RascalSeniorDesign/Preliminary-Design/CMQA/Presentations/Tyler Slides/CubeSat Definitions.key/Data/st0-1.jpg

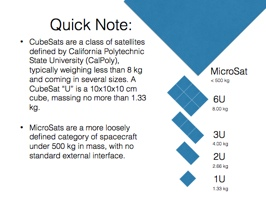
CMQA/Presentations/Tyler Slides/CubeSat Definitions.key/Data/st0-1.jpg
