RascalSeniorDesign/Preliminary-Design/README.md

Preliminary-Design
==================

This repository consists of all documentation related to the Preliminary-Design of the Rascal Spacecraft
