RascalSeniorDesign/Preliminary-Design/CMQA/Presentations/Rascal Senior Design Poster 40x40.pptx

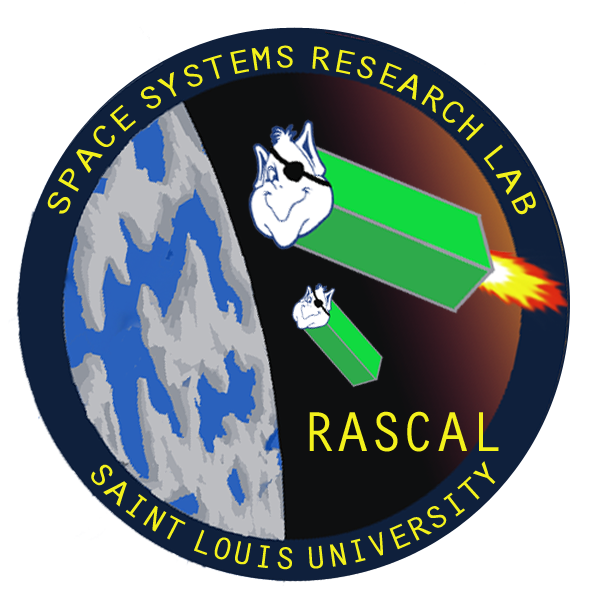
[picture p5: figure]

Rascal
Demonstration of Proximity Operations & Rendezvous in University-Class Spacecraft

Senior Team Members: Jennifer Babb, Bryant Gaume, Tom Moline, Tyler Olson, Nate Richard
Acknowledgements: Michael Swartwout Ph. D., Kyle Mitchell Ph. D.

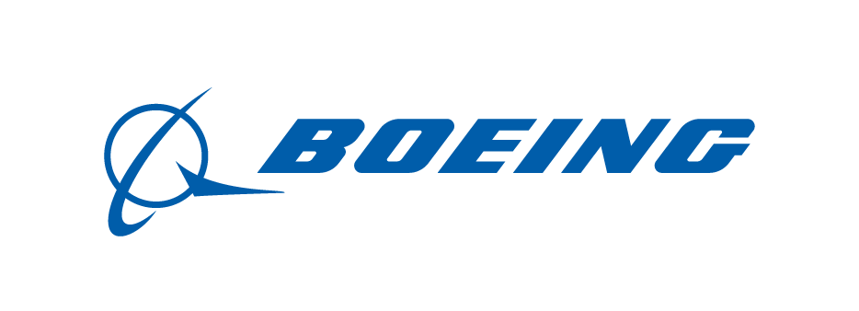
[picture p6: figure]
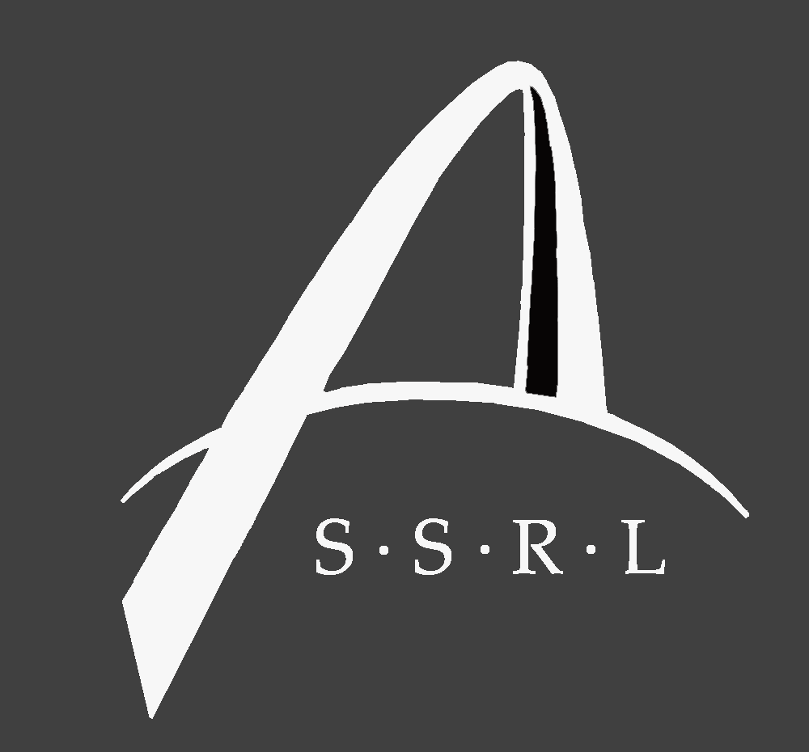
[picture p7: figure]

Demonstrate the performance of Rendezvous and Proximity Operations (RPO) and the inspection of a cooperating Resident Space Object (RSO) within a small spacecraft architecture.

Mission Statement

NASA Strategic Goal 3.3: Develop and demonstrate the critical technologies that will make NASA’s exploration, science, and discovery missions more affordable and more capable.
Useful RPO Mission Data: Provide more insight into the capabilities of small spacecraft in performing RPO missions.

Mission Relevance

5
4
3
2 | | | | 2, 3, 4 | 5
1 | | | | | 1
| 1 | 2 | 3 | 4 | 5

1. Spacecraft unable to separate
2. Collision during inspection stationkeeping
3. Unable to rendezvous during cooperative maneuvers
4. Unable to rendezvous during non-cooperative maneuvers
5. Collision during rendezvous

Mission Risks

Mission Definitions

Inspection: resolving individual components on the external surface of a resident space object.
Inspection Stationkeeping: maintaining a constant distance (<10 m) relative to a resident space object.
Remote Stationkeeping: maintaining a constant distance (>100 m) relative to a resident space object.
Rendezvous: decreasing the relative distance to a resident space object.

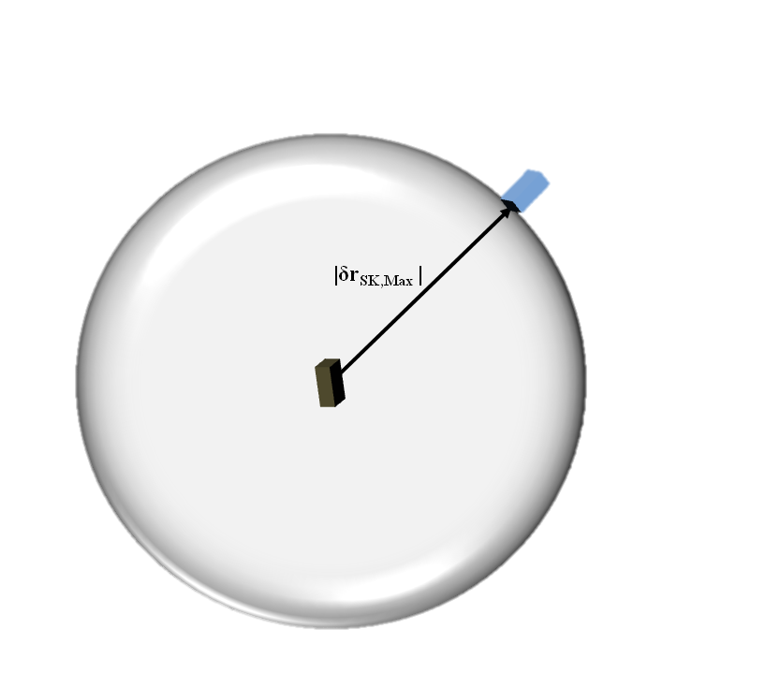
[picture p8: figure]
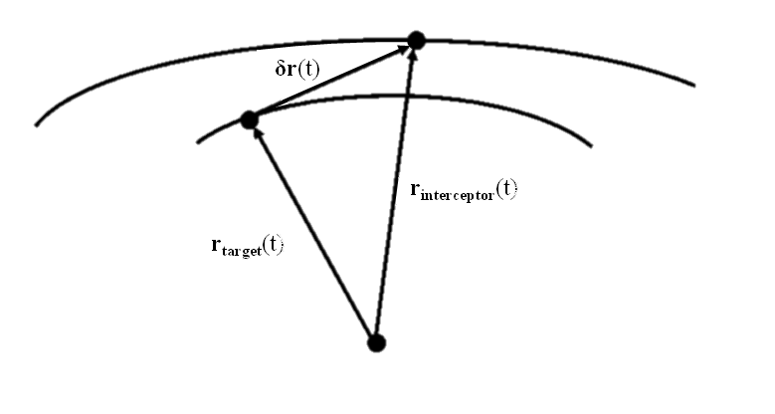
[picture p9: figure]

Functional Block Diagram

Primary Spacecraft

PLD

Flash Memory

CDH

PRP

Firing Circuit

SEP

Power Pass

Secondary Spacecraft

PWR

Regulators

CDH

Microcontroller

COM

RFID Chip

SEP

Solenoid

Primary Attachment

Patch Rx Antenna

Batteries

Primary Aids

Contact Switch

ADC

Nutation Dampening

Imager

Thruster Block

SSRL Ground Station

Secondary Attachment

Boeing

Concept of Operations

LV Separation and Checkout

Launch

Orient for Separation

Separation

Stationkeep at maximum relative distance

Inspection Distance Checkout

Move to maximum relative separation

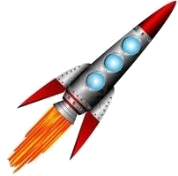
[picture p10: figure]
images
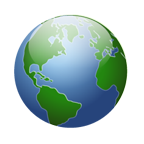
[picture p11: figure]
MC900432569[1]

Extended Ops and Deorbit

Repeat mission without visual aids

Inspection

Rendezvous

Developed in Partnership with the Boeing Company’s Advanced Space & Intelligence Systems Organization

Mission Information

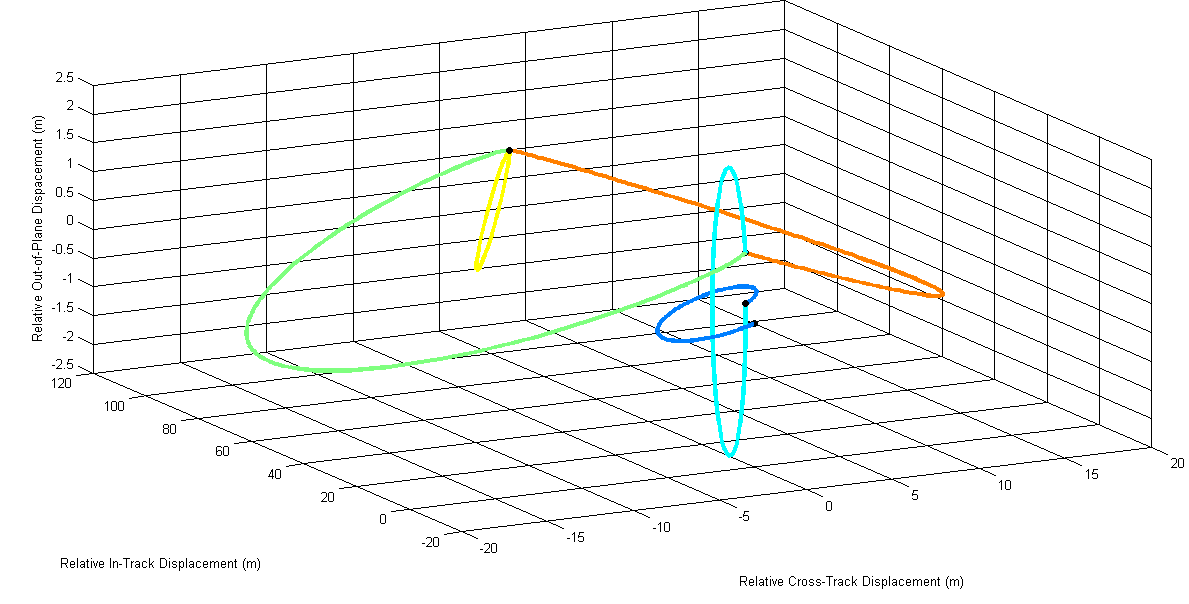
[picture p12: figure]

Architecture: Two, 3U (10 x 10 x 30cm) CubeSats (One Primary, One Secondary)
Mission Lifetime: Two Weeks for Secondary Spacecraft, 6 Months for Primary Spacecraft.
Propulsion: Cold-gas, 50 m/s of ∆V.
Imaging: 30 fps, 640x480 pixel, visual spectrum camera.
Controls: Defined through linear orbit theory and CW coordinate frame
