RascalSeniorDesign/Preliminary-Design/CMQA/Mission Overview/Structures Subsystem.docx

Structures Subsystem:

The structure subsystem is responsible for containing the spacecraft and providing support and protection to the components as to prevent damage during use. The subsystem consists of the exoskeleton, screws, nuts, bolts, clips, rods, and any object necessary for securing the spacecraft.

The exoskeleton is the backbone of the spacecraft and can be made of, and is in the shape of whatever is necessary to support the components of the spacecraft. There is however, a requirement of the launch provider that it fits in the deplorer and the spacecraft is no more than 12kg or 14kg depending on said deplorer. It is because of this that it is nominally standard to select the CubeSat shaped exoskeleton as defined by the CubeSat standard. The standard CubeSat can be purchased from numerous commercial vendors. The material however can still be put into question. The nominal material from commercial vendors is Aluminum 6061-T6, which under nominal circumstances is appropriate. However, other materials are being explored. Applicable materials are stated by NASA launch requirements.

The nuts, bolts, and assembly components are nominally stainless steel, as it is lightweight and sturdy. Zinc which is also common in nuts and bolts must not be used as stated by NASA material requirements.
