RascalSeniorDesign/Preliminary-Design/CMQA/Mission Overview/Subsyestem overveiw.docx

Subsystem Overview:

A complicated spacecraft requires teams and organization to succeed. The teams can be broken down into subsystems such as: Structure (STR), Power (PWR), Attitude Determination and Control (ADC), Propulsion (PRP), Communication (COM), Command and Data Handling (CDH), and Ground Operation (GOP). Each of these teams breaks down the components of the spacecraft to make the system simpler and easier to handle. These teams lead to the success of the space craft and definitions of each category are as follows.
