RascalSeniorDesign/Preliminary-Design/Power (PWR)/Rascal PWR Block Diagram.pptx

PWR

Regulator

Contact Switch

Batteries

9-C Parallel 3.5 Volt Lithium Batteries

9-C Parallel 3.5 Volt Lithium Batteries

9-C Parallel 3.5 Volt Lithium Batteries

3.3 V

Vin

3.3 Volts

GND

Vout

GND

## Slide 2

Secondary Spacecraft

SEP

Primary Spacecraft

SEP

SEP Verification Switch

Primary Electrical
Contact

Secondary Electrical
Contact

5 V

GND

Spring

Spring Contact

Solenoid Attachment

CDH

μController

Solenoid

Solenoid

Solenoid Attachment

Spring Contact

Spring

Colony-II

Separation Command

Ground Station

## Slide 3

Rascal

Secondary Spacecraft

Primary Payload

Payload CDH Peripheral Interface Controller (PIC) Bus

Colony-II

Colony-II CDH PIC Bus

Separation Port

Power Transfer Port

Image Processor

SD Card

Propulsion Firing Circuit

RF Communication

Power

Attitude Determination and Control
