RascalSeniorDesign/Preliminary-Design/Presentations/Tyler Slides/RASCAL diagrams.pptx

Configuration 1:
6 Body mounted panels
5.1 W*hr/orbit

Configuration 2:
6 Body mounted panels,
4 deployable panels
10.2 W*hr/orbit

## Slide 2

Configuration 3:
6 Body mounted panels,
2 deployable panels
17.2 W*hr/orbit

## Slide 3

Configuration 4:
1 Body mounted panel,
5 deployable panels
30.6 W*hr/orbit

## Slide 4

COM Board

Secondary Propulsion Unit

Camera Payload/Image Processing

CDH Motherboard
