RascalSeniorDesign/Preliminary-Design/Structure (STR)/CAD Models/Rendered Files/Exploded View Annotated.pptx

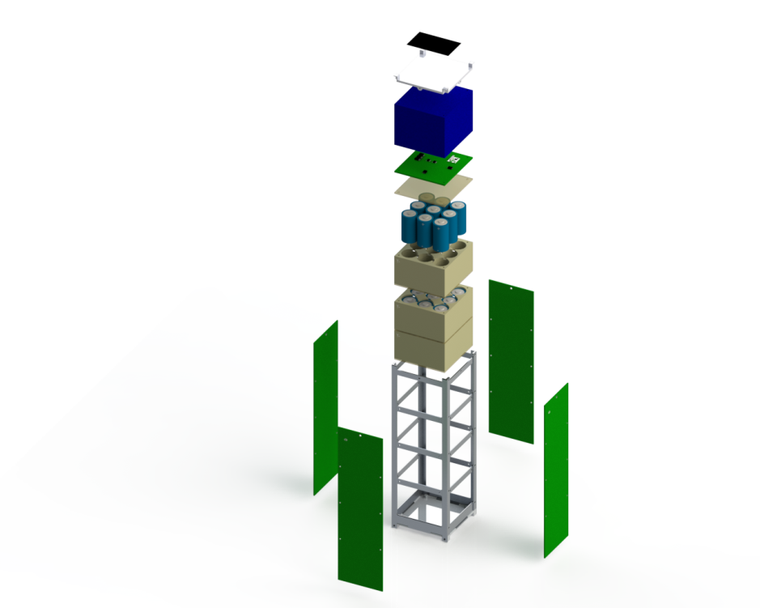
[picture p61: figure]

UHF Patch Antenna

Skeleton Top Plate

ADC System Allocation

Central Processing Board (8-Pin PIC µProcessor, 3.3V Regulator, RFID Chip)

C-Cell Non-Rechargeable Lithium Batteries

Battery Pack

External LED Panels
