RascalSeniorDesign/Preliminary-Design/Attitude Determination and Control (ADC)/Delta-V Budgets/Prox Ops Definition Illustrations/Prox Ops Definition Illustration PP.pptx

|δrSK,Max |

## Slide 2

X
“Out of Track”

Y
“In Track”

Z
“Out of Plane

## Slide 3

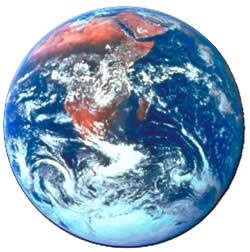
[picture p62: figure]

Z
“Out-of-Plane”

rinertial

Y
“In-Track”

X
“Cross-Track”

## Slide 4

δr(t)

F

rtarget(t)

rinterceptor(t)
