RascalSeniorDesign/Preliminary-Design/CMQA/Presentations/Jennifer Slides/Jennifer Slides.pptx

## RCL.PL.STR7

RVM Requirement Number | STR7
RVM Requirement Wording | “The CubeSat System Shall Incorporate a Deployment Switch”
Validation Method | Examine

Because power going to the CubeSat could interfere with the launch vehicle and primary payload, there must be a deployment switch to turn off CubeSat power during launch.

## RCL.PL.STR8

RVM Requirement Number | STR8
RVM Requirement Wording | “No Protrusion Shall Extend beyond 6.5 mm Normal to Any External Surface of Jade or Turquoise”
Validation Method | Examine

The requirement that there be no extension beyond 6.5 mm normal to any surface of the 100 mm CubeSat helps to protect the launch vehicle.

## RCL.PL.STR9

RVM Requirement Number | STR9
RVM Requirement Wording | “No External Components Other than the CubeSat Rails of Jade and Turquoise may make Contact with the Deployer”
Validation Method | Examine

Due to positioning the CubeSats within the P-POD, and the need for a smooth exit from the launch vehicle, no component may extend any further than 6.5 mm normal to any surface of the 100 mm cube.

## RCL.PL.STR10

RVM Requirement Number | STR10
RVM Requirement Wording | “The Deployer Shall not be Used to Secure Any CubeSat Deployables”
Validation Method | Demo

This requirement is designed to help ensure the safety and integrity of the individual CubeSats.

## RCL.PL.STR11

RVM Requirement Number | STR11
RVM Requirement Wording | “The Center of Gravity of the total CubeSat System Shall be Located within a Sphere of 2 cm of the Geometric Center of the System”
Validation Method | Analyze

The positioning of the center of gravity close to the geometric center for the easier manipulation of the cube from any point.

## RCL.PL.STR12

RVM Requirement Number | STR12
RVM Requirement Wording | “The Center of Gravity of Jade and Turquoise Shall be Located within a Sphere of 2 cm of their Geometric Center”
Validation Method | Analyze

Jade is sub satellite 1 and Turquoise is sub satellite 2 of Team Bravo’s CubeSat Project and having the centers of gravity of each of the cubes close to their geometric centers makes for more coordinated movements.

## RCL.PL.STR13

RVM Requirement Number | STR13
RVM Requirement Wording | “The CubeSat System Coordinate System Shall be Defined As Specified in Figure 1-1”
Validation Method | Examine

Defined orientations are crucial in any space mission. Knowing that the z surface is inserted into the P-POD first, that the railings are along the y face, and the deployment switch is on the z surface leaves no ambiguity.


## RCL.PL.STR14

RVM Requirement Number | STR14
RVM Requirement Wording | “The Local Coordinate System of Jade and Turquoise Shall be Defined as Specified in Figure 1-1”
Validation Method | Examine

Knowing the x, y, and z orientation allows for positioning of Jade and Turquoise
