RascalSeniorDesign/Preliminary-Design/Presentations/Final Prestenation/ConOps.pptx

Orient for Separation

Separation

Move to maximum relative separation

LV Separation and Checkout

MC900432569[1]

Inspection Distance Checkout

Stationkeep at maximum relative distance

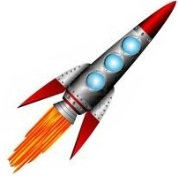
[picture p82: figure]
images

Launch

Extended Ops and Deorbit

Repeat mission without visual aids

Inspection

Rendezvous
