RascalSeniorDesign/Preliminary-Design/CMQA/Mission Configuration Trade Study/RCL-O-CMQA2 Mission Configuration Trade Study Visualization.pptx

## Slide 2

## Slide 3

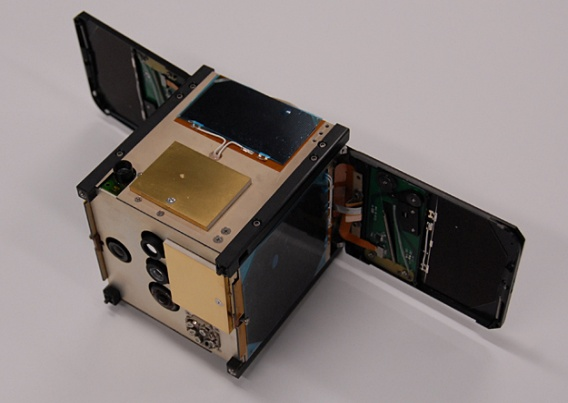
[picture p83: figure]
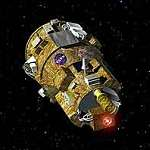
[picture p84: figure]
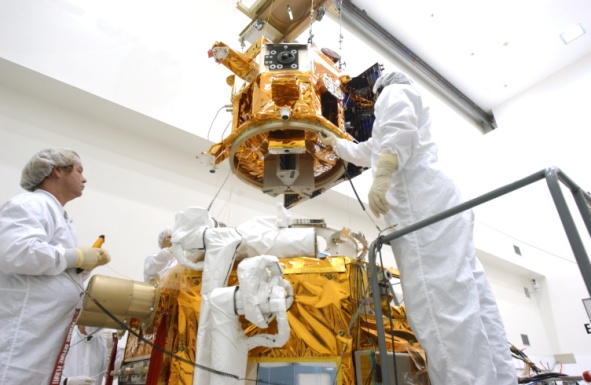
[picture p85: figure]
