RascalSeniorDesign/Preliminary-Design/CMQA/Constraint References/RCl-A-STR1 Satellite Architecture Comparison.xlsx

Launch Name | Launch Date | Number of Satellites | CubeSats | Microsatellties | University CubeSats | University Microsatellites
H-2A-202 | 2010-05-19 | 8 | 3 | 1 | 3 | 0
Dnepr | 2010-06-15 | 4 | 0 | 3 | 0 | 0
PSLV-CA | 2010-07-12 | 5 | 1 | 3 | 1 | 0
CZ-2D | 2010-09-22 | 3 | 2 | 0 | 2 | 0
Minotaur-4 Haps | 2010-11-20 | 10 | 3 | 5 | 1 | 2
Falcon 9 v1.0 | 2010-12-08 | 9 | 8 | 0 | 1 | 0
Taurus-3110 ELaNa I | 2011-03-04 | 4 | 3 | 0 | 3 | 0
PSLV (3) | 2011-04-20 | 3 | 0 | 2 | 0 | 2
Dnepr | 2011-08-17 | 8 | 0 | 7 | 0 | 0
PSLV-CA | 2011-10-12 | 4 | 1 | 2 | 1 | 0
Delta-7920-10C | 2011-10-28 | 7 | 6 | 0 | 6 | 0
Soyuz-STA Fregat | 2011-12-17 | 6 | 0 | 5 | 0 | 0
Vega | 2012-02-13 | 9 | 7 | 1 | 7 | 1
H-2A-202 | 2012-05-17 | 4 | 0 | 2 | 0 | 1
H-2B-304 | 2012-07-21 | 6 | 5 | 0 | 4 | 0
Suyuz-FG Fregat | 2012-07-22 | 5 | 0 | 4 | 0 | 0
PSLV-CA | 2012-09-09 | 3 | 0 | 2 | 0 | 1
Atlas-5(401) | 2012-09-13 | 13 | 11 | 0 | 8 | 0
CZ-2C(3) | 2012-11-18 | 4 | 0 | 3 | 0 | 0
CZ-4C | 2012-11-25 | 3 | 3 | 0 | 0 | 0
PSLV-CA | 2013-02-25 | 7 | 2 | 5 | 2 | 2
Soyuz-2-1a | 2013-04-19 | 7 | 5 | 1 | 4 | 0
Antares-110 | 2013-04-21 | 4 | 4 | 0 | 0 | 0
CZ-2D | 2013-04-26 | 4 | 3 | 0 | 1 | 0
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
