RascalSeniorDesign/Preliminary-Design/Attitude Determination and Control (ADC)/Delta-V Budgets/Delta-V Plots/Ideal CONOPS-1 Orbital Path.tif

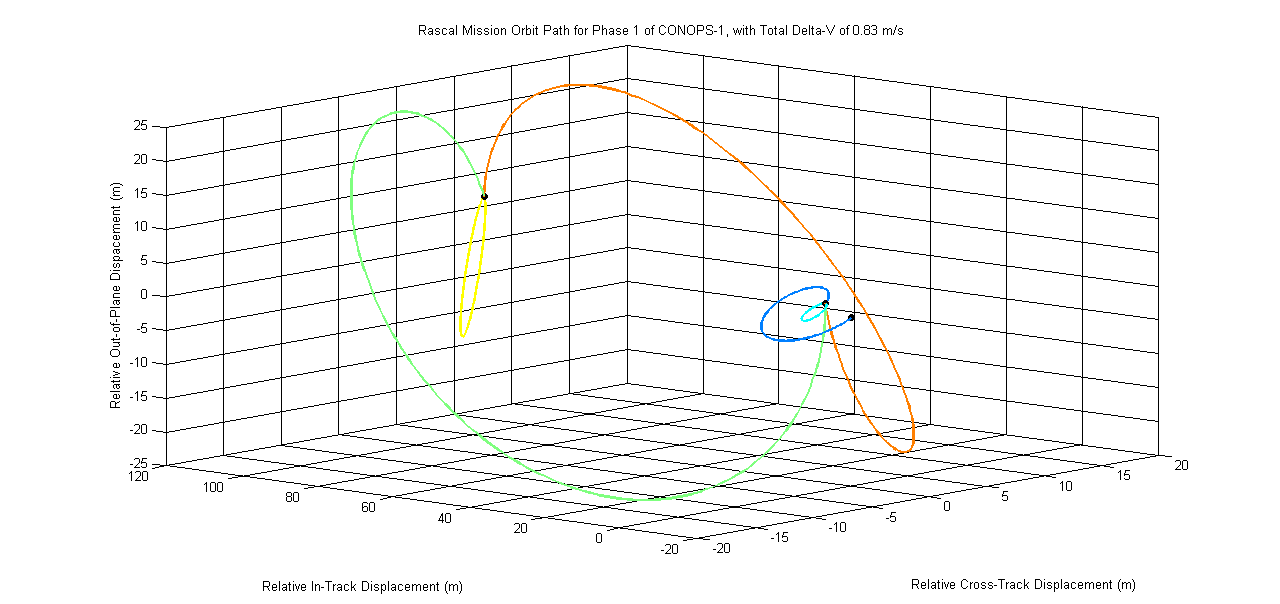
Attitude Determination and Control (ADC)/Delta-V Budgets/Delta-V Plots/Ideal CONOPS-1 Orbital Path.tif
