RascalSeniorDesign/Preliminary-Design/Attitude Determination and Control (ADC)/Delta-V Budgets/Delta-V Plots/Ideal CONOPS-2 All In-Track.tif

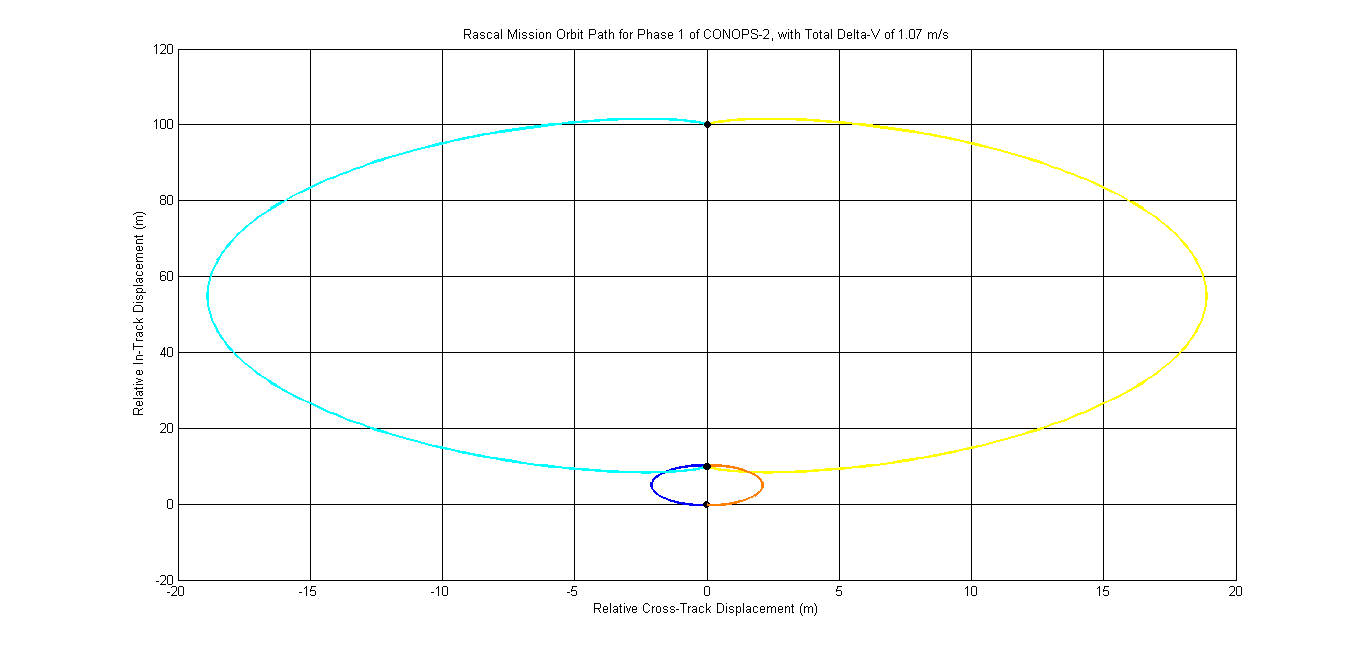
Attitude Determination and Control (ADC)/Delta-V Budgets/Delta-V Plots/Ideal CONOPS-2 All In-Track.tif
