RascalSeniorDesign/Preliminary-Design/Attitude Determination and Control (ADC)/Delta-V Budgets/Delta-V Plots/ISK Velocity Pertubation- All Three Velocities.tif

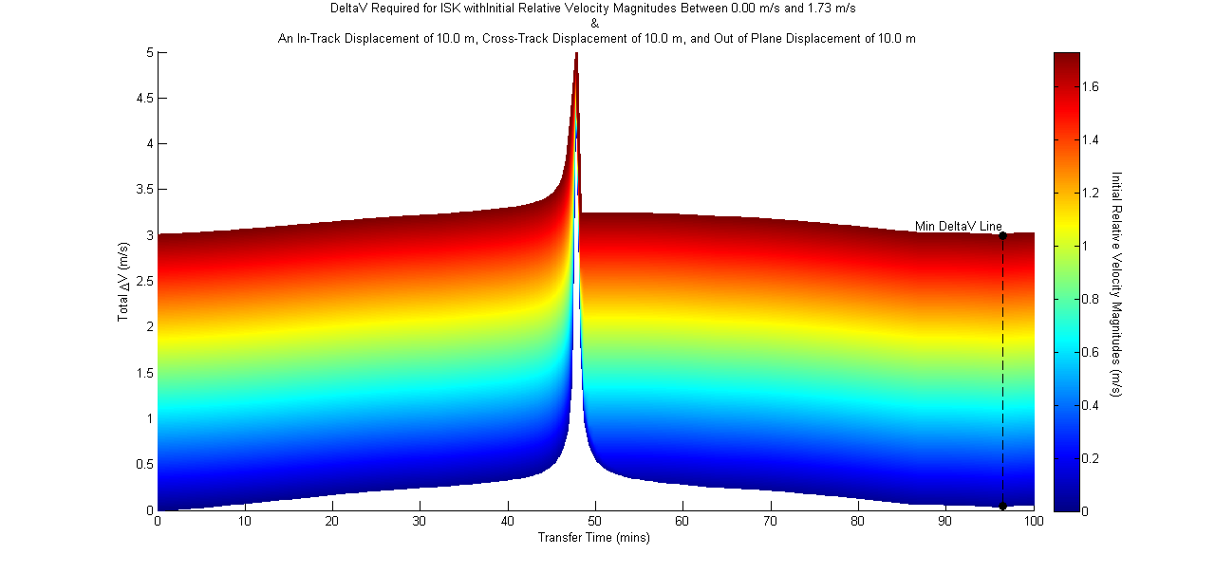
Attitude Determination and Control (ADC)/Delta-V Budgets/Delta-V Plots/ISK Velocity Pertubation- All Three Velocities.tif
