RascalSeniorDesign/Preliminary-Design/Attitude Determination and Control (ADC)/Delta-V Budgets/Delta-V Plots/ISK Velocity Pertubation- In Track and Out of Plane.tif

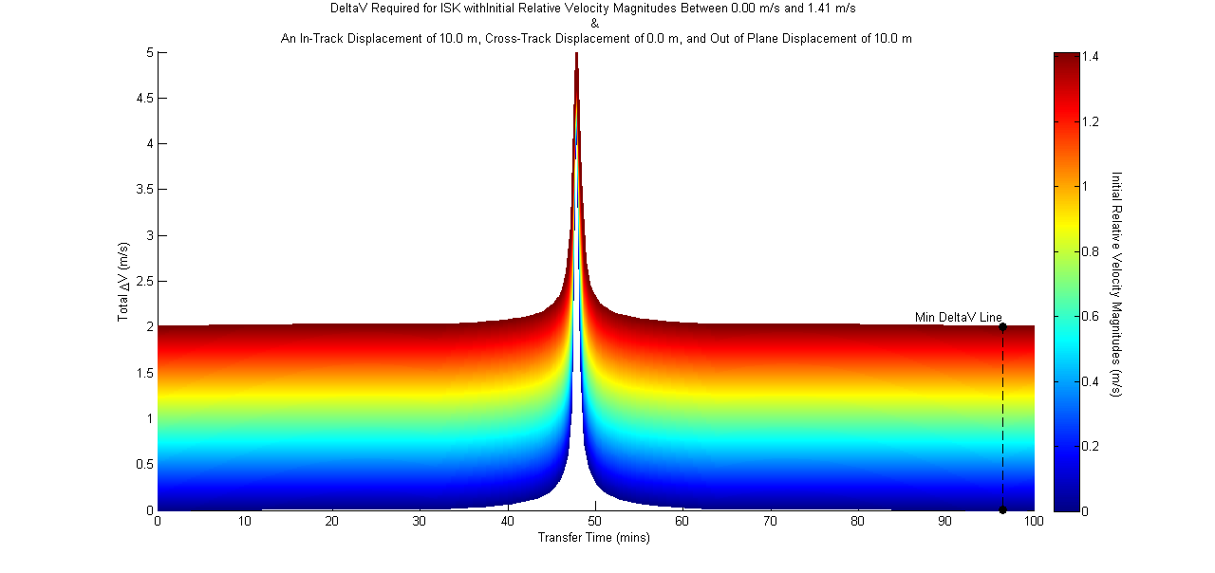
Attitude Determination and Control (ADC)/Delta-V Budgets/Delta-V Plots/ISK Velocity Pertubation- In Track and Out of Plane.tif
