RascalSeniorDesign/Preliminary-Design/Attitude Determination and Control (ADC)/Delta-V Budgets/Delta-V Plots/ISK Velocity Pertubation- Only Cross Track Velocity.tif

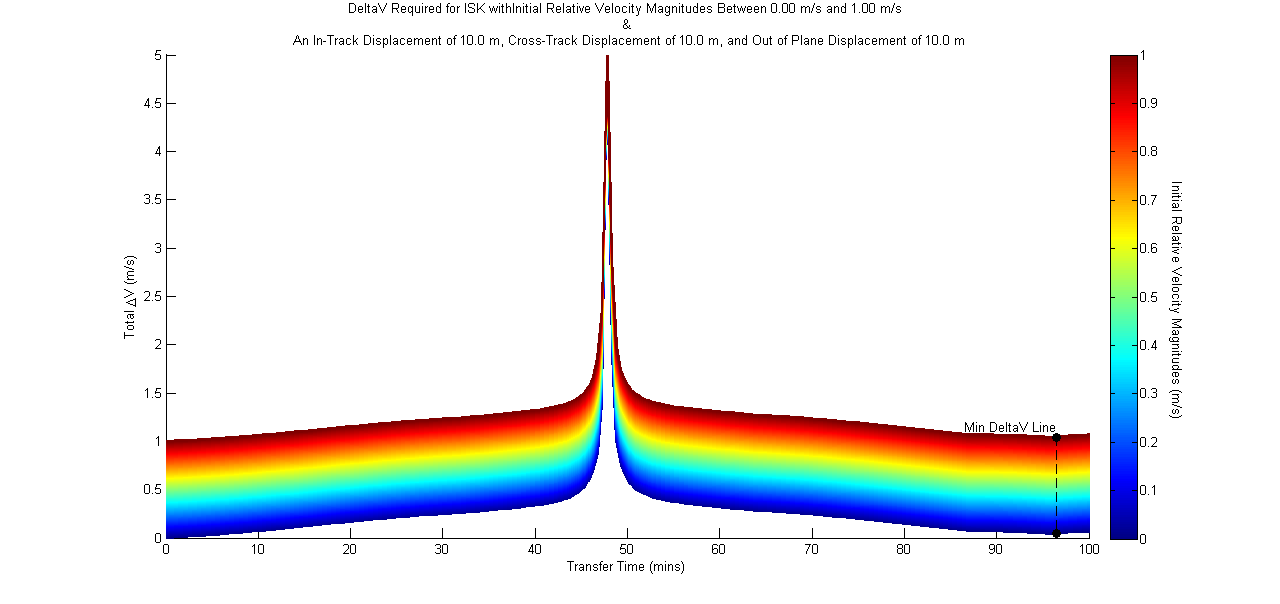
Attitude Determination and Control (ADC)/Delta-V Budgets/Delta-V Plots/ISK Velocity Pertubation- Only Cross Track Velocity.tif
