RascalSeniorDesign/Preliminary-Design/Attitude Determination and Control (ADC)/Delta-V Budgets/Delta-V Plots/Rendezvous from 10 m to 1000 m.tif

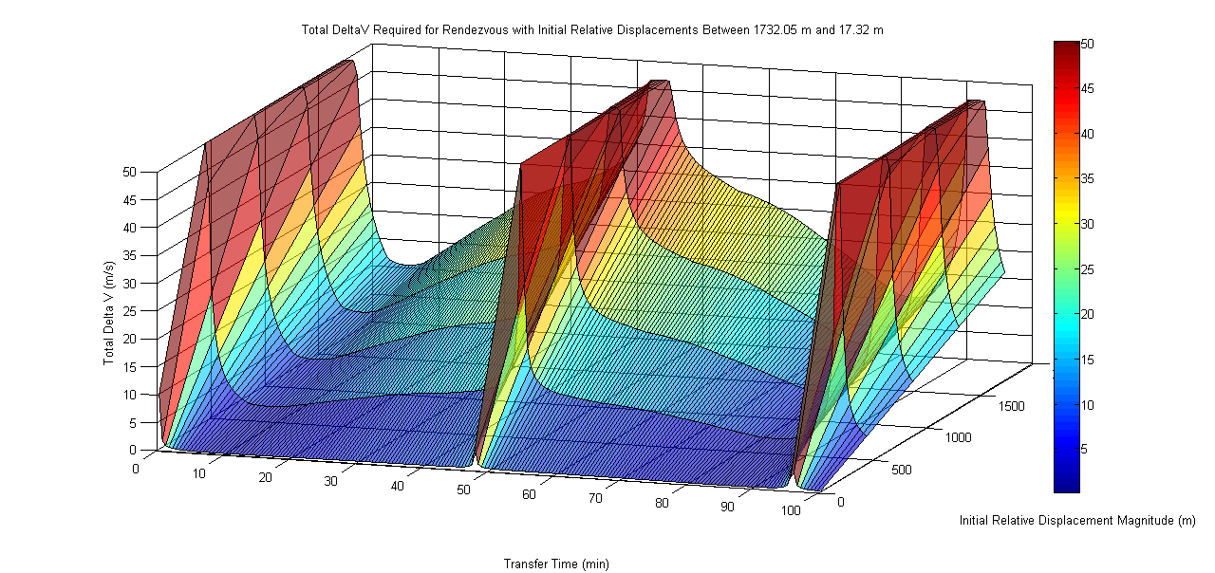
Attitude Determination and Control (ADC)/Delta-V Budgets/Delta-V Plots/Rendezvous from 10 m to 1000 m.tif
