RascalSeniorDesign/Preliminary-Design/Attitude Determination and Control (ADC)/Delta-V Budgets/Delta-V Plots/Separation Between 10 m and 1000 m.tif

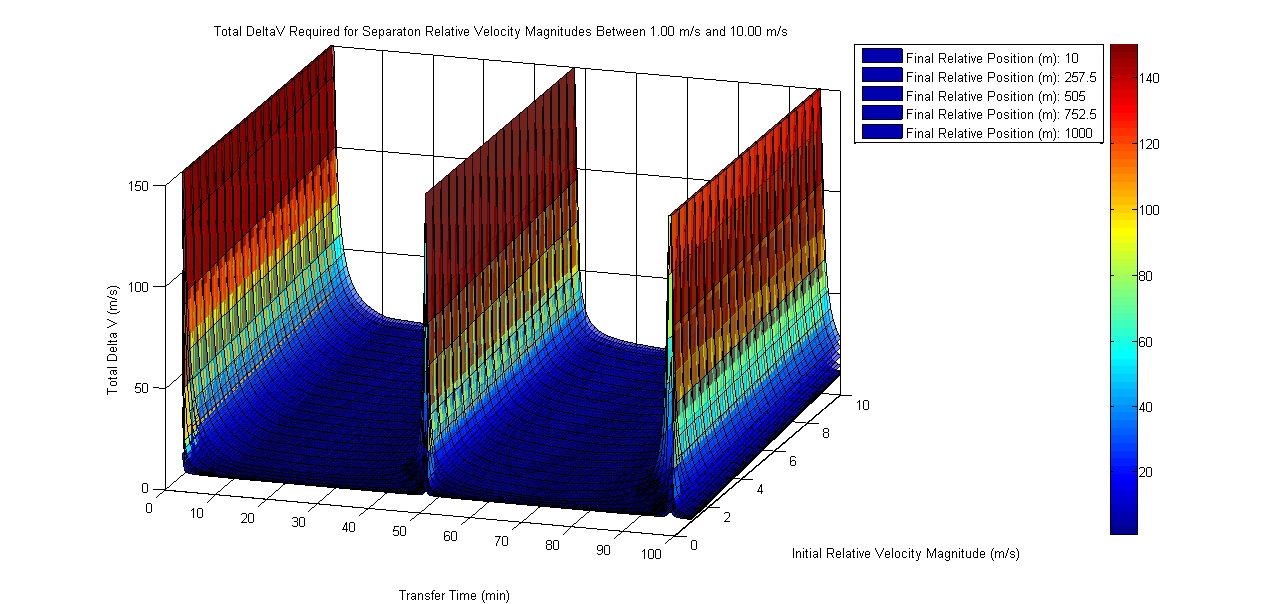
Attitude Determination and Control (ADC)/Delta-V Budgets/Delta-V Plots/Separation Between 10 m and 1000 m.tif
