RascalSeniorDesign/Preliminary-Design/Attitude Determination and Control (ADC)/Delta-V Budgets/Prox Ops Definition Illustrations/CW Coordinate Frame Target Spacecraft.tif

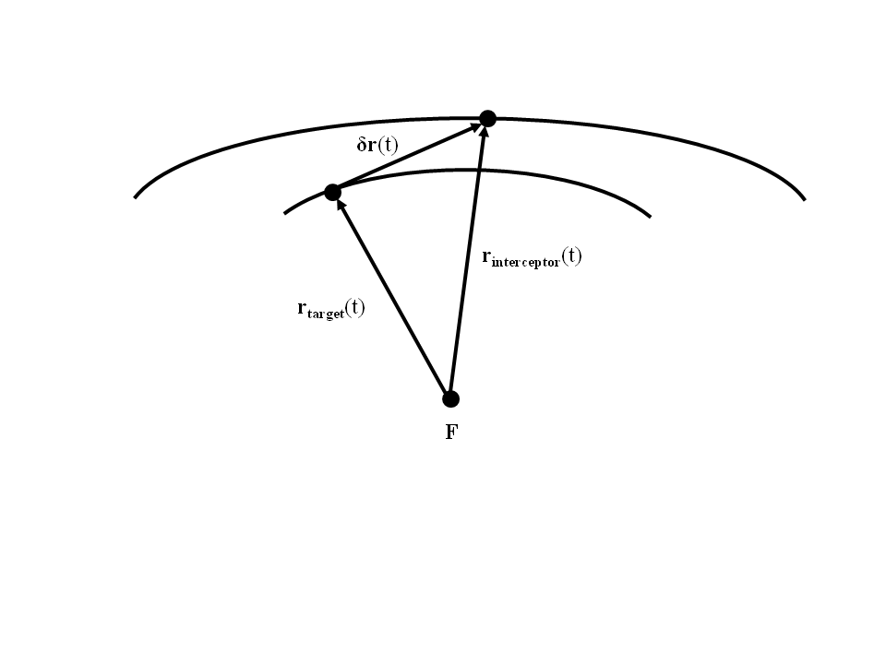
Attitude Determination and Control (ADC)/Delta-V Budgets/Prox Ops Definition Illustrations/CW Coordinate Frame Target Spacecraft.tif
