RascalSeniorDesign/Preliminary-Design/Attitude Determination and Control (ADC)/Delta-V Budgets/Prox Ops Definition Illustrations/CW Coordinate Frame.tif

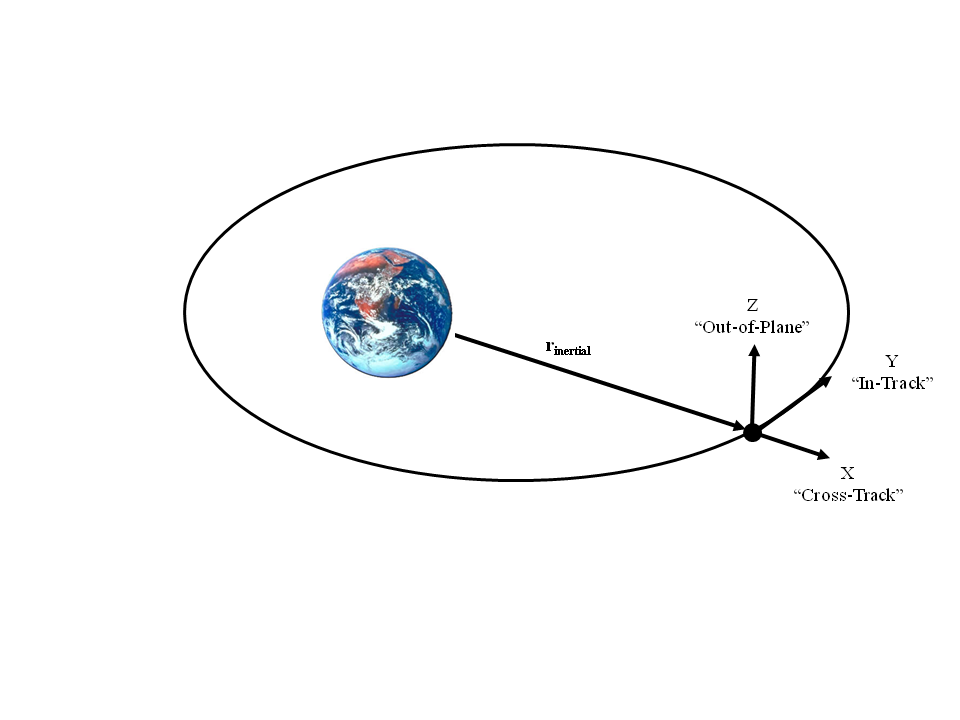
Attitude Determination and Control (ADC)/Delta-V Budgets/Prox Ops Definition Illustrations/CW Coordinate Frame.tif
