RascalSeniorDesign/Preliminary-Design/Attitude Determination and Control (ADC)/Delta-V Budgets/Prox Ops Definition Illustrations/Ideal Mission Path.tif

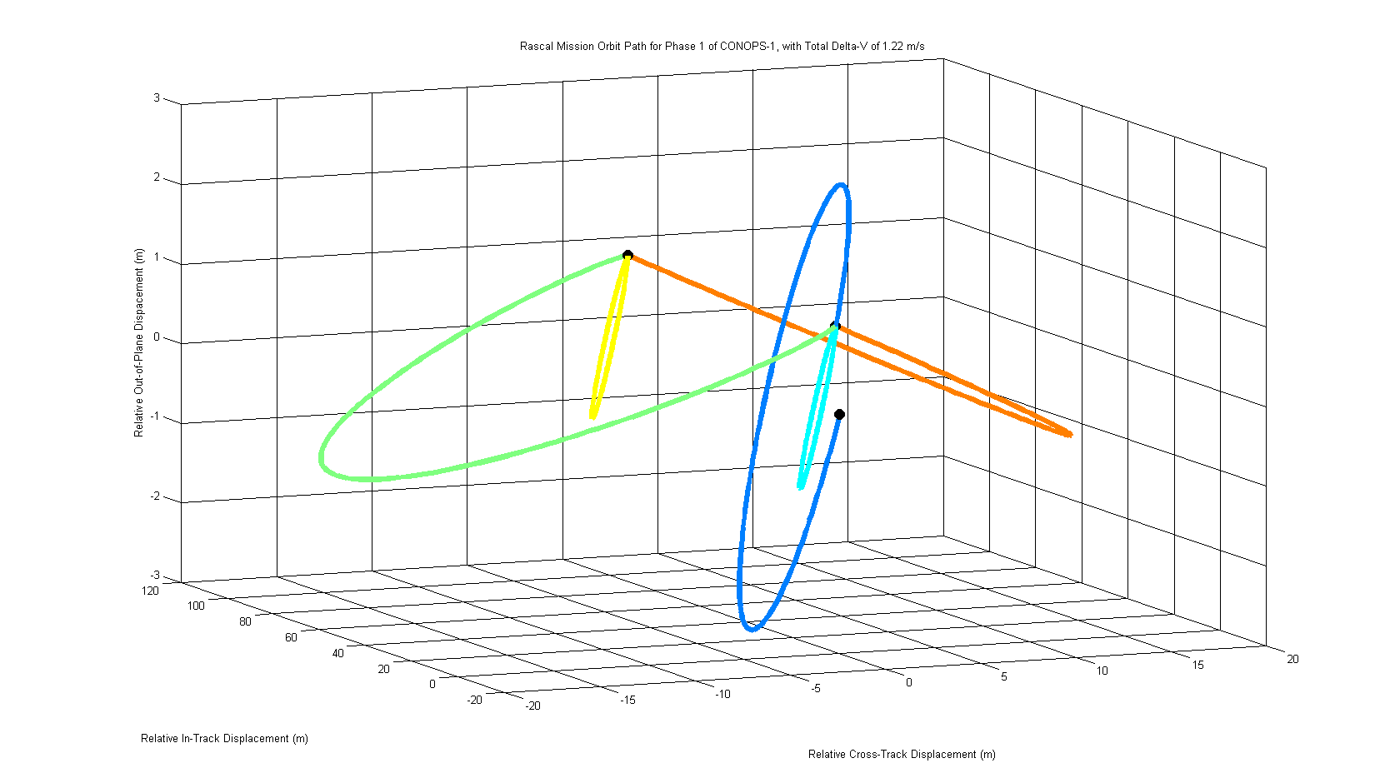
Attitude Determination and Control (ADC)/Delta-V Budgets/Prox Ops Definition Illustrations/Ideal Mission Path.tif
