RascalSeniorDesign/Preliminary-Design/Attitude Determination and Control (ADC)/Delta-V Budgets/Prox Ops Definition Illustrations/Max Separation Distance.tif

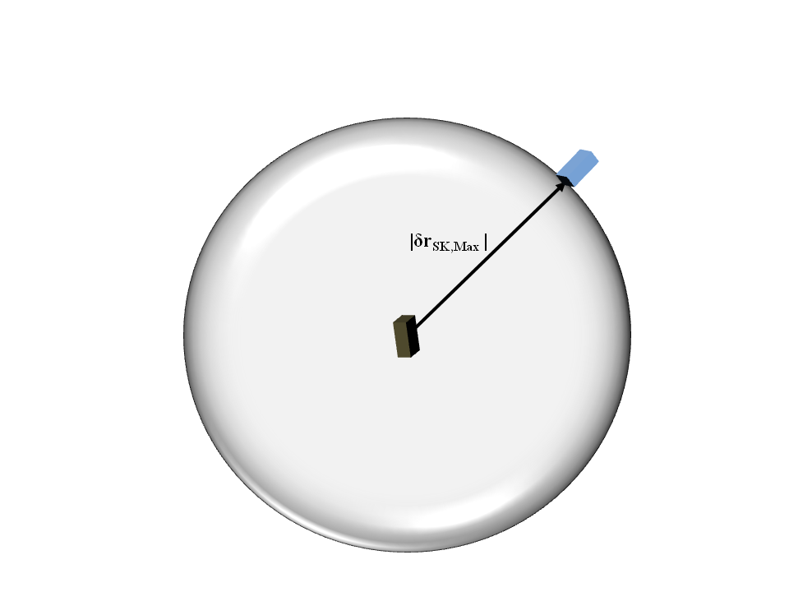
Attitude Determination and Control (ADC)/Delta-V Budgets/Prox Ops Definition Illustrations/Max Separation Distance.tif
