RascalSeniorDesign/Preliminary-Design/Attitude Determination and Control (ADC)/MatLab_Files/DeltaV_vs_PeriodofTravel_300km_Circular.tif

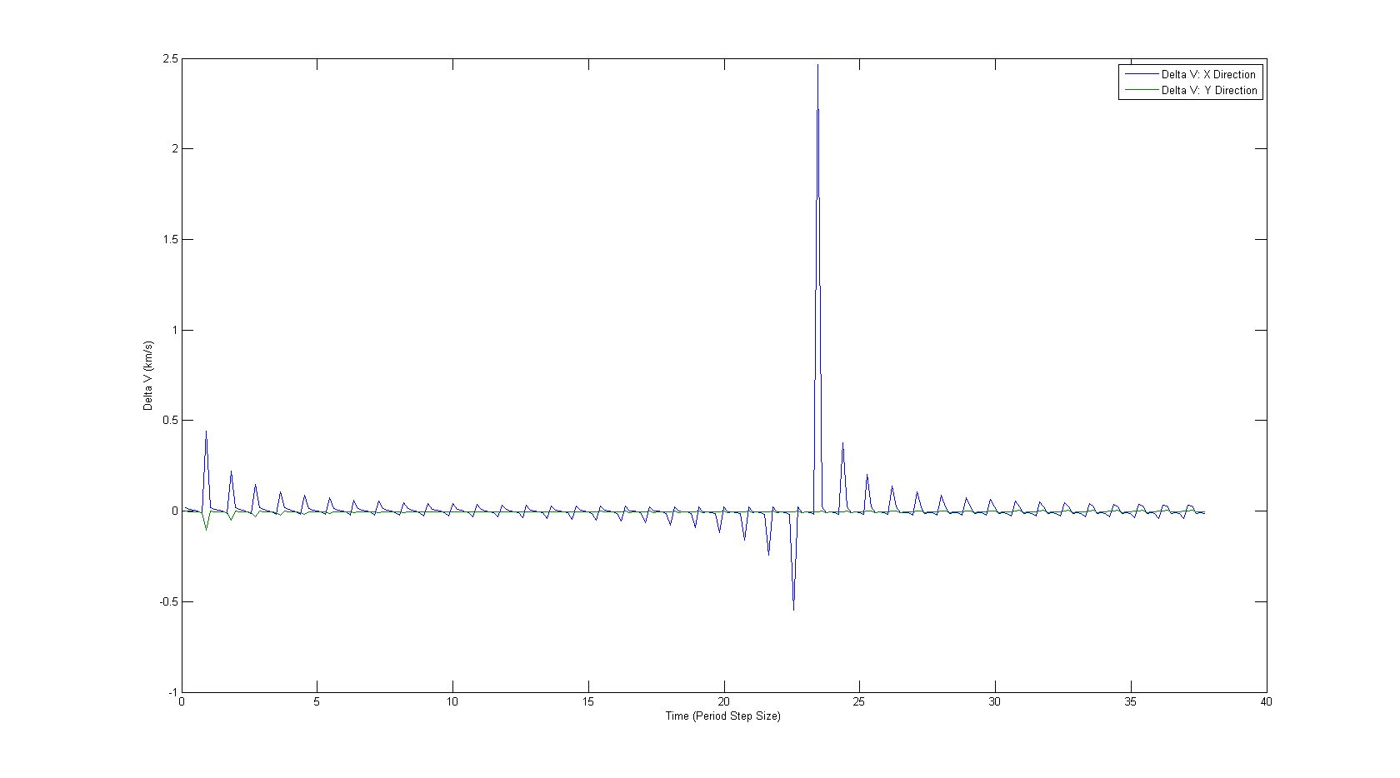
Attitude Determination and Control (ADC)/MatLab_Files/DeltaV_vs_PeriodofTravel_300km_Circular.tif
