RascalSeniorDesign/Preliminary-Design/Attitude Determination and Control (ADC)/MatLab_Files/Mission Overview Plots/Delta V Plots.tif

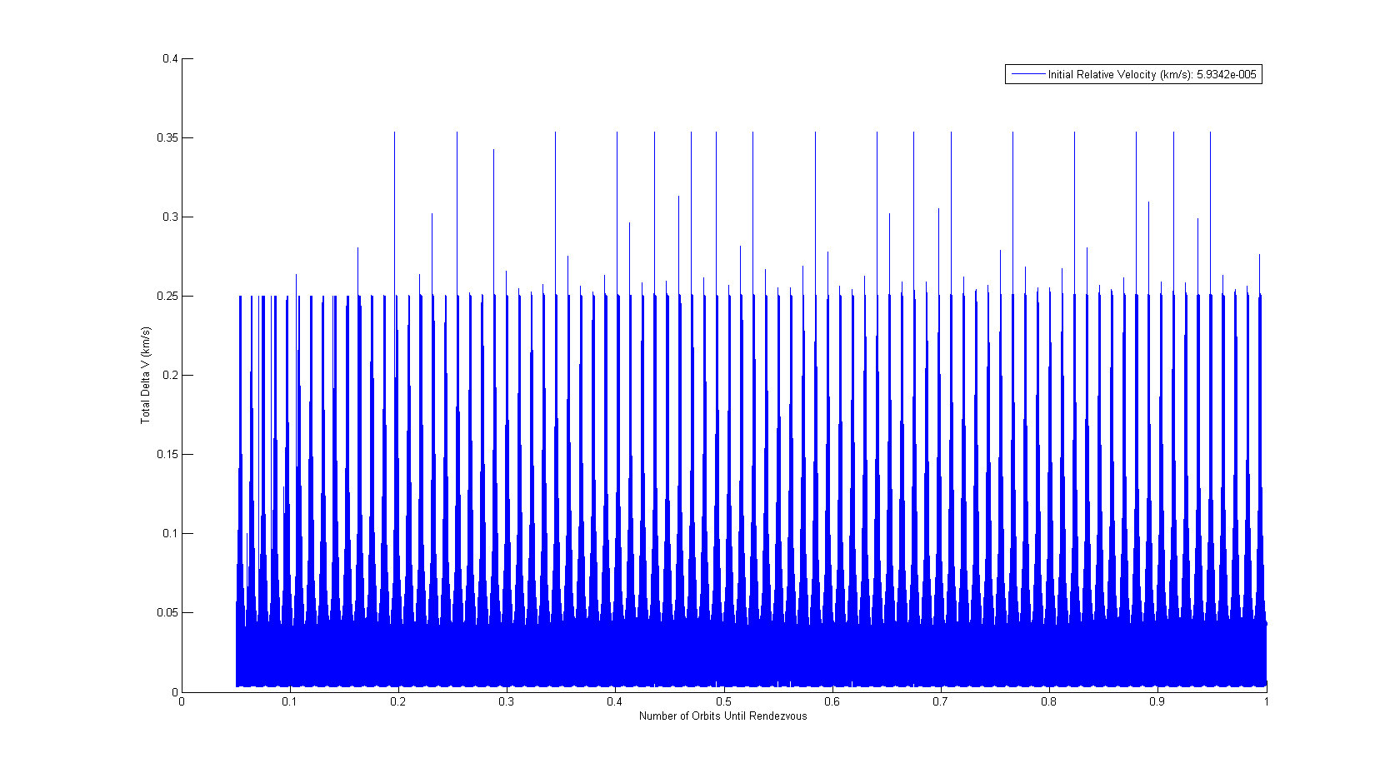
Attitude Determination and Control (ADC)/MatLab_Files/Mission Overview Plots/Delta V Plots.tif
