RascalSeniorDesign/Preliminary-Design/Attitude Determination and Control (ADC)/MatLab_Files/Mission Overview Plots/Relative Displacement for 50 cm-s Initial Separation.tif

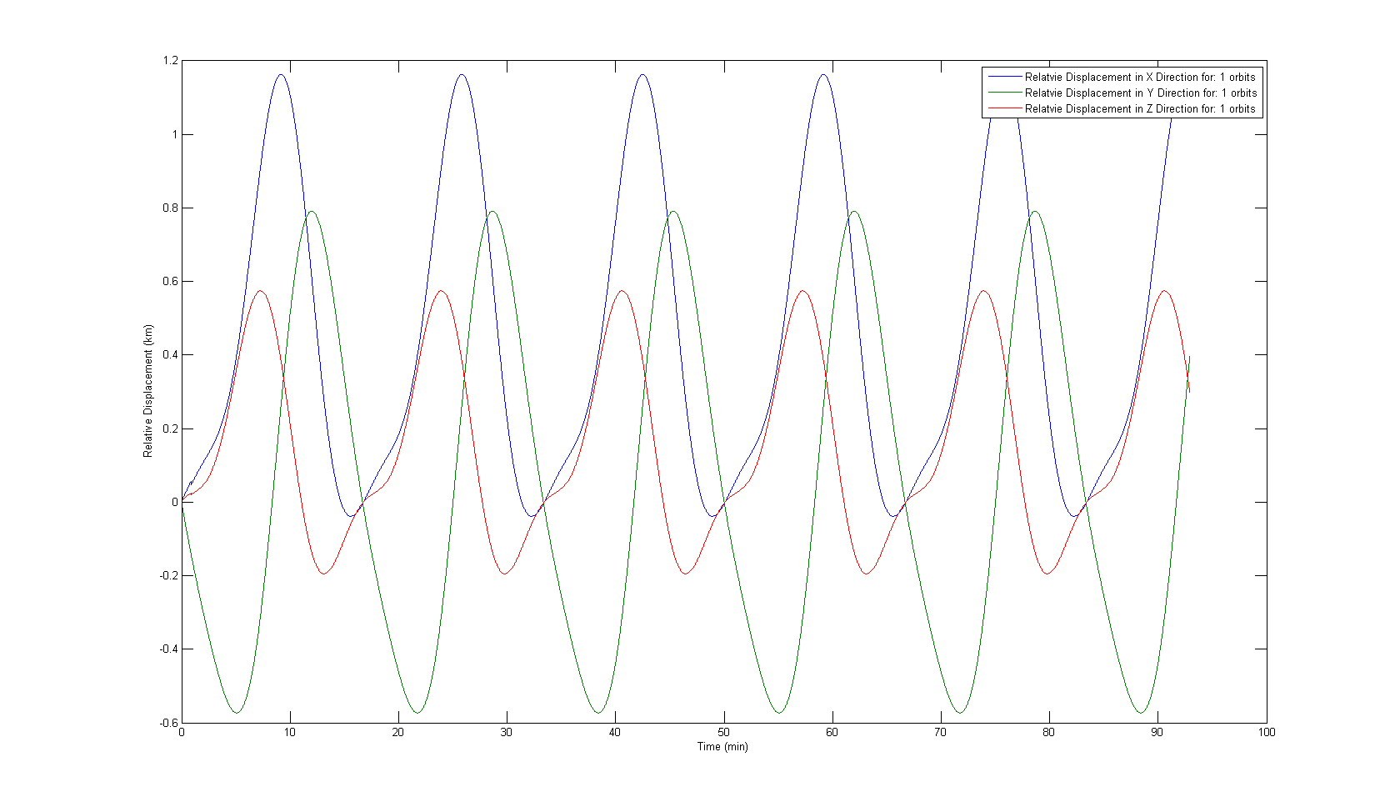
Attitude Determination and Control (ADC)/MatLab_Files/Mission Overview Plots/Relative Displacement for 50 cm-s Initial Separation.tif
