RascalSeniorDesign/Preliminary-Design/Attitude Determination and Control (ADC)/MatLab_Files/Mission Overview Plots/Total Relative Displacement for 50 cm-s Separation.tif

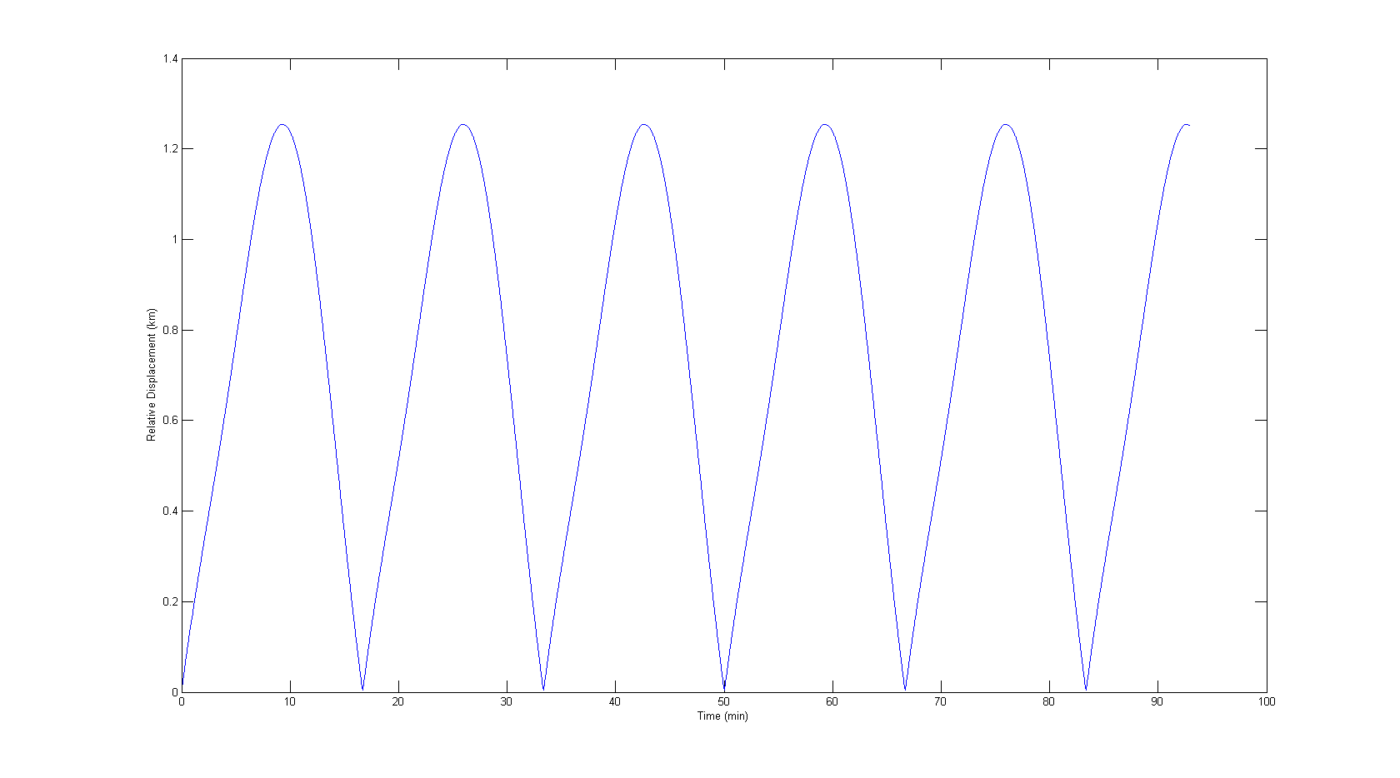
Attitude Determination and Control (ADC)/MatLab_Files/Mission Overview Plots/Total Relative Displacement for 50 cm-s Separation.tif
