RascalSeniorDesign/Preliminary-Design/Attitude Determination and Control (ADC)/MatLab_Files/Plots/YDeltaV_Range_900kmOrbit.tif

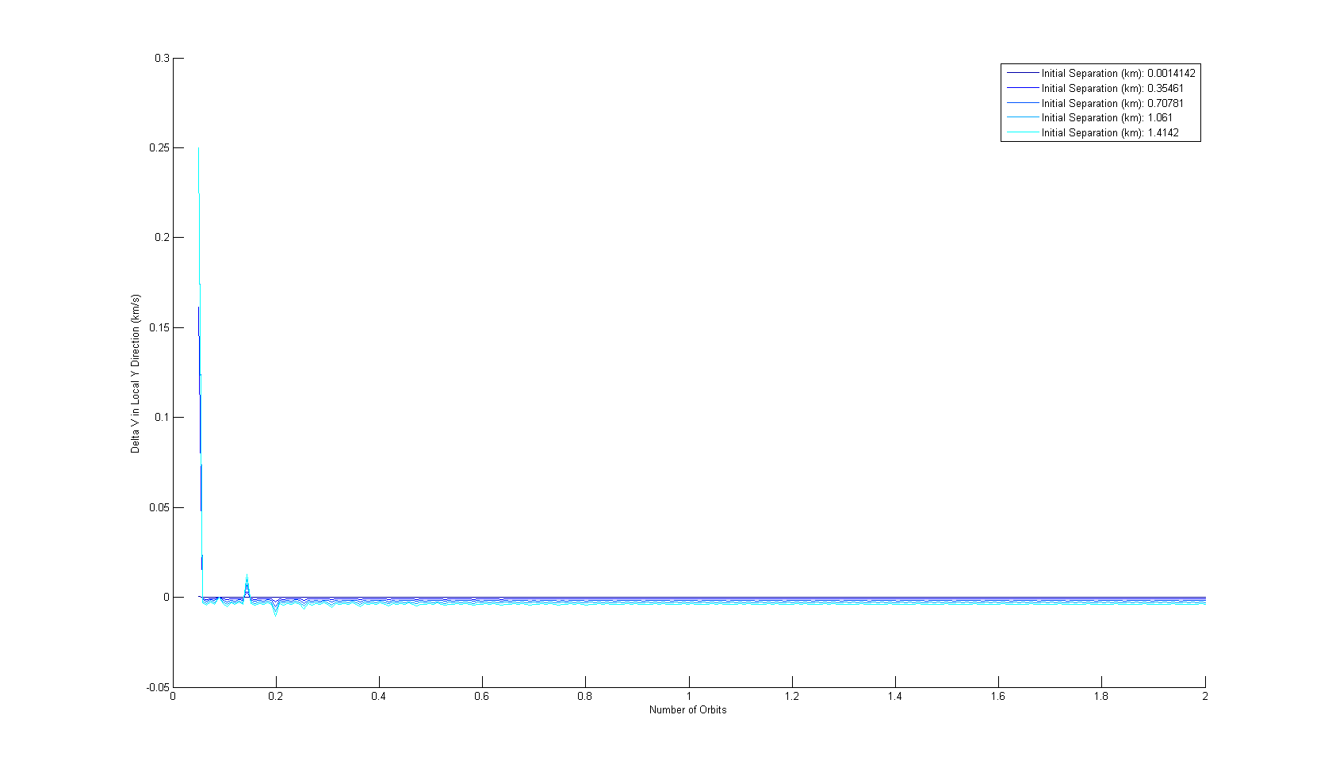
Attitude Determination and Control (ADC)/MatLab_Files/Plots/YDeltaV_Range_900kmOrbit.tif
