RascalSeniorDesign/Preliminary-Design/Attitude Determination and Control (ADC)/MatLab_Files/Relative Position Plots/Magnitude of Relative Displacement 10 cm-s Initial Relative Velocity.tif

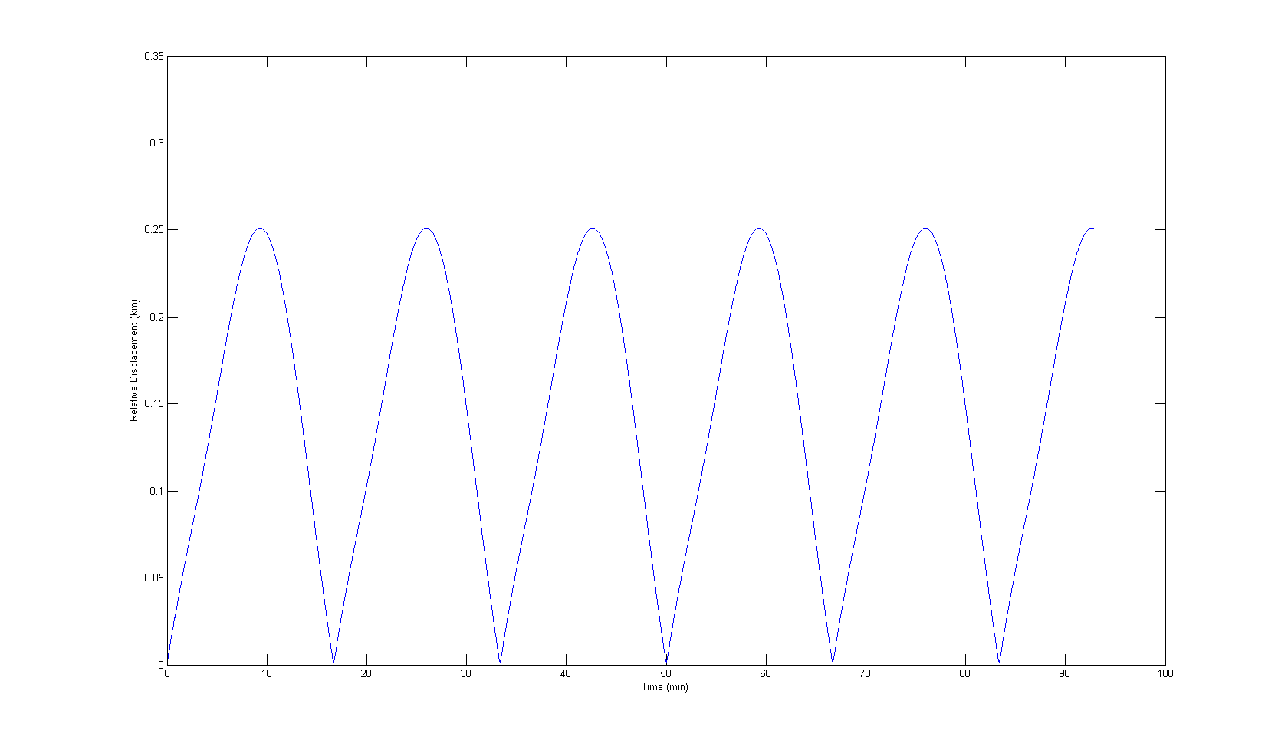
Attitude Determination and Control (ADC)/MatLab_Files/Relative Position Plots/Magnitude of Relative Displacement 10 cm-s Initial Relative Velocity.tif
