RascalSeniorDesign/Preliminary-Design/Attitude Determination and Control (ADC)/MatLab_Files/Relative Position Plots/Relative Displacement 30 cm-s Initial Reltative Velocity.tif

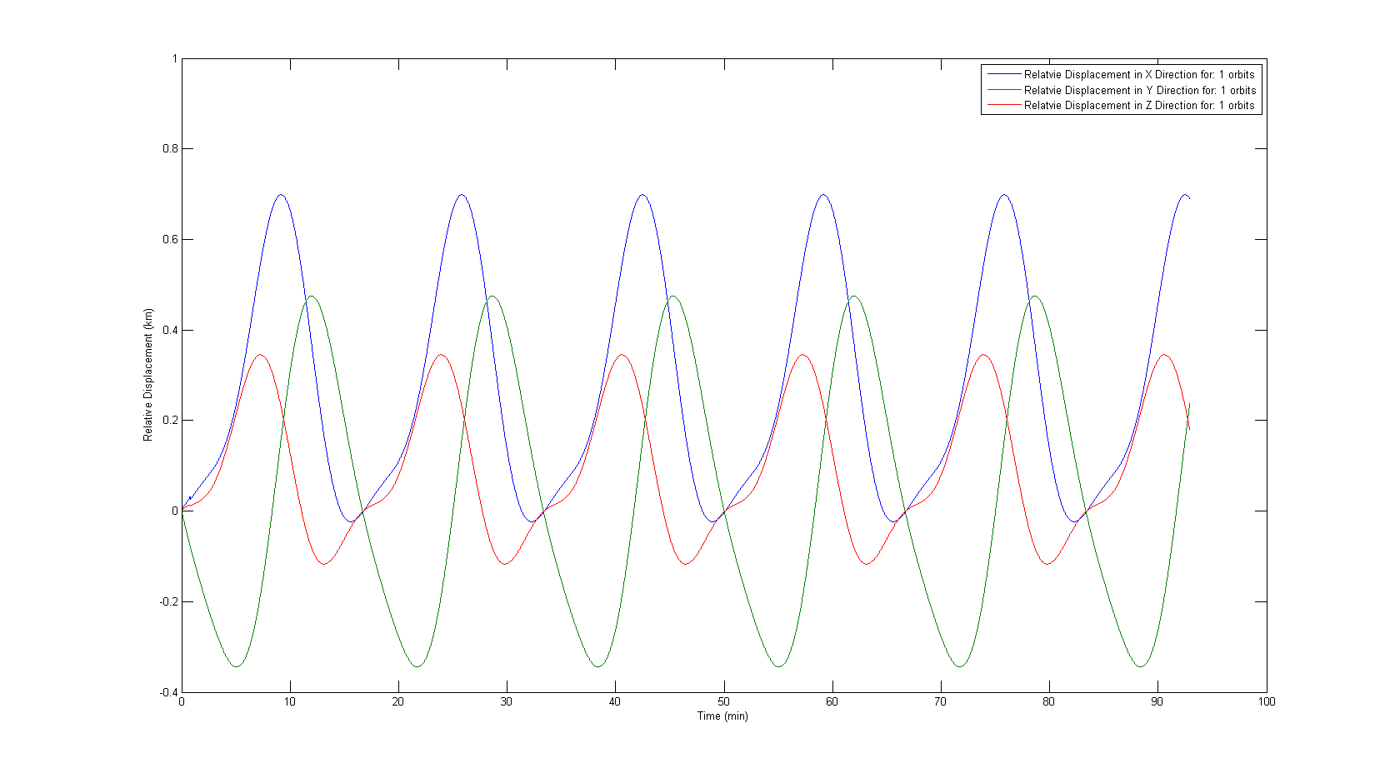
Attitude Determination and Control (ADC)/MatLab_Files/Relative Position Plots/Relative Displacement 30 cm-s Initial Reltative Velocity.tif
