RascalSeniorDesign/Preliminary-Design/Attitude Determination and Control (ADC)/MatLab_Files/Targert Finder Plots/Example Transfer Orbit.tif

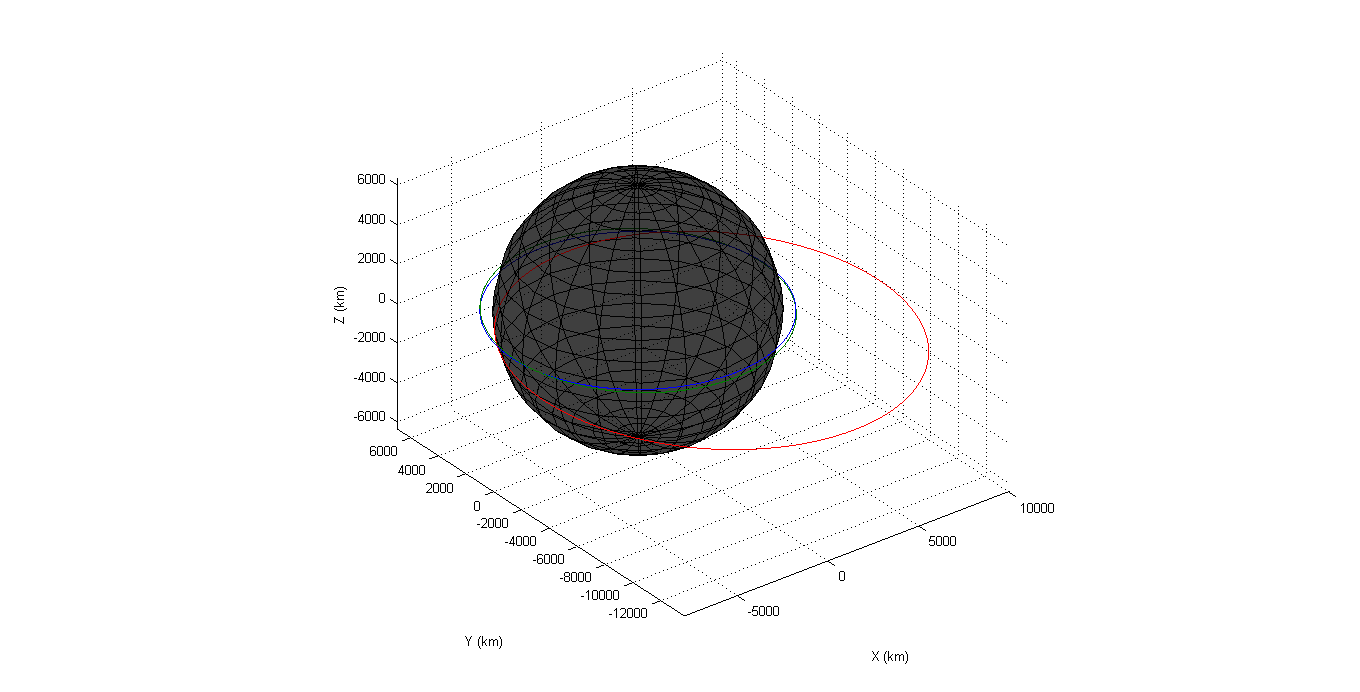
Attitude Determination and Control (ADC)/MatLab_Files/Targert Finder Plots/Example Transfer Orbit.tif
