RascalSeniorDesign/Preliminary-Design/Attitude Determination and Control (ADC)/MatLab_Files/Targert Finder Plots/Optimal Tansfer Times.tif

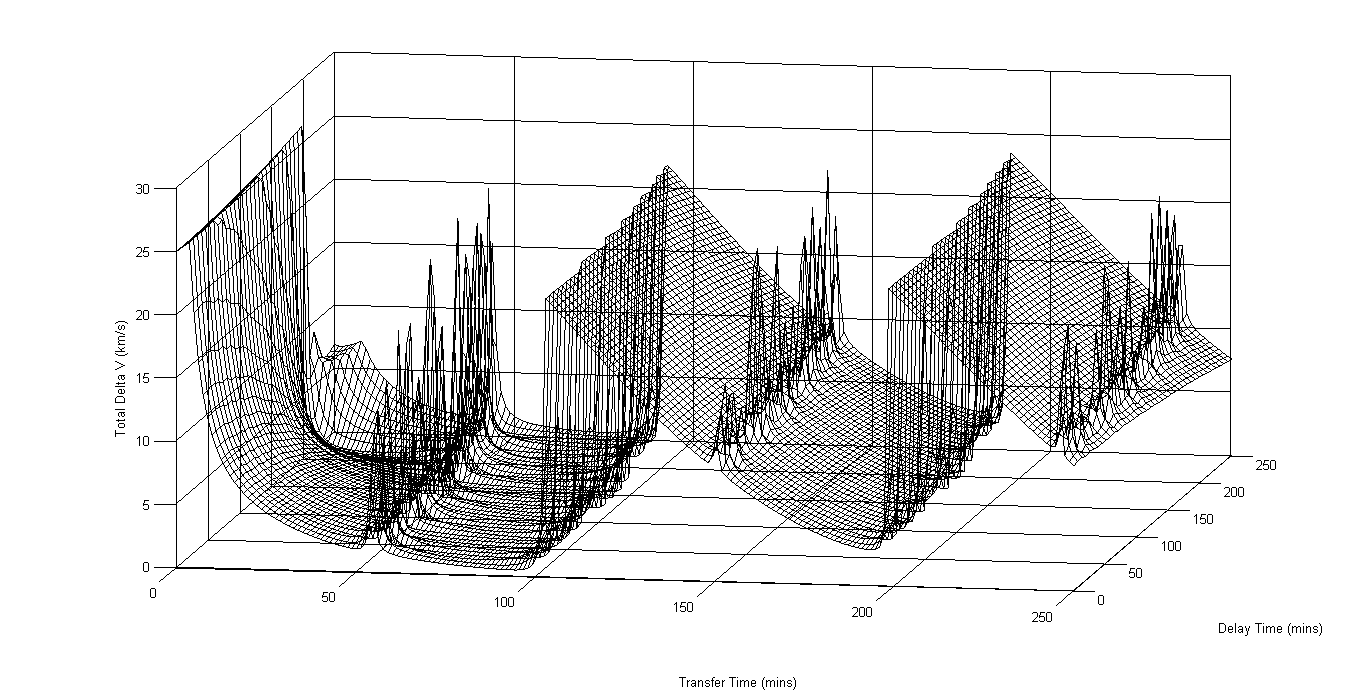
Attitude Determination and Control (ADC)/MatLab_Files/Targert Finder Plots/Optimal Tansfer Times.tif
