RascalSeniorDesign/Preliminary-Design/CMQA/ConOps/CONOPS Cases/CONOPS 2 Summary.pages/preview-web.jpg

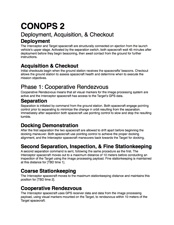
CMQA/ConOps/CONOPS Cases/CONOPS 2 Summary.pages/preview-web.jpg
