RascalSeniorDesign/Preliminary-Design/CMQA/ConOps/CONOPS Cases/Rascal ConOps NO Docking.tif

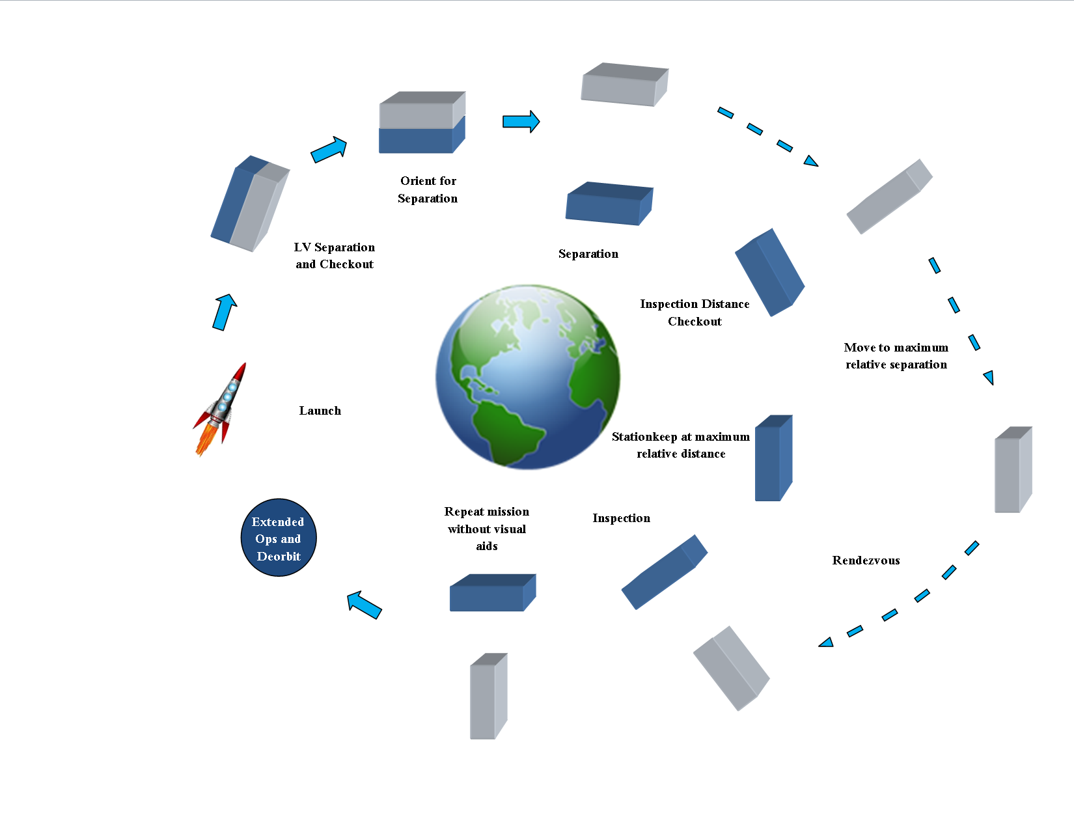
CMQA/ConOps/CONOPS Cases/Rascal ConOps NO Docking.tif
