RascalSeniorDesign/Preliminary-Design/CMQA/ConOps/Rascal ConOps active-active.tif

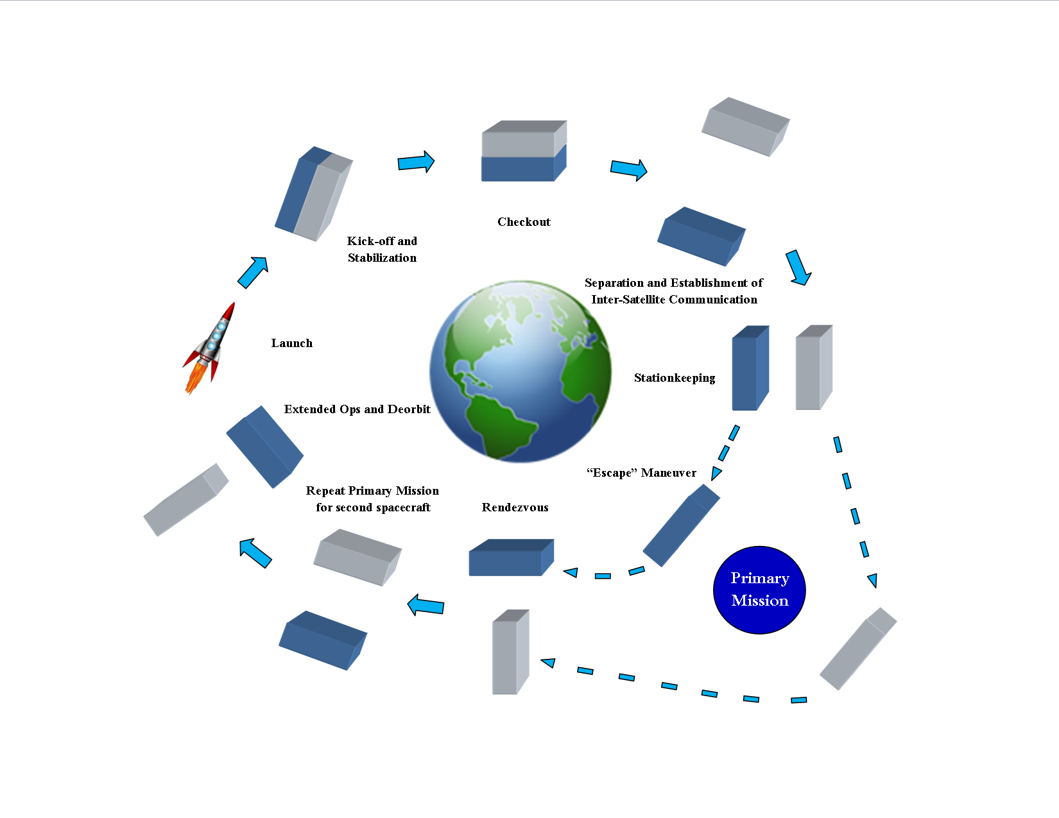
CMQA/ConOps/Rascal ConOps active-active.tif
