RascalSeniorDesign/Preliminary-Design/CMQA/ICD's/Device Diagram.tif

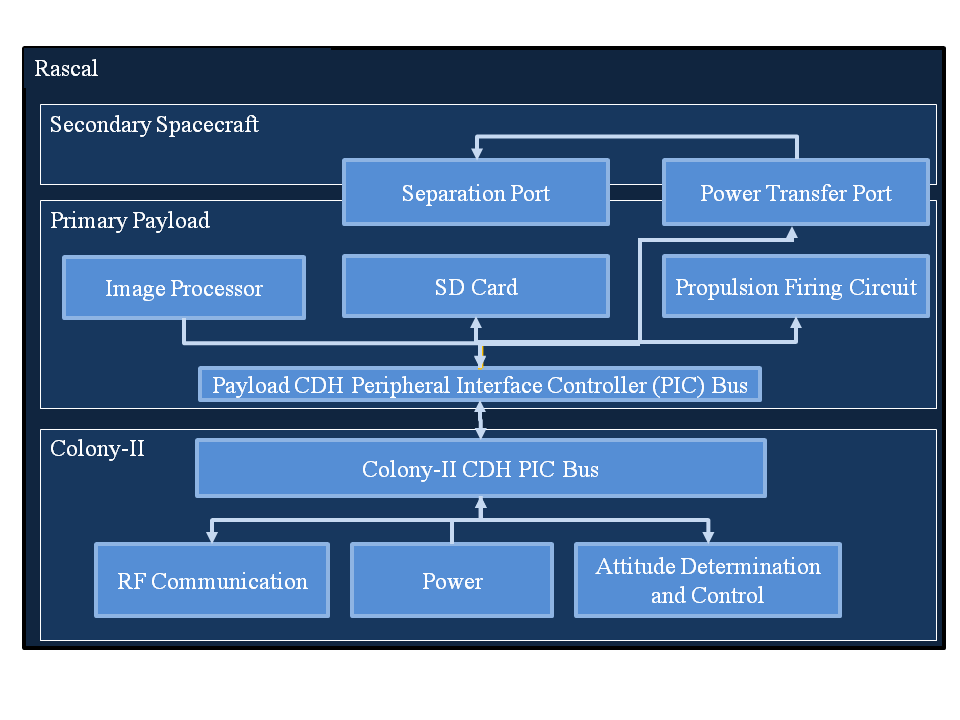
CMQA/ICD's/Device Diagram.tif
