RascalSeniorDesign/Preliminary-Design/CMQA/Presentations/Rascal 6U.png

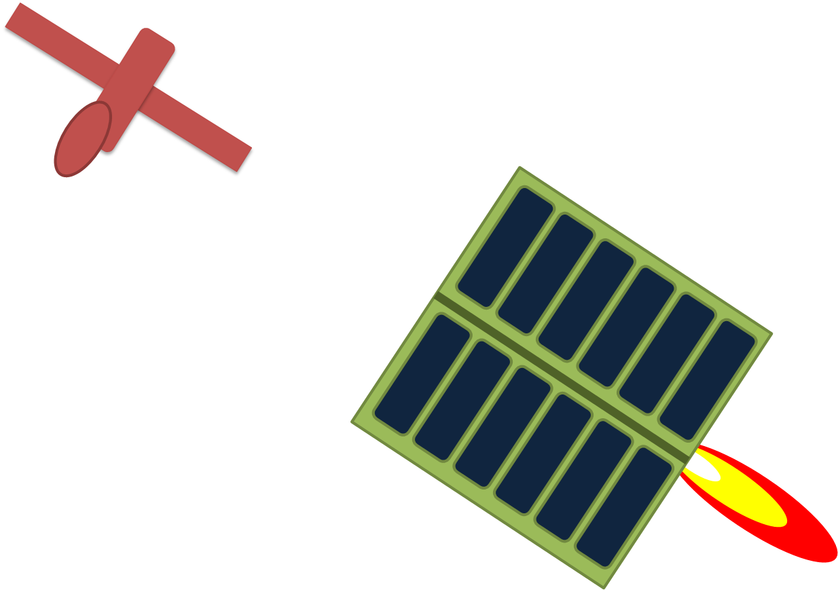
CMQA/Presentations/Rascal 6U.png
