RascalSeniorDesign/Preliminary-Design/CMQA/Presentations/Rascal Active-Active.png

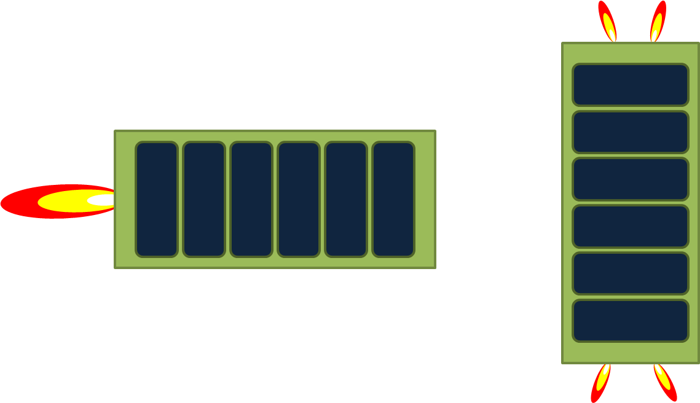
CMQA/Presentations/Rascal Active-Active.png
