RascalSeniorDesign/Preliminary-Design/CMQA/Presentations/Tyler Slides/CubeSat Definitions.key/Data/mt5@2x.jpg

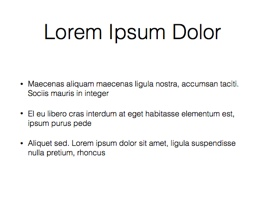
CMQA/Presentations/Tyler Slides/CubeSat Definitions.key/Data/mt5@2x.jpg
