RascalSeniorDesign/Preliminary-Design/CMQA/Presentations/Tyler Slides/CubeSat Definitions.key/Data/mt7@2x.jpg

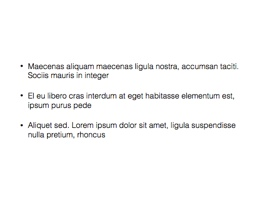
CMQA/Presentations/Tyler Slides/CubeSat Definitions.key/Data/mt7@2x.jpg
