RascalSeniorDesign/Preliminary-Design/CMQA/Presentations/Tyler Slides/Power Slides.key/Data/st0.jpg

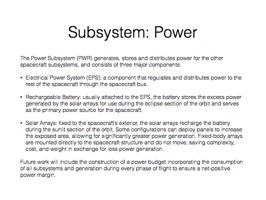
CMQA/Presentations/Tyler Slides/Power Slides.key/Data/st0.jpg
