RascalSeniorDesign/Preliminary-Design/CMQA/Presentations/Tyler Slides/RASCAL 1U Layout.tif

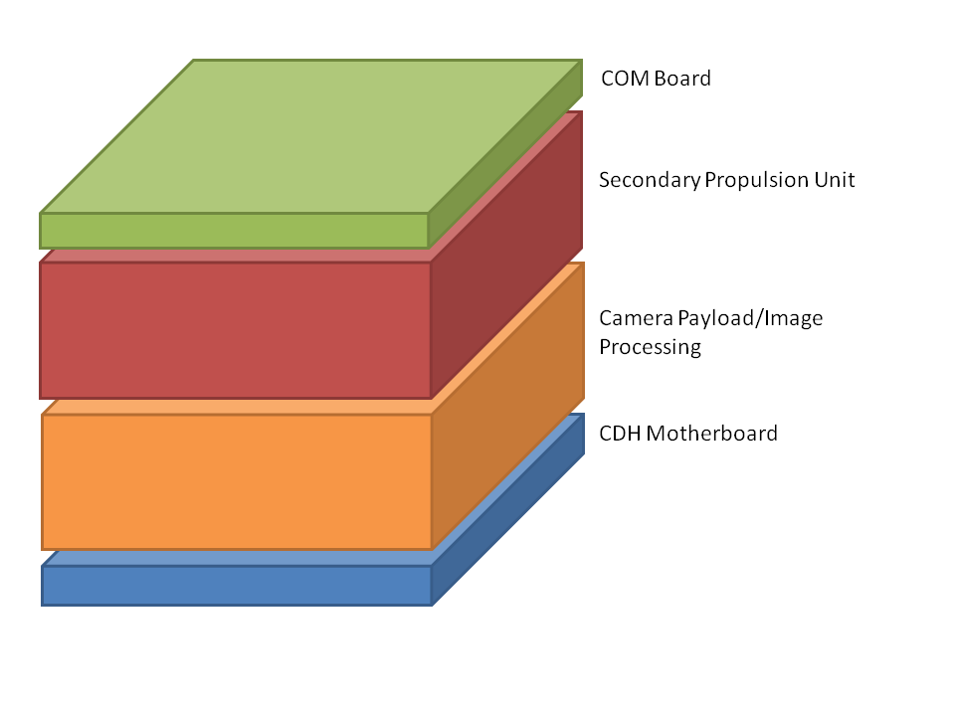
CMQA/Presentations/Tyler Slides/RASCAL 1U Layout.tif
