RascalSeniorDesign/Preliminary-Design/Communication (COM)/GND to SC Block Diagram.tif

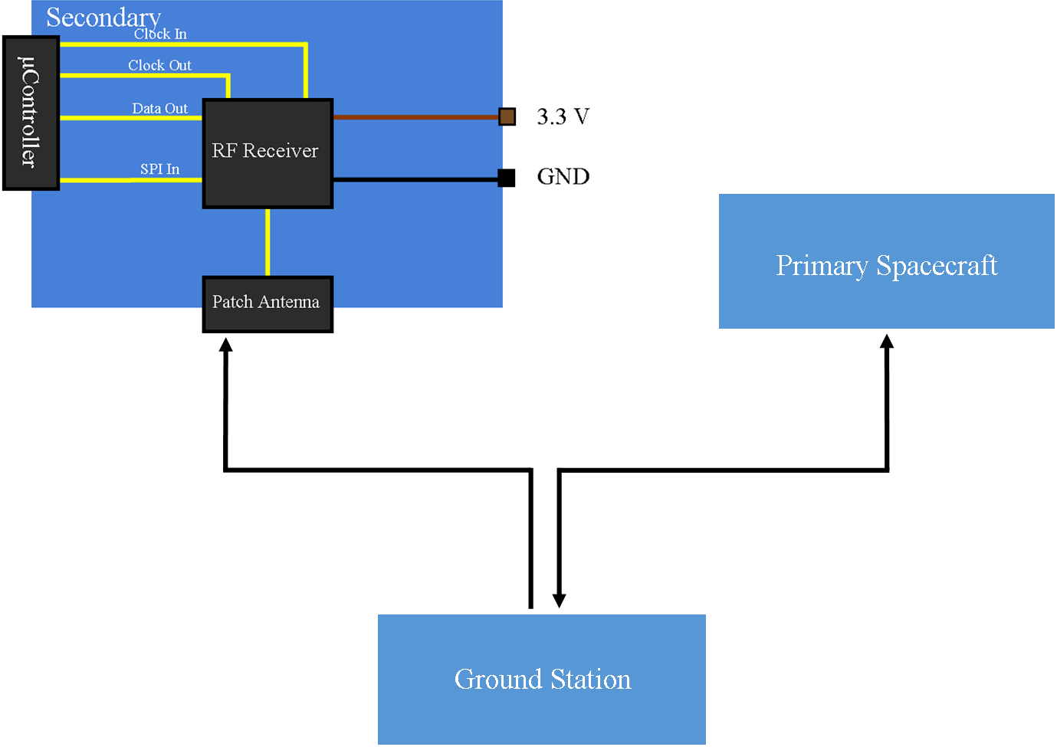
Communication (COM)/GND to SC Block Diagram.tif
