RascalSeniorDesign/Preliminary-Design/Power (PWR)/Budgets/RCL-B-PWR2 Dummy Spacecraft Power Budget.numbers/preview-web.jpg

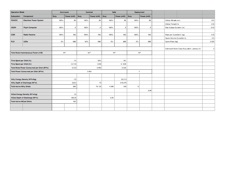
Power (PWR)/Budgets/RCL-B-PWR2 Dummy Spacecraft Power Budget.numbers/preview-web.jpg
