RascalSeniorDesign/Preliminary-Design/Power (PWR)/Rascal PWR Block Diagram.tif

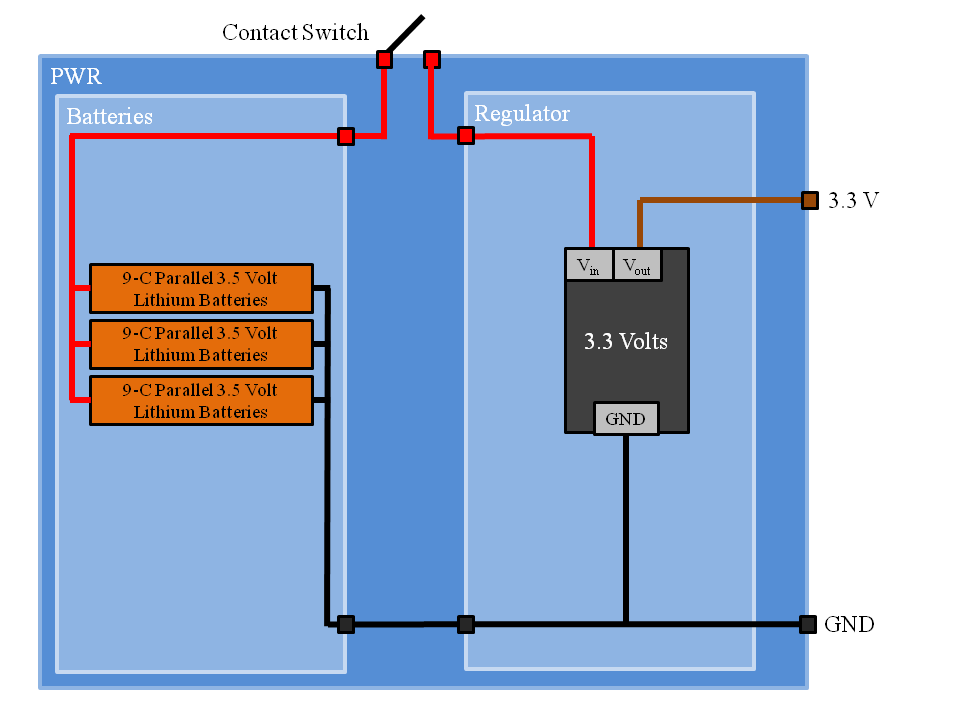
Power (PWR)/Rascal PWR Block Diagram.tif
