RascalSeniorDesign/Preliminary-Design/Structure (STR)/CAD Models/Rendered Files/Exploded View Annotated.tif

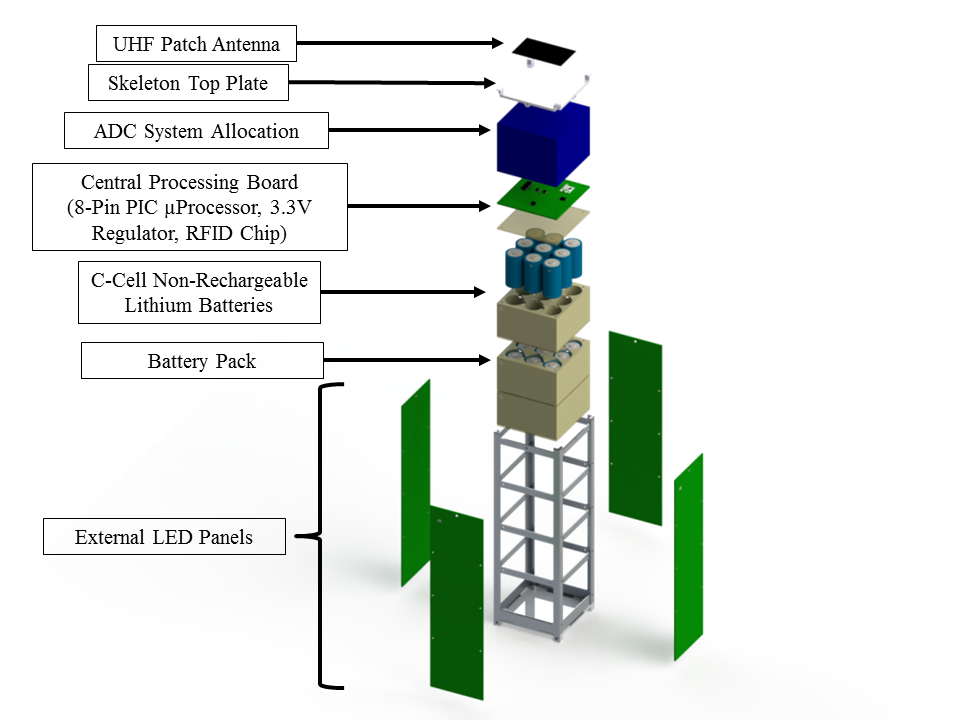
Structure (STR)/CAD Models/Rendered Files/Exploded View Annotated.tif
