RascalSeniorDesign/Preliminary-Design/Attitude Determination and Control (ADC)/Reference Material/Surrey Control Techniques for Aerospace Systems.pdf

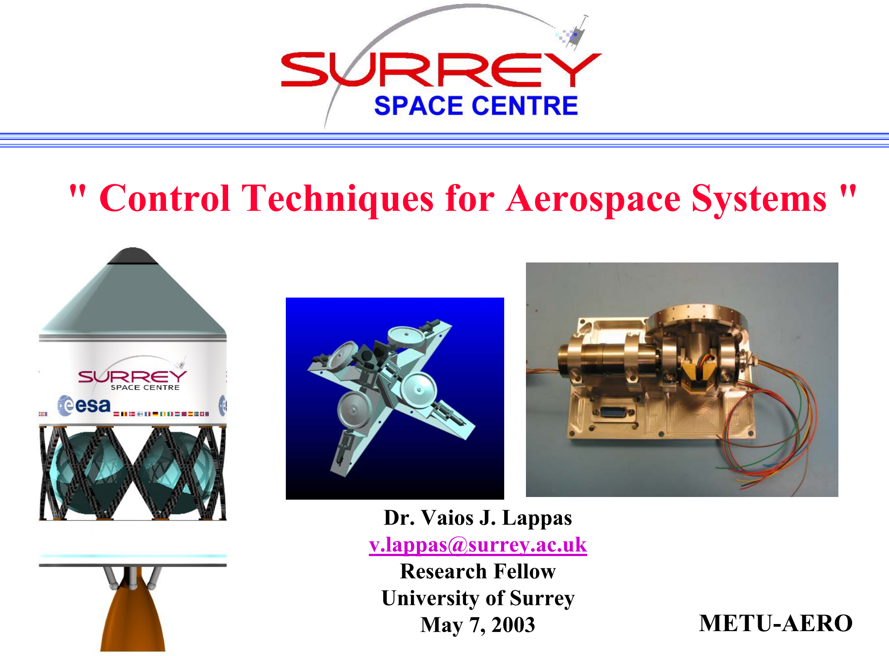
[picture p136: page 1]

## " Control Techniques for Aerospace Systems "

Dr. Vaios J. Lappas
v.lappas@surrey.ac.uk
Research Fellow
University of Surrey
May 7, 2003 | METU-AERO

## Contents of Presentation

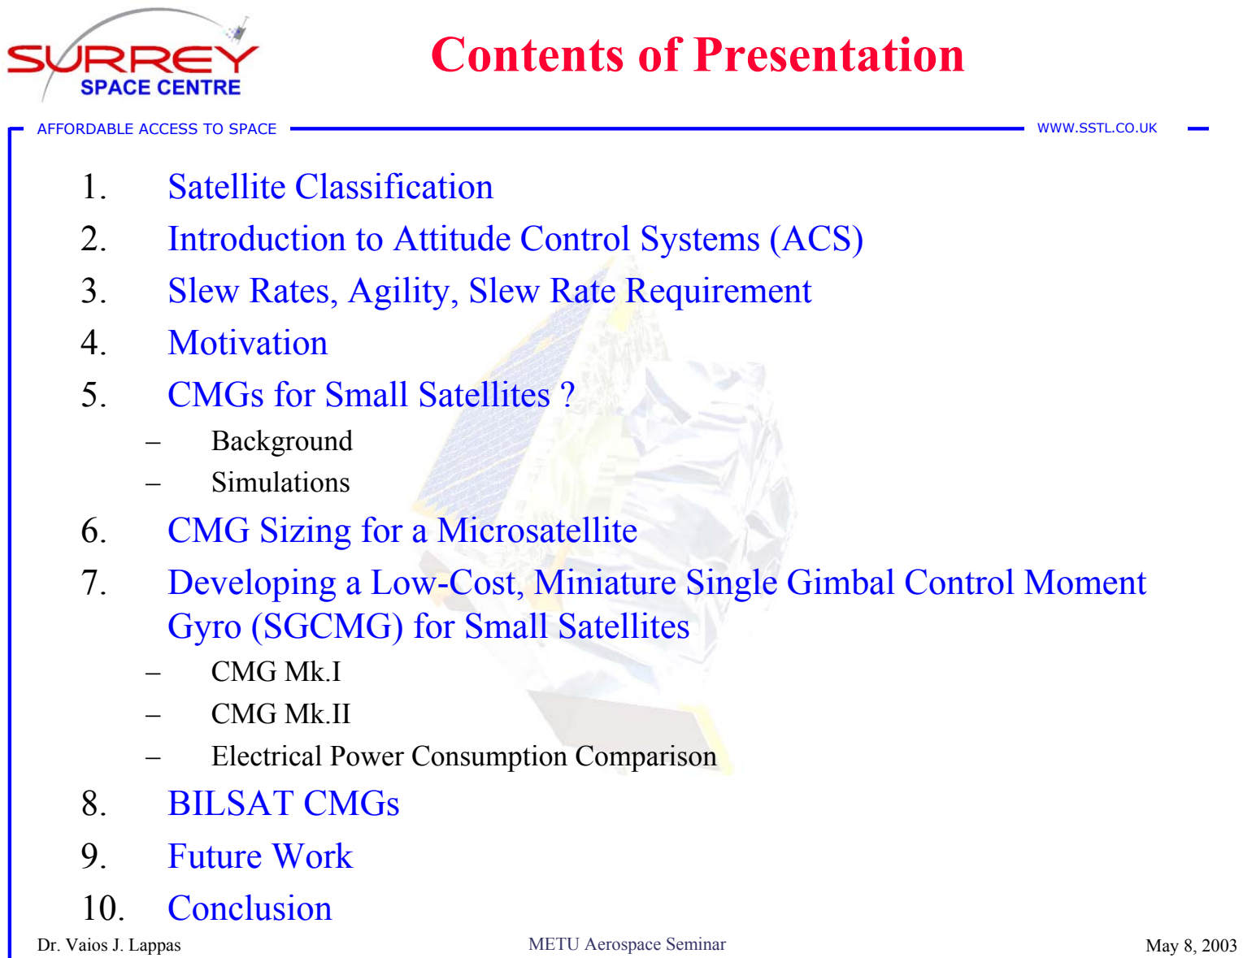
[picture p137: page 2]

Dr. Vaios J. Lappas | May 8, 2003
AFFORDABLE ACCESS TO SPACE | WWW.SSTL.CO.UK

METU Aerospace Seminar

1. Satellite Classification
2. Introduction to Attitude Control Systems (ACS)
3. Slew Rates, Agility, Slew Rate Requirement
4. Motivation
5. CMGs for Small Satellites ?
– | Background
– | Simulations
6. CMG Sizing for a Microsatellite
7. Developing a Low-Cost, Miniature Single Gimbal Control Moment Gyro (SGCMG) for Small Satellites
– | CMG Mk.I
– | CMG Mk.II
– | Electrical Power Consumption Comparison
8. BILSAT CMGs
9. Future Work
10. Conclusion

## SPACE AT SURREY

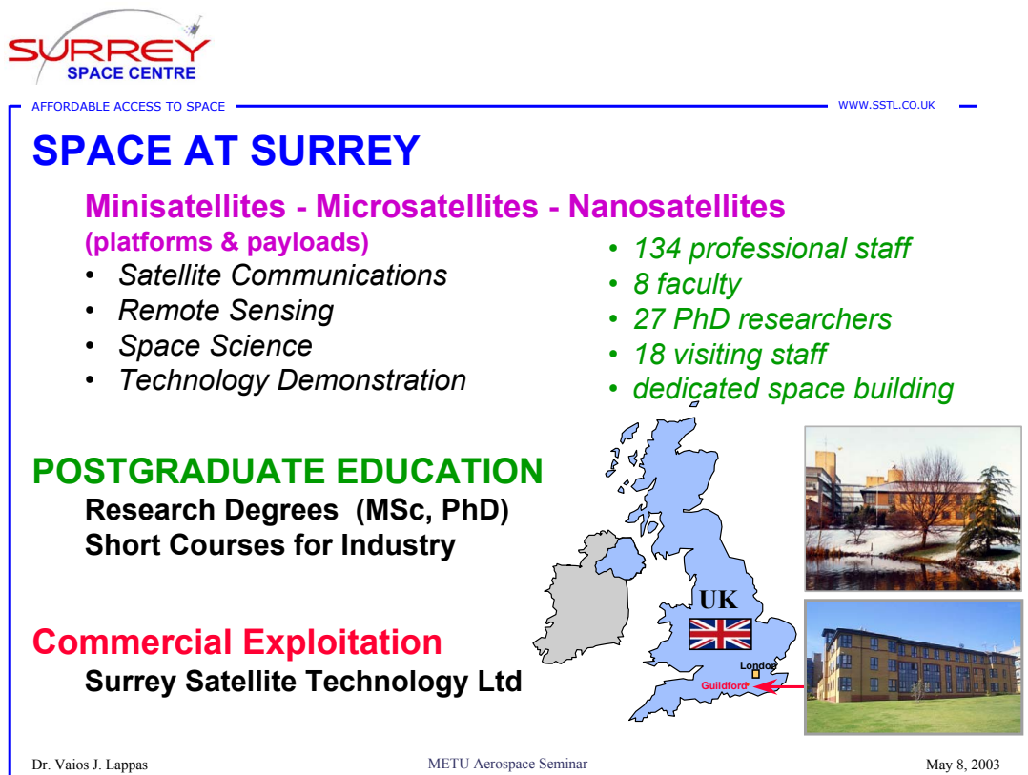
[picture p138: page 3]
AFFORDABLE ACCESS TO SPACE; WWW.SSTL.CO.UK; London; Guildford

Minisatellites - Microsatellites - Nanosatellites
(platforms & payloads)
• Satellite Communications
• Remote Sensing
• Space Science
• Technology Demonstration

• 134 professional staff
• 8 faculty
• 27 PhD researchers
• 18 visiting staff
• dedicated space building

POSTGRADUATE EDUCATION
Research Degrees (MSc, PhD)
Short Courses for Industry

Commercial Exploitation
Surrey Satellite Technology Ltd

## 1.0 Satellite Classification

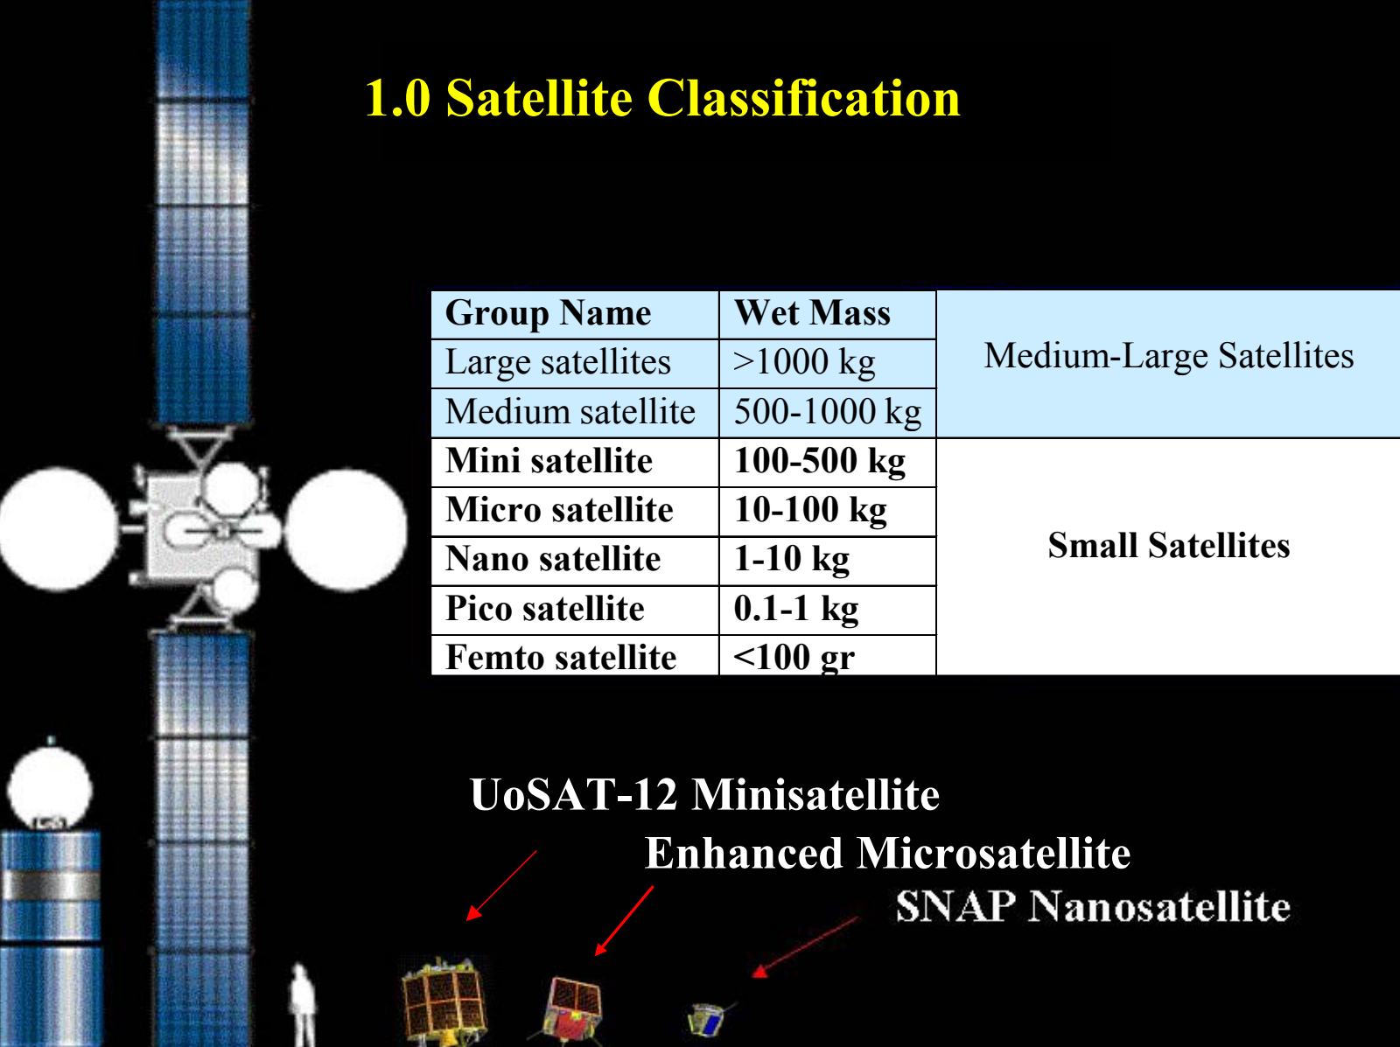
[picture p139: page 4]

AFFORDABLE ACCESS TO SPACE | WWW.SSTL.CO.UK

### UoSAT-12 Minisatellite

Group Name | Wet Mass
Large satellites | >1000 kg
Medium satellite | 500-1000 kg

Medium-Large Satellites

Mini satellite | 100-500 kg
Micro satellite | 10-100 kg
Nano satellite | 1-10 kg
Pico satellite | 0.1-1 kg
Femto satellite | <100 gr

Small Satellites

### Enhanced Microsatellite

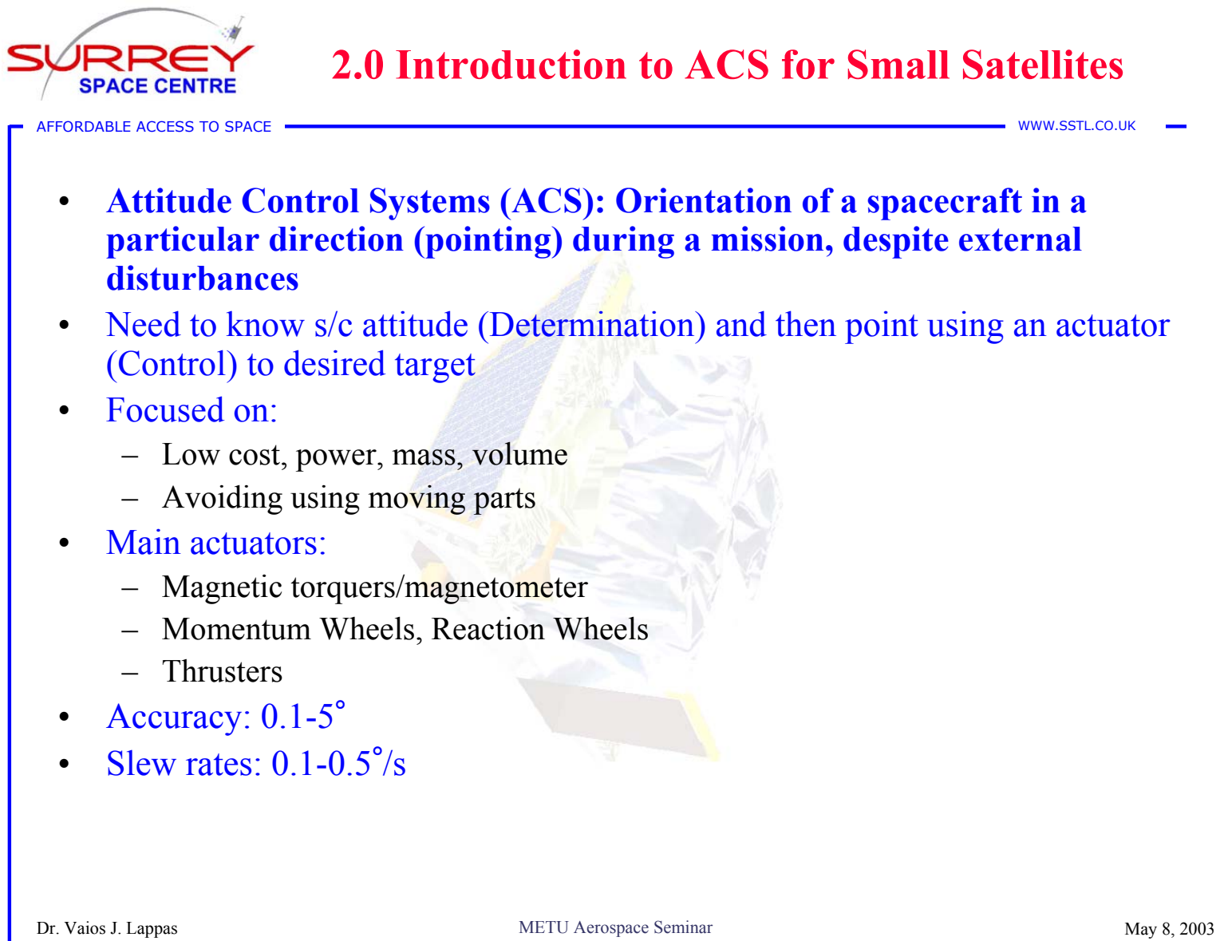
[picture p140: page 5]

AFFORDABLE ACCESS TO SPACE | WWW.SSTL.CO.UK

### 2.0 Introduction to ACS for Small Satellites

- Attitude Control Systems (ACS): Orientation of a spacecraft in a particular direction (pointing) during a mission, despite external disturbances
- Need to know s/c attitude (Determination) and then point using an actuator (Control) to desired target
- Focused on:
– Low cost, power, mass, volume
– Avoiding using moving parts
- Main actuators:
– Magnetic torquers/magnetometer
– Momentum Wheels, Reaction Wheels – Thrusters
- Accuracy: 0.1-5°
- Slew rates: 0.1-0.5°/s

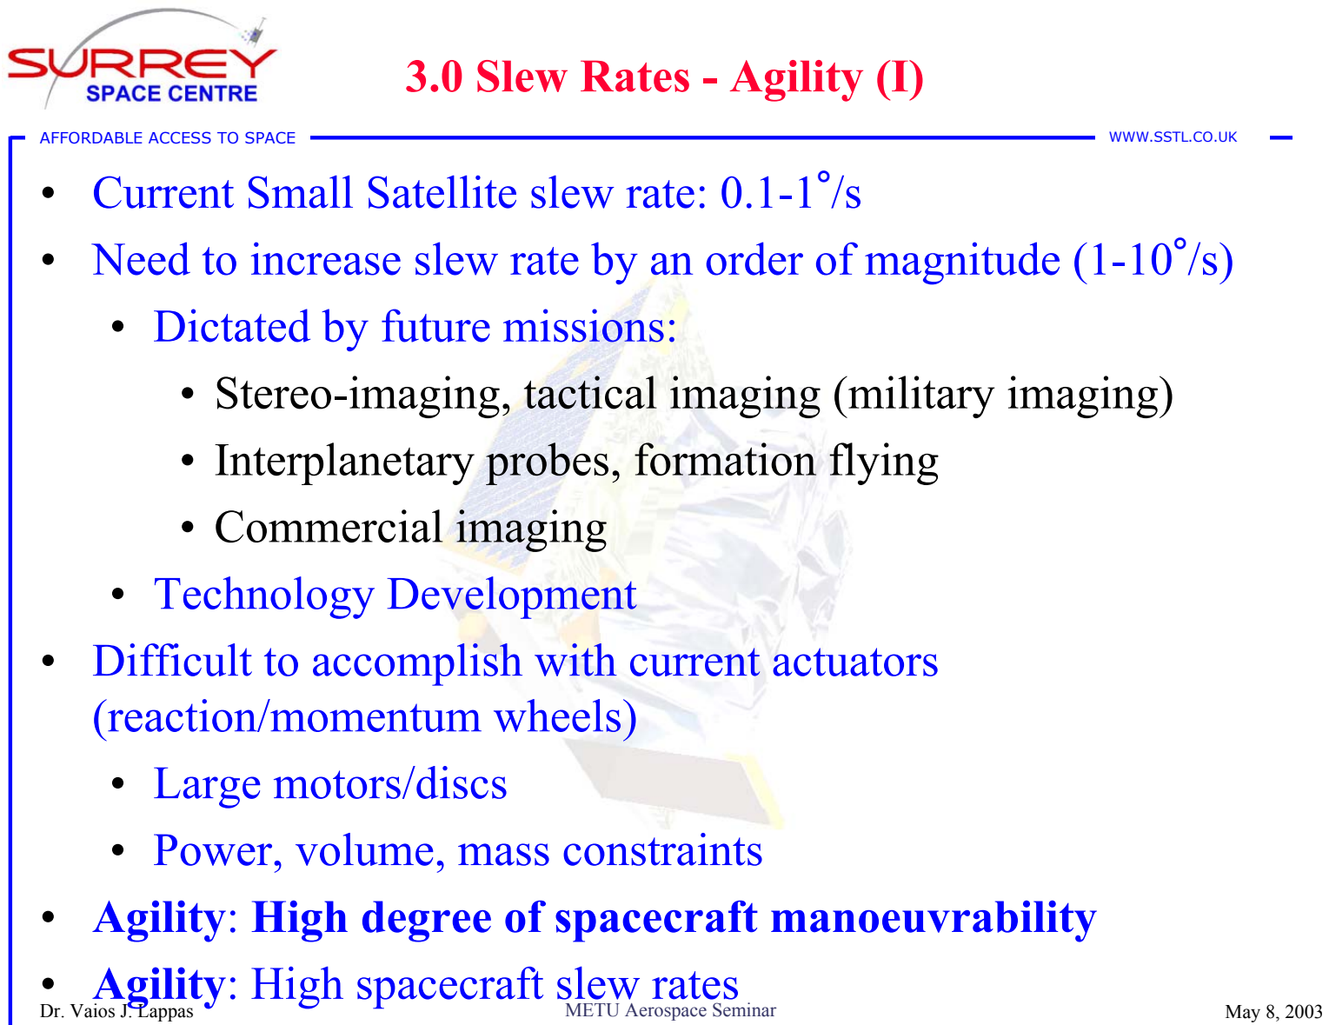
[picture p141: page 6]

AFFORDABLE ACCESS TO SPACE | WWW.SSTL.CO.UK

### 3.0 Slew Rates - Agility (I)

- Current Small Satellite slew rate: 0.1-1°/s - Need to increase slew rate by an order of magnitude (1-10°/s) - Dictated by future missions: - Stereo-imaging, tactical imaging (military imaging) - Interplanetary probes, formation flying - Commercial imaging - Technology Development - Difficult to accomplish with current actuators (reaction/momentum wheels) - Large motors/discs - Power, volume, mass constraints - Agility: High degree of spacecraft manoeuvrability - Agility: High spacecraft slew rates

AFFORDABLE ACCESS TO SPACE | WWW.SSTL.CO.UK

### 3.0 Agility (II)

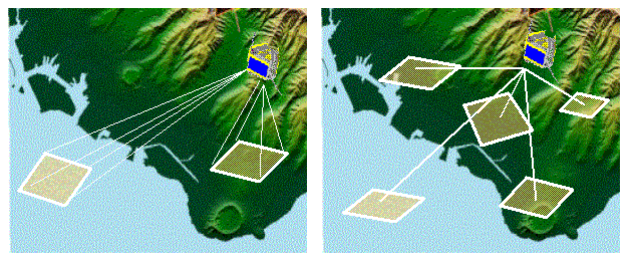
[picture p142: figure]

- Agility substantially increases the operational envelope and efficiency of spacecraft
- Considerable increase in the return of earth and science mission data
- Direct increase in commercial & scientific value of mission

AFFORDABLE ACCESS TO SPACE | WWW.SSTL.CO.UK
Tactical Imaging & Tracking Moving Objects,

## Commercial Imaging

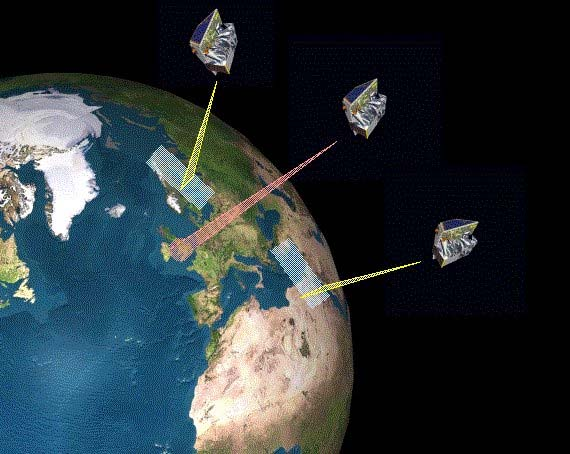
[picture p143: figure]

AFFORDABLE ACCESS TO SPACE | WWW.SSTL.CO.UK

## Formation Flying, Satellite/Space Station Inspection

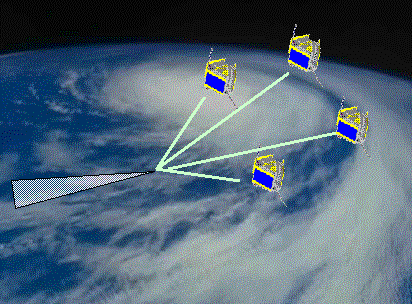
[picture p144: figure]

## Asteroid Missions-Agility

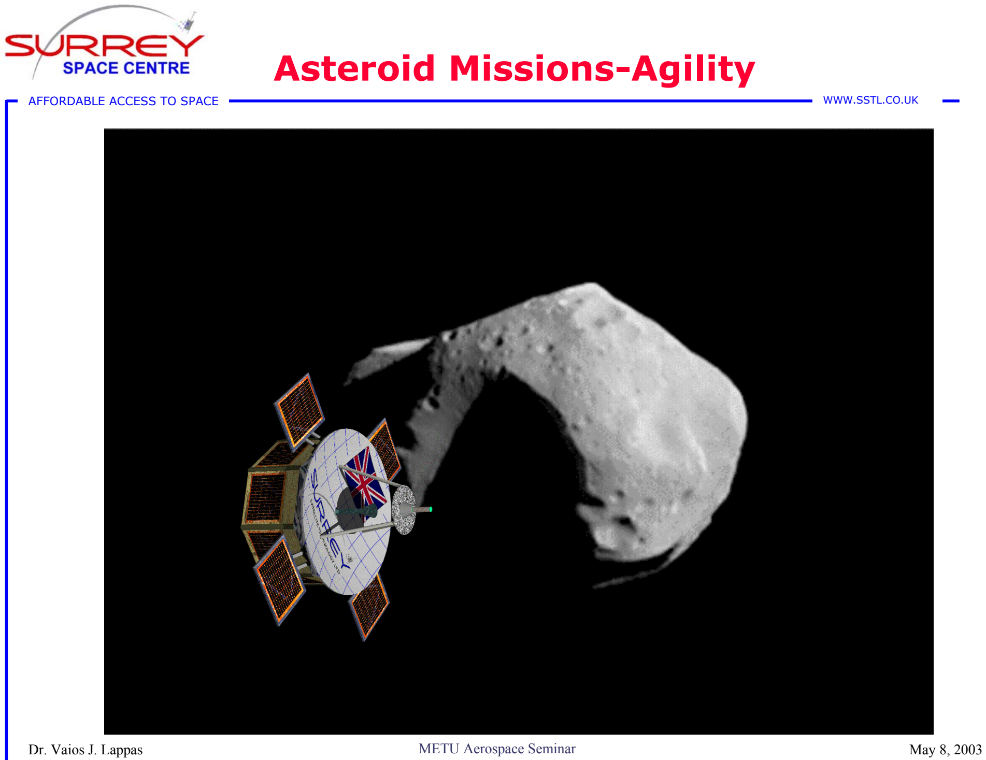
[picture p145: page 10]

AFFORDABLE ACCESS TO SPACE | WWW.SSTL.CO.UK

AFFORDABLE ACCESS TO SPACE | WWW.SSTL.CO.UK

## Agility for Small Satellites

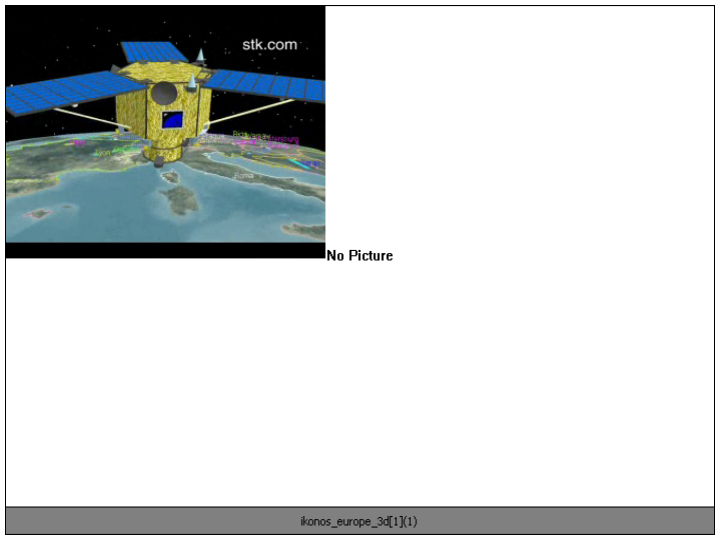
[picture p146: figure]

AFFORDABLE ACCESS TO SPACE | WWW.SSTL.CO.UK

## Attitude Determination and Control Systems (ADCS)

### - Key Subsystem of Spacecraft - Important for stability and pointing - Think of a person taking a picture with a camera (blurry pictures if not stable) - ADCS Systems are complicated:

– Fusion of software/hardware components
– Need electronics/aerospace/controls principles

### - Brief overview of ADCS components: – Stabilisation – Sensors for attitude determination –Actuators

## Spacecraft Stabilisation

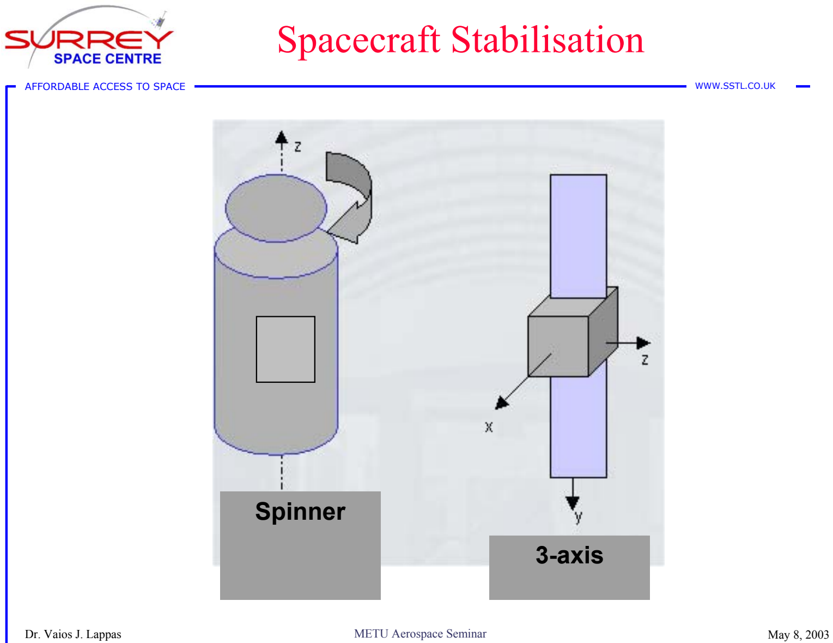
[picture p147: page 13]

AFFORDABLE ACCESS TO SPACE | WWW.SSTL.CO.UK

Spinner
3-axis

## Sensors for Attitude Determination

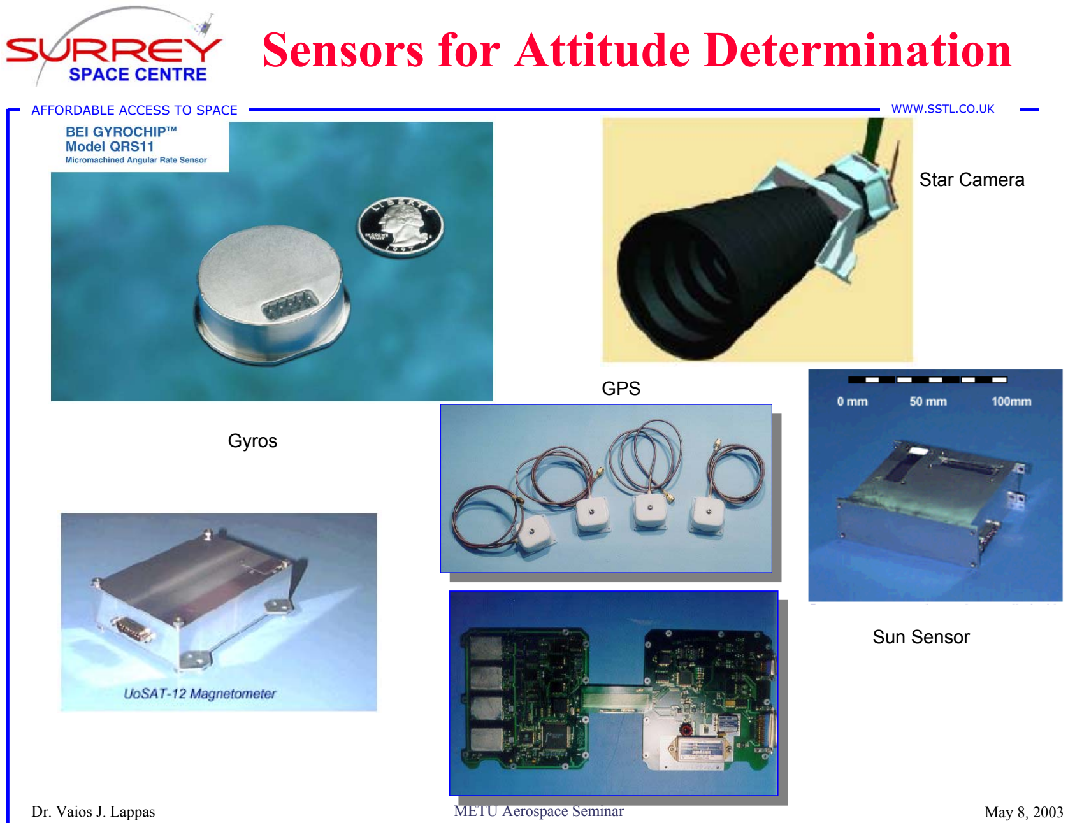
[picture p148: page 14]

AFFORDABLE ACCESS TO SPACE | WWW.SSTL.CO.UK

Star Camera

GPS

Gyros

Sun Sensor

## Actuators for Attitude and Orbit Control

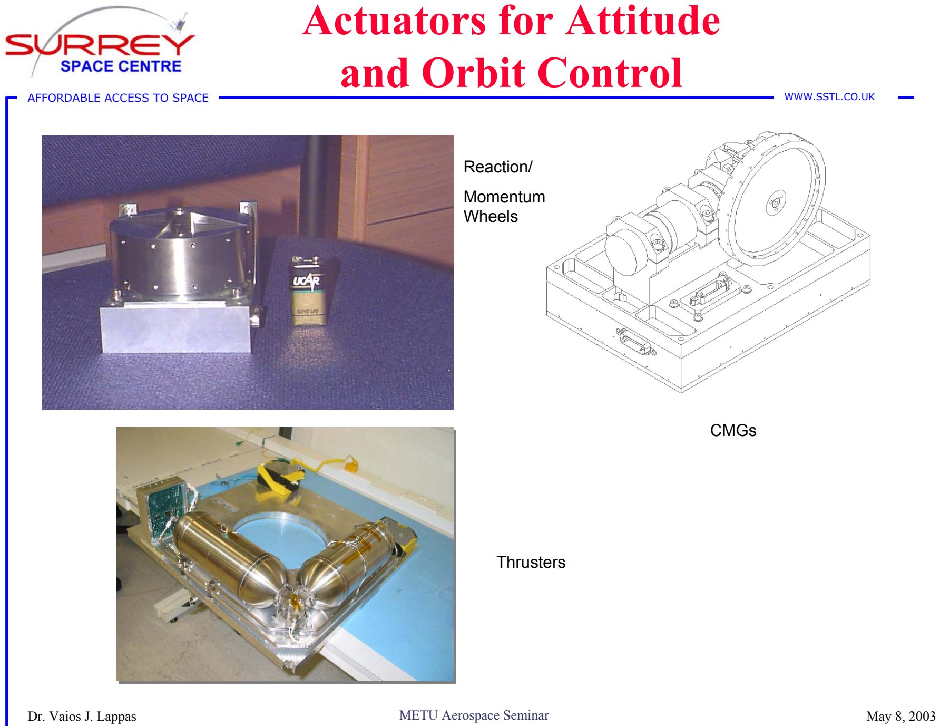
[picture p149: page 15]

AFFORDABLE ACCESS TO SPACE | WWW.SSTL.CO.UK

Reaction/
Momentum
Wheels

CMGs

Thrusters

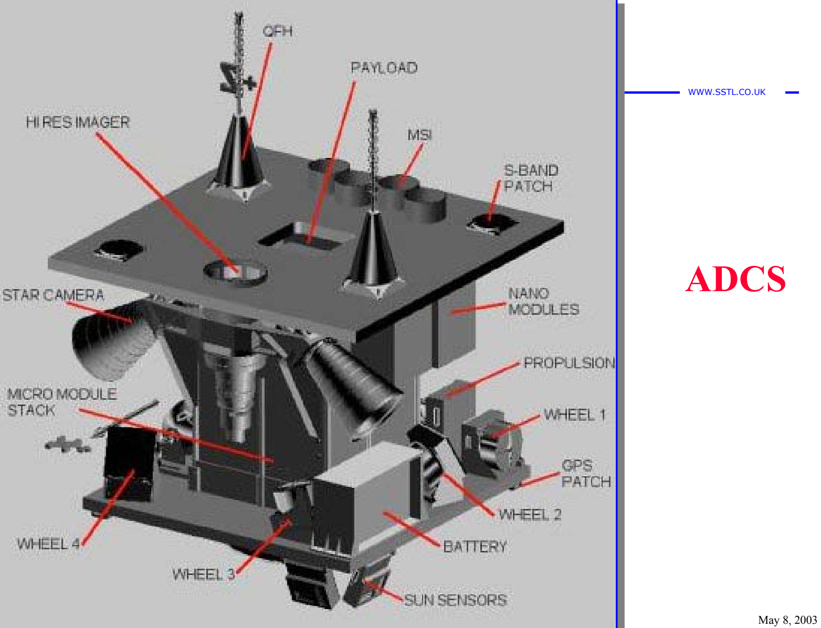
[picture p150: page 16]

AFFORDABLE ACCESS TO SPACE | WWW.SSTL.CO.UK

## ADCS

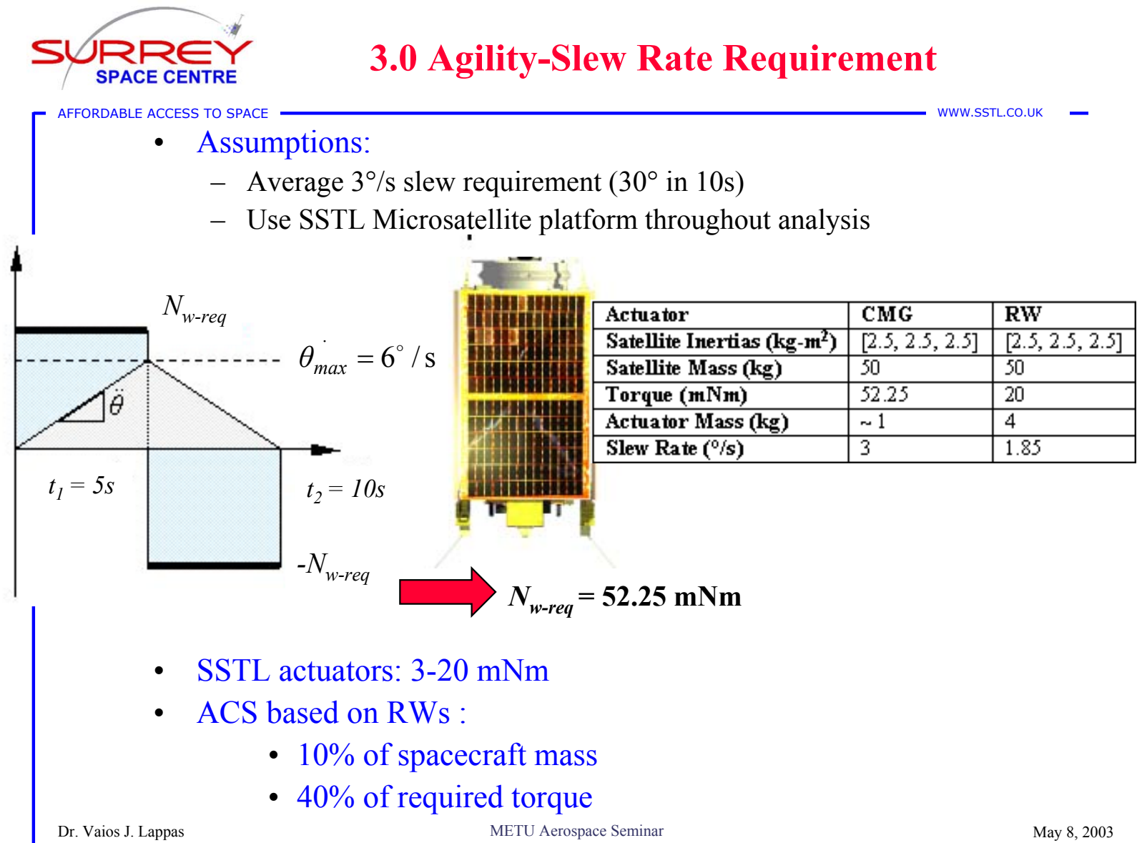
[picture p151: page 17]

AFFORDABLE ACCESS TO SPACE | WWW.SSTL.CO.UK

### 3.0 Agility-Slew Rate Requirement

- Assumptions:
– Average 3°/s slew requirement (30° in 10s)
– Use SSTL Microsatellite platform throughout analysis

Nw-req = 52.25 mNm

- SSTL actuators: 3-20 mNm
- ACS based on RWs :
- 10% of spacecraft mass
- 40% of required torque
t1 = 5s | t2 = 10s

-Nw-req

Nw-req
6 /s D =
max θ

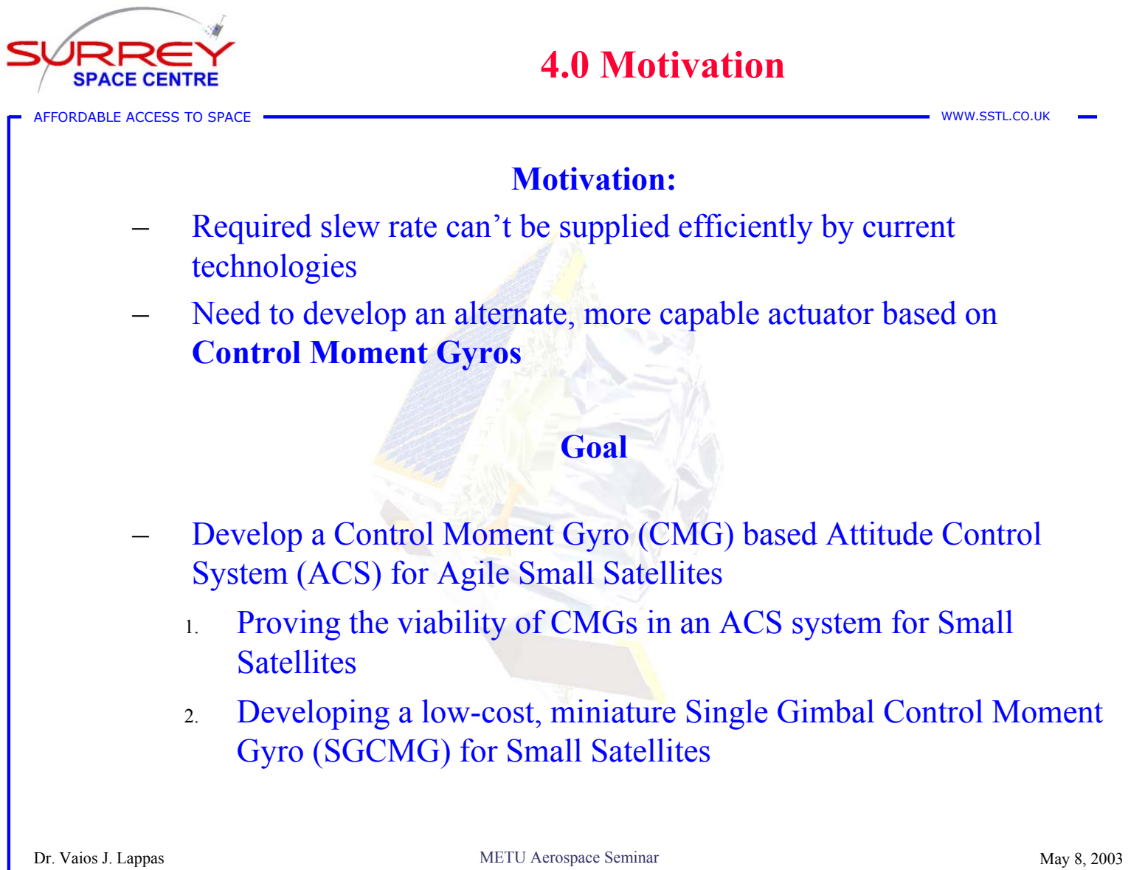
[picture p152: page 18]

AFFORDABLE ACCESS TO SPACE | WWW.SSTL.CO.UK

### 4.0 Motivation

Motivation:
– Required slew rate can’t be supplied efficiently by current technologies
– Need to develop an alternate, more capable actuator based on Control Moment Gyros

Goal

– Develop a Control Moment Gyro (CMG) based Attitude Control System (ACS) for Agile Small Satellites
1. Proving the viability of CMGs in an ACS system for Small Satellites
2. Developing a low-cost, miniature Single Gimbal Control Moment Gyro (SGCMG) for Small Satellites

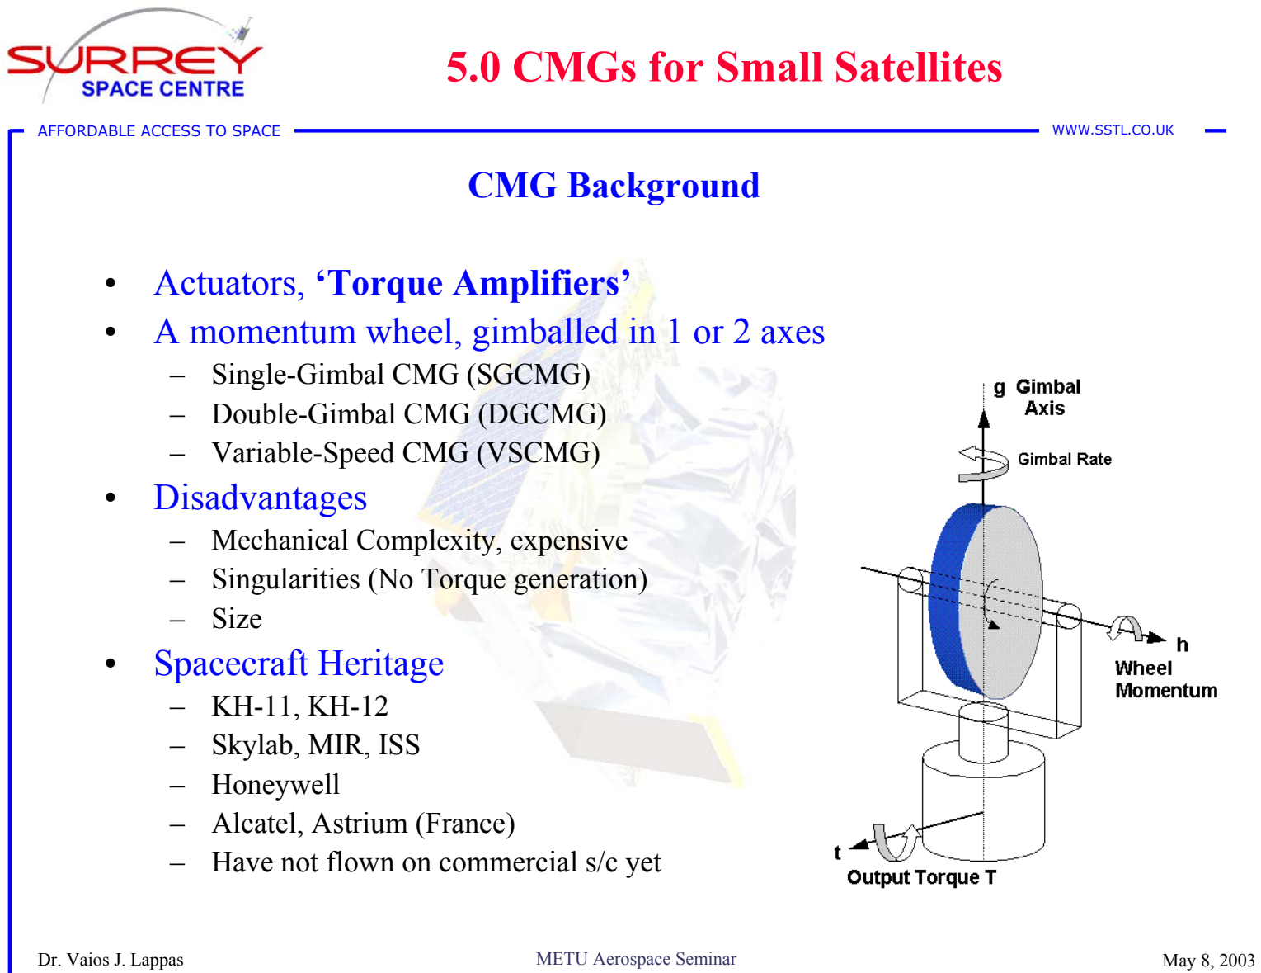
[picture p153: page 19]

AFFORDABLE ACCESS TO SPACE | WWW.SSTL.CO.UK

### 5.0 CMGs for Small Satellites

CMG Background

- Actuators, ‘Torque Amplifiers’
- A momentum wheel, gimballed in 1 or 2 axes
– Single-Gimbal CMG (SGCMG)
– Double-Gimbal CMG (DGCMG)
– Variable-Speed CMG (VSCMG)
- Disadvantages
– Mechanical Complexity, expensive – Singularities (No Torque generation) –Size
- Spacecraft Heritage
–KH-11, KH-12
– Skylab, MIR, ISS
– Honeywell
– Alcatel, Astrium (France)
– Have not flown on commercial s/c yet

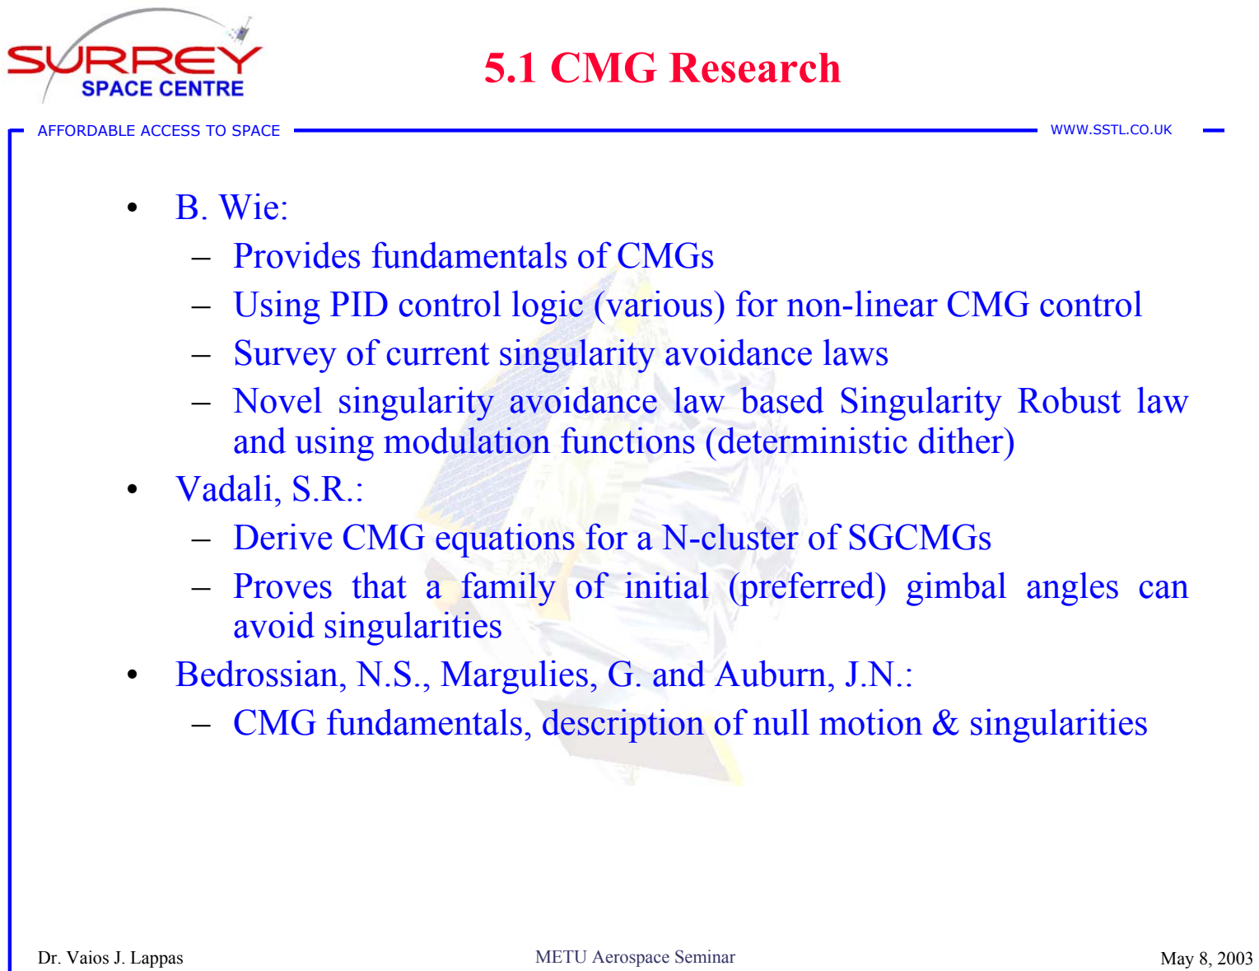
[picture p154: page 20]

AFFORDABLE ACCESS TO SPACE | WWW.SSTL.CO.UK

### 5.1 CMG Research

- B. Wie:
– Provides fundamentals of CMGs
– Using PID control logic (various) for non-linear CMG control
– Survey of current singularity avoidance laws
– Novel singularity avoidance law based Singularity Robust law and using modulation functions (deterministic dither)
- Vadali, S.R.:
– Derive CMG equations for a N-cluster of SGCMGs
– Proves that a family of initial (preferred) gimbal angles can avoid singularities
- Bedrossian, N.S., Margulies, G. and Auburn, J.N.:
– CMG fundamentals, description of null motion & singularities

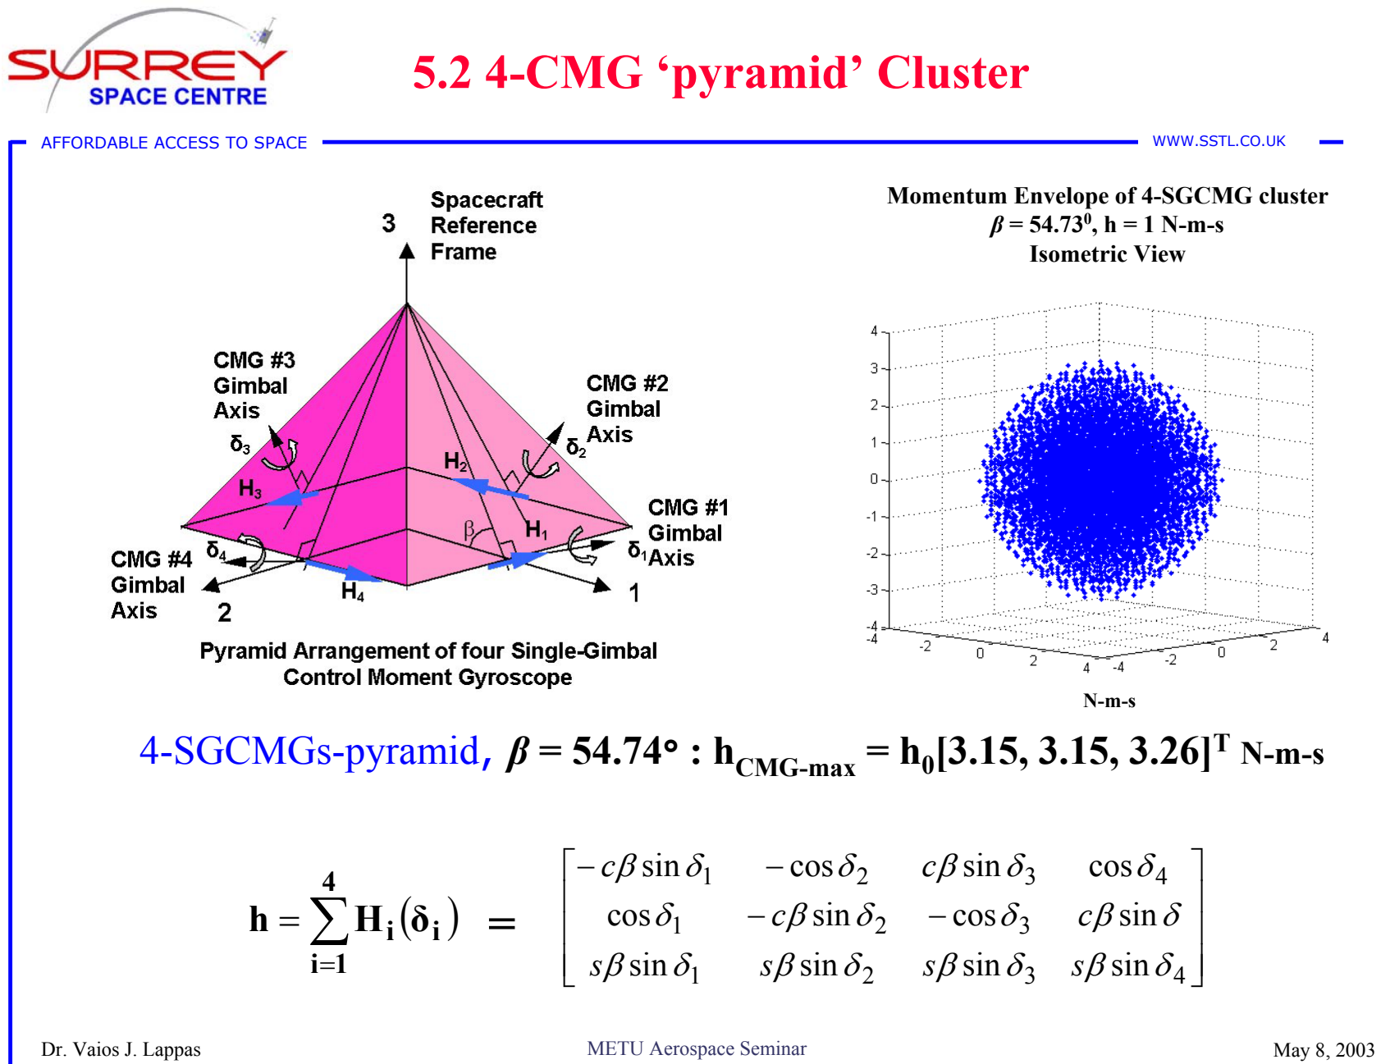
[picture p155: page 21]

AFFORDABLE ACCESS TO SPACE | WWW.SSTL.CO.UK

### 5.2 4-CMG ‘pyramid’ Cluster

Momentum Envelope of 4-SGCMG cluster β = 54.73⁰, h = 1 N-m-s
Isometric View

Ν-m-s
4-SGCMGs-pyramid, β = 54.74° : hCMG-max = h0[3.15, 3.15, 3.26]T N-m-s
| − | − − | − 1 | 2 | 3 | 4 1 | 2 | 3 1 | 2 | 3 | 4 sin | sin | sin | sin cos | sin | cos | sin sin | cos | sin | cos β δ | β δ | β δ | β δ δ | β δ | δ | β δ β δ | δ | β δ | δ s | s | s | s c | c c | c ∑ () = = 4i 1 h | Hi δi | =

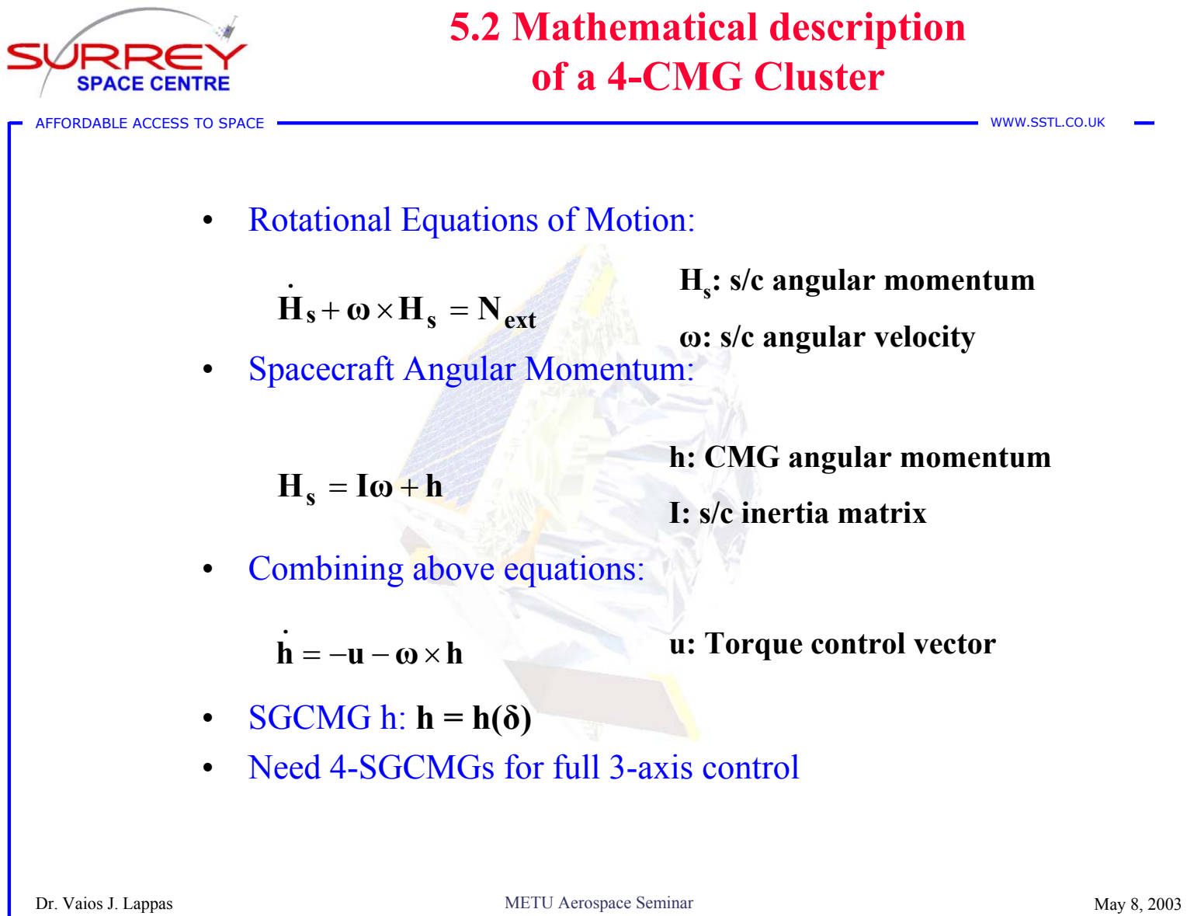
[picture p156: page 22]

AFFORDABLE ACCESS TO SPACE | WWW.SSTL.CO.UK

### 5.2 Mathematical description of a 4-CMG Cluster

- Rotational Equations of Motion:
- Spacecraft Angular Momentum:
- Combining above equations:
- SGCMG h: h = h(δ)
- Need 4-SGCMGs for full 3-axis control

s ext s

H + ω ×H = N

Hs = Iω + h

Hs: s/c angular momentum
ω: s/c angular velocity

h: CMG angular momentum
I: s/c inertia matrix

h u ω h

= − − × | u: Torque control vector

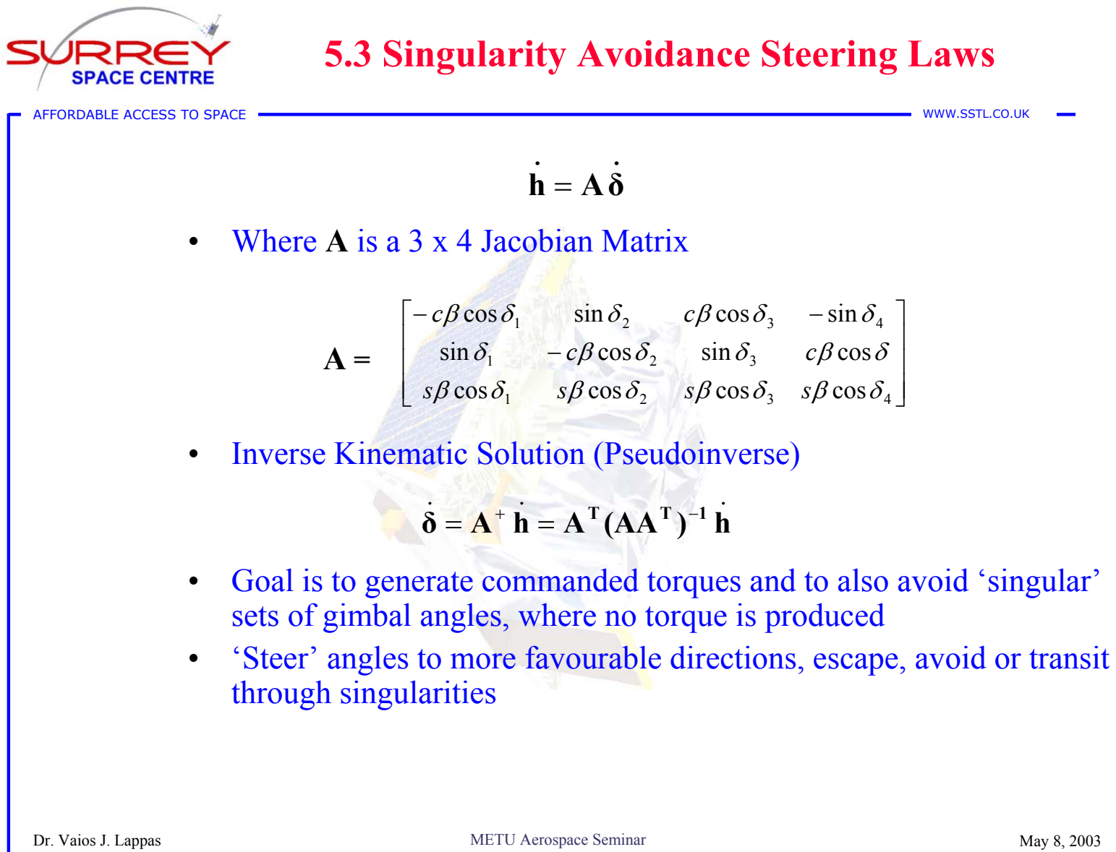
[picture p157: page 23]

AFFORDABLE ACCESS TO SPACE | WWW.SSTL.CO.UK

### 5.3 Singularity Avoidance Steering Laws

- Where A is a 3 x 4 Jacobian Matrix
- Inverse Kinematic Solution (Pseudoinverse)
- Goal is to generate commanded torques and to also avoid ‘singular’ sets of gimbal angles, where no torque is produced
- ‘Steer’ angles to more favourable directions, escape, avoid or transit through singularities
h = Aδ

A =

| − − | − 1 | 2 | 3 | 4 1 | 2 | 3 1 | 2 | 3 | 4 cos | cos | cos | cos sin | cos | sin | cos cos | sin | cos | sin β δ | β δ | β δ β δ δ | β δ | δ | β δ β δ | δ | β δ | δ s | s | s | s c | c c | c
T | T | 1
δ A h A (AA ) h ⁺ | − = | =

AFFORDABLE ACCESS TO SPACE | WWW.SSTL.CO.UK

### 5.4 CMG ACS Simulations (I)

- In MATLAB® and SIMULINK®
- Satellite Model, CMG Dynamics, Quaternion Feedback Controller

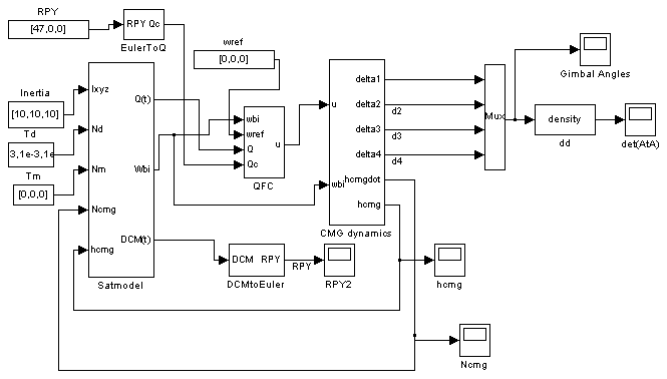
[picture p158: figure]

- Used to study the behaviour of a CMG attitude control system
- Test Singularity Avoidance laws, try new ones
- Minisatellite, Microsatellite and Nanosatellite models used

AFFORDABLE ACCESS TO SPACE | WWW.SSTL.CO.UK

### 5.4 CMG ACS Simulations (II)

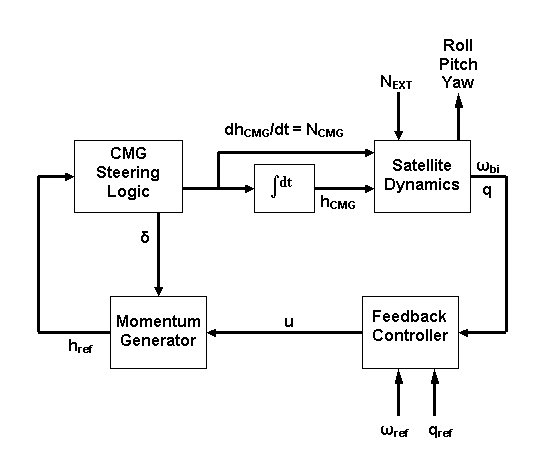
[picture p159: figure]

Attitude Control Model

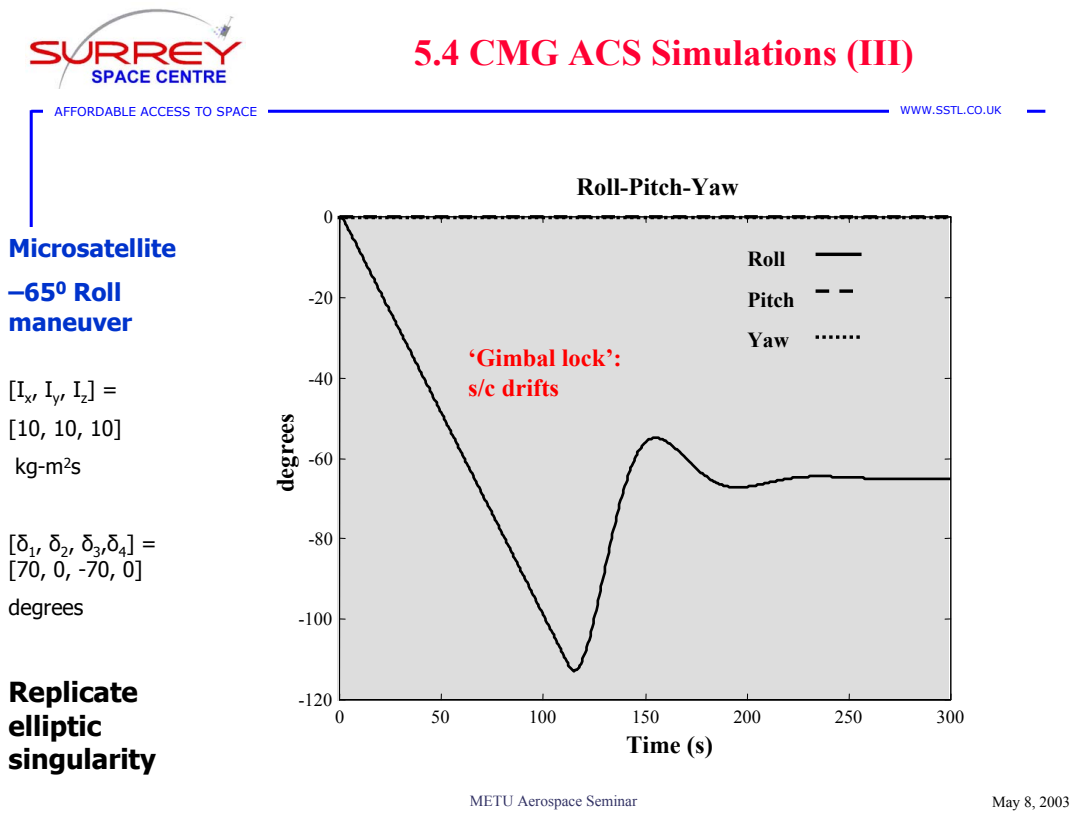
[picture p160: page 26]
AFFORDABLE ACCESS TO SPACE; WWW.SSTL.CO.UK; Time (s); degrees; Roll; Pitch; Yaw; ‘Gimbal lock’: s/c drifts; Microsatellite –65⁰ Roll maneuver; [δ1, δ2, δ3,δ4] = [70, 0, -70, 0] degrees; Replicate elliptic singularity

5.4 CMG ACS Simulations (III)

Roll-Pitch-Yaw

kg-m²s

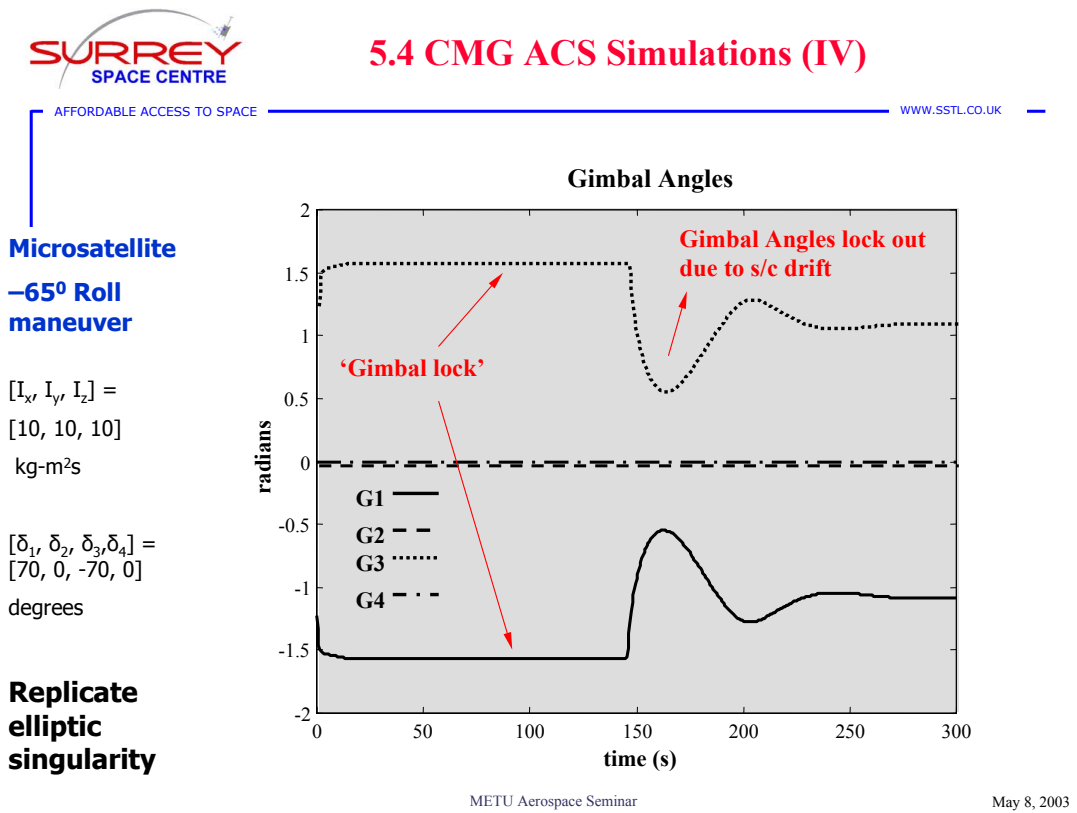
[picture p161: page 27]
AFFORDABLE ACCESS TO SPACE; WWW.SSTL.CO.UK; Gimbal Angles; time (s); radians G1; ‘Gimbal lock’; Microsatellite –65⁰ Roll maneuver; [δ1, δ2, δ3,δ4] = [70, 0, -70, 0] degrees; Replicate elliptic singularity

5.4 CMG ACS Simulations (IV)

Gimbal Angles lock out
due to s/c drift

kg-m²s

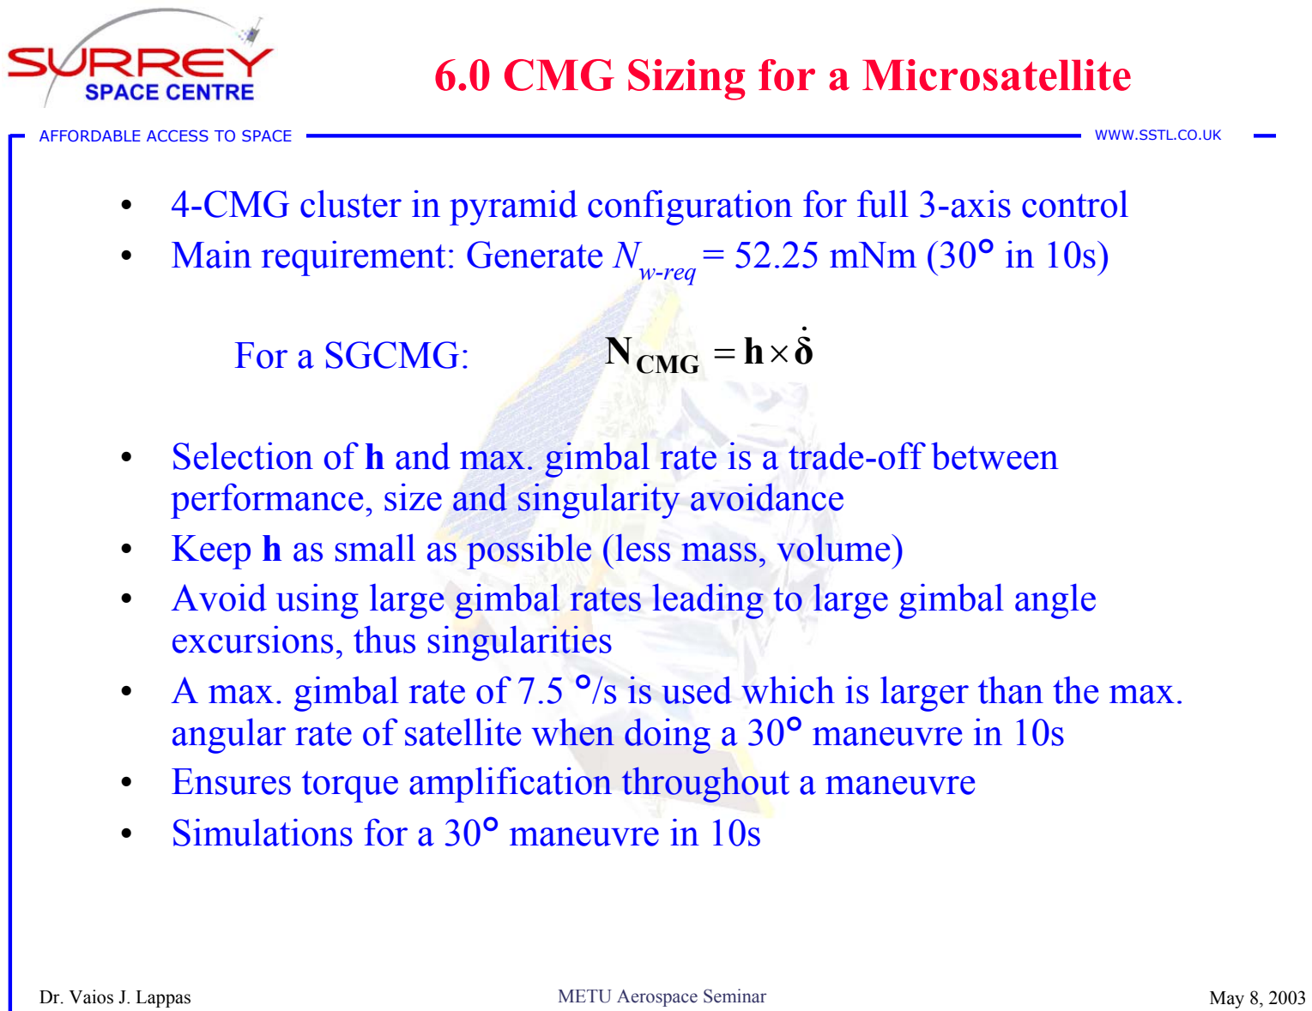
[picture p162: page 28]

AFFORDABLE ACCESS TO SPACE | WWW.SSTL.CO.UK

### 6.0 CMG Sizing for a Microsatellite

- 4-CMG cluster in pyramid configuration for full 3-axis control
- Main requirement: Generate Nw-req = 52.25 mNm (30° in 10s)

For a SGCMG:

- Selection of h and max. gimbal rate is a trade-off between performance, size and singularity avoidance
- Keep h as small as possible (less mass, volume)
- Avoid using large gimbal rates leading to large gimbal angle excursions, thus singularities
- A max. gimbal rate of 7.5 °/s is used which is larger than the max. angular rate of satellite when doing a 30° maneuvre in 10s
- Ensures torque amplification throughout a maneuvre
- Simulations for a 30° maneuvre in 10s
NCMG = h×δ

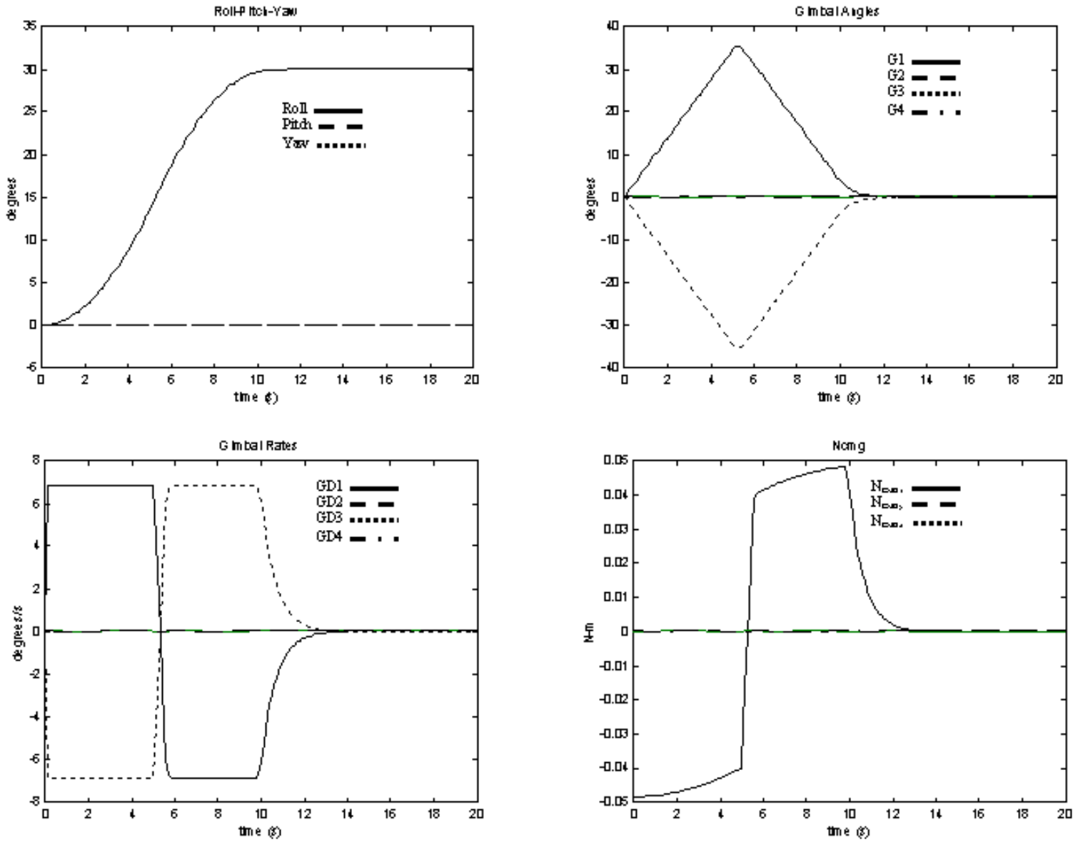
[picture p163: page 29]

AFFORDABLE ACCESS TO SPACE | WWW.SSTL.CO.UK

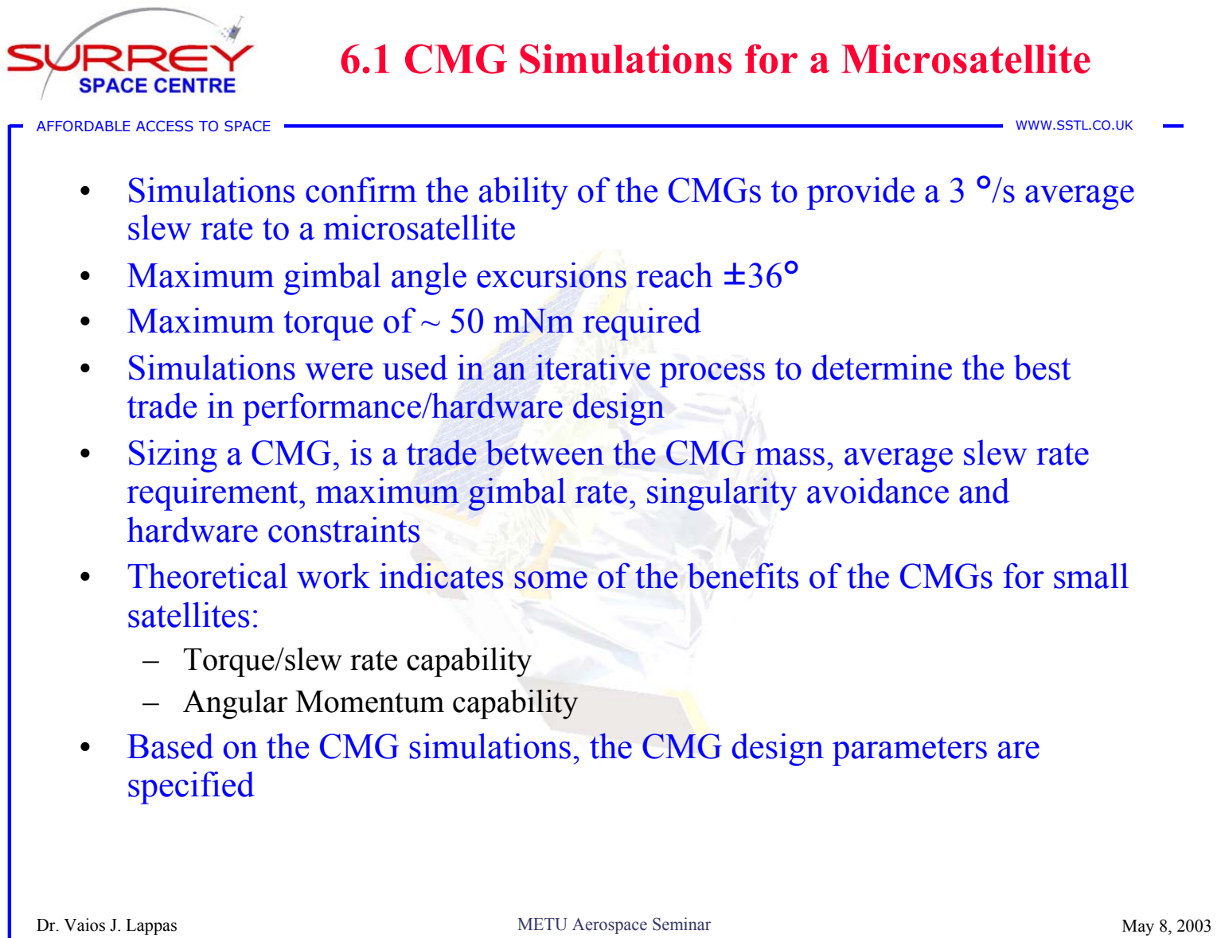
[picture p164: page 30]

AFFORDABLE ACCESS TO SPACE | WWW.SSTL.CO.UK

### 6.1 CMG Simulations for a Microsatellite

- Simulations confirm the ability of the CMGs to provide a 3 °/s average slew rate to a microsatellite
- Maximum gimbal angle excursions reach ±36°
- Maximum torque of ~ 50 mNm required
- Simulations were used in an iterative process to determine the best trade in performance/hardware design
- Sizing a CMG, is a trade between the CMG mass, average slew rate requirement, maximum gimbal rate, singularity avoidance and hardware constraints
- Theoretical work indicates some of the benefits of the CMGs for small satellites:
– Torque/slew rate capability
– Angular Momentum capability
- Based on the CMG simulations, the CMG design parameters are specified

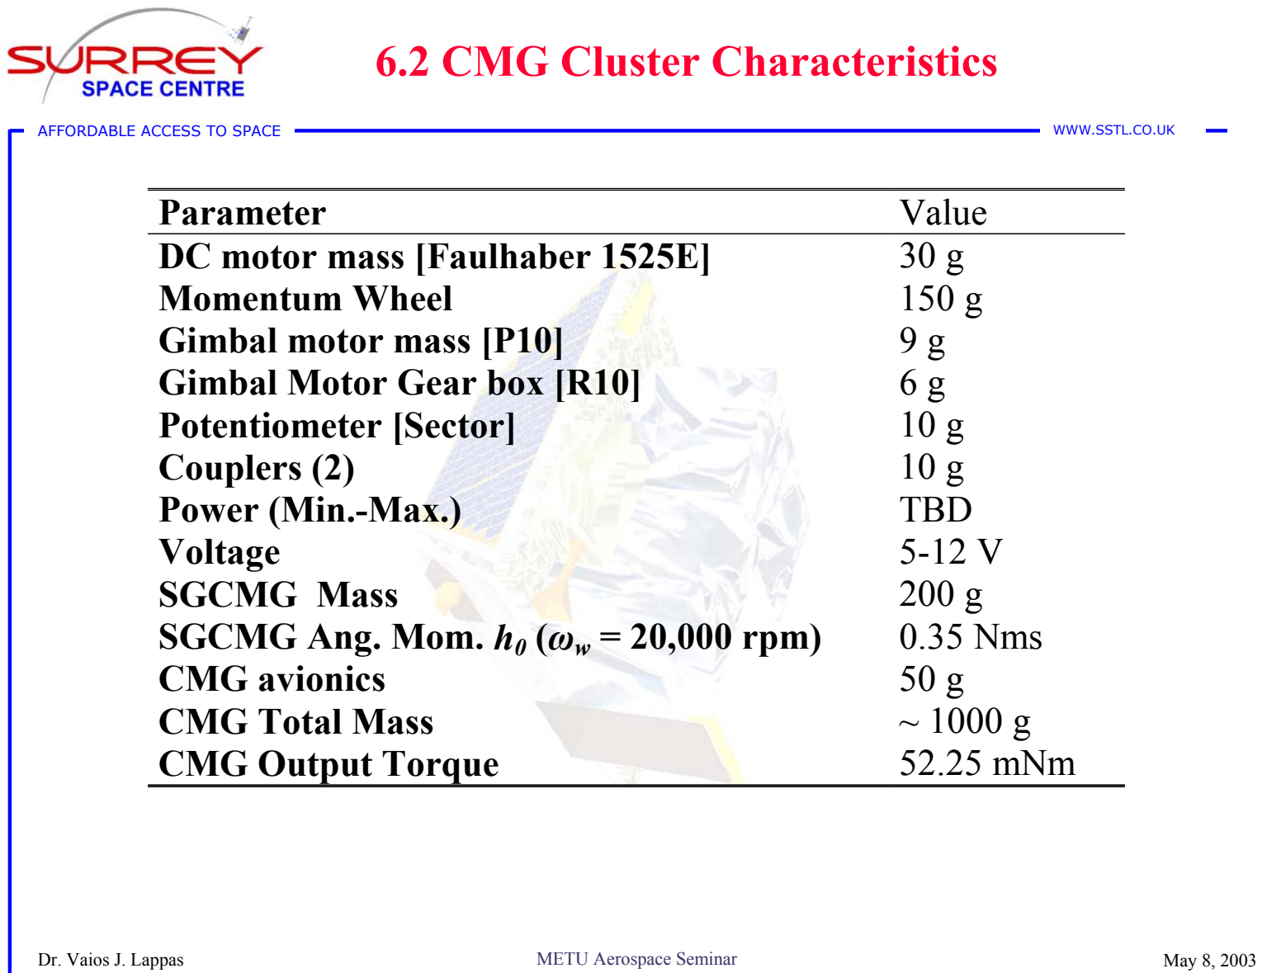
[picture p165: page 31]

AFFORDABLE ACCESS TO SPACE | WWW.SSTL.CO.UK

### 6.2 CMG Cluster Characteristics

Parameter | Value
DC motor mass [Faulhaber 1525E] | 30 g
Momentum Wheel | 150 g
Gimbal motor mass [P10] | 9 g
Gimbal Motor Gear box [R10] | 6 g
Potentiometer [Sector] | 10 g
Couplers (2) | 10 g
Power (Min.-Max.) | TBD
Voltage | 5-12 V
SGCMG Mass | 200 g
SGCMG Ang. Mom. h0 (ωw = 20,000 rpm) | 0.35 Nms
CMG avionics | 50 g
CMG Total Mass | ~ 1000 g
CMG Output Torque | 52.25 mNm

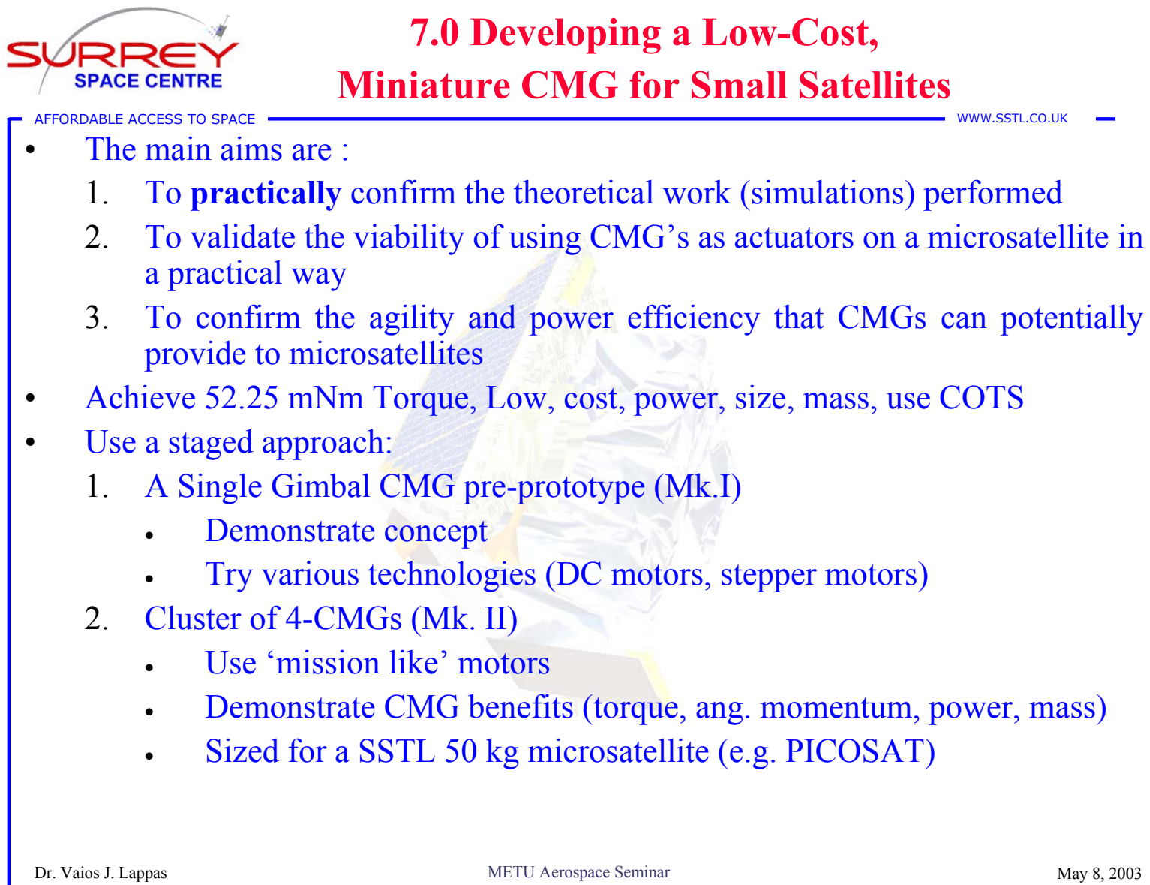
[picture p166: page 32]

AFFORDABLE ACCESS TO SPACE | WWW.SSTL.CO.UK

7.0 Developing a Low-Cost,

### Miniature CMG for Small Satellites

- The main aims are :
1. To practically confirm the theoretical work (simulations) performed
2. To validate the viability of using CMG’s as actuators on a microsatellite in a practical way
3. To confirm the agility and power efficiency that CMGs can potentially provide to microsatellites
- Achieve 52.25 mNm Torque, Low, cost, power, size, mass, use COTS
- Use a staged approach:
1. A Single Gimbal CMG pre-prototype (Mk.I)
- Demonstrate concept
- Try various technologies (DC motors, stepper motors)
2. Cluster of 4-CMGs (Mk. II)
- Use ‘mission like’ motors
- Demonstrate CMG benefits (torque, ang. momentum, power, mass)
- Sized for a SSTL 50 kg microsatellite (e.g. PICOSAT)

AFFORDABLE ACCESS TO SPACE | WWW.SSTL.CO.UK

### 7.1 CMG Mk.I Testbed

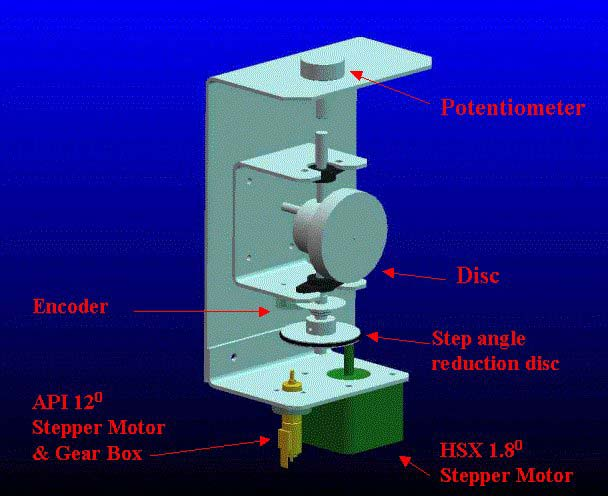
[picture p167: figure]

AFFORDABLE ACCESS TO SPACE | WWW.SSTL.CO.UK

### 7.2 CMG Mk.I

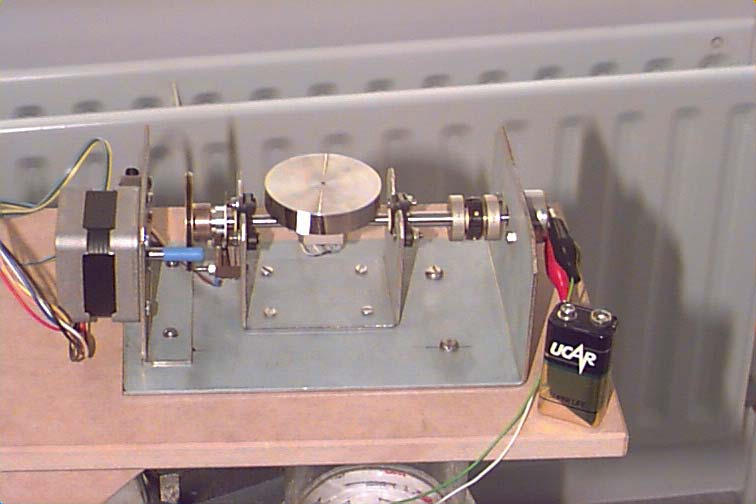
[picture p168: figure]

AFFORDABLE ACCESS TO SPACE | WWW.SSTL.CO.UK

### 7.3 Air Bearing Experiments

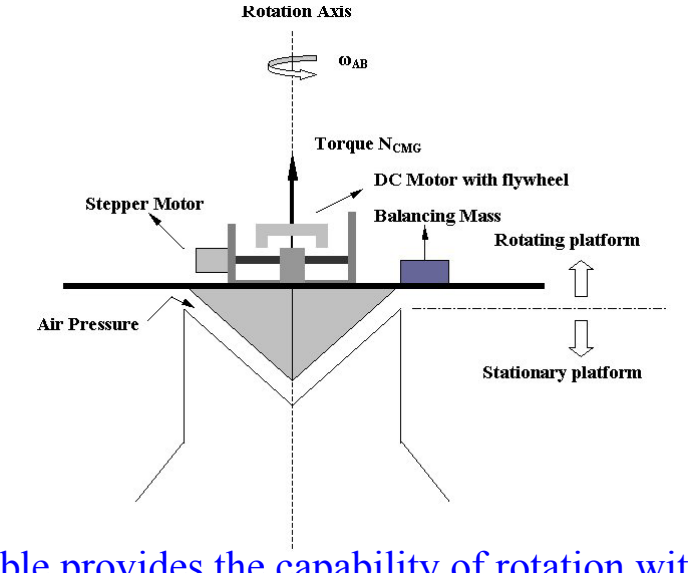
[picture p169: figure]

- Air-bearing table provides the capability of rotation without significant friction
- Used to test the dynamic characteristics and performance of a model satellite control system during the pre-launch experimental testing campaign on the ground
- Suspended by air, allows nearly frictionless rotation

AFFORDABLE ACCESS TO SPACE | WWW.SSTL.CO.UK

### 7.4 CMG Mk.I Experiment (I)

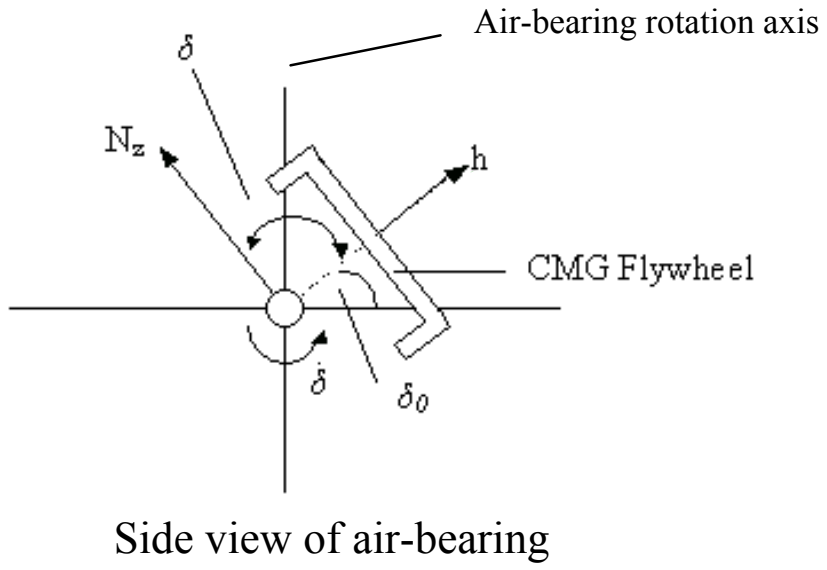
[picture p170: figure]
Air-bearing rotation axis; Side view of air-bearing

- Operate CMG from a known angle θ0 of 25° between the spin axis and the horizontal
- Perform a 50° excursion and return to its initial position
- This will generate a rotation about the air-bearing rotation axis

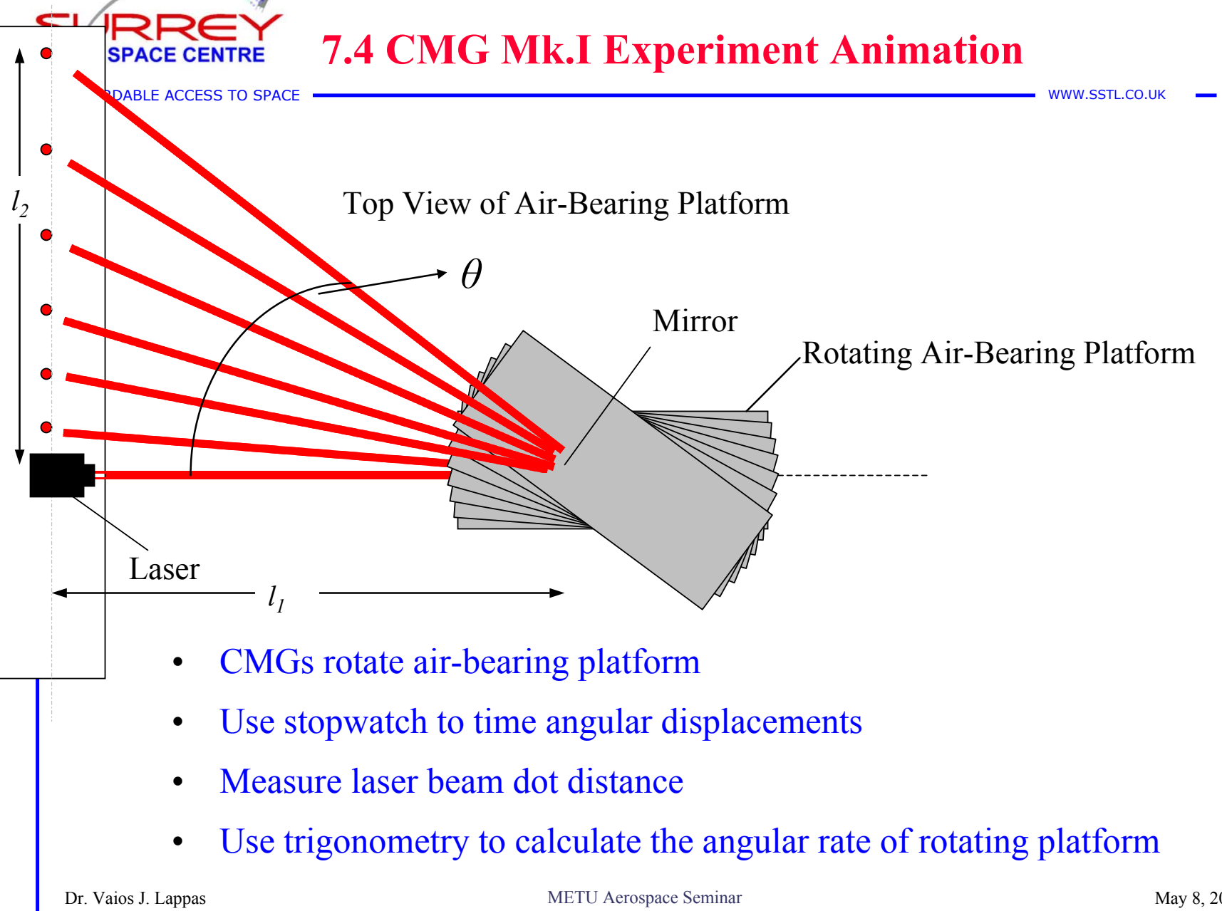
[picture p171: figure]
AFFORDABLE ACCESS TO SPACE; WWW.SSTL.CO.UK; Laser; Top View of Air-Bearing Platform; 7.4 CMG Mk.I Experiment Animation; Rotating Air-Bearing Platform; Mirror; • CMGs rotate air-bearing platform; • Measure laser beam dot distance

- Use stopwatch to time angular displacements
- Use trigonometry to calculate the angular rate of rotating platform

AFFORDABLE ACCESS TO SPACE | WWW.SSTL.CO.UK

### 7.4 CMG Mk.I Testing (IV)

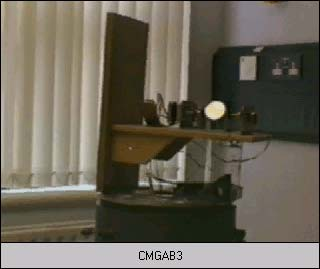
[picture p172: figure]

Rotation of CMG & rotation platform (NCMG=8.84 mNm)

### 7.4 CMG Mk.I Testing (IV)

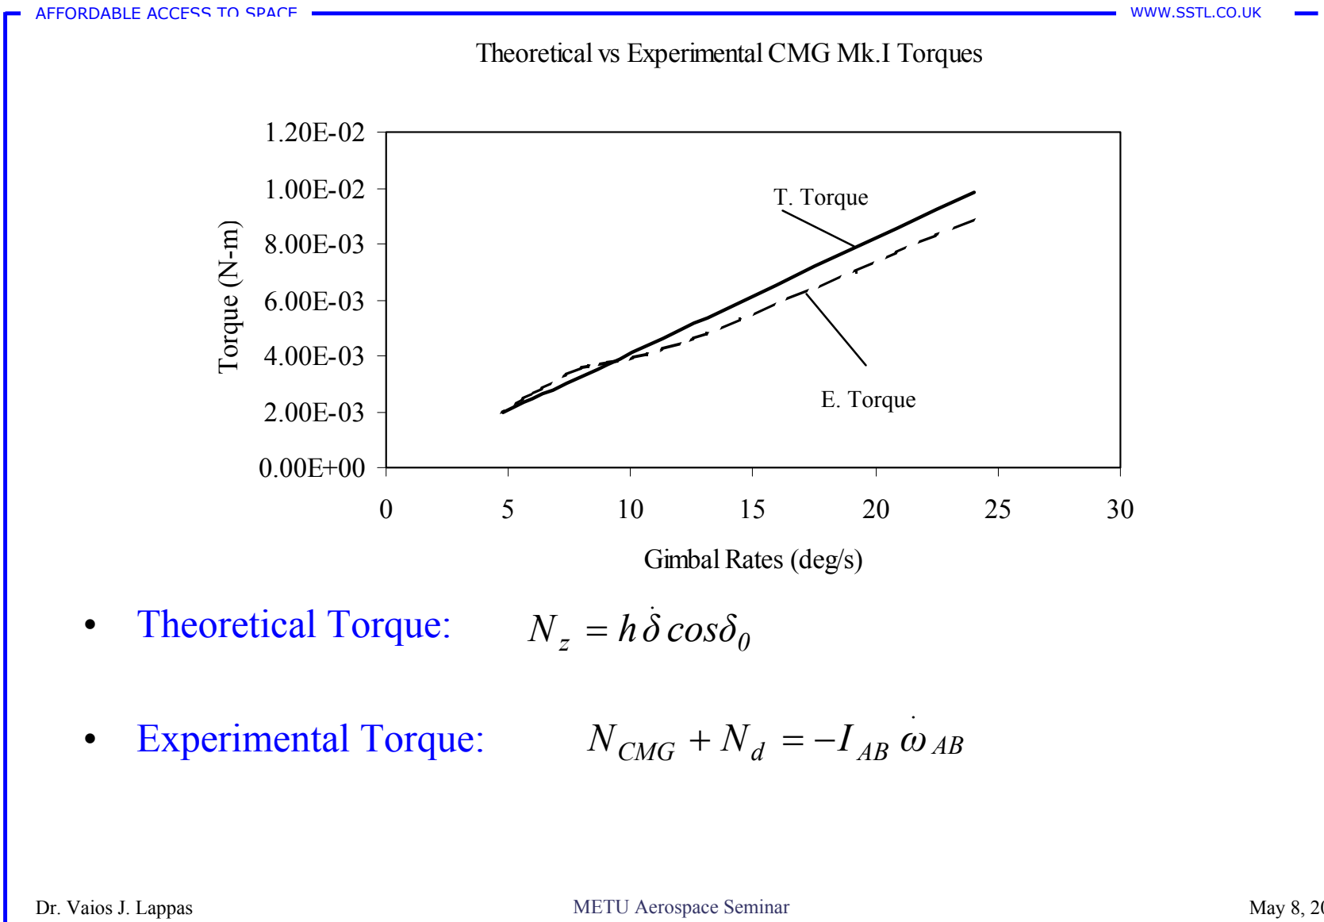
[picture p173: figure]
AFFORDABLE ACCESS TO SPACE; WWW.SSTL.CO.UK; • Theoretical Torque:; • Experimental Torque:; Gimbal Rates (deg/s); Torque (N-m; . z N = h δ cosδ; . NCMG + Nd = −I AB ω; E. Torque; T. Torque

Theoretical vs Experimental CMG Mk.I Torques

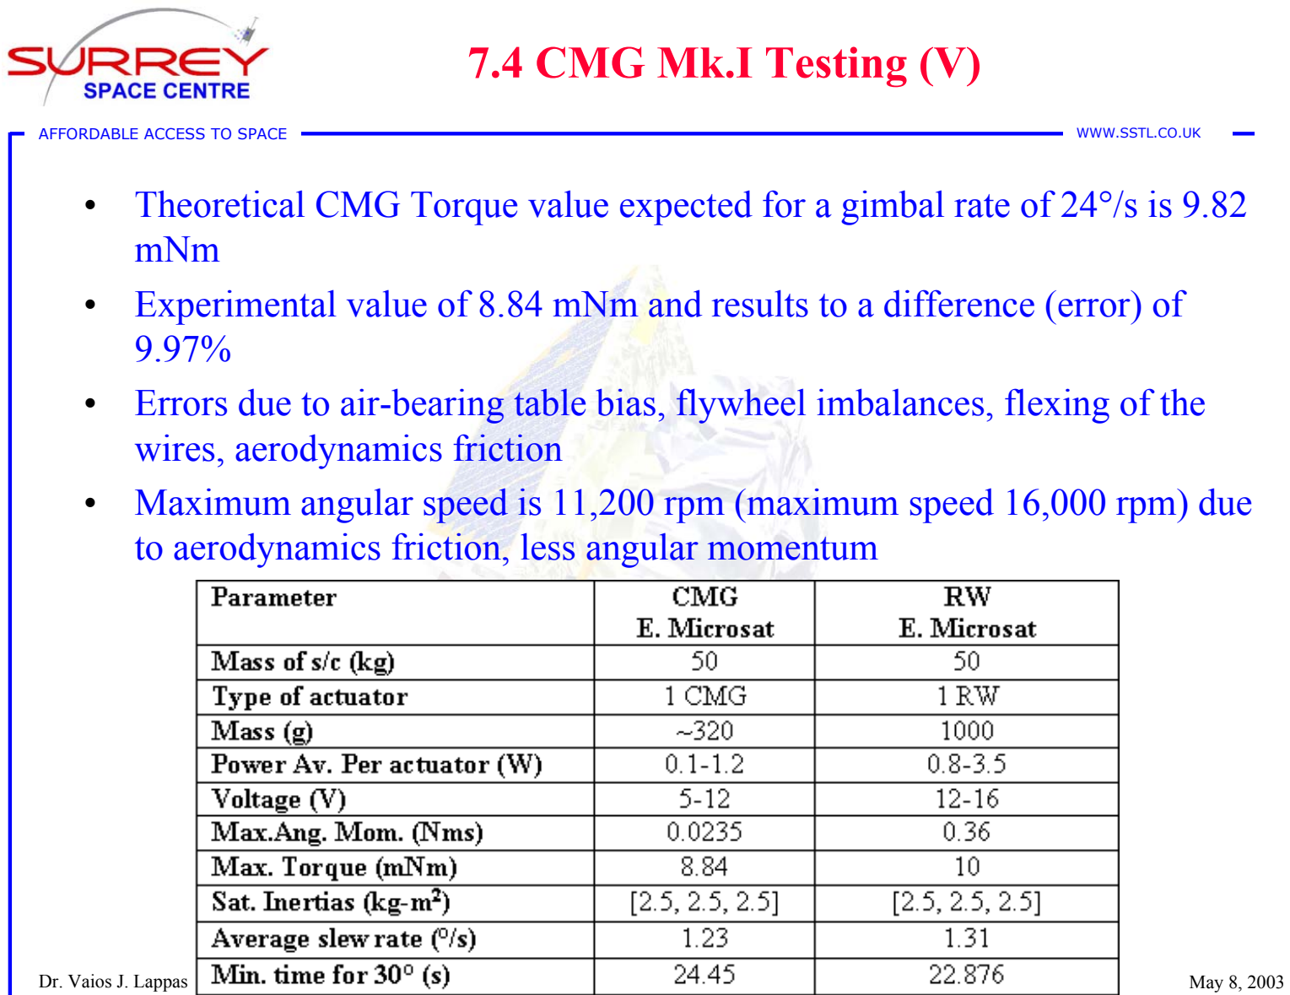
[picture p174: page 40]

AFFORDABLE ACCESS TO SPACE | WWW.SSTL.CO.UK

### 7.4 CMG Mk.I Testing (V)

- Theoretical CMG Torque value expected for a gimbal rate of 24°/s is 9.82 mNm
- Experimental value of 8.84 mNm and results to a difference (error) of 9.97%
- Errors due to air-bearing table bias, flywheel imbalances, flexing of the wires, aerodynamics friction
- Maximum angular speed is 11,200 rpm (maximum speed 16,000 rpm) due to aerodynamics friction, less angular momentum

AFFORDABLE ACCESS TO SPACE | WWW.SSTL.CO.UK

### 7.5 CMG Mk.II

- Having tested the capability of the Mk.I CMG, another CMG is designed as part of a 4-CMG cluster, the CMG Mk.II. The CMG Mk.II utilizes:
– A different and more powerful BLDC motor with integrated electronics (Faulhaber 1525 BRE)
– A larger flywheel (angular momentum), properly sized to generate the required torque on the Mk.II CMG (ICMG = 1.7 x 10⁻⁴ kg-m²)
– The same stepper/gimbal motor (Escap P010/R10) as in the Mk.I
– New electronics based on a C515 Microcontroller
- Components (motors etc.) can be space graded
- CMG Cluster performance is evaluated through air-bearing experiments

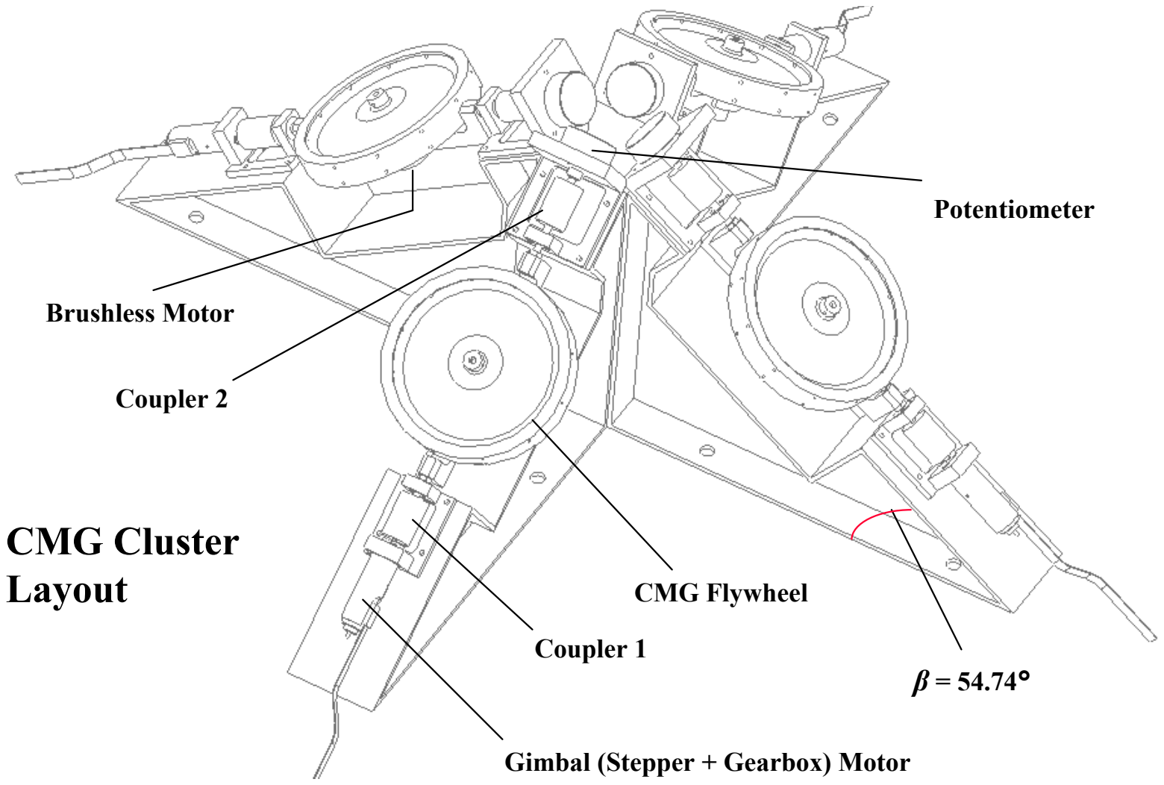
[picture p175: page 42]

AFFORDABLE ACCESS TO SPACE | WWW.SSTL.CO.UK

Gimbal (Stepper + Gearbox) Motor

Coupler 1

CMG Flywheel

β = 54.74°

Coupler 2

Potentiometer

Brushless Motor

### CMG Cluster Layout

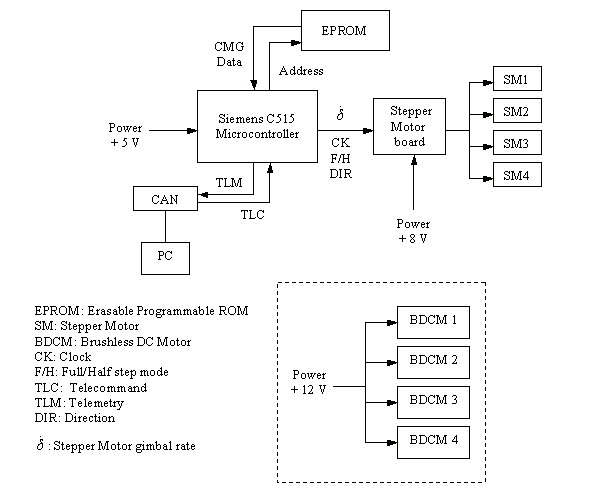
[picture p176: figure]

AFFORDABLE ACCESS TO SPACE | WWW.SSTL.CO.UK

### 7.5 CMG Mk.II Electronics

AFFORDABLE ACCESS TO SPACE | WWW.SSTL.CO.UK

### 7.6 Single-axis maneuvre with two CMGs

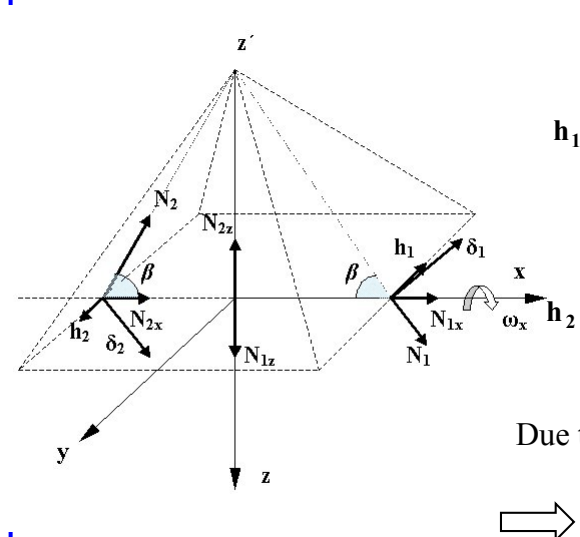
[picture p177: figure]

− − = | δ | β δ δ | β sin sin cos sin cos 1 | 1 1 0 h h1 | = - δ | β 0 - δ | β .1.1 cos sin . δ1 | 1 . 1x | 0 1 N = h δ cosβcosδ
−− = | δ | β δ δ | β sin | sin cos sin | cos 2 2 2 h2 | h0 | = δ | β 0 - δ | β .2.2cos sin . δ2 | 2 . 2x | 0 2 N = h δ cosβcosδ
Due to symmetric rotation | and δ1 = δ2 | :
2
1 δ = δ = δ

N h δ c βcosδ

x

= 2 0 os

AB

NCMG + Nd = −I AB ω

N h δ c βcosδ

Theoretical CMG Torque = | x = 2 0 | os

Experimental CMG Torque =

- IAB = 0.8 kg-m²

AFFORDABLE ACCESS TO SPACE | WWW.SSTL.CO.UK

### 7.7 Experimental Set-up Block Diagram

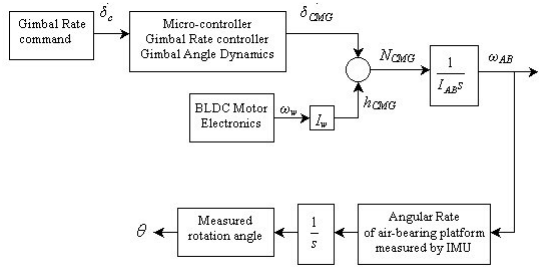
[picture p178: figure]

AFFORDABLE ACCESS TO SPACE | WWW.SSTL.CO.UK

### 7.8 Experimental Set-up

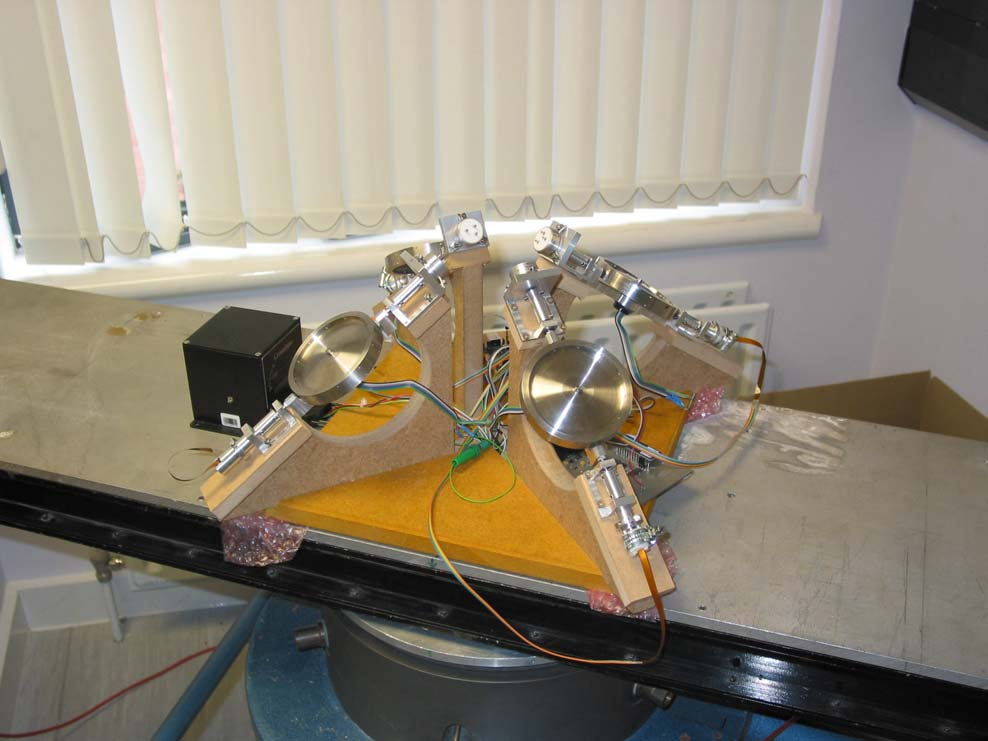
[picture p179: figure]

AFFORDABLE ACCESS TO SPACE | WWW.SSTL.CO.UK

### 7.9 CMG Mk.II Experiment

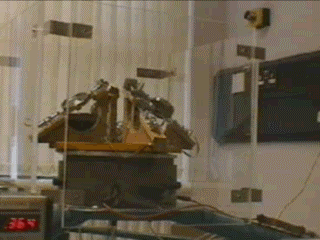
[picture p180: figure]
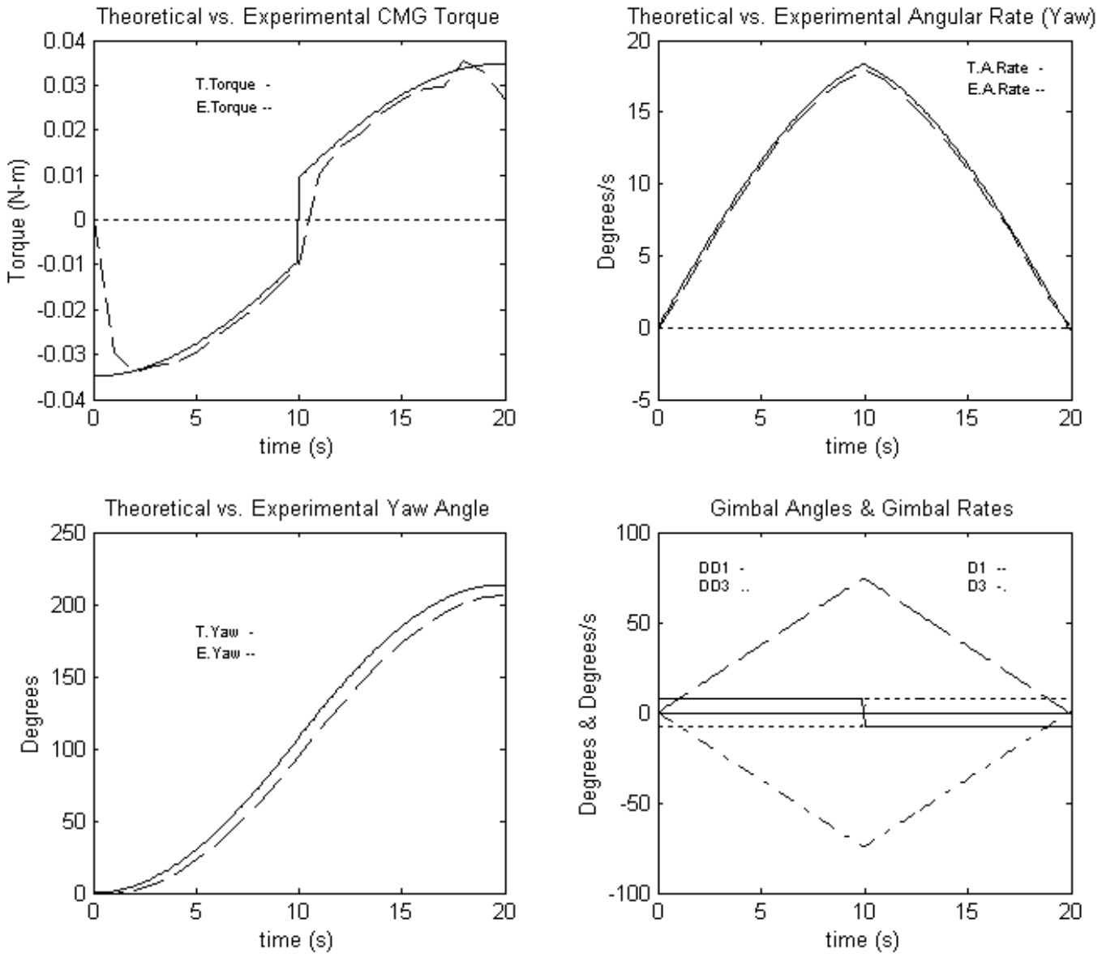
[picture p181: page 48]

AFFORDABLE ACCESS TO SPACE | WWW.SSTL.CO.UK

AFFORDABLE ACCESS TO SPACE | WWW.SSTL.CO.UK

### 7.9 CMG Mk.II Results

- Do not take under consideration the wheel and gimbal motor dynamics, or any other internal disturbances such as motor cogging or torque ripple effects
- Torque error reaches a maximum of 0.006 Nm and this is mainly due to:
– The disturbances that affect the CMG cluster on the air-bearing (air-bearing bias, aerodynamic friction)
– High bandwidth-mechanical reasons (CMG stepper motor backlash, micro vibrations, wheel imbalances and small wheel speed variations)
– IMU-Gyro noise
- The rotation angle θ expected from simulations is 218.4º whereas the experimental value attained is 209.8º
- Open-loop maneuver and the disturbance effects of the air-bearing result to an acceptable error of 8.6º

AFFORDABLE ACCESS TO SPACE | WWW.SSTL.CO.UK

### 7.10 Electrical Power Consumption

- Electrical power consumption is important small satellite development and operations
- Literature, such as [Schaub 1998], [Schaub 2000], [Roser 1997], [Salenc 2000] mention that CMGs require less electrical power than other actuators such as reaction/momentum wheels
- No theoretical or practical support to this claim
- A comparison is conducted to compare RW vs. CMG power consumption
- A microsatellite 10 mNm RW, minisatellite 20 mNm RW and 52.25 mNm CMG (2)
- 40º single-axis maneuvre (1 RW, 2 CMGs) for all 3 actuators/platforms
- In-orbit data used for RWs (Tsinghua-1 RW, UoSAT-12 RW) and vacuum power measurements for CMG
- Measurements are normalised to a 1 kg-m² MOI
- Energy index is introduced to compare actuators

### 7.11 CMG Electrical Power Consumption

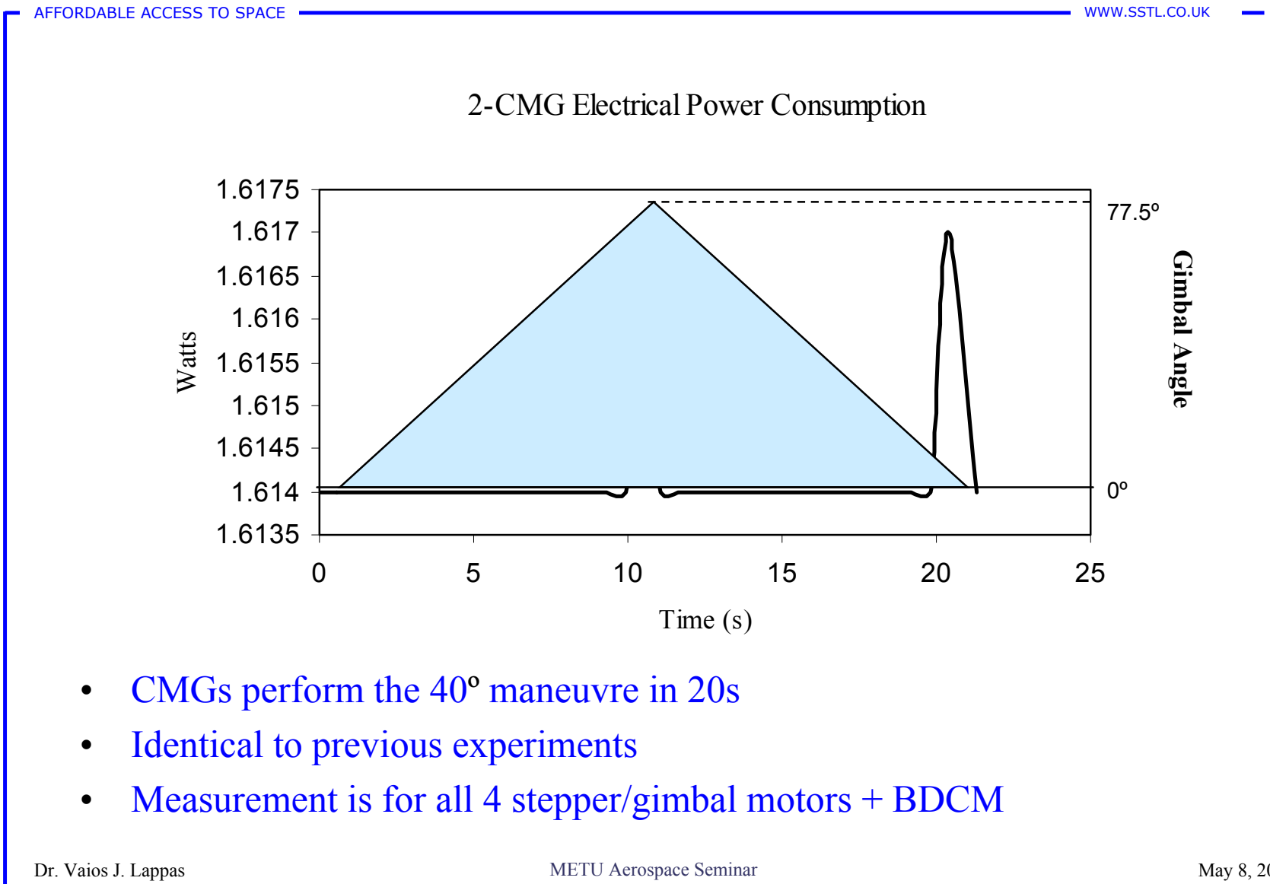
[picture p182: figure]
AFFORDABLE ACCESS TO SPACE; WWW.SSTL.CO.UK; 2-CMG Electrical Power Consumption; Time (s); Watts; Gimbal Angle; • CMGs perform the 40º maneuvre in 20s • Identical to previous experiments

- Measurement is for all 4 stepper/gimbal motors + BDCM

AFFORDABLE ACCESS TO SPACE | WWW.SSTL.CO.UK

### 7.12 RW Electrical Power Consumption

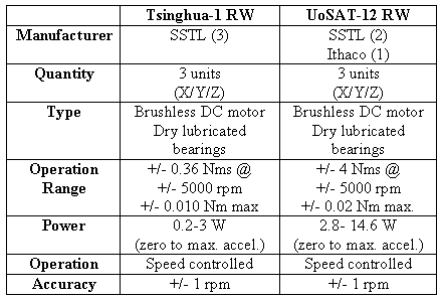
[picture p183: figure]
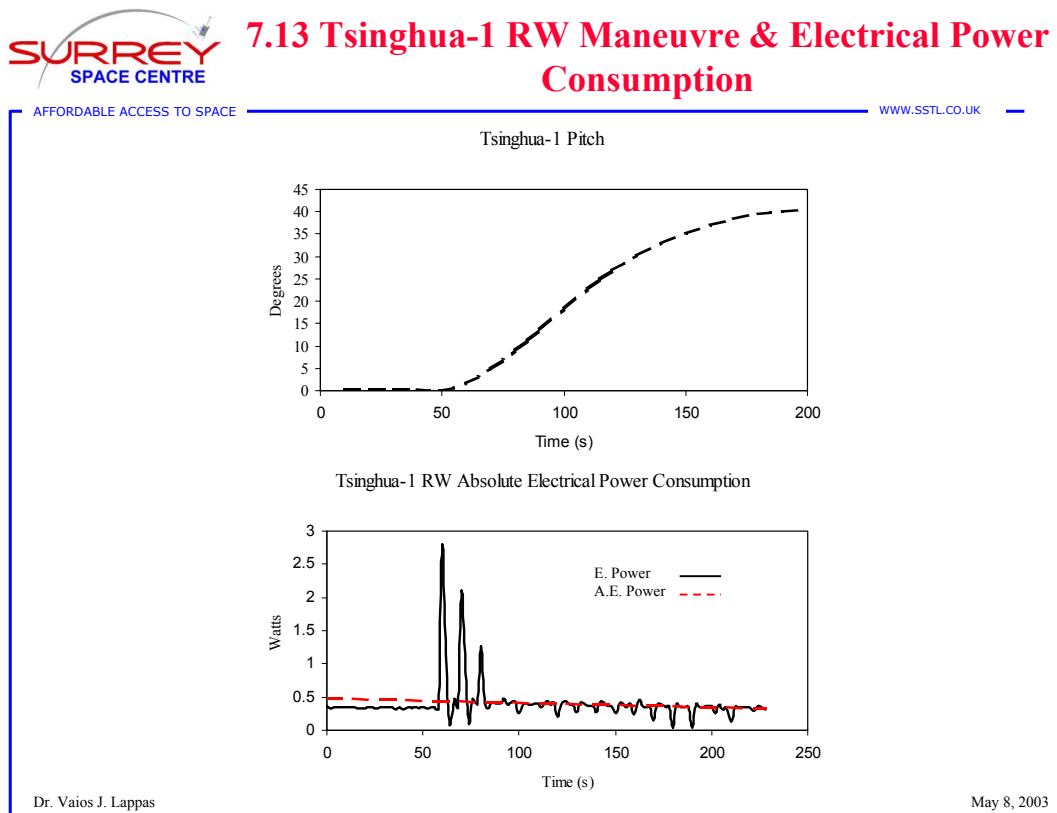
[picture p184: page 53]
AFFORDABLE ACCESS TO SPACE; WWW.SSTL.CO.UK; Consumption; Tsinghua-1 Pitch; Time (s); Degrees; Watts; E. Power A.E. Power

7.13 Tsinghua-1 RW Maneuvre & Electrical Power

Tsinghua-1 RW Absolute Electrical Power Consumption

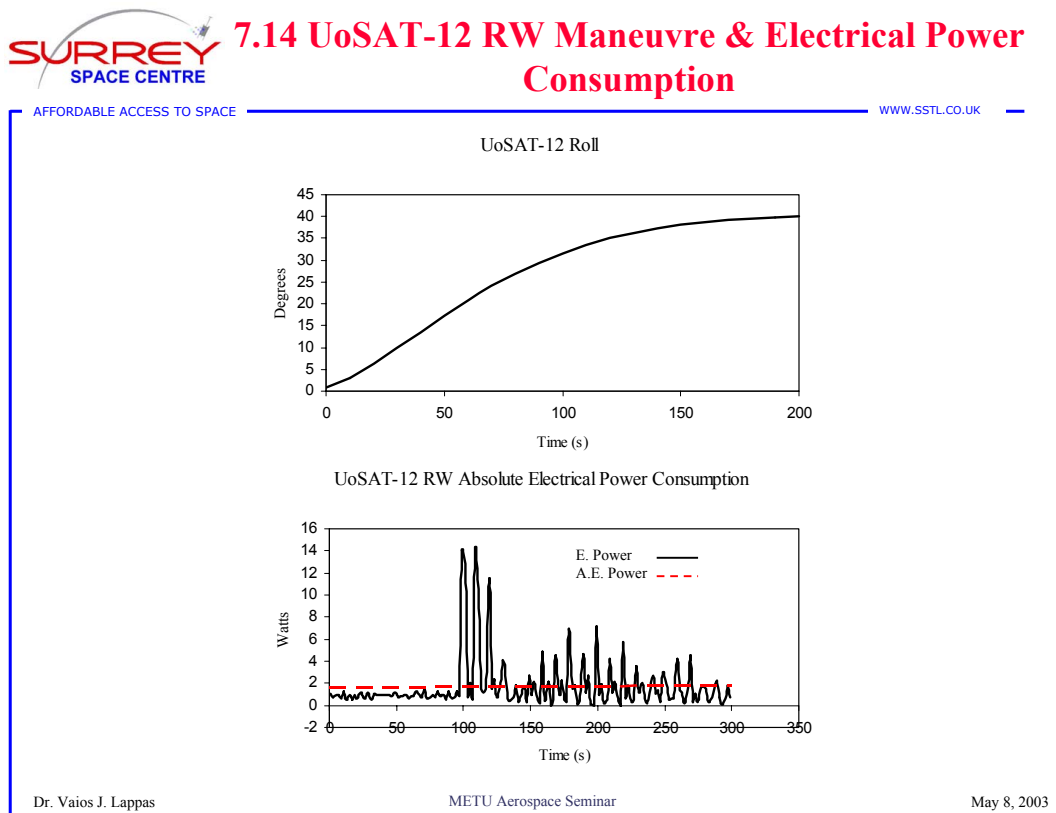
[picture p185: page 54]
AFFORDABLE ACCESS TO SPACE; WWW.SSTL.CO.UK; Consumption; UoSAT-12 Roll; Time (s); Degrees; Watts; E. Power A.E. Power

7.14 UoSAT-12 RW Maneuvre & Electrical Power

UoSAT-12 RW Absolute Electrical Power Consumption

AFFORDABLE ACCESS TO SPACE | WWW.SSTL.CO.UK

### 7.15 Electrical Power Consumption Experimental Data

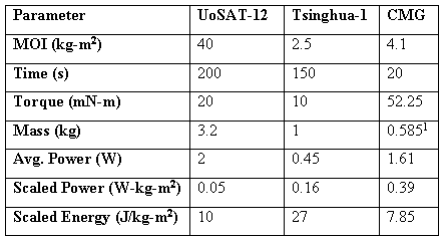
[picture p186: figure]

- 1Mass for two CMGs, unpackaged
- Single axis 40° maneuvre
- Energy index reflects the energy accumulated during a maneuvre on a normalized 1 kg-m² MOI platform
- CMGs prove to be the least power consuming actuator with an energy index of 7.85
- 21.5 % more efficient than the UoSAT-12 RW power consumption and 70.9 % more efficient than the Tsinghua-1 RW

AFFORDABLE ACCESS TO SPACE | WWW.SSTL.CO.UK

### 7.16 CMG Experiments – Some Conclusions

- Practical work confirms the theoretical findings on the advantageous use and performance of CMGs for agile small satellites
- Two CMGs designed (Mk.I, Mk.II)
- CMGs were evaluated in air-bearing experiments replicating single-axis maneuvers
- CMG Mk.I generated a max.torque of 8.84 mNm, CMG Mk.II a max. torque of 38 mNm, during air-bearing experiments
- Experiments indicate the better electrical power consumption when utilizing a CMG cluster when compared to a RW system
- CMG Mk.II maximum power was found to be 1.614 W
- CMGs are shown to be more power efficient by at least 21.5 % from reaction wheels, with a mass saving of 41.5 % to the smallest (Tsinghua-1) RW
- With a mass of about 1.17 kg CMGs were shown in a practical way to potentially be an efficient and highly capable means of controlling agile microsatellites

AFFORDABLE ACCESS TO SPACE | WWW.SSTL.CO.UK

## 8. Application: BILSAT CMG

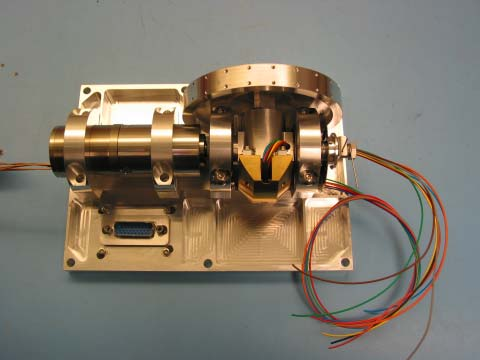
[picture p187: figure]

AFFORDABLE ACCESS TO SPACE | WWW.SSTL.CO.UK

## CMGs for BILSAT-1

### - TUBITAK-BILTEN initiated a call for Turkish and SSTL payloads for BILSAT-1 - Numerous payloads suggested - Payloads selected:

– Turkish: Coban, Gezgin
– SSTL: Propulsion, GPS Attitude Determination – SSC/SSTL: CMGs…

### - Payload Selection: September 2001 - Unofficial approval for CMGs: June 2002 - Time to design CMGs: 6 months ! (not…!) - Payload: A twin (2)-CMG cluster for rapid pitch axis control

# BILSAT Payloads

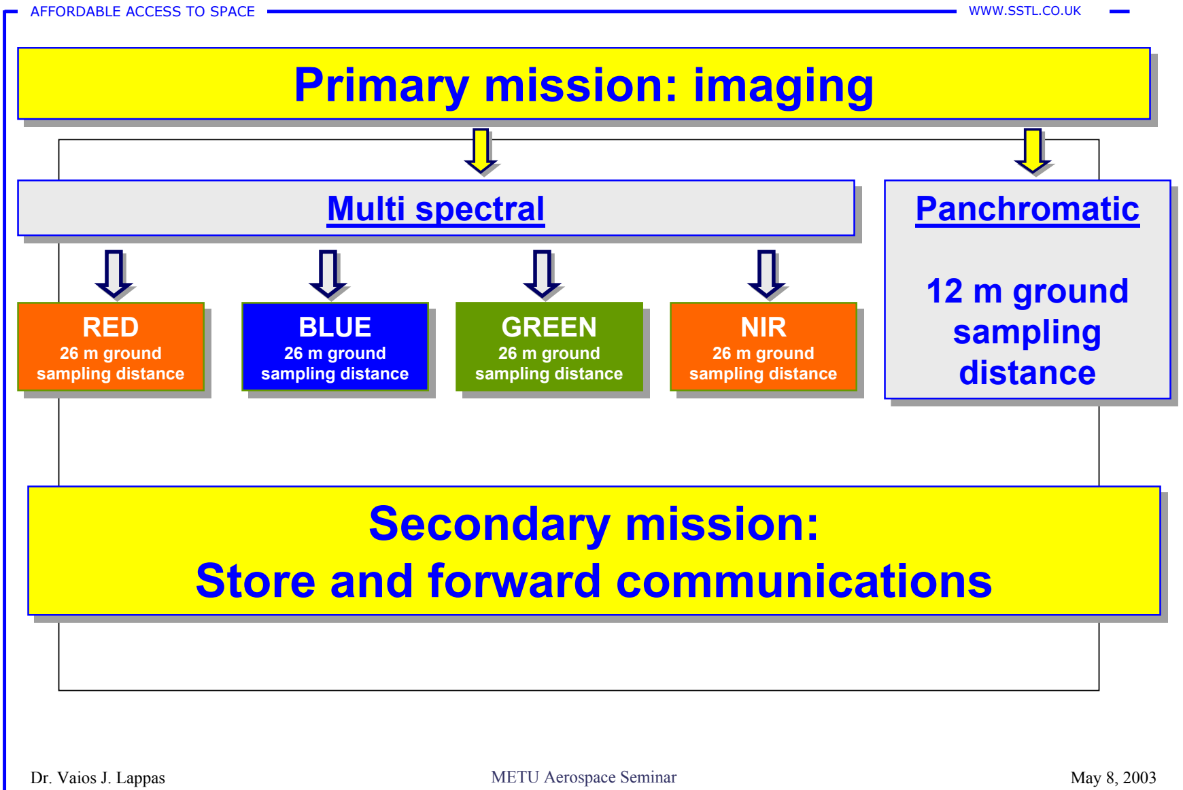
[picture p188: figure]
AFFORDABLE ACCESS TO SPACE; WWW.SSTL.CO.UK; Primary mission: imaging; Multi spectral Multi spectral; RED; 26 m ground sampling distance; BLUE; GREEN; NIR; Panchromatic; 12 m ground sampling distance; Secondary mission: Store and forward communications

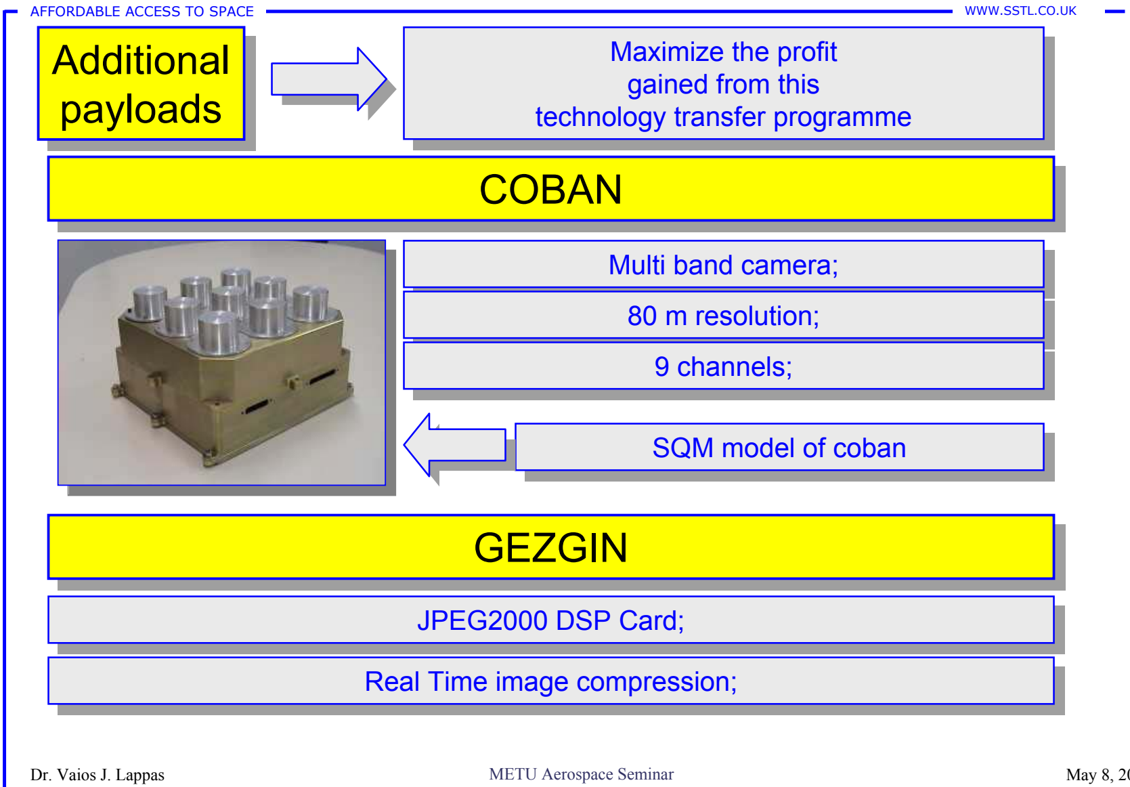
[picture p189: figure]
Additional payloads; Maximize the profit gained from this technology transfer programme; Maximize the profit gained from this technology transfer programme COBAN COBAN; Multi band camera; Multi band camera;; 80 m resolution; 80 m resolution;; 9 channels; 9 channels;; SQM model of coban SQM model of coban; GEZGIN GEZGIN; JPEG2000 DSP Card;

AFFORDABLE ACCESS TO SPACE | WWW.SSTL.CO.UK

## BILSAT Additional Payloads (I)

Real Time image compression; Real Time image compression;

## BILSAT Additional Payloads (II)

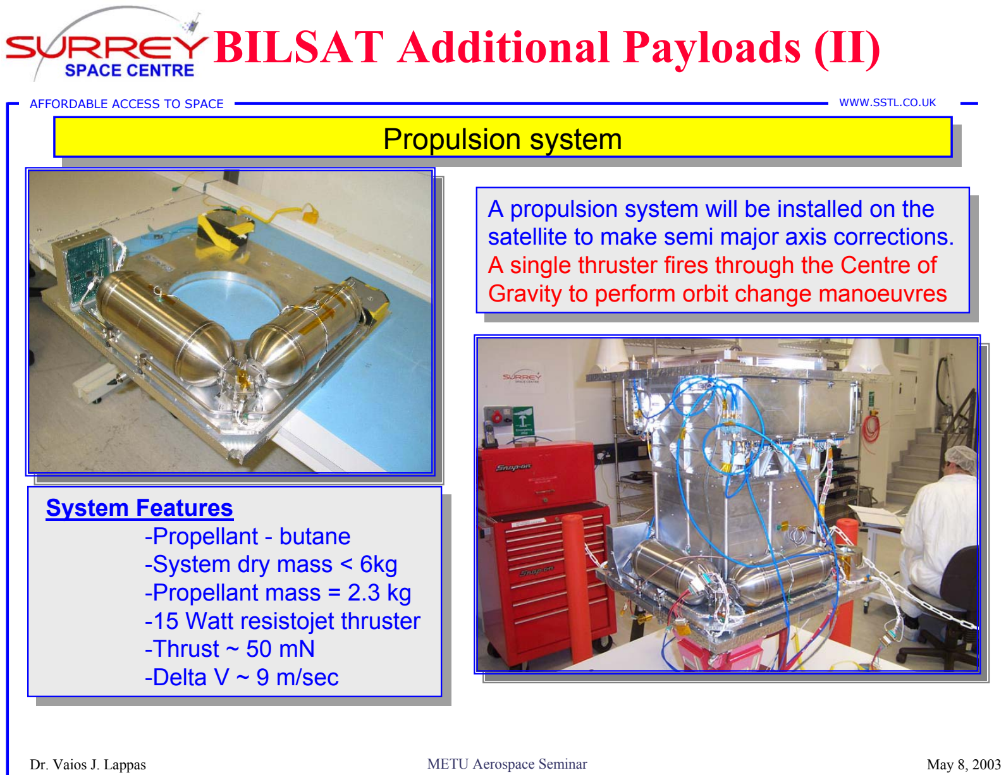
[picture p190: page 61]

AFFORDABLE ACCESS TO SPACE | WWW.SSTL.CO.UK
Propulsion system Propulsion system

A propulsion system will be installed on the satellite to make semi major axis corrections. A single thruster fires through the Centre of Gravity to perform orbit change manoeuvres

A propulsion system will be installed on the satellite to make semi major axis corrections. A single thruster fires through the Centre of Gravity to perform orbit change manoeuvres

System Features
-Propellant - butane
-System dry mass < 6kg
-Propellant mass = 2.3 kg
-15 Watt resistojet thruster -Thrust ~ 50 mN
-Delta V ~ 9 m/sec

System Features
-Propellant - butane
-System dry mass < 6kg
-Propellant mass = 2.3 kg
-15 Watt resistojet thruster -Thrust ~ 50 mN
-Delta V ~ 9 m/sec

## BILSAT Additional Payloads (III)

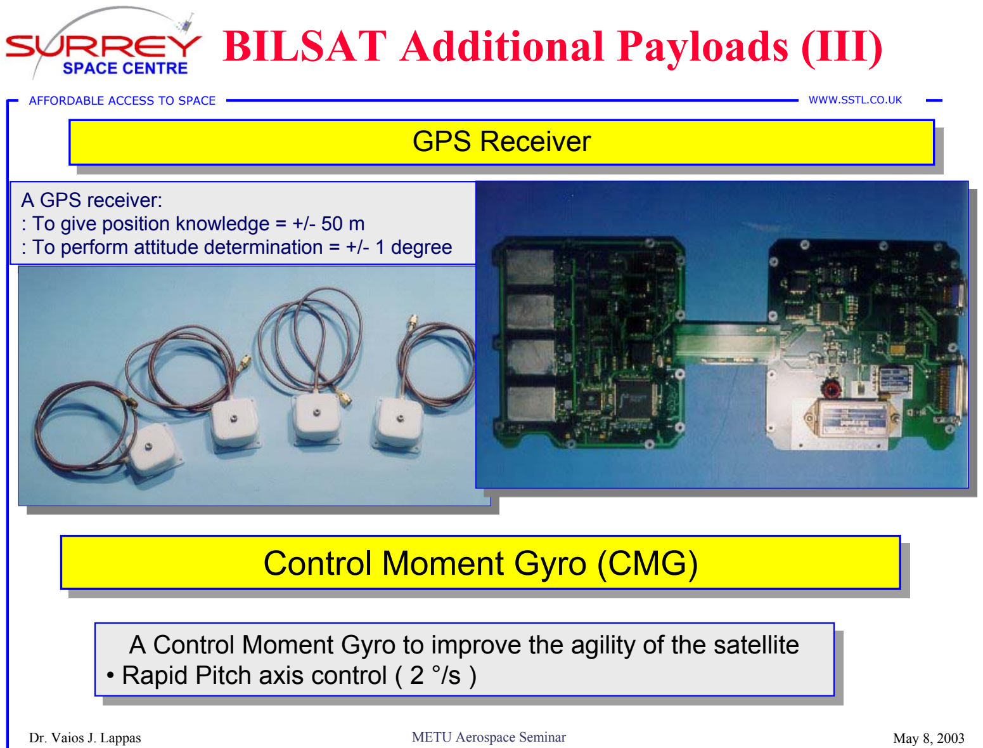
[picture p191: page 62]

AFFORDABLE ACCESS TO SPACE | WWW.SSTL.CO.UK
GPS Receiver GPS Receiver

A GPS receiver:
: To give position knowledge = +/- 50 m
: To perform attitude determination = +/- 1 degree

A GPS receiver:
: To give position knowledge = +/- 50 m
: To perform attitude determination = +/- 1 degree

### Control Moment Gyro (CMG) Control Moment Gyro (CMG)

A Control Moment Gyro to improve the agility of the satellite
- Rapid Pitch axis control ( 2 °/s )

A Control Moment Gyro to improve the agility of the satellite
- Rapid Pitch axis control ( 2 °/s )

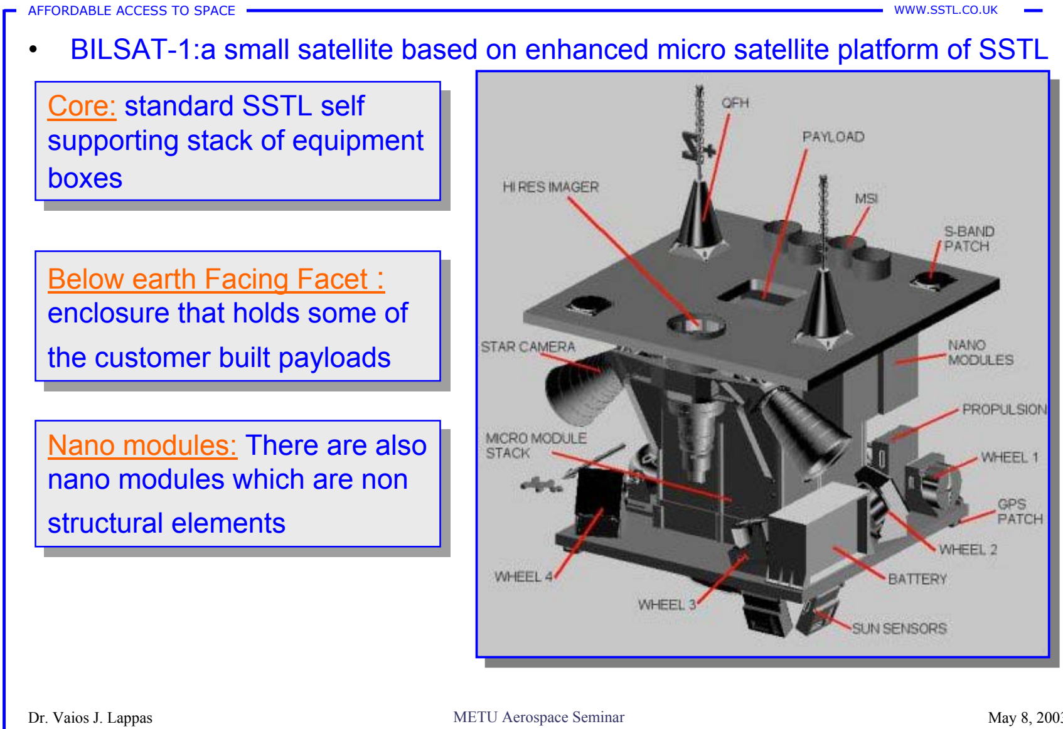
[picture p192: figure]
Core: standard SSTL self supporting stack of equipment boxes; Below earth Facing Facet : enclosure that holds some of the customer built payloads; Nano modules: There are also nano modules which are non structural elements

AFFORDABLE ACCESS TO SPACE | WWW.SSTL.CO.UK

## BILSAT-1 Satellite Architecture

- BILSAT-1:a small satellite based on enhanced micro satellite platform of SSTL

# BILSAT-1 Project Status

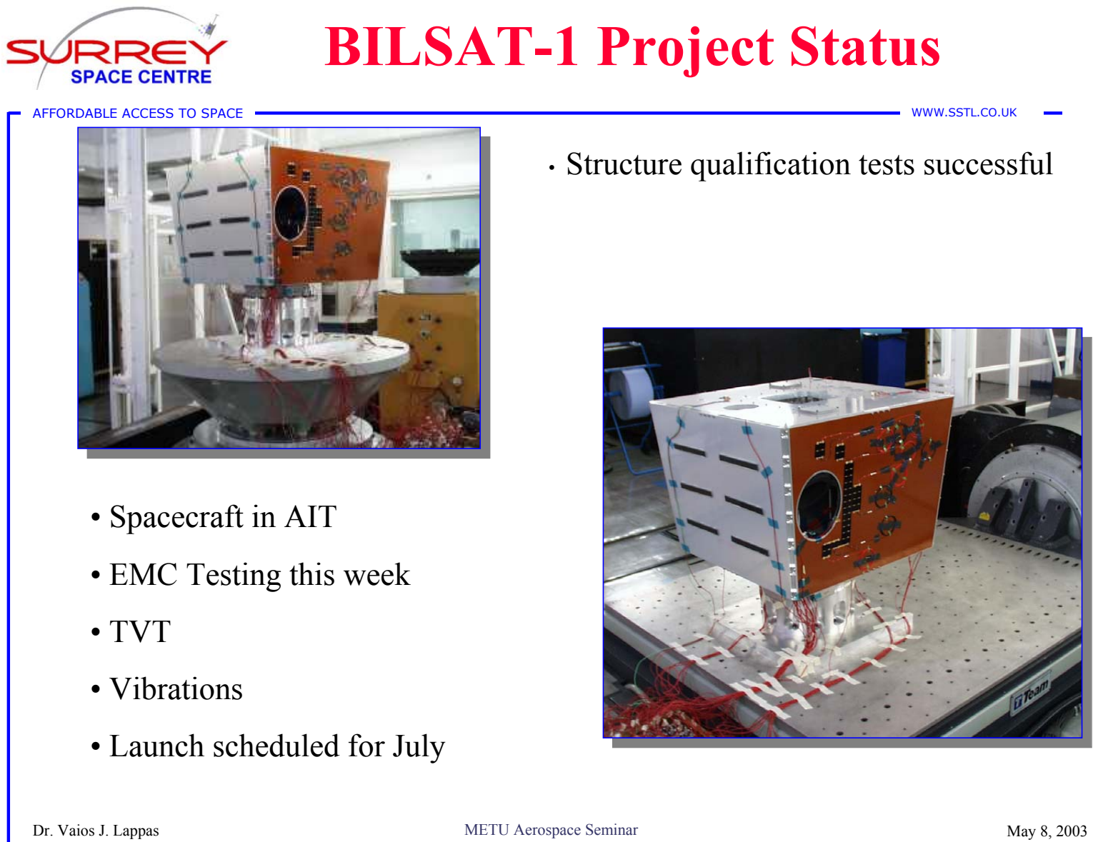
[picture p193: page 64]

AFFORDABLE ACCESS TO SPACE | WWW.SSTL.CO.UK
- Structure qualification tests successful
- Spacecraft in AIT
- EMC Testing this week
•TVT
•Vibrations
- Launch scheduled for July

AFFORDABLE ACCESS TO SPACE | WWW.SSTL.CO.UK

# BILSAT Attitude Determination and Control System (ADCS)

## BILSAT ADCS Subsystem (I)

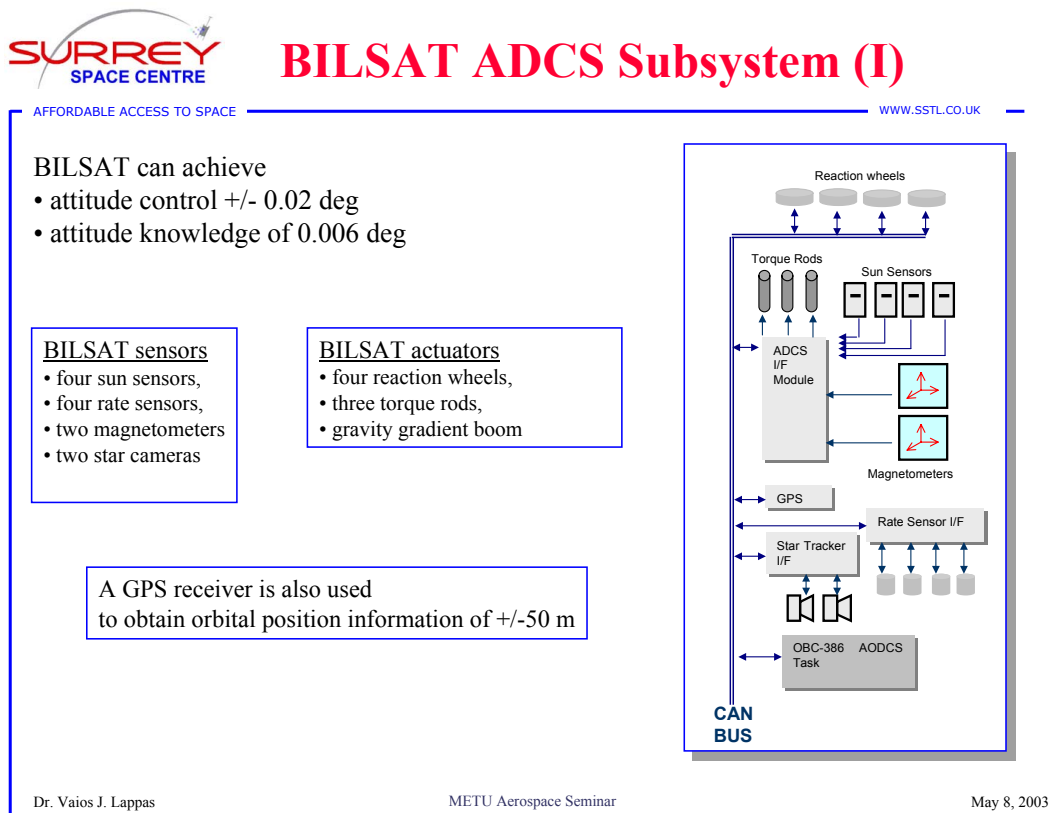
[picture p194: page 66]
AFFORDABLE ACCESS TO SPACE; WWW.SSTL.CO.UK; Reaction wheels; ADCS I/F Module; Torque Rods; Sun Sensors; Magnetometers; Star Tracker I/F; OBC-386 AODCS Task; GPS GPS; CAN BUS

BILSAT can achieve
• attitude control +/- 0.02 deg
• attitude knowledge of 0.006 deg

BILSAT sensors
• four sun sensors,
• four rate sensors,
• two magnetometers
• two star cameras

BILSAT actuators
• four reaction wheels,
• three torque rods,
• gravity gradient boom

Rat Ratee S Seensnsor or I/I/FF

A GPS receiver is also used
to obtain orbital position information of +/-50 m

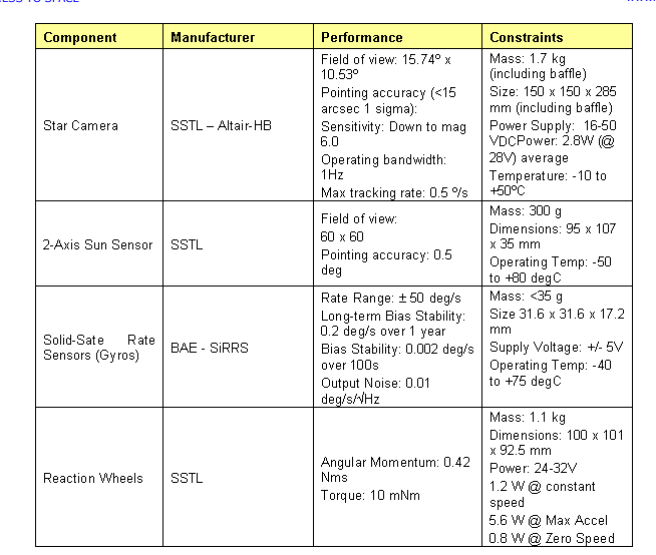
[picture p195: figure]

AFFORDABLE ACCESS TO SPACE | WWW.SSTL.CO.UK

## BILSAT ADCS Subsystem (II)

AFFORDABLE ACCESS TO SPACE | WWW.SSTL.CO.UK

# CMG Design

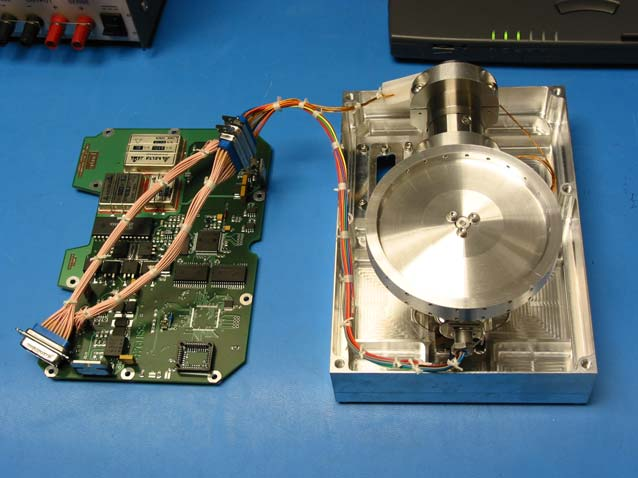
[picture p196: figure]

AFFORDABLE ACCESS TO SPACE | WWW.SSTL.CO.UK

# BILSAT CMG

### - Attitude Actuator

– High torque capability, High stability
– Exceptional performance for small satellite
– Fast slews (30deg in 15s for 130kg spacecraft)
– E.g for tactical imaging, TDI, target tracking
– Developed by University of Surrey/SSTL/ESA/BILTEN – First flight on BILSAT Q3 2003

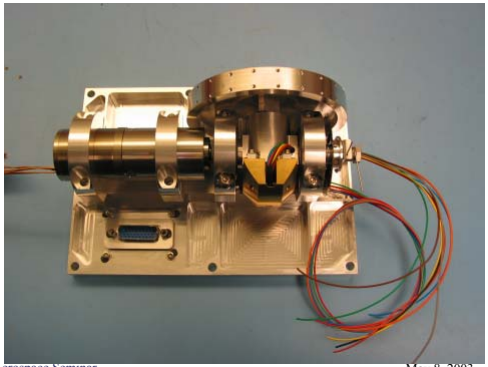
[picture p197: figure]

Dimensions | 135 x 155 x 190 mm
Mass | 2.2kg
Power | 12W peak
Torque | 95mNm

AFFORDABLE ACCESS TO SPACE | WWW.SSTL.CO.UK

# BILSAT CMG Requirements

### - 2°/s average slew rate capability (pitch axis) - Demonstrate the principle of a CMG - Has to fit in the available volume on BILSAT-1 - Mass ≤ 1.5kg per CMG

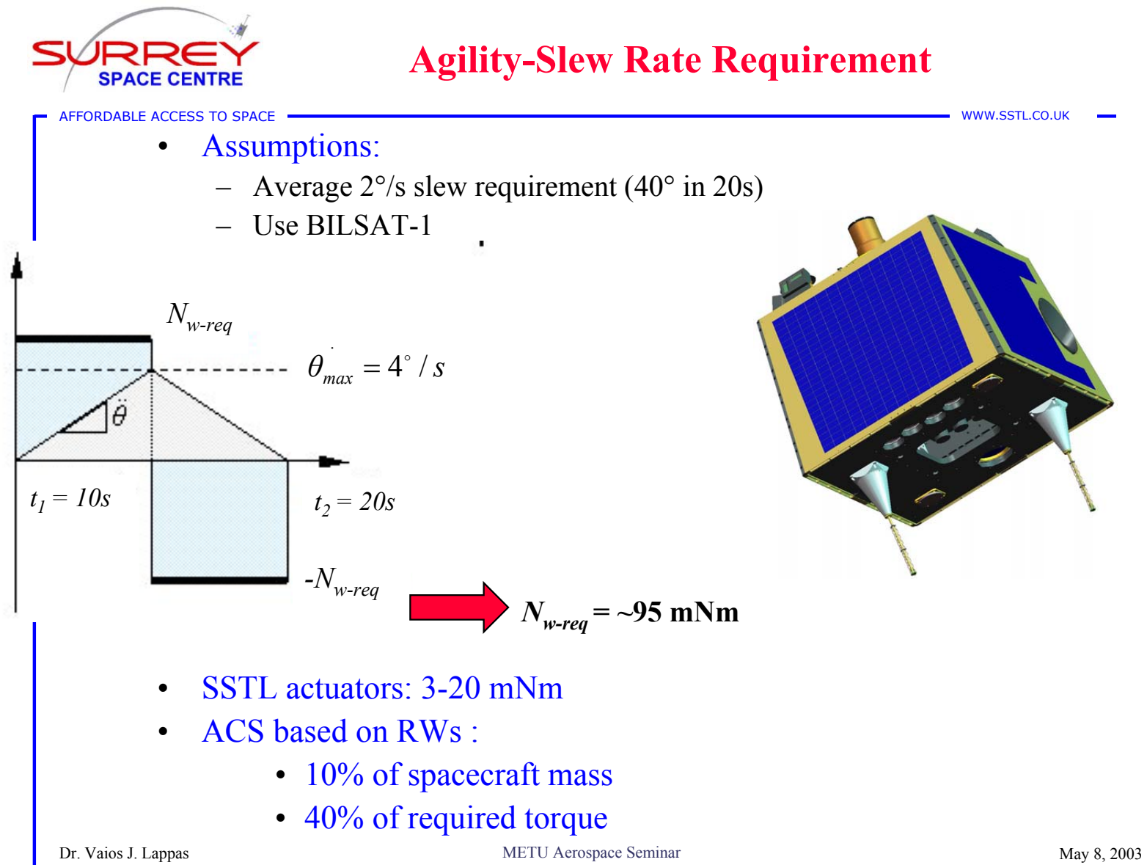
[picture p198: page 71]

AFFORDABLE ACCESS TO SPACE | WWW.SSTL.CO.UK

### Agility-Slew Rate Requirement

- Assumptions:
– Average 2°/s slew requirement (40° in 20s) –Use BILSAT-1

Nw-req = ~95 mNm

- SSTL actuators: 3-20 mNm
- ACS based on RWs :
- 10% of spacecraft mass
- 40% of required torque
t1 = 10s | t2 = 20s

-Nw-req

Nw-req
θ | s
max 4 / D =

AFFORDABLE ACCESS TO SPACE | WWW.SSTL.CO.UK

## BILSAT CMG Configuration

- For a 2°/s average slew rate capability (pitch axis) for a 130 kg platform, a 95 mNm torque is required

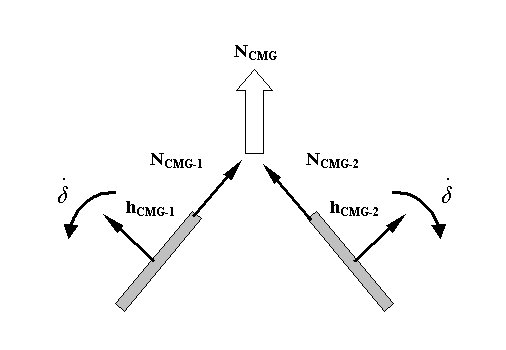
[picture p199: figure]

- Twin CMG payload in parallel configuration
- CMG h = 0.28 Nms, Flywheel speed operating at 16,900 rpm, gimbal rate of 9°/s
- Can vary flywheel speed and gimbal rate (> 9°/s)

# CMG Simulations

## CMG Simulations/Performance

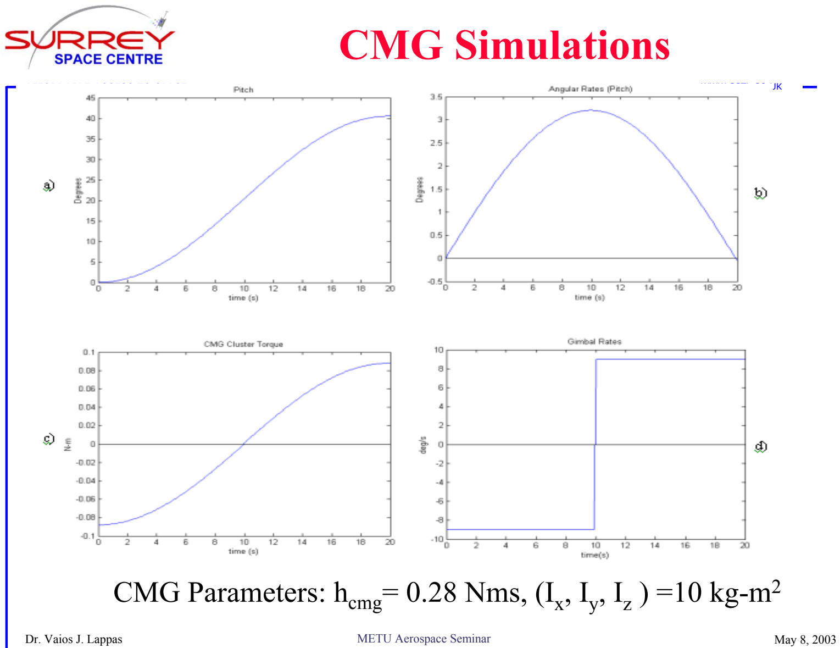
[picture p200: page 73]

AFFORDABLE ACCESS TO SPACE | WWW.SSTL.CO.UK

### CMG Parameters: hcmg= 0.28 Nms, (Ix, Iy, Iz ) =10 kg-m²

## CMG Electronics

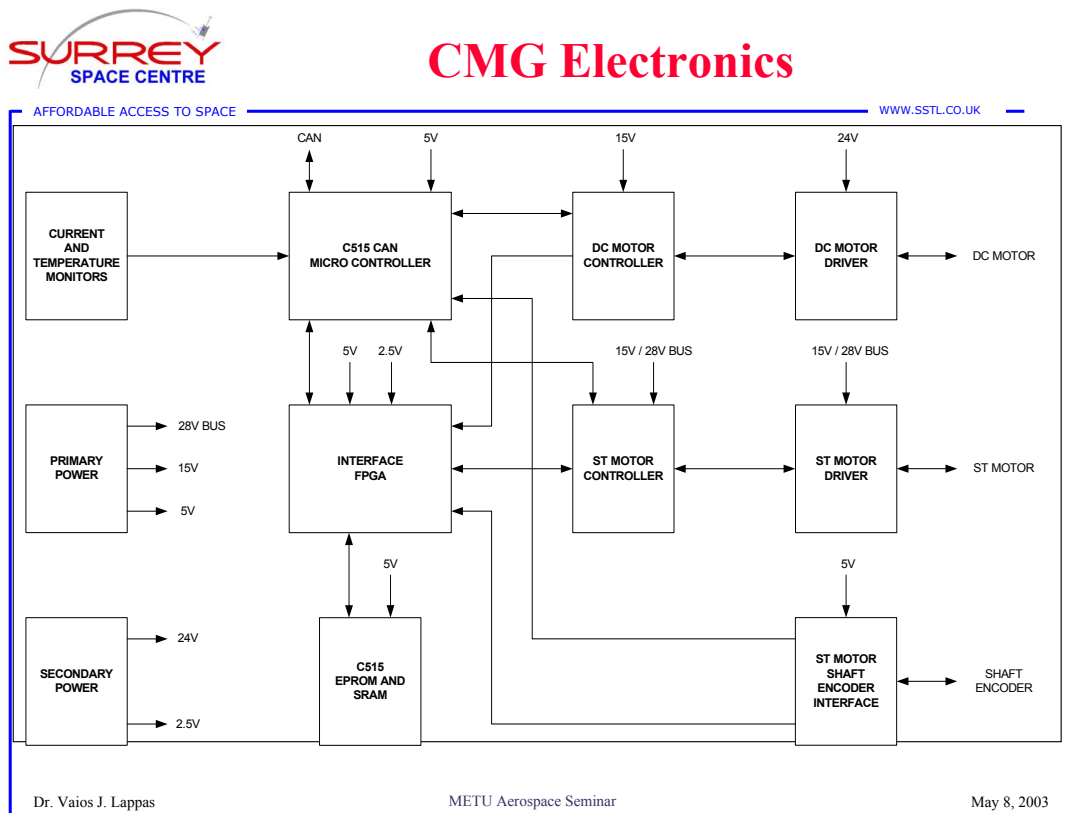
[picture p201: page 74]
AFFORDABLE ACCESS TO SPACE; WWW.SSTL.CO.UK; C515 CAN MICRO CONTROLLER; DC MOTOR CONTROLLER; DC MOTOR DRIVER; INTERFACE FPGA; ST MOTOR CONTROLLER; ST MOTOR DRIVER; C515 EPROM AND SRAM; CURRENT AND TEMPERATURE MONITORS; PRIMARY POWER; SECONDARY POWER; CAN; 28V BUS; 15V / 28V BUS; ST MOTOR SHAFT ENCODER INTERFACE; DC MOTOR; ST MOTOR; SHAFT ENCODER

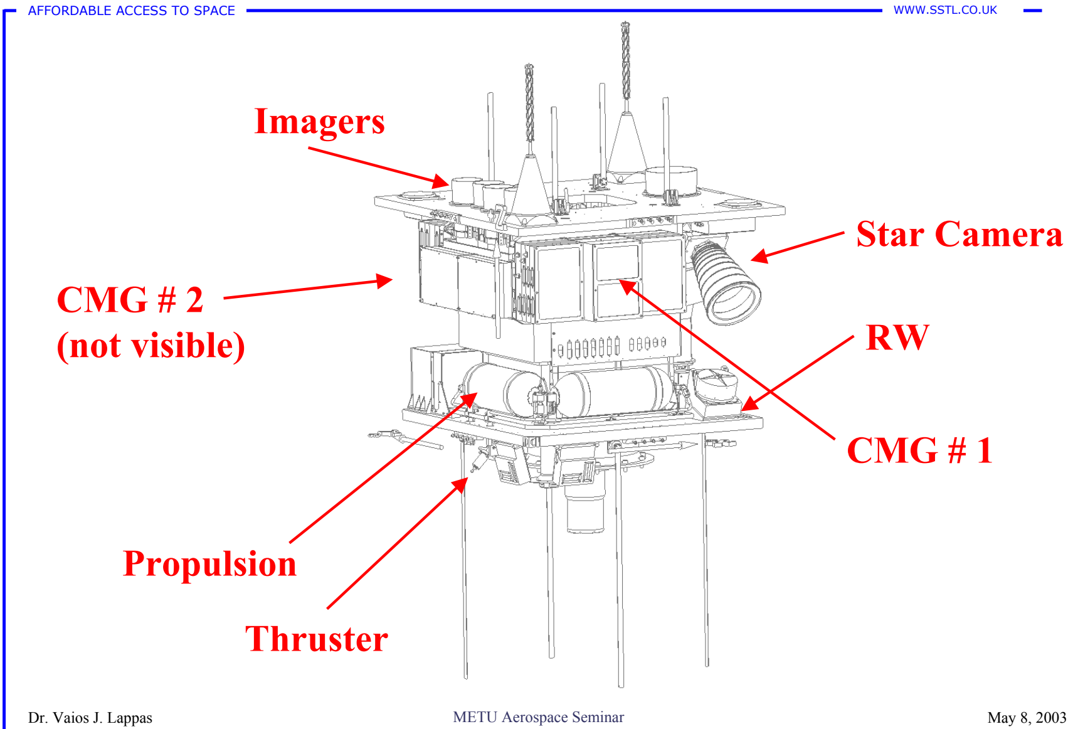
[picture p202: figure]
Propulsion; Thruster; Imagers; CMG # 2 (not visible); Star Camera; CMG # 1

AFFORDABLE ACCESS TO SPACE | WWW.SSTL.CO.UK

## CMG Mechanics

## CMG Mechanics

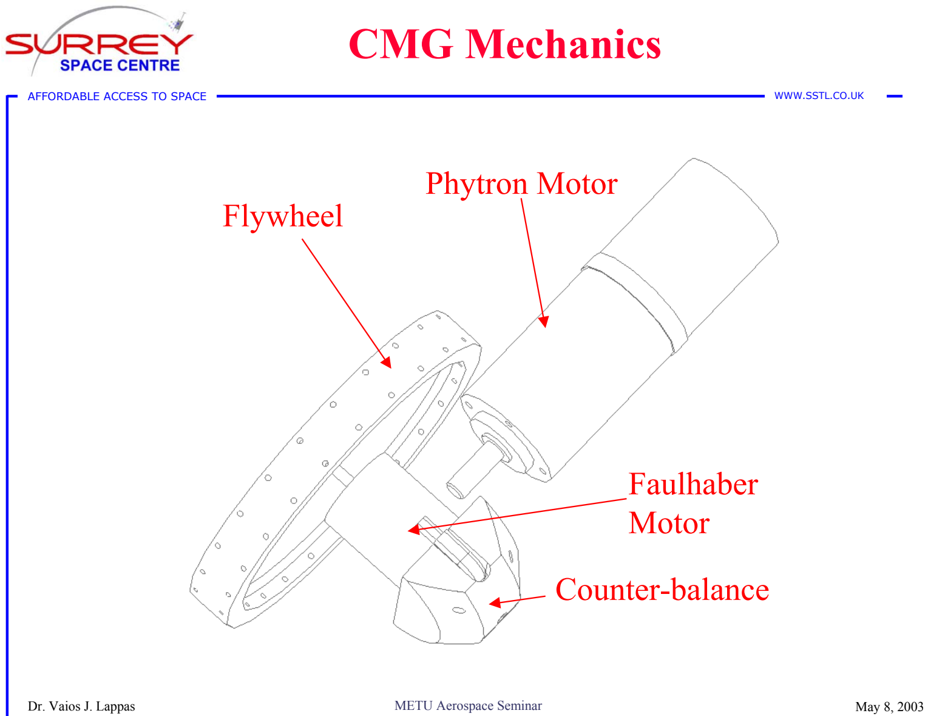
[picture p203: page 76]

AFFORDABLE ACCESS TO SPACE | WWW.SSTL.CO.UK

### Flywheel

### Phytron Motor

### Faulhaber Motor

### Counter-balance

## CMG Mechanics

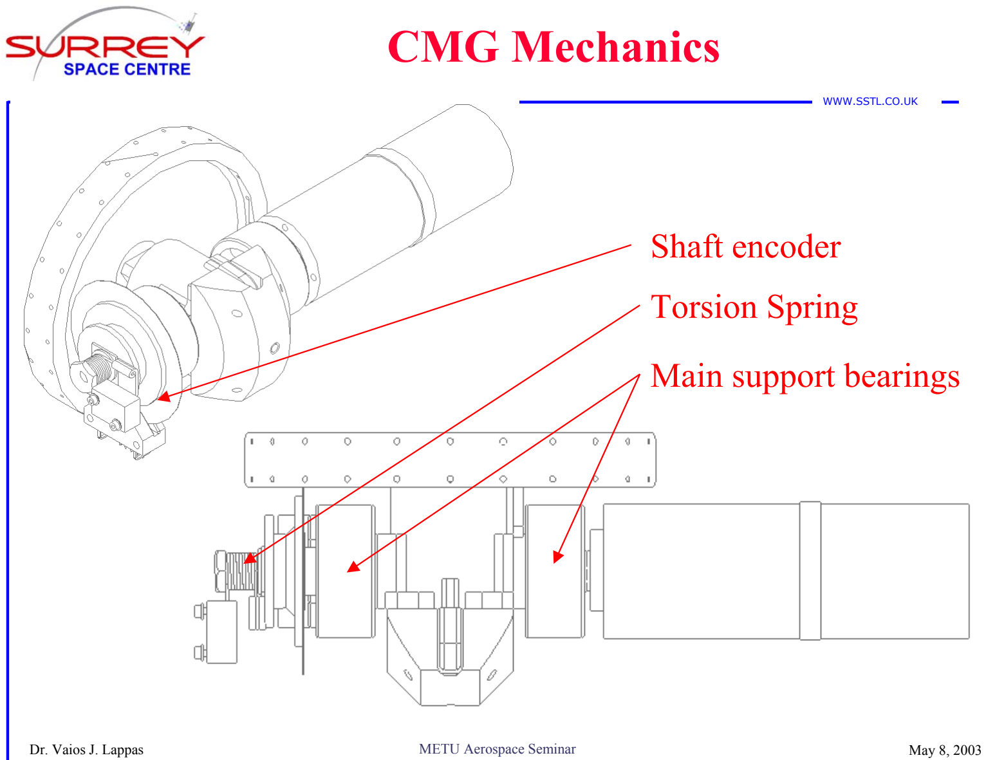
[picture p204: page 77]

AFFORDABLE ACCESS TO SPACE | WWW.SSTL.CO.UK

### Shaft encoder Torsion Spring

### Main support bearings

AFFORDABLE ACCESS TO SPACE | WWW.SSTL.CO.UK

## CMG Mechanics

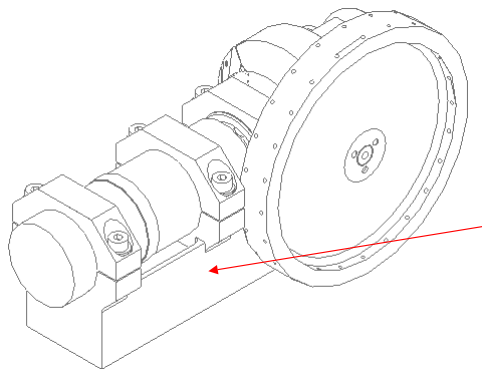
[picture p205: figure]

### Support structure

## CMG Mechanics

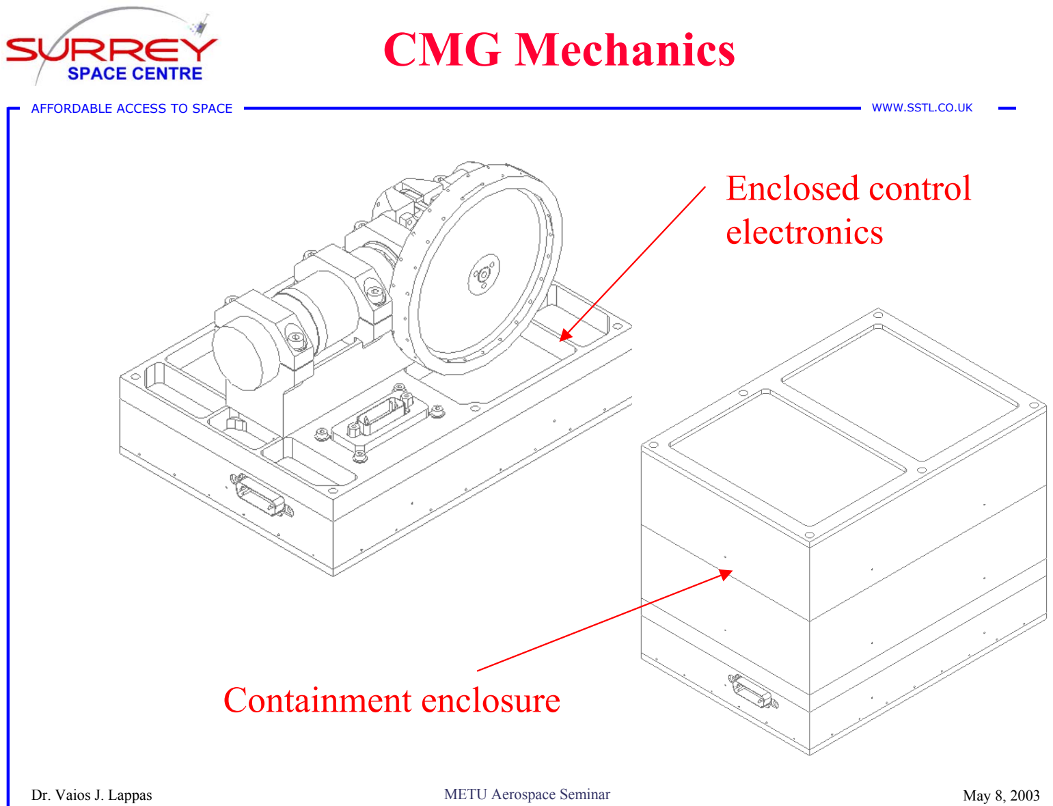
[picture p206: page 79]

AFFORDABLE ACCESS TO SPACE | WWW.SSTL.CO.UK

### Enclosed control electronics

### Containment enclosure

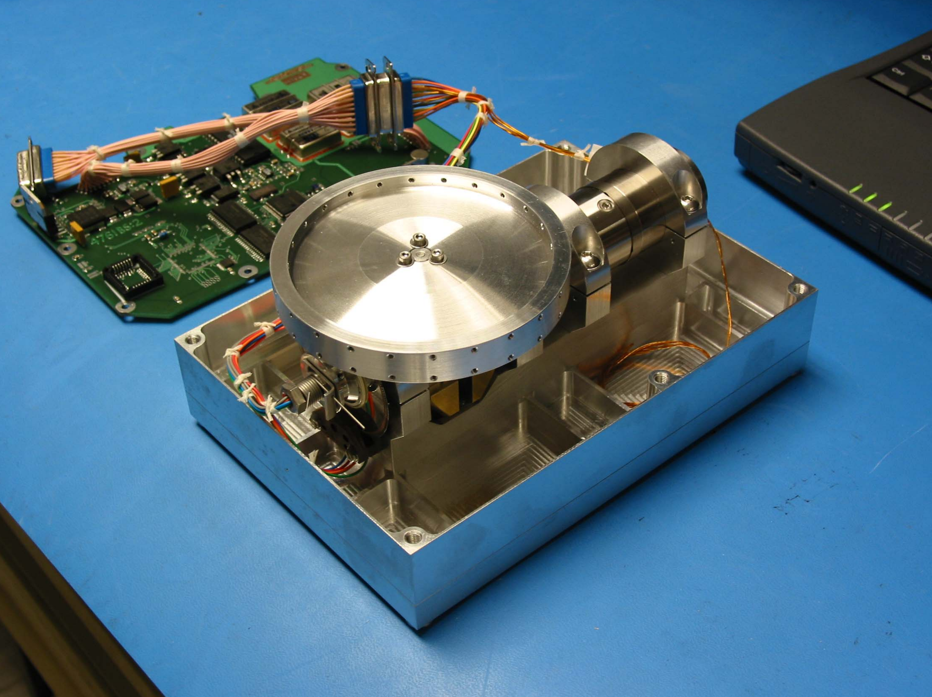
[picture p207: page 80]

AFFORDABLE ACCESS TO SPACE | WWW.SSTL.CO.UK

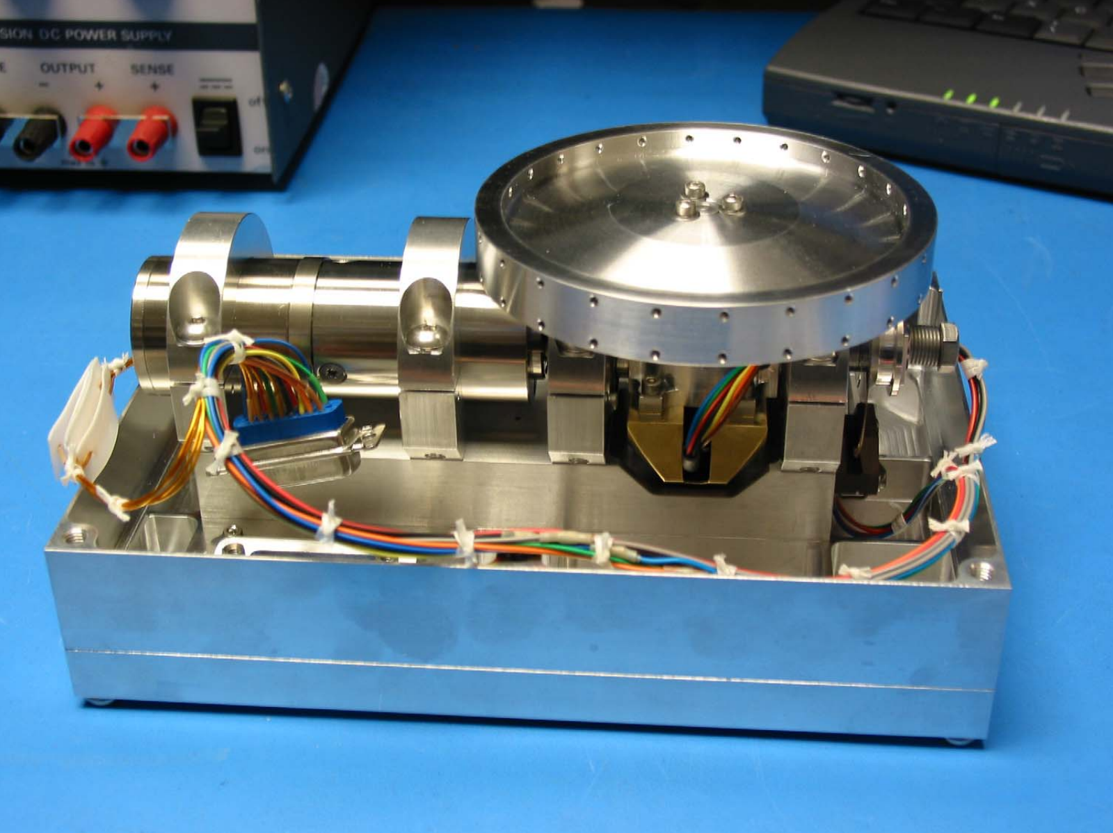
[picture p208: page 81]

AFFORDABLE ACCESS TO SPACE | WWW.SSTL.CO.UK

AFFORDABLE ACCESS TO SPACE | WWW.SSTL.CO.UK

## CMG Mechanics - Mass

### - Mass ~ 2.2 kg per CMG

– 420g Phytron Motor
– 100g Faulhaber Motor
– 90g ‘Flywheel’ (aluminium) – 100g Counterbalance (brass) – 500g Electronics (in enclosure)
– 400g Containment enclosure
– 200g Support bearings
– 200g Axle, interface structure, fasteners, cable, etc
- (all figures approximate to show breakdown)

AFFORDABLE ACCESS TO SPACE | WWW.SSTL.CO.UK

## Other CMG Activities

- Working on BILSAT CMG payload exploitation
– In-orbit data, compare CMGs to RWs, use CMGs as
RW/MW/VSCMG
- Developing a Closed loop, hardware-in-the-loop, CMG cluster simulator – Constrained 3-axis simulator
– 4-CMGs in pyramid configuration
- CMGs selected as an experimental payload on ESA’s Proba II research satellite
- Developing CMGs for Minisatellites (ESA)
- Developing new CMG algorithms, Singularity Avoidance schemes, non-linear control strategies
- Modelling of CMG motor dynamics
- Collaboration with Prof. B. Wie (ASU) and Prof. P. Tsiotras (Georgia Tech.)
- Collaboration with METU (Aerospace) ?

AFFORDABLE ACCESS TO SPACE | WWW.SSTL.CO.UK

## 9. Future Work

- Planetary Ascent Vehicles (PAV): Small Rockets… - Mars/planetary sample return missions will require some means to transport samples of planetary soil back to earth - Need to ferry these samples from the planet’s surface to an orbiting return spacecraft - Need to develop a small rocket to take a 1 kg sample to a low Mars orbit (LMO) - Surrey working on the conceptual (systems) design and Guidance, Navigation and Control System (GNC) - GNC system baseline configuration: TVC, single cold gas engine, roll thruster, IMU

## 9.1 Planetary Ascent Vehicles (PAV)

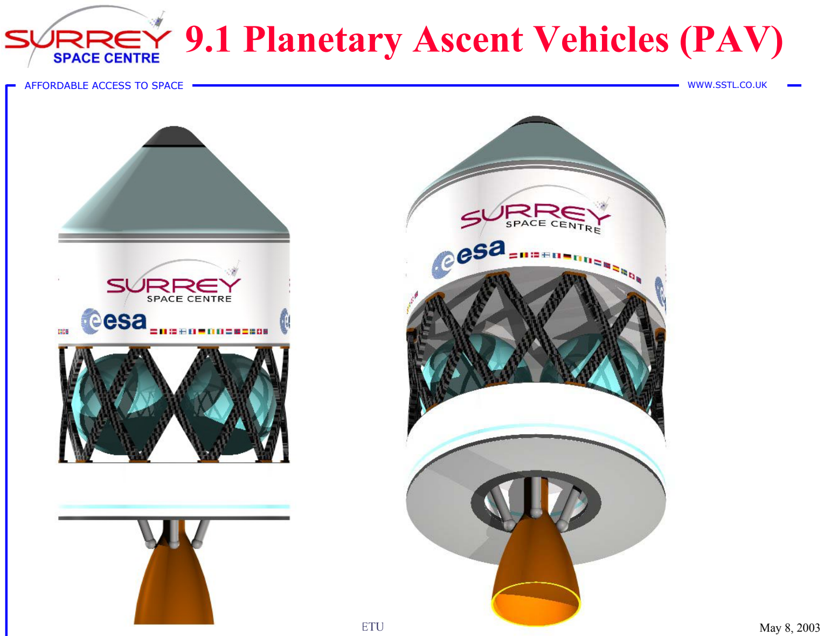
[picture p209: page 85]

AFFORDABLE ACCESS TO SPACE | WWW.SSTL.CO.UK

AFFORDABLE ACCESS TO SPACE | WWW.SSTL.CO.UK

## 9.2 Planetary Ascent Vehicles (PAV)

### - Develop GNC system in MATLAB/Simulink - Perform systems analysis of PAV:

– 1 kg sample payload
– 3 Astronauts as payload

### - Demonstrate concept viability using software//visualisation tools - Demonstrate Thrust Vector Control (TVC) GNC principles with closed-loop, hardware-in-the loop experiments - Developing the software/hardware for the experiments

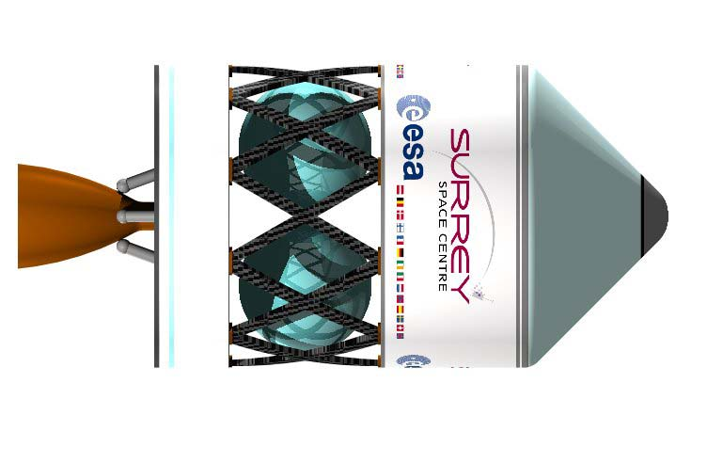
[picture p210: figure]

AFFORDABLE ACCESS TO SPACE | WWW.SSTL.CO.UK

## 9.2 Micro-UAVs

### - New research topic - Use Surrey’s innovative, low cost design approach - Design a micro UAV (mass 2-3 kg, range 2-5 km, low power) for low cost civil/military reconnaissance - Payload: Optical instrument for real/near real time imaging - Activities:

– Sizing of micro UAV
– Design of RF link (laptop based)
– Design of imager electronics

### - Design drivers: Low cost (< $1000) , simplicity, ease of use - Applications: Forest fire reconnaissance, refugee/border monitoring, military battle field reconnaissance

AFFORDABLE ACCESS TO SPACE | WWW.SSTL.CO.UK

## 10 Conclusion

- CMGs can be an attractive, efficient, novel, alternative ACS systems for agile Small Satellites - Proven that CMGs are viable for agile small satellites and can potentially make them more efficient, profitable and versatile platforms than before - BILSAT CMGs will be the first commercial CMGs in the world to fly in space, perform actual mission tasks (stereo-imaging) - Exciting research topics in controls (space, aeronautics) - Collaborate with METU-Aerospace - Surrey offers MSc, PhD in aerospace/satellite engineering

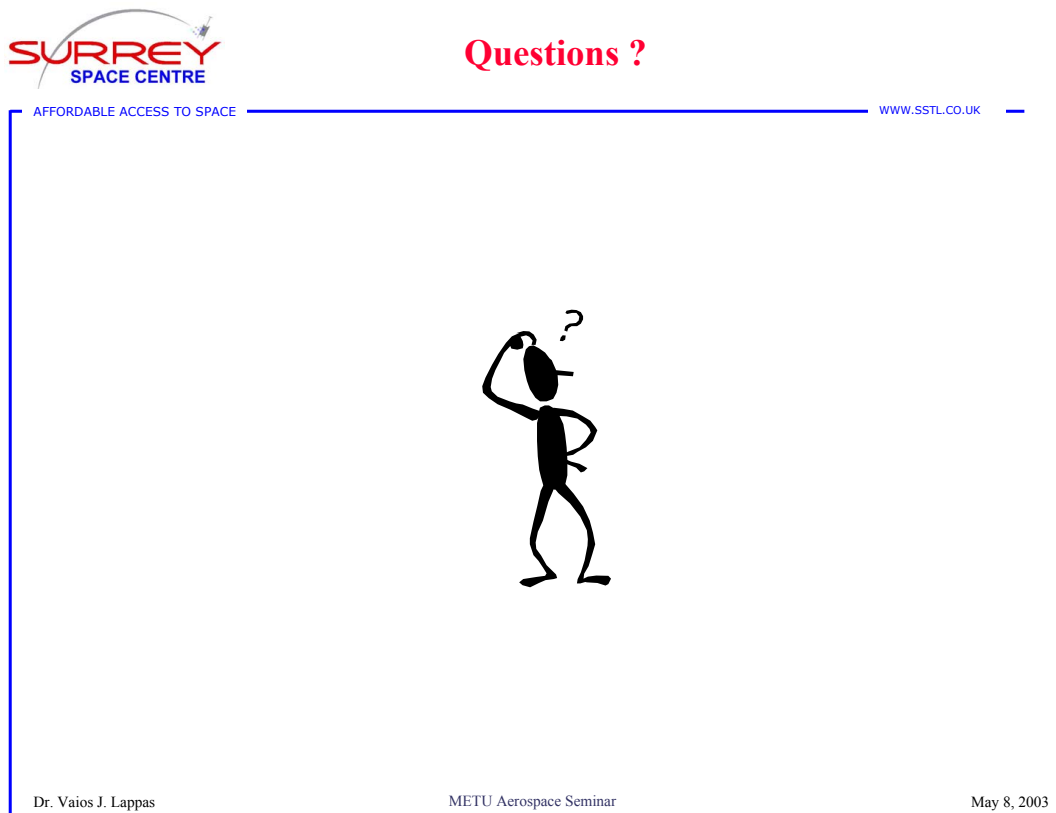
[picture p211: page 89]
AFFORDABLE ACCESS TO SPACE; WWW.SSTL.CO.UK; Questions ?
