RascalSeniorDesign/Preliminary-Design/CMQA/ConOps/Cost Analysis.xlsx

Sheet: Base Mission Spacecraft
Insert Dummy Name Here |  | Insert Primary Name Here
ADC |  | Colony-II Bus
Antenna
GPS
Radio
CDH
Payload
PWR Board
Batteries
 | Mating Mechanism
 |  | Payload
 |  | Propulsion

Sheet: Cost Break Down
Insert Dummy Name Here |  |  |  | Insert Primary Name Here
Subsystem | Component | Cost |  | Subsystem | Component | Cost
COM | Radio | $10.00 |  | PLD | Optical Camera | $100.00
 | Antennas | $15.00 |  |  | Processor | $150.00
ADC | Hysteresis | $125.00 |  |  | Interface | $400.00
 | Magnets | $5.00 |  | PRP | Tank | $5000.00
CDH | Motherboard | $100.00 |  |  | Propellant | $150.00
PLD | Visual Aids | $50.00 |  |  | Controller | $400.00
STR | 3U Structure | $2250.00 |  | STR | Mating | $500.00
PWR | Board | $400.00 |  |  | Total Cost | $6700.00
 | Batteries | $160.00
 | Total Cost | $3115.00
 |  |  | Total Cost
 |  |  | $9815.00

Sheet: References
Hysteresis | ADC folder Copper Drive
Magnets | https://www.kjmagnetics.com/proddetail.asp?prod=D18
Structure | http://www.pumpkininc.com/content/doc/forms/pricelist.pdf
Antennas | http://www.mcmaster.com/#graduated-tape-rules/=r1v6lr
