RascalSeniorDesign/Preliminary-Design/CMQA/Mission Configuration Trade Study/RCL-0-CMQA1 Rascal Mission Configuration Trade Study Martix.xlsx

Sheet: Readme
Document Title | RCL-O-CMQA1 Rascal Mission Configuration Trade Study
Document Author | Tom Moline
Approved By | Nate Richard
Revision | -
Last Edit Date | 2013-11-30
Readme
This document serves to visualize the various missions, past, present, and future, that are attempting to demonstrate proximity operations similar to those that are being shown by the Rascal mission, as to assess the poxxible mission configuration gaps that the Rascal mission could fill.

Sheet: All Mission Data
Mission Name | Institution | Launch Date | Spacecraft Type | Weight | Number of Spacecraft | Attached? | Prox Ops Demonstrations | Propulsion System Performance | Navigation | Cost | Success | Reason
XSS-11 | AFRL | 2005-04-01 | Micro | 220 | 1 | N/A | Rendezvous with upper stage of rocket body and circumnavigation |  | Image Processing | $80 million | Yes | It succeeded
ARAPAIMA | Embrey-Riddle | N/A | Nano | 18 | 1 | N/A | Rendezvous with resident space object and circumnaviagtion |  | Image Processing, GPS | N/A | N/A | Not launched
DART | NASA/Orbital Science | 2005-04-01 | Micro | 790 | 1 | N/A | Rendezvous with resident space object (satellite) using GPS |  | Image Processing, GPS | $95 million | No | Collison with target
MSAT | Missouri S&T | N/A | Micro | 100 | 2 | Yes | Circumnaviagtion and spectroscopic image capture of releasable spacecraft |  | Image Processing | N/A | N/A | Not launched
SNAP-1 | Surrey Satellite Technology Ltd/ University of Surrey | 2000-06-01 | Nano | 18 | 1 | N/A | Rendezvous with RSO satellite that launched on the same rocket | 32.6 grams of butane capable of providing delta V of 3 m/s | Image Processing, GPS | N/A | No | Drifted apart too quickly due to drag differences and active solar cycle
STRaND-2 | Surrey Satellite Technology Ltd | N/A | Nano | 26 | 2 | No | Rendezvous and docking between each spacecraft | WARP DRiVE, Water-Alcohol Resistojet Propulsion Deorbit Re-entry Velocity Experiment, Plasma Thrusters | Image procesing | N/A | N/A | Not launched
PONSFD | Tyvak Nano-Satellite Systems | N/A | Nano | 22 | 2 | Yes (Maybe) | Rascal (plus docking) | Multi-Thruster | Image Processing, GPS | $15 million | N/A | Not Launched
GLADOS | University of Buffalo | N/A | Nano | 11 | 1 | N/A | Observe space debris through image processing and glint detection | N/A | Image Processing | $300 thousand | N/A | Not Launched
Orbital Express | DARPA/Orbital Science | 2007-03-01 | Micro | 2900 | 2 | Yes | Rendezvous, srtation keeping, docking, and fluid transfer between each spacecraft | Hydrazine thrusters | Image Processing, Laser Range Detector, GPS | $300 million | Yes | Except for fluid transfer
XSS-10 | AFRL/Boeing | 2003-01-01 | Micro | 62 | 1 | N/A | ROS line-of-sight inspection of upper stage of launch vehicle | N/A | Image Processing, GPS | N/A | Yes | It succeeded
MiTEx | Air Force | 2006-06-01 | Micro | 1000 | 3 | No | Two spacecraft performed inspections of each other and third passive spacecraft | N/A | Image Processing | $10 Million | Yes | It succeeded
ProxOps-1 | Georgia Tech | N/A | Micro | 100 | 2 | Yes | One spacecraft will be released from the other while the other circumnaviages and captures images of it | N/A | Image Processing | N/A | N/A | Not Launched
Rascal | Saint Louis University | N/A | Nano | 30 | 2 | Maybe | You know | IDK | IDK | IDK | Maybe | Not launched
Aerocube 4 | Aerosapce Corperation | 2012-09-01 | Nano | 1 | 3 | No | Stationkeeping by altering ballistic coefficient | None | GPS, Motion Processors | $200 Thousand | Yes | It succeeded

Sheet: Launched Mission Data
Mission Name | Institution | Launch Date | Number of Spacecraft | Separable? | Weight | Weight (kg) | Success | Cost (million dollars)
XSS-11 | AFRL | 2005-04-01 | 1 | No | 220 | 99.79024 | Yes | 80
ARAPAIMA | Embrey-Riddle | N/A |  | No |  | 0 | N/A
DART | NASA/Orbital Science | 2005-04-01 | 1 | No | 790 | 98 | No | 95
MSAT | Missouri S&T | N/A |  | Yes |  | 0 | N/A
SNAP-1 | Surrey Satellite Technology Ltd/ University of Surrey | 2000-06-01 | 1 | No | 18 | 8.164656 | No | 0.05
STRaND-2 | Surrey Satellite Technology Ltd | N/A |  | No |  | 0 | N/A
PONSFD | Tyvak Nano-Satellite Systems | N/A |  | Yes |  | 0 | N/A | 15
GLADOS | University of Buffalo | N/A |  | No |  | 0 | N/A
Orbital Express | DARPA/Orbital Science | 2007-03-01 | 2 | Yes | 2900 | 1315.4168 | Yes | 300
XSS-10 | AFRL/Boeing | 2003-01-01 | 1 | No | 62 | 28.122704 | Yes | 100
MiTEx | Air Force | 2006-06-01 | 3 | No | 1000 | 453.592 | Yes | 30
ProxOps-1 | Georgia Tech | N/A |  | Yes |  | 0 | N/A
Rascal | Saint Louis University | N/A | 2 | Yes | 30 | 13.60776 | Maybe | 0.1
Aerocube 4 | Aerospace Corperation | 2012-09-01 | 3 | No | 2.2 | 1 | Yes | 0.2
DRAGONsat | University of Texas Austin | 2009-06-01 | 2 | No |  | 7.5 | Yes | 0.5
