RascalSeniorDesign/Preliminary-Design/CMQA/Mission Configuration Trade Study/Number of Spacecraft vs Cost Chart.tif

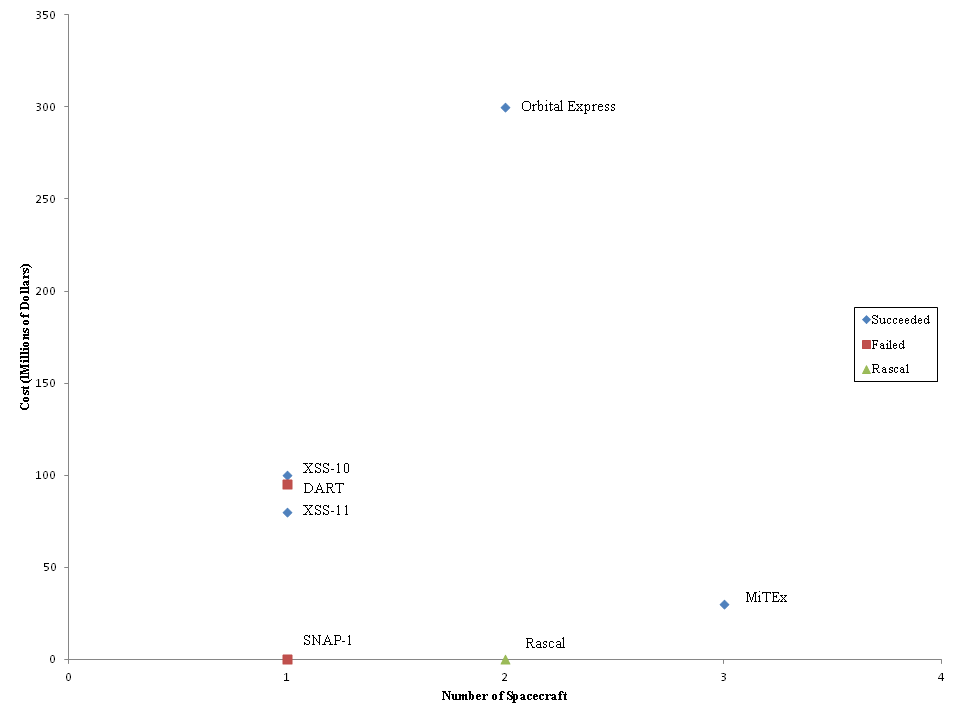
CMQA/Mission Configuration Trade Study/Number of Spacecraft vs Cost Chart.tif
