RascalSeniorDesign/Preliminary-Design/Structure (STR)/CAD Models/Central Processing Board Assembly.SLDASM

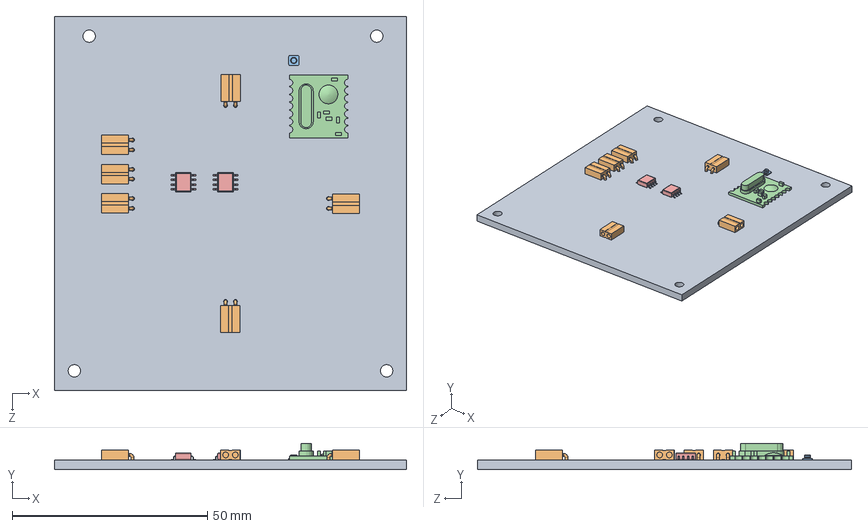
[picture p225: CAD file, 2014-04-27]
Structure (STR)/CAD Models/Central Processing Board Assembly.SLDASM
90.2 x 6.70 x 95.9 mm
Central Processing Board PCB
2-Pin 90 Degree Surface Mount Header x 6
Antenna Connector
RFID Chip
3.3V Regulator x 2
