RascalSeniorDesign/Preliminary-Design/Structure (STR)/CAD Models/Spacecraft V 2.2.SLDASM

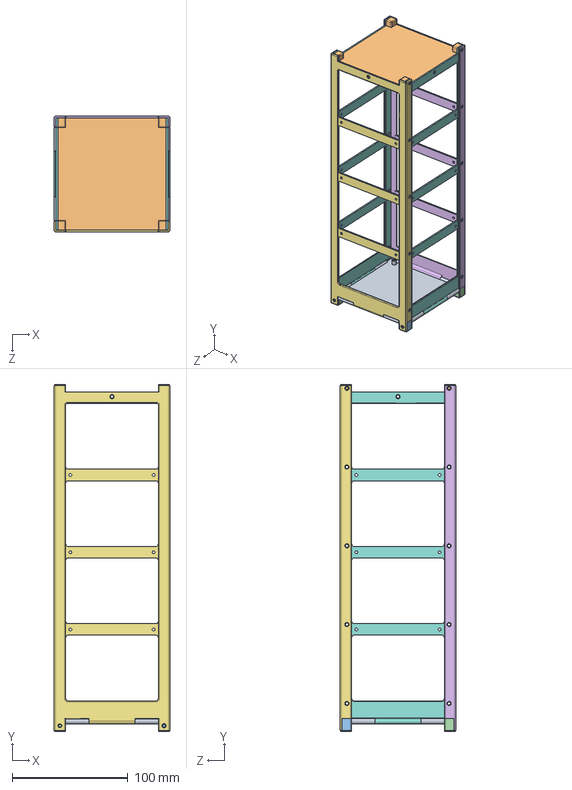
[picture p226: CAD file, 2014-04-27]
Structure (STR)/CAD Models/Spacecraft V 2.2.SLDASM
100.0 x 300.0 x 100.0 mm
Base Plate V 2.1
Top Plat with flanges V 2.1
Foot Piece x 2
Other Foot Piece x 2
Pin x 4
Microswitch Side Panel 1 with feet V 2.1
Side Panel 1 with feet V 2.1
Side Panel 2 with notch V 2.1 x 2
