RascalSeniorDesign/Preliminary-Design/Structure (STR)/CAD Models/Secondary Spacecraft Assembly.SLDASM

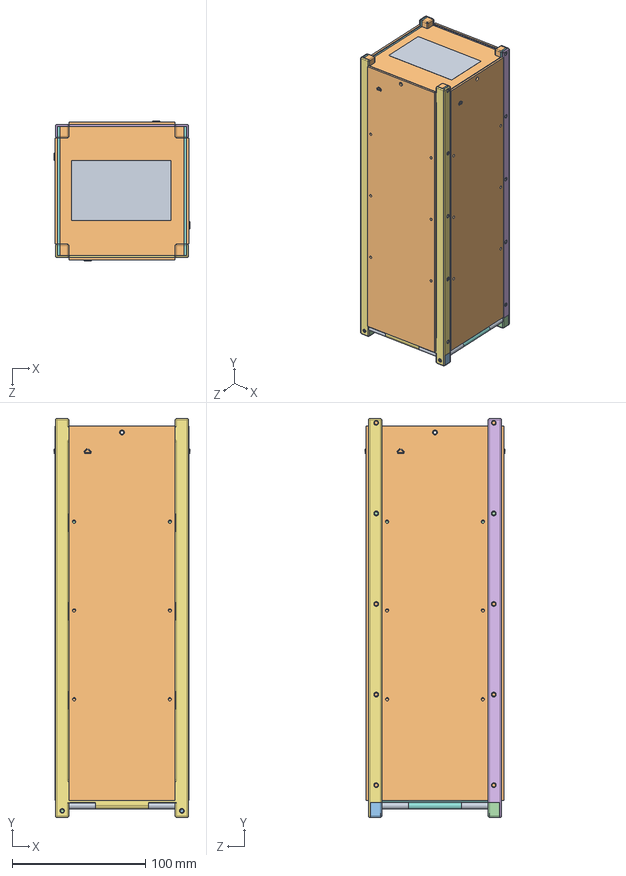
[picture p227: CAD file, 2014-04-27]
Structure (STR)/CAD Models/Secondary Spacecraft Assembly.SLDASM
101.9 x 300.0 x 105.1 mm
Base Plate V 2.1
Top Plat with flanges V 2.1
Foot Piece x 2
Other Foot Piece x 2
Pin x 4
Microswitch Side Panel 1 with feet V 2.1
Side Panel 1 with feet V 2.1
Side Panel 2 with notch V 2.1 x 2
Battery Pack Interface Component x 4
0.5U Battery Pack Component x 3
C-Cell Lithium Battery x 27
Central Processing Board PCB
2-Pin 90 Degree Surface Mount Header x 6
Antenna Connector
RFID Chip
3.3V Regulator x 2
Patch Antenna
Standard Unpopulated Solar Panel x 4
LED x 28
ADC Subsystem
