RascalSeniorDesign/Preliminary-Design/Structure (STR)/CAD Models/Standard Populated External Panel.SLDASM

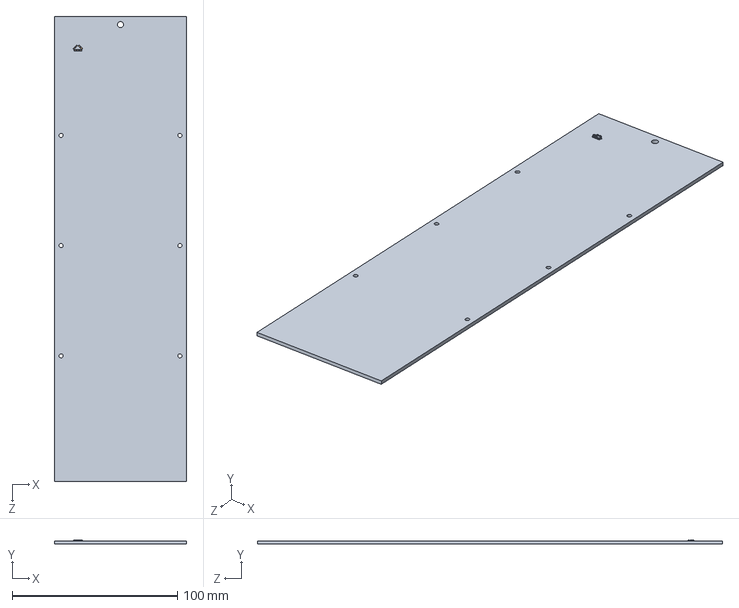
[picture p228: CAD file, 2014-04-27]
Structure (STR)/CAD Models/Standard Populated External Panel.SLDASM
80.0 x 2.55 x 281.6 mm
Standard Unpopulated Solar Panel
LED x 7
