RascalSeniorDesign/Preliminary-Design/Structure (STR)/CAD Models/0.5U Battery pack Assembly.SLDASM

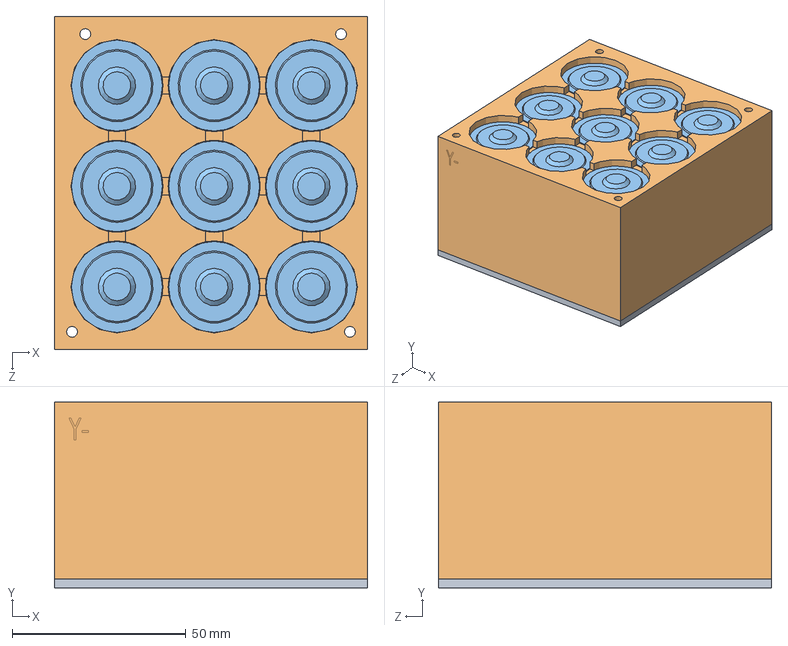
[picture p229: CAD file, 2014-04-27]
Structure (STR)/CAD Models/0.5U Battery pack Assembly.SLDASM
90.2 x 53.5 x 95.9 mm
Battery Pack Interface Component
0.5U Battery Pack Component
C-Cell Lithium Battery x 9
