RascalSeniorDesign/Preliminary-Design/Structure (STR)/CAD Models/Battery Pack Assembly.SLDASM

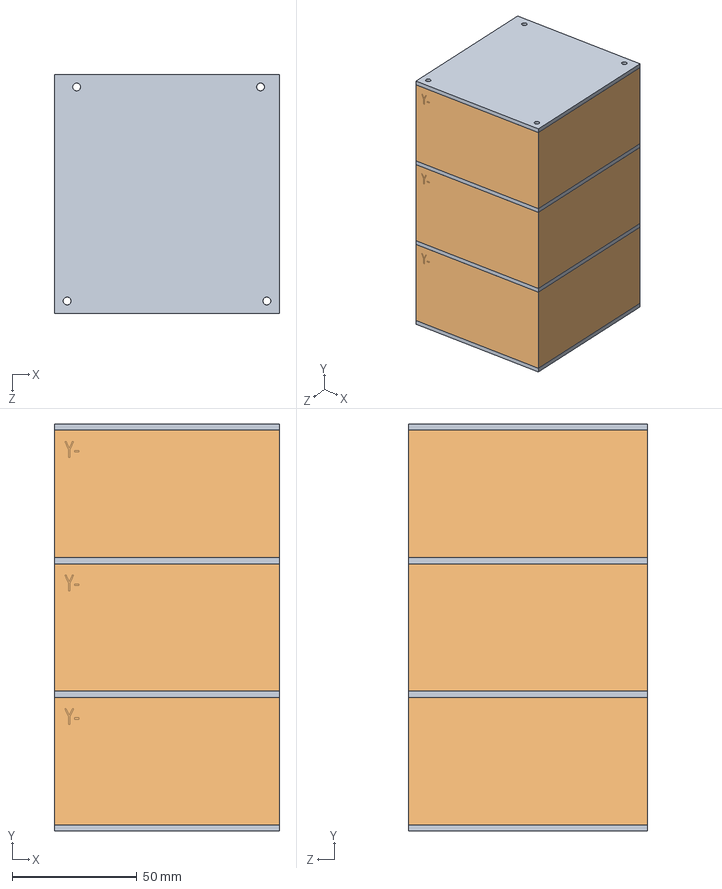
[picture p230: CAD file, 2014-04-27]
Structure (STR)/CAD Models/Battery Pack Assembly.SLDASM
90.2 x 163.0 x 95.9 mm
Battery Pack Interface Component x 4
0.5U Battery Pack Component x 3
C-Cell Lithium Battery x 27
