RascalSeniorDesign/Preliminary-Design/Structure (STR)/CAD Models/Unpopulated +Y Panel.SLDPRT

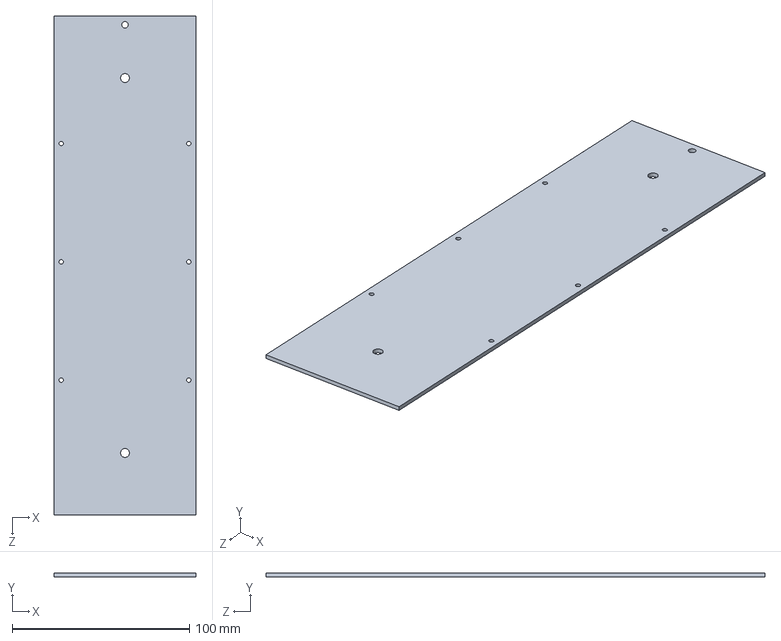
[picture p231: CAD file, 2014-05-16]
Structure (STR)/CAD Models/Unpopulated +Y Panel.SLDPRT
80.0 x 2.00 x 281.6 mm
