RascalSeniorDesign/Preliminary-Design/Structure (STR)/CAD Models/Microswitch Side Panel Primary Spacecraft with feet V 2.1.SLDPRT

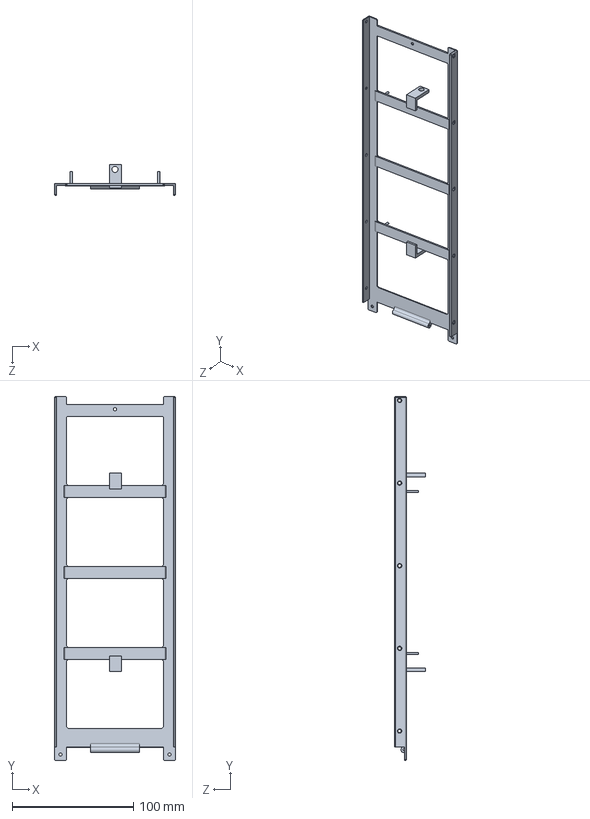
[picture p232: CAD file, 2014-05-16]
Structure (STR)/CAD Models/Microswitch Side Panel Primary Spacecraft with feet V 2.1.SLDPRT
100.0 x 300.0 x 25.5 mm
