RascalSeniorDesign/Preliminary-Design/Structure (STR)/CAD Models/Solenoid Casing.SLDPRT

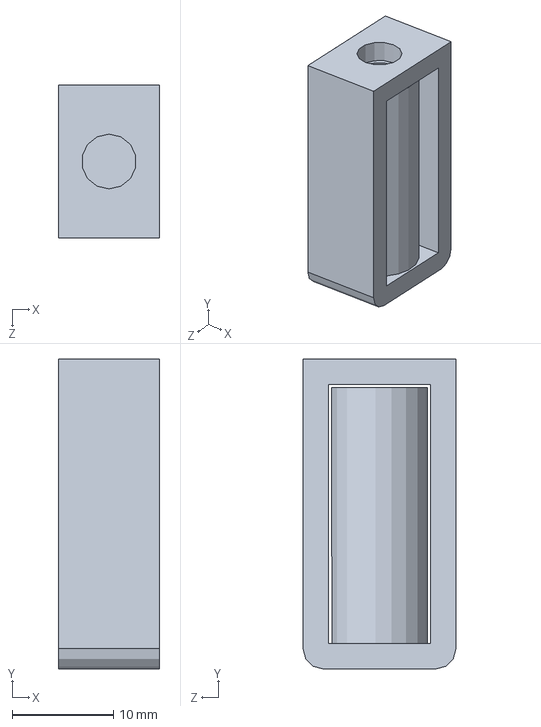
[picture p233: CAD file, 2014-05-16]
Structure (STR)/CAD Models/Solenoid Casing.SLDPRT
10.0 x 30.6 x 15.1 mm
