RascalSeniorDesign/Preliminary-Design/Structure (STR)/CAD Models/Solenoid Pin.SLDPRT

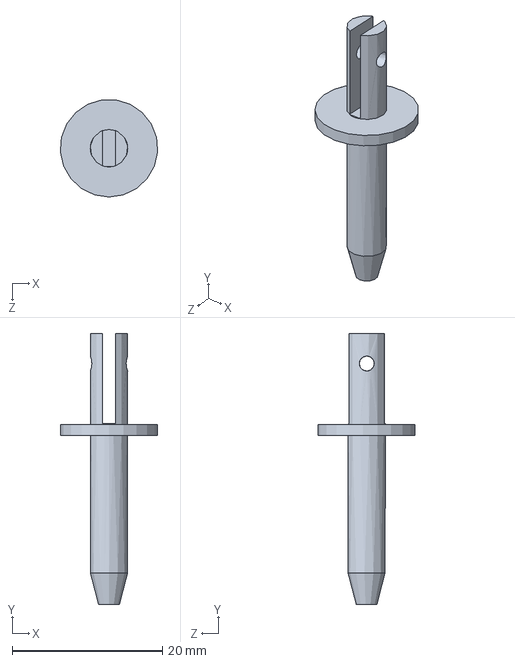
[picture p234: CAD file, 2014-05-16]
Structure (STR)/CAD Models/Solenoid Pin.SLDPRT
13.0 x 36.1 x 12.9 mm
