RascalSeniorDesign/Preliminary-Design/Structure (STR)/CAD Models/Solenoid Spring.SLDPRT

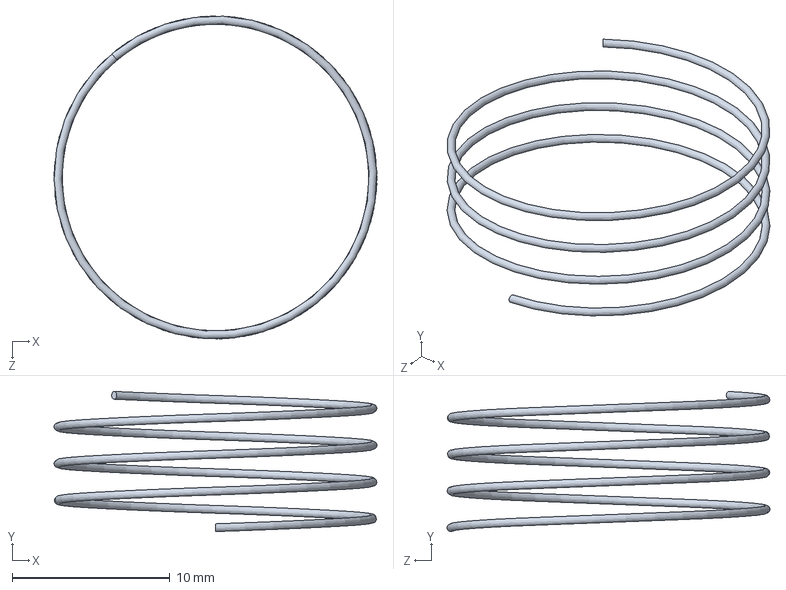
[picture p235: CAD file, 2014-05-16]
Structure (STR)/CAD Models/Solenoid Spring.SLDPRT
20.5 x 8.89 x 20.5 mm
