RascalSeniorDesign/Preliminary-Design/Structure (STR)/CAD Models/Base Plate V 2.1.SLDPRT

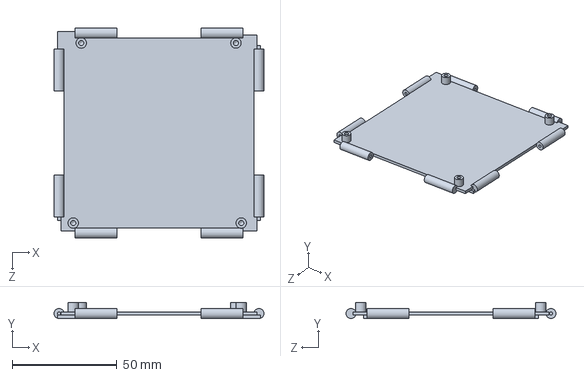
[picture p236: CAD file, 2014-04-27]
Structure (STR)/CAD Models/Base Plate V 2.1.SLDPRT
100.0 x 7.65 x 100.0 mm
