RascalSeniorDesign/Preliminary-Design/Structure (STR)/CAD Models/Central Processing Board PCB.SLDPRT

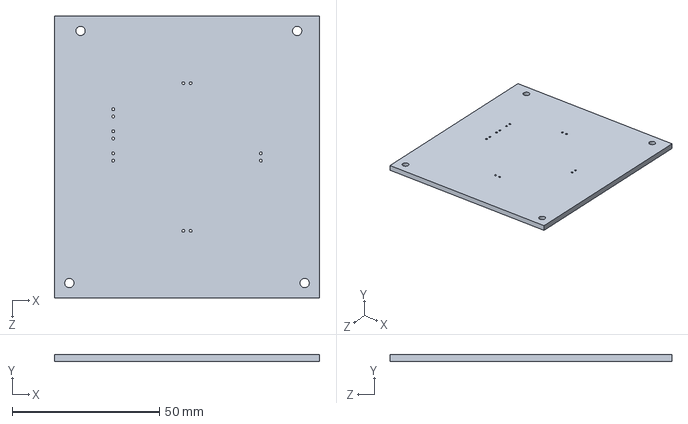
[picture p237: CAD file, 2014-04-27]
Structure (STR)/CAD Models/Central Processing Board PCB.SLDPRT
90.2 x 2.50 x 95.9 mm
