RascalSeniorDesign/Preliminary-Design/Structure (STR)/CAD Models/ADC Subsystem.SLDPRT

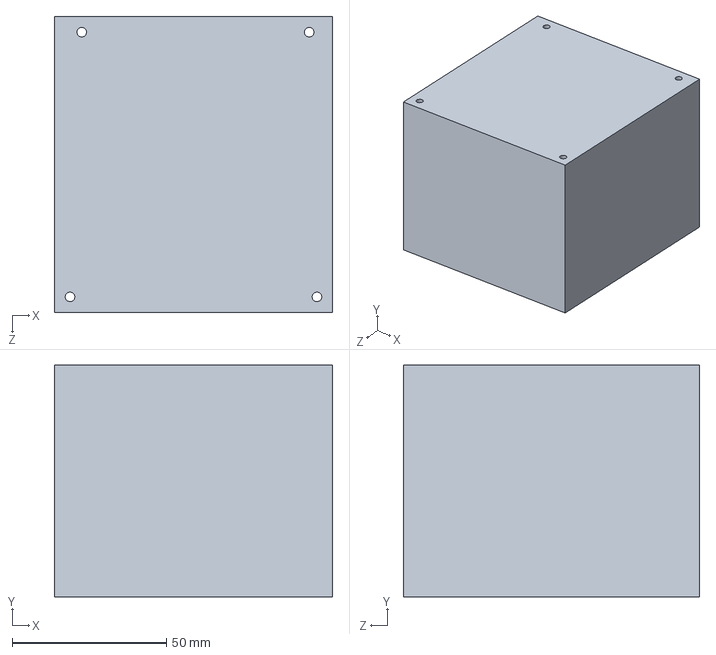
[picture p238: CAD file, 2014-04-27]
Structure (STR)/CAD Models/ADC Subsystem.SLDPRT
90.2 x 75.0 x 95.9 mm
