RascalSeniorDesign/Preliminary-Design/Structure (STR)/CAD Models/3.3V Regulator.SLDPRT

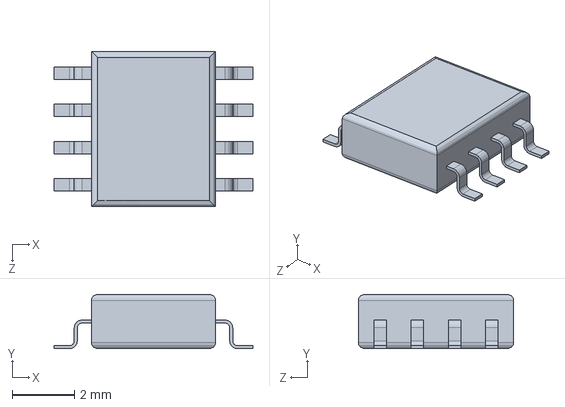
[picture p239: CAD file, 2014-04-27]
Structure (STR)/CAD Models/3.3V Regulator.SLDPRT
6.40 x 1.75 x 5.00 mm
