RascalSeniorDesign/Preliminary-Design/Structure (STR)/CAD Models/Foot Piece.SLDPRT

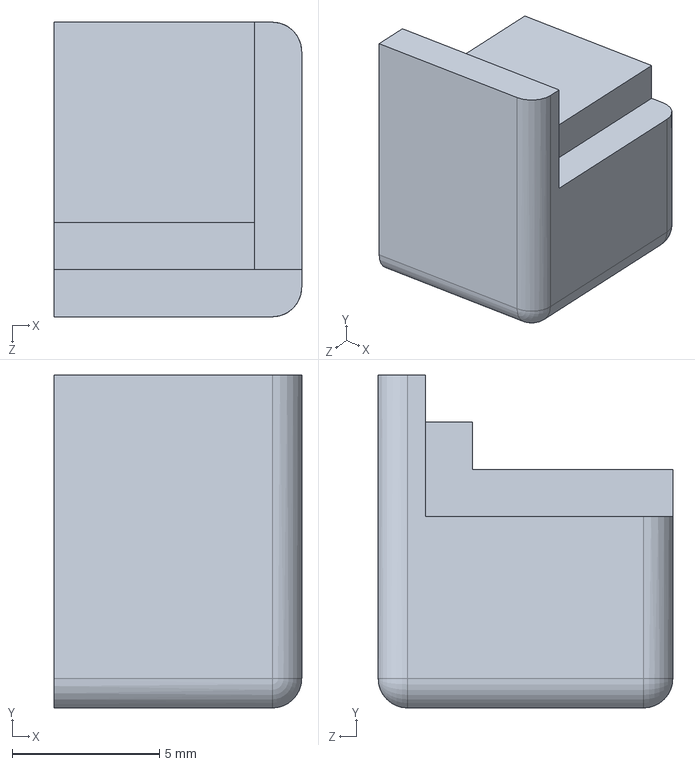
[picture p240: CAD file, 2014-04-27]
Structure (STR)/CAD Models/Foot Piece.SLDPRT
8.40 x 11.3 x 10.0 mm
