RascalSeniorDesign/Preliminary-Design/Structure (STR)/CAD Models/0.5U Battery Pack Component.SLDPRT

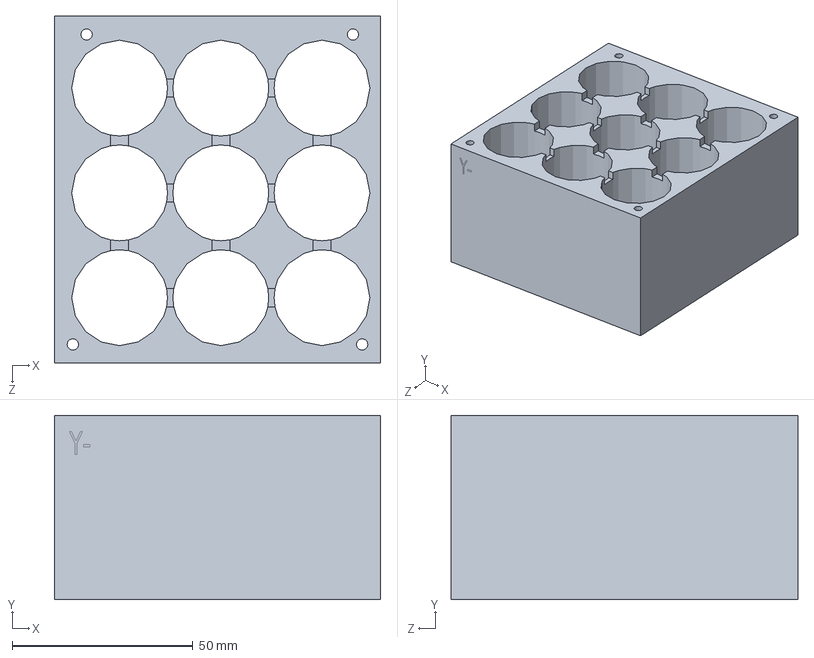
[picture p241: CAD file, 2014-04-27]
Structure (STR)/CAD Models/0.5U Battery Pack Component.SLDPRT
90.2 x 51.0 x 95.9 mm
