RascalSeniorDesign/Preliminary-Design/Structure (STR)/CAD Models/2-Pin 90 Degree Surface Mount Header.SLDPRT

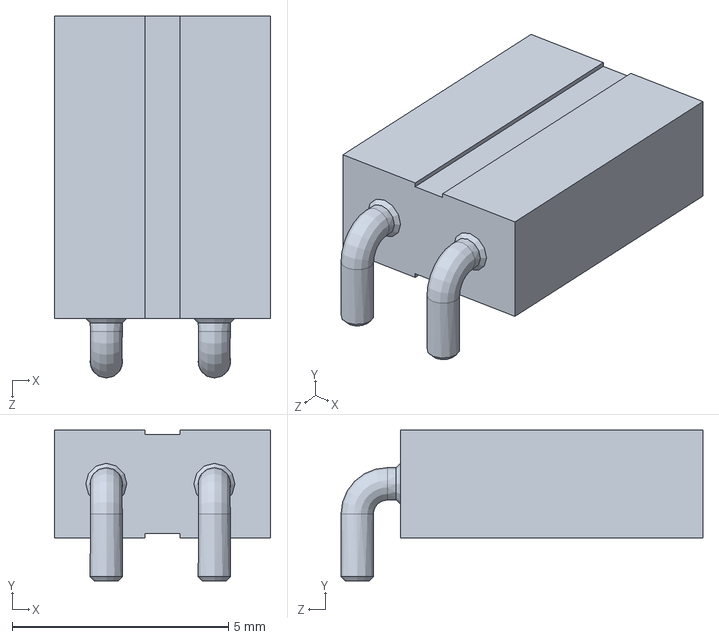
[picture p242: CAD file, 2014-04-27]
Structure (STR)/CAD Models/2-Pin 90 Degree Surface Mount Header.SLDPRT
5.00 x 3.49 x 8.38 mm
