RascalSeniorDesign/Preliminary-Design/Structure (STR)/CAD Models/Side Panel 1 with feet V 2.1.SLDPRT

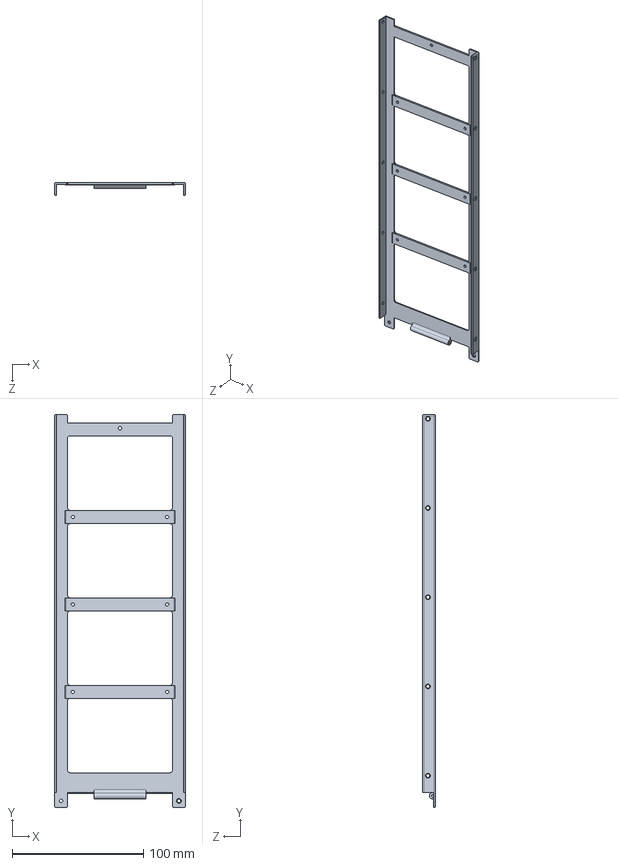
[picture p243: CAD file, 2014-04-27]
Structure (STR)/CAD Models/Side Panel 1 with feet V 2.1.SLDPRT
100.0 x 300.0 x 10.0 mm
