RascalSeniorDesign/Preliminary-Design/Structure (STR)/CAD Models/RFID Chip.SLDPRT

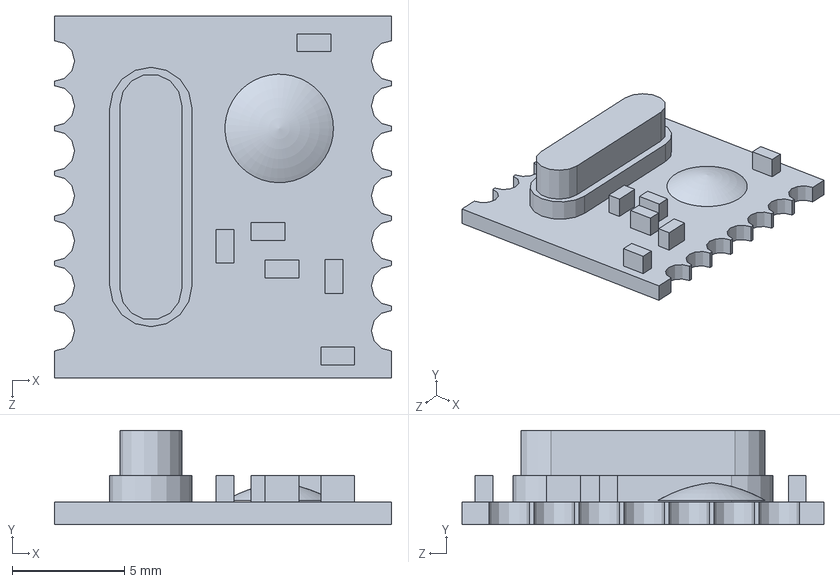
[picture p244: CAD file, 2014-04-27]
Structure (STR)/CAD Models/RFID Chip.SLDPRT
15.0 x 4.20 x 16.1 mm
