RascalSeniorDesign/Preliminary-Design/Structure (STR)/CAD Models/Battery Pack Hole Optimization.SLDPRT

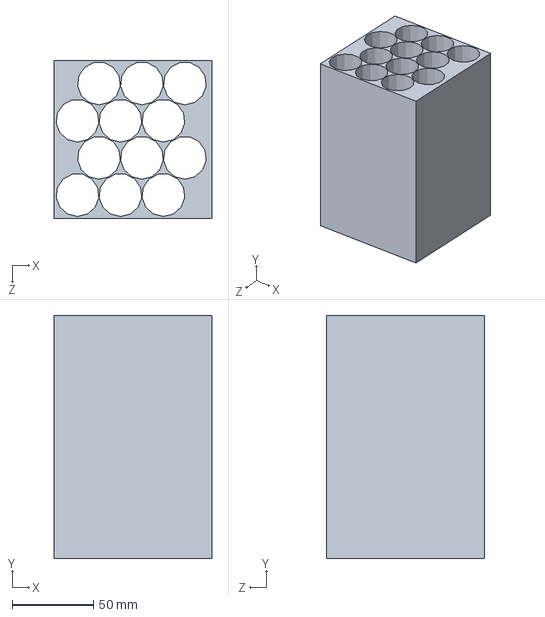
[picture p245: CAD file, 2014-04-27]
Structure (STR)/CAD Models/Battery Pack Hole Optimization.SLDPRT
97.5 x 150.0 x 97.5 mm
