RascalSeniorDesign/Preliminary-Design/Structure (STR)/CAD Models/LED.SLDPRT

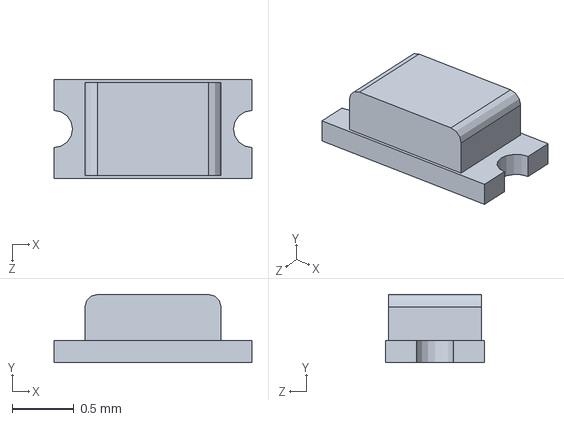
[picture p246: CAD file, 2014-04-27]
Structure (STR)/CAD Models/LED.SLDPRT
1.60 x 0.55 x 0.8 mm
