RascalSeniorDesign/Preliminary-Design/Structure (STR)/CAD Models/Top Plat with flanges V 2.1.SLDPRT

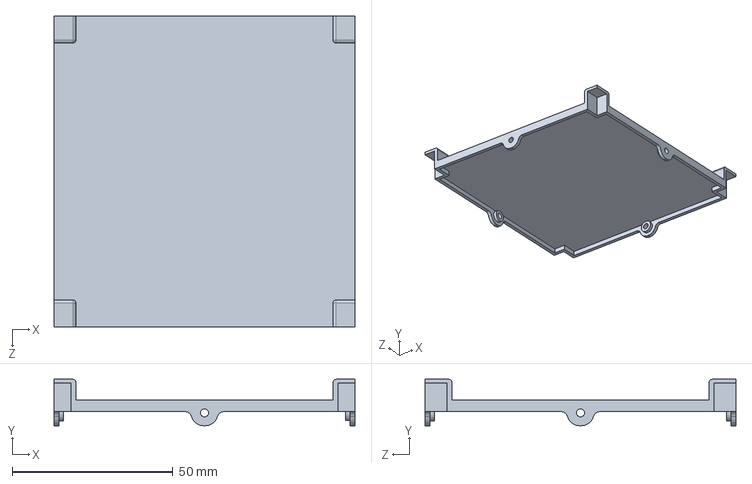
[picture p247: CAD file, 2014-04-27]
Structure (STR)/CAD Models/Top Plat with flanges V 2.1.SLDPRT
93.6 x 14.5 x 96.8 mm
