RascalSeniorDesign/Preliminary-Design/Structure (STR)/CAD Models/Microswitch Foot Piece.SLDPRT

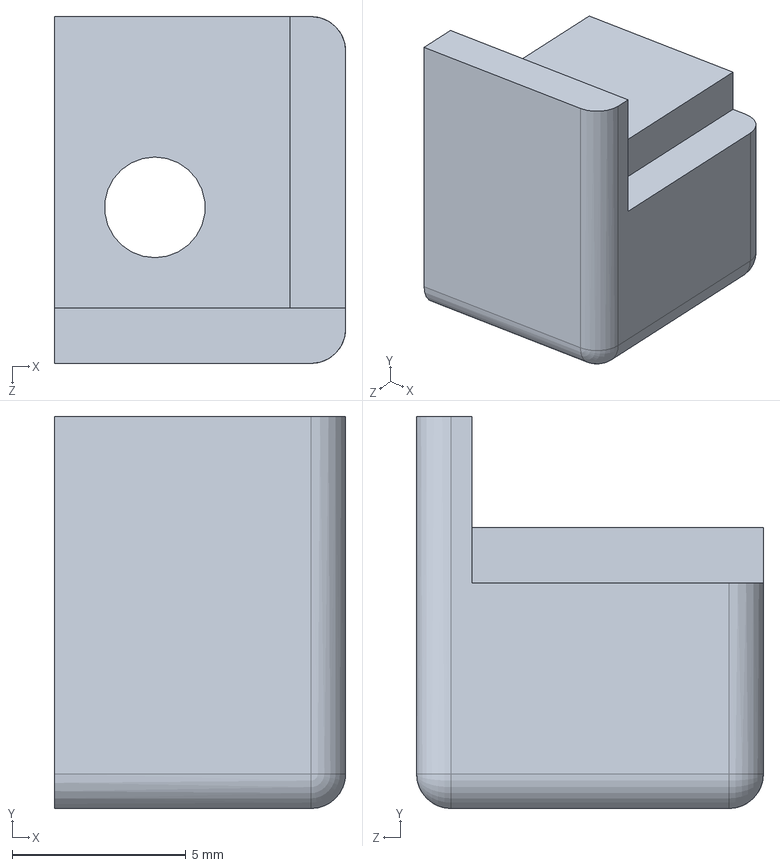
[picture p248: CAD file, 2014-04-27]
Structure (STR)/CAD Models/Microswitch Foot Piece.SLDPRT
8.40 x 11.3 x 10.0 mm
