RascalSeniorDesign/Preliminary-Design/Structure (STR)/CAD Models/Microcontroller.SLDPRT

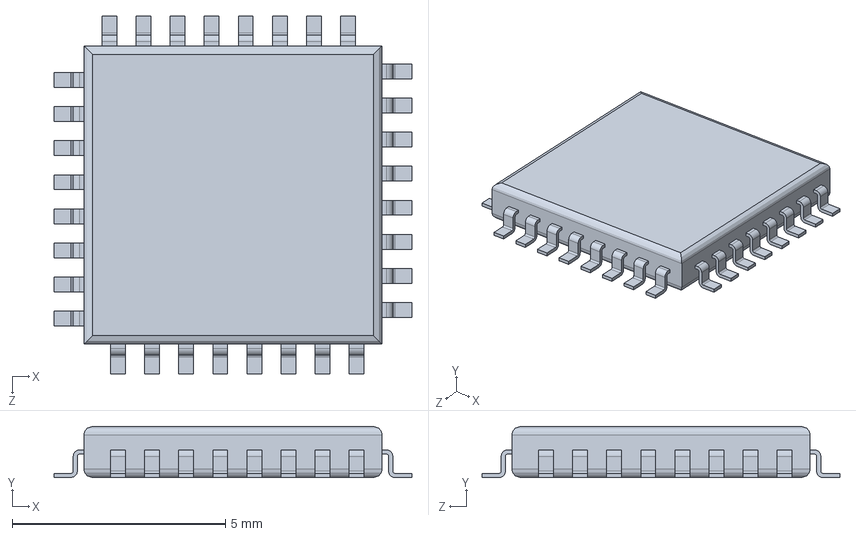
[picture p249: CAD file, 2014-04-27]
Structure (STR)/CAD Models/Microcontroller.SLDPRT
8.40 x 1.20 x 8.40 mm
