RascalSeniorDesign/Preliminary-Design/Structure (STR)/CAD Models/Patch Antenna.SLDPRT

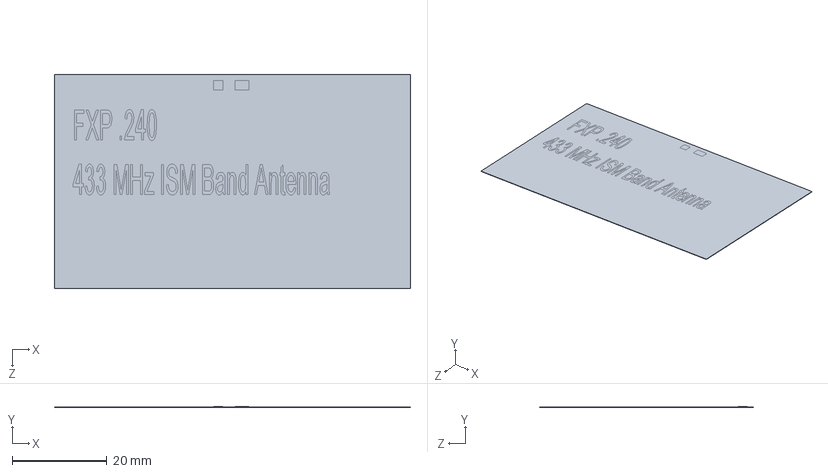
[picture p250: CAD file, 2014-04-27]
Structure (STR)/CAD Models/Patch Antenna.SLDPRT
75.0 x 0.11 x 45.0 mm
