RascalSeniorDesign/Preliminary-Design/Structure (STR)/CAD Models/Pin.SLDPRT

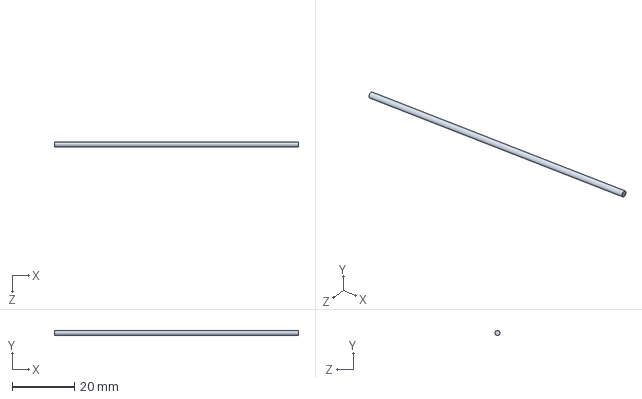
[picture p251: CAD file, 2014-04-27]
Structure (STR)/CAD Models/Pin.SLDPRT
78.5 x 1.60 x 1.60 mm
