RascalSeniorDesign/Preliminary-Design/Structure (STR)/CAD Models/Antenna Connector.SLDPRT

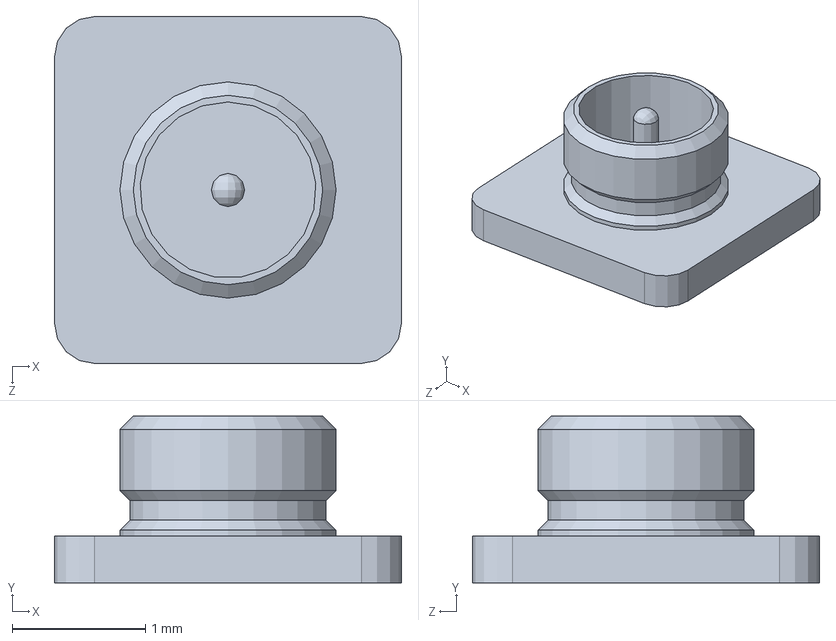
[picture p252: CAD file, 2014-04-27]
Structure (STR)/CAD Models/Antenna Connector.SLDPRT
2.60 x 1.25 x 2.60 mm
