RascalSeniorDesign/Preliminary-Design/Structure (STR)/CAD Models/C-Cell Lithium Battery.SLDPRT

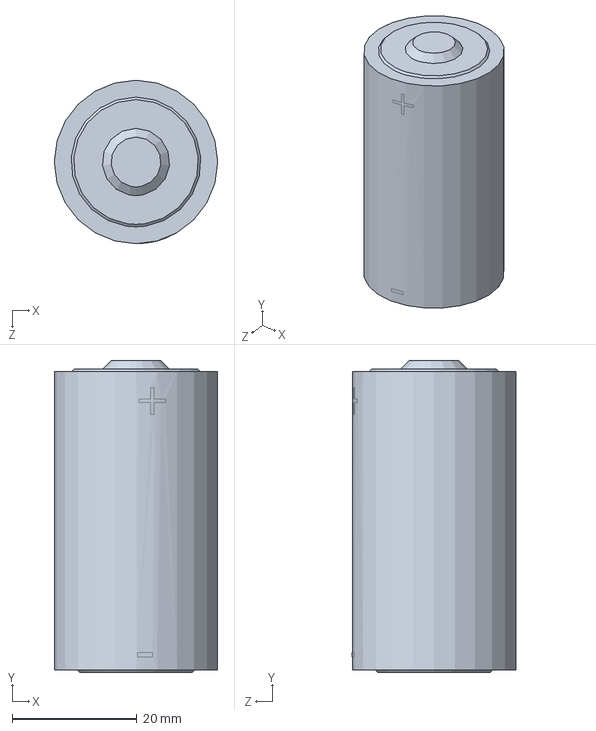
[picture p253: CAD file, 2014-04-27]
Structure (STR)/CAD Models/C-Cell Lithium Battery.SLDPRT
26.2 x 50.0 x 26.2 mm
