RascalSeniorDesign/Preliminary-Design/Structure (STR)/CAD Models/Solenoid Bracket.SLDPRT

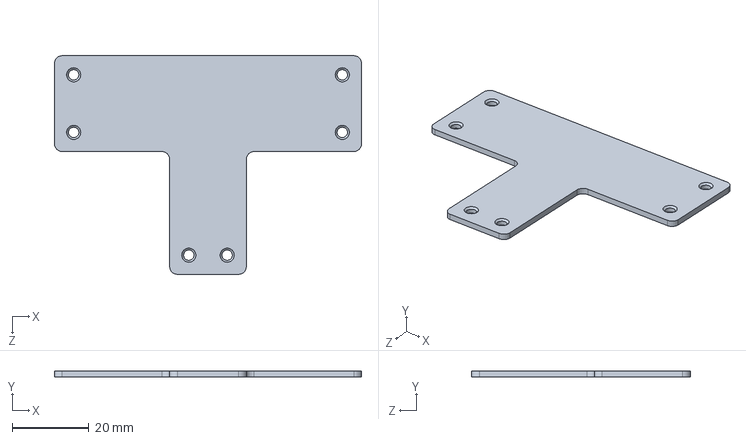
[picture p254: CAD file, 2014-04-27]
Structure (STR)/CAD Models/Solenoid Bracket.SLDPRT
80.0 x 1.60 x 57.0 mm
