RascalSeniorDesign/Preliminary-Design/Structure (STR)/CAD Models/Secondary Spacecraft Central Processing Board.SLDPRT

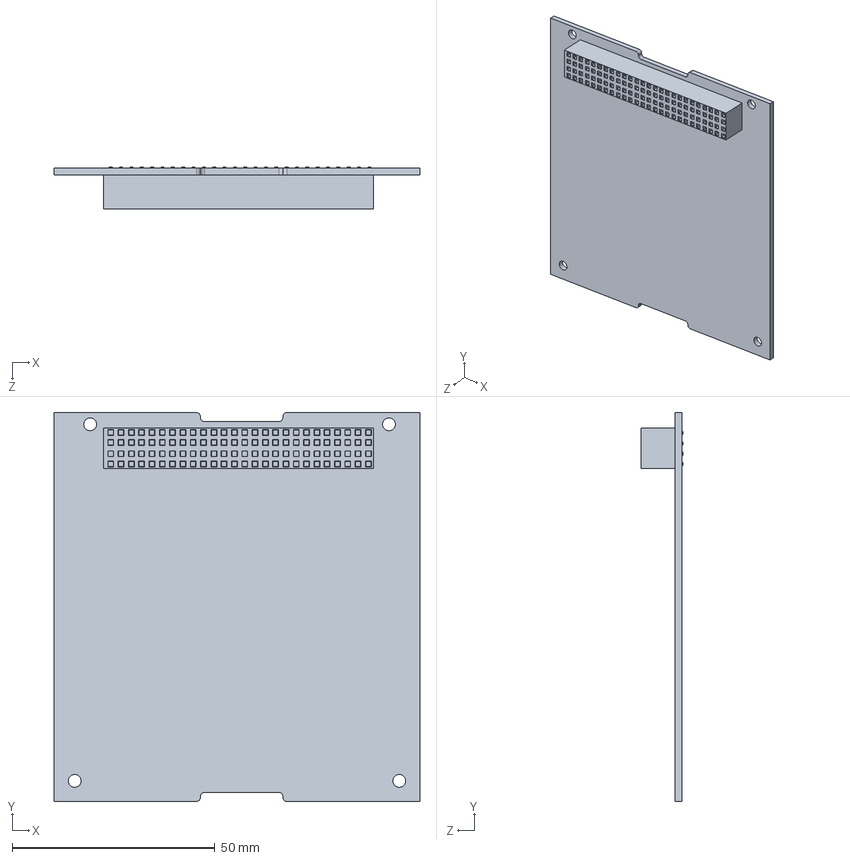
[picture p255: CAD file, 2014-04-27]
Structure (STR)/CAD Models/Secondary Spacecraft Central Processing Board.SLDPRT
90.2 x 95.9 x 10.5 mm
