RascalSeniorDesign/Preliminary-Design/Structure (STR)/CAD Models/Side Panel 2 with notch V 2.1.SLDPRT

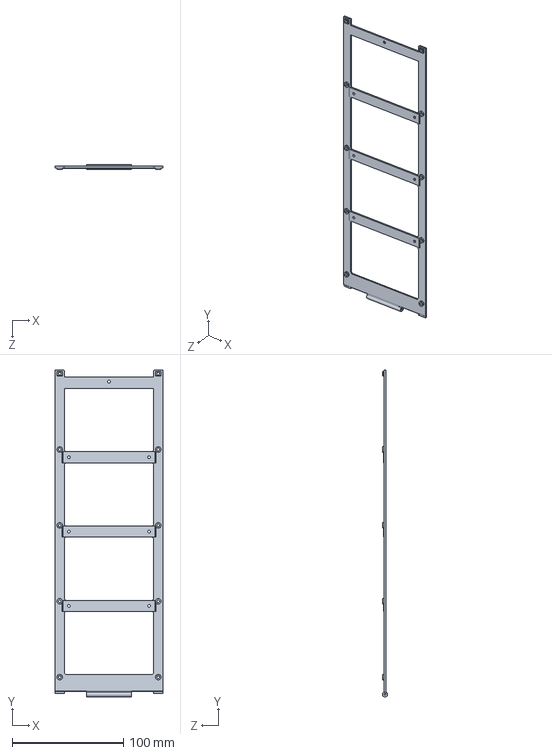
[picture p256: CAD file, 2014-04-27]
Structure (STR)/CAD Models/Side Panel 2 with notch V 2.1.SLDPRT
96.8 x 293.5 x 4.80 mm
