RascalSeniorDesign/Preliminary-Design/(list of files, cad)

Other CAD files:
Structure (STR)/CAD Models/Microswitch Side Panel 1 with feet V 2.1.SLDPRT
Structure (STR)/CAD Models/Other Foot Piece.SLDPRT
Structure (STR)/CAD Models/Battery Pack Interface Component.SLDPRT
Structure (STR)/CAD Models/Standard Unpopulated Solar Panel.SLDPRT
