RascalSeniorDesign/Preliminary-Design/CMQA/Presentations/Concept of Operations.pptx

## Concept of Operations
