RascalSeniorDesign/Preliminary-Design/Attitude Determination and Control (ADC)/MatLab_Files/Plots/TotalDeltaV_Range_StepSize10000.tif

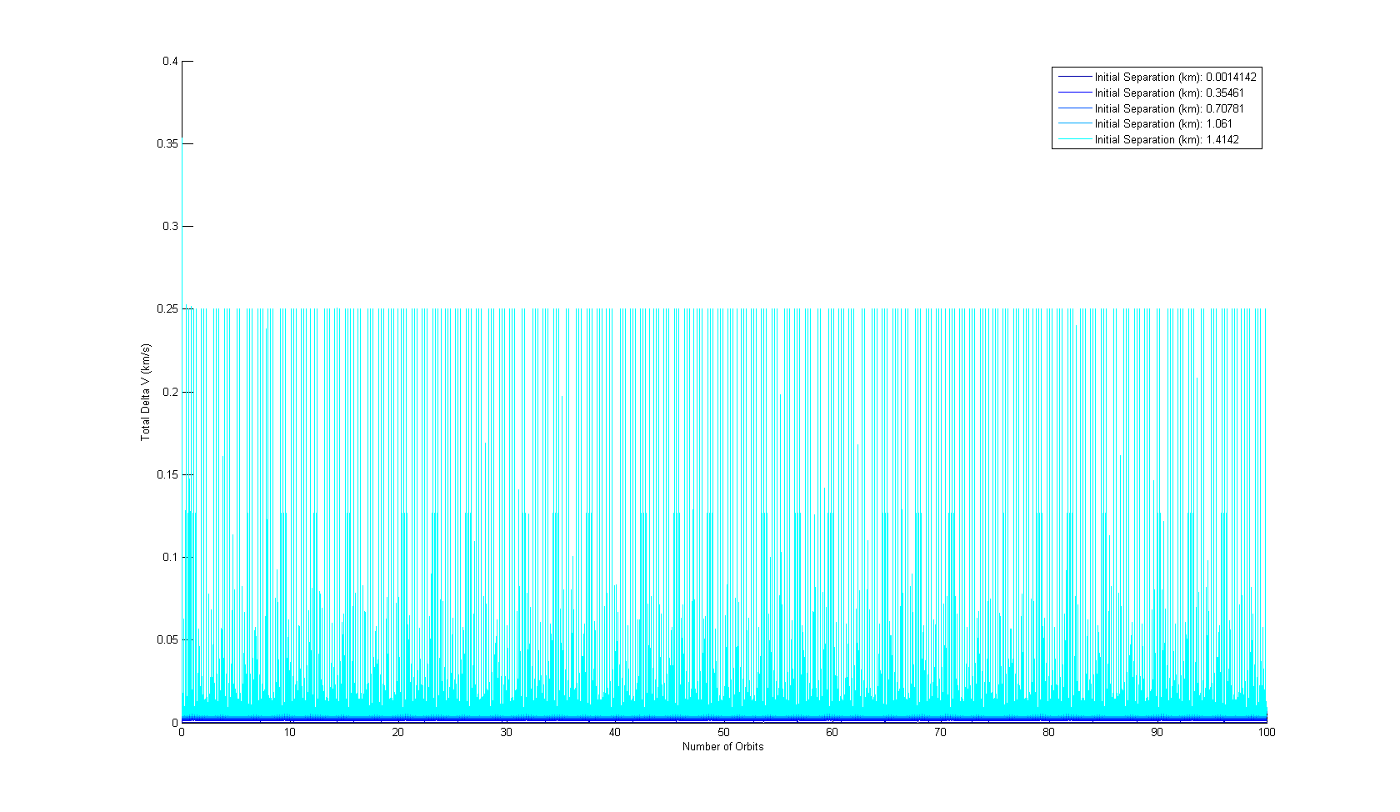
Attitude Determination and Control (ADC)/MatLab_Files/Plots/TotalDeltaV_Range_StepSize10000.tif
