RascalSeniorDesign/Preliminary-Design/Attitude Determination and Control (ADC)/MatLab_Files/Plots/TotalDeltaV_Range_StepSize10000_MaxDis100m.tif

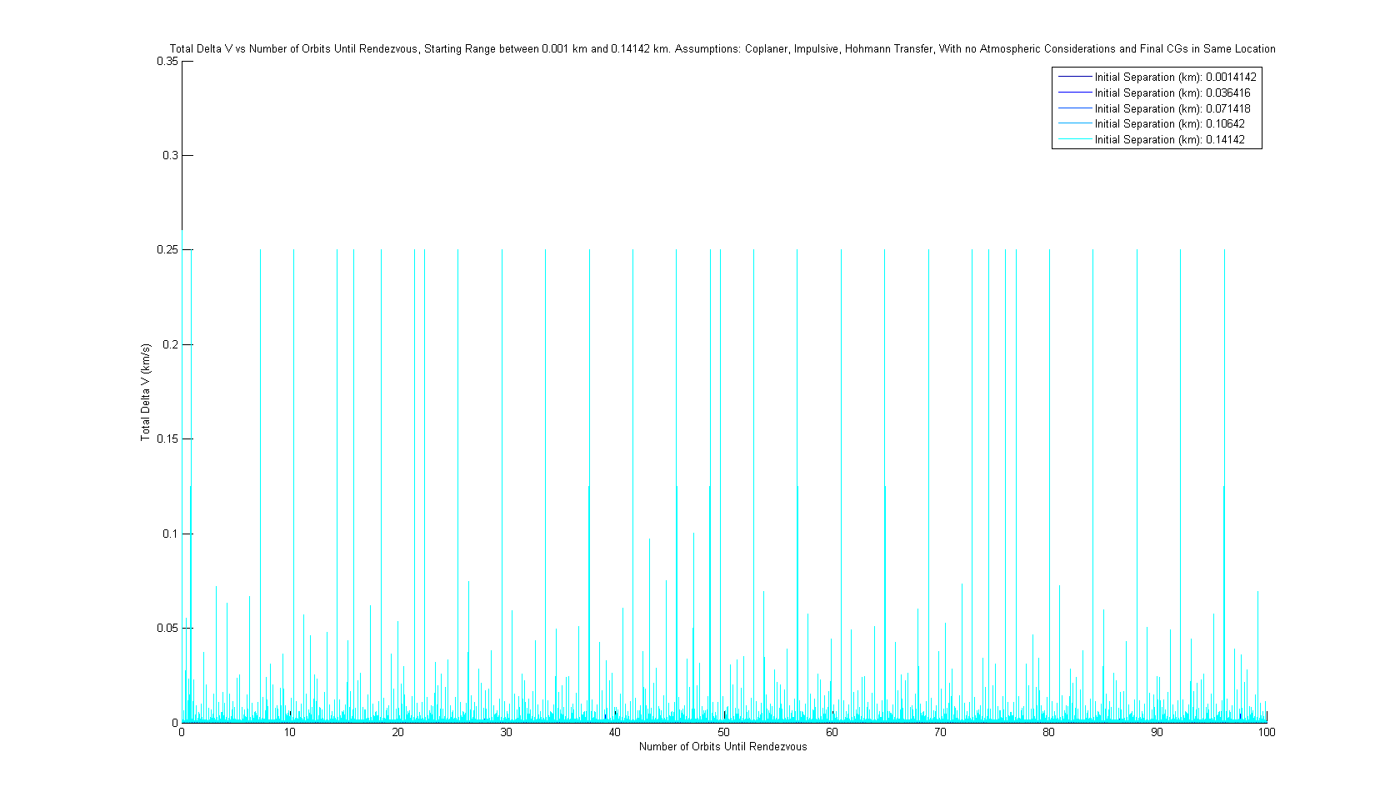
Attitude Determination and Control (ADC)/MatLab_Files/Plots/TotalDeltaV_Range_StepSize10000_MaxDis100m.tif
