RascalSeniorDesign/Preliminary-Design/Structure (STR)/CAD Models/Rendered Files/Secondary Spacecraft Full Assembly.tif

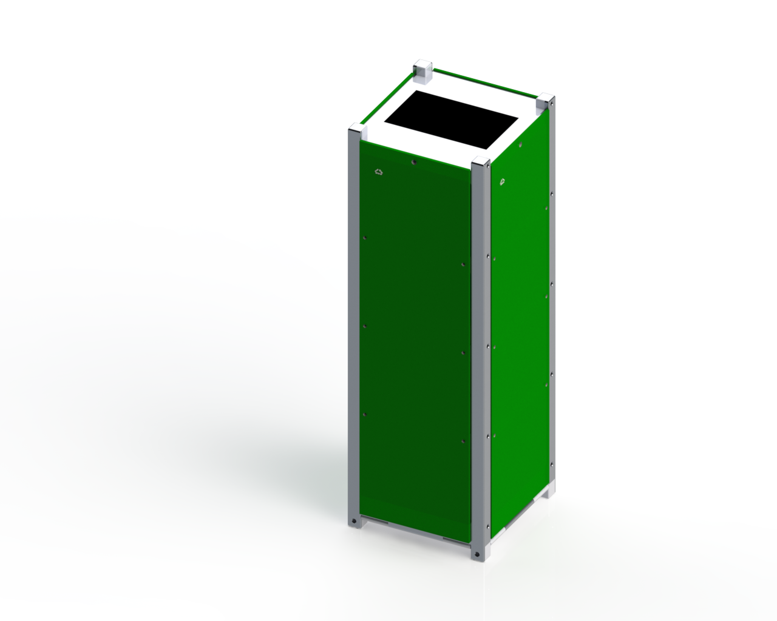
Structure (STR)/CAD Models/Rendered Files/Secondary Spacecraft Full Assembly.tif
