RascalSeniorDesign/Preliminary-Design/CMQA/Requirements Verification Matrix/Bryant Summaries/Bryant RVM.docx

The Y component of the CubeSat structure shall have a length of 100 mm.

This requirement comes from the need to fit in the deployer. This can be verified prior to integration.

The X component of the CubeSat structure shall have a length of 200 mm.

This requirement comes from the need to fit in the deployer. This can be verified prior to integration.

The Z component of the CubeSat structure shall have a length of 300 mm.

This requirement comes from the need to fit in the deployer. This can be verified prior to integration.

The feet protruding from the CubeSat must have an area of 6.5mm X6.5mm.

This requirement comes from the CVS document. This can be verified prior to integration.

The payload shall be capable of determining relative distance between two spacecraft.

This requirement comes from the need to determine the relative distance between the two spacecraft as they separate for navigation purposes. The payload must be able to measure this distance. This requirement will be satisfied by demonstrating this capability prior to integration into the launch vehicle.

CubeSat system shall be capable of recording relative displacement data.

This requirement comes from RCL-PLD-RVM1 as a way to store the data received. This will be satisfied by demonstrating this capability prior to integration into the launch vehicle.

Low friction, 2D testing of the CubeSat system release mechanism shall be conducted.

This requirement comes from the need of the spacecraft to separate to conduct its mission. This can be verified by the constructed FRED system. (Frictionally Reduced Environment Dynamics)

Pressure Vessels shall have a factor of safely no less than 4.

This requirement comes from the document of CubeSat design specification Rev12 2.1.4.1. This can be verified by calculations of the pressure of the pressure vessel.

Low friction, 2D dynamic thrust testing shall be conducted on the propulsion system.

This requirement comes from the need of the spacecraft to use propulsion to complete its mission. This can be verified by the constructed FRED system. (Frictionally Reduced Environment Dynamics)

CubeSat system shall not broadcast in RF until ejection +45 minutes.

This requirement comes from the launch service provider document. This can be verified by the day in the life test performed before integration.

CubeSat system shall not release deployables until ejection +45 minutes.

This requirement comes from the launch service provider document. This can be verified by the day in the life test performed before integration.
