RascalSeniorDesign/Preliminary-Design/CMQA/Requirements Verification Matrix/RCL-RVM-CMQA1 Rascal Requirements Verification Matrix.xls

Sheet: Read Me
Document Title | RCL-RVM-CMQA1 Rascal Requirements Verification Matrix
Document Author | Tom Moline
Approved By | Nate Richard
Revision | -
Last Edit Date | 2013-11-04
Nomenclature
Shorthand | Long-form
I&T | Integration and Testing
PD | Preliminary Design
On-Orbit | On Orbit Requirements
GS | Ground Station
LSP | Launch Service Provider
SS | Separation & Stabilization
PLE | Post-Launch Ejection
SK | Stationkeeping
ESC | “Escape” Maneuver
RDZ | Rendezvous
PLD | Payload
ADC | Attitude Determination and Control
SSRL | Space Systems Research Laboratory
MOP | Mission Operations
STR | Structures
PRP | Propulsion
TST | Testing
RFP | Request for Proposal

Sheet: RVM
Mission Phase | Subsystem | Requirement | Relevant Document | Verification Method |  |  |  | Verification Artifact | Task Number
 |  |  |  | Test | Analysis | Demo | Examine
Stage 1: Pre-Mission Preliminary Design/Integration and Testing
I&T | Structures | The total CubeSat system volume shall not exceed 6U | Team Bravo RFP |  |  |  | x |  | RCL.PL.STR1
I&T | Structures | The total CubeSat system mass shall not exceed 8.0 kg | CubeSat Design Specification Rev 12 |  |  |  | x |  | RCL.PL.STR2
PD | Structures | All materials used in the CubeSat system shall have a Total Mass Loss of less than 1.0% (List of Low Out-gassing Materials available at outgassing.nasa.gov) | CubeSat Design Specification Rev 12 |  | x |  |  |  | RCL.PL.STR3
PD | Structures | All materials used in the CubeSat system shall have a Collected Volatile Condensable material of less than 0.1% | CubeSat Design Specification Rev 12 |  | x |  |  |  | RCL.PL.STR4
PD | Mission Operations | CubeSat system must be in orbit for at least 6 months | Team Bravo RFP |  | x |  |  |  | RCL.PL.MOP1
PD | Mission Operations | CubeSat system must deorbit within 25 years of being launched | Process for Limiting Orbital Debris (NASA-STD-8719.14A) |  | x |  |  |  | RCL.PL.MOP2
I&T | Structures | CubeSat system shall be conjoined before launch vehicle integration | Team Bravo RFP |  |  | x |  |  | RCL.PL.STR5
I&T | Structures | The CubeSat system shall incorporate a Remove Before Flight pin | CubeSat Design Specification Rev 12 |  |  |  | x |  | RCL.PL.STR6
I&T | Structures | The CubeSat system shall incorporate a deployment switch | CubeSat Design Specification Rev 12 |  |  |  | x |  | RCL.PL.STR7
I&T | Structures | No Protrusion shall extend beyond 6.5 mm normal to any external surface | CubeSat Design Specification Rev 12 |  |  |  | x |  | RCL.PL.STR8
I&T | Structures | No external components other than the CubeSat rails may make contact with the deployer | CubeSat Design Specification Rev 12 |  |  |  | x |  | RCL.PL.STR9
I&T | Structures | The deployer shall not be used to secure any CubeSat deployables | CubeSat Design Specification Rev 12 |  |  | x |  |  | RCL.PL.STR10
I&T | Structures | Center of gravity total CubeSat system shall be located within a sphere of 2 cm of the geometric center of the system | CubeSat Design Specification Rev 12 |  | x |  |  |  | RCL.PL.STR11
I&T | Structures | Center of gravity of each CubeSat system Jade and Turquoise shall be located within a sphere of 2 cm of the geometric center of said system | Attitude Determination and Control Requirement |  | x |  |  |  | RCL.PL.STR12
PD | Structures | The CubeSat system coordinate system shall be defined as specified in Figure 1 | CubeSat Design Specification Rev 12 |  | x |  |  |  | RCL.PL.STR13
PD | Structures | Jade and Turquoise's coordinate system shall be defined as specified in Figure 1 | CubeSat Design Specification Rev 12 |  | x |  |  |  | RCL.PL.STR14
I&T | Structures | The ends of the rails on the +Z/-Z faces shall have a minimum surface area of 6.5 mm x 6.5 mm | CubeSat Design Specification Rev 12 |  |  |  | x |  | RCL.PL.STR15
I&T | Structures | The +Y/-Y Faces of the CubeSat system shall have a length of 100 mm | CubeSat Design Specification Rev 12 |  |  |  | x |  | RCL.PL.STR16
I&T | Structures | The +X/-X Faces of the CubeSat system shall have a length of 200 mm | CubeSat Design Specification Rev 12 |  |  |  | x |  | RCL.PL.STR17
I&T | Structures | The height of the CubeSat system structure shall be 300 mm | CubeSat Design Specification Rev 12 |  |  |  | x |  | RCL.PL.STR18
PD | Payload | The payload shall be capable of determining relative distance between Jade and Turquoise | Team Bravo RFP |  |  | x |  |  | RCL.PL.PLD1
PD | Payload | CubeSat system shall be capable of recording relative displacement data between Jade and Turquoise | Team Bravo RFP | x |  |  |  |  | RCL.PL.PLD2
I&T | Structures | Low friction, 2D testing of the CubeSat system release mechanism shall be conducted | Environmental Testing Requirements | x |  |  |  |  | RCL.PL.STR19
PD | Propulsion | Pressure Vessels shall have a factor of safely no less than 4 | CubeSat Design Specification Rev 12 |  | x |  |  |  | RCL.PL.PRP1
PD | Thermal | All CubeSat components shall be rated to withstand a temperature range of at least -20 ⁰C to 70 ⁰C | Team Bravo RFP |  | x |  |  |  | RCL.PL.THM1
I&T | Propulsion | Static Thrust testing will be performed with the flight pressure vessel prior to CubeSat integration at a pressure no greater than 1x10^-4 Torr | Environmental Testing Requirements | x |  |  |  |  | RCL.PL.PRP2
I&T | Propulsion | The pressure vessel must pass thermal cycle testing between temperatures of -30 ⁰C and 70 ⁰C for a total of two cycles or 10 hours | Environmental Testing Requirements | x |  |  |  |  | RCL.PL.PRP3
I&T | Propulsion | Low friction, 2D dynamic thrust testing shall be conducted on the propulsion system | Environmental Testing Requirements | x |  |  |  |  | RCL.PL.PRP4
I&T | Testing | CubeSat must survive Random Vibration Testing relative to the NASA GEVS Qualification Profile (Shown in Figure 2) | General Environmental Verification Standard for GSFC Flight Programs and Projects (GSFC-STD-7000A) | x |  |  |  |  | RCL.PL.TST1
I&T | Testing | CubeSat shall be subjected to a temperature of 60 ⁰C at a pressure of 1x10^-4 Torr for at least 6 hours | Past ELaNa CubeSat-P-POD ICD's | x |  |  |  |  | RCL.PL.TST2
I&T | Testing | Full CubeSat System shall be able to execute all commands associated with its operation over RF | Environmental Testing Requirements | x |  |  |  |  | RCL.PL.TST3
I&T | Testing | Full CubeSat System shall be able to close a link with the SSRL Ground Station from a distance of at least 200 meters | Environmental Testing Requirements | x |  |  |  |  | RCL.PL.TST4
I&T | Testing | Full CubeSat System shall be able to document the functionality of each subsystem through the running of a full-functional test | Environmental Testing Requirements | x |  |  |  |  | RCL.PL.TST5
Stage 2: Post-launch Ejection
On-Orbit | PLE | CubeSat system shall not broadcast in RF until ejection +45 minutes | LSP Requirement |  |  | x |  |  | RCL.PLE.MOP1
On-Orbit | PLE | CubeSat system shall not release deployables until ejection +45 minutes | LSP Requirement |  |  | x |  |  | RCL.PLE.MOP2
On-Orbit | PLE | CubeSat shall establish communication link between itself and SSRL ground station | SSRL Requirement |  |  | x |  |  | RCL.PLE.MOP3
On-Orbit | PLE | CubeSat shall pass a health check initiated by SSRL | SSRL Requirement |  |  | x |  |  | RCL.PLE.MOP4
Stage 3: Separation & Stabilization
On-Orbit | SS | Jader and Turquoise separating from one another with a relative velocity no greater than 5 cm/s | MATLAB Orbital Analysis |  | x |  |  |  | RCL.SS.MOP1
On-Orbit | SS | Jade and Turquoise shall achieve a local slew rate of less than 1 deg/s | Reference Material (NAV Folder) |  | x |  |  |  | RCL.SS.MOP2
On-Orbit | SS | Jade and Turquoise shall record relative displacement between each other | SSRL Requirement |  | x |  |  |  | RCL.SS.MOP3
Stage 4: StationKeeping
On-Orbit | SK | Jade and Turquoise shall be able to stationkeep within a 10-75 m sphere for at least 5 orbits relative to the other CubeSat system | Team Bravo RFP |  | x |  |  |  | RCL.SK.MOP1
Stage 5: “Escape”
On-Orbit | ESC | Jade and Turquoise shall be able to perform an “escape” maneuver that increases the final relative displacement from the other CubeSat system to at least 100 meters within 1 orbit | Team Bravo RFP |  | x |  |  |  | RCL.ESC.MOP1
Stage 6: Rendezvous
On-Orbit | RDZ | Jade and Turquoise shall be able to a rendezvous by decreasing the final relative distance from the other CubeSat system to within 50 m for 5 orbits | Team Bravo RFP |  | x |  |  |  | RCL.RDZ.MOP1

Sheet: RVM Rev 1
Verification Mission Stage | Requirement | Verification Method(s) |  |  |  | Rationale | Verification Artifact | Status | Task Number Taxonomy
 |  | Test | Analysis | Demo | Examine
Top Level Requirements
PD/I&T | The spacecraft must be capable of demonstrating station keeping within a 50 meter sphere of a resident space object for at least 5 orbits |  |  |  |  | RFP Requirement |  | NOT VERIFIED | RCL-RFP1
PD/I&T | The spacecraft must be capable of demonstrating an "Escape" maneuver by intentionally increasing the relative distance between it and a relative space object to at lest 100 meters within one orbit |  |  |  |  | RFP Requirement |  | NOT VERIFIED | RCL-RFP2
PD/I&T | The spacecraft shall be capable of demonstrating rendezvous with by intentionally reducing the distance between it and a resident space object to at most 50 meters for at least 5 orbits |  |  |  |  | RFP Requirement |  | NOT VERIFIED | RCL-RFP3
PD/I&T | A method of verifying the successful completion of each mission requirement shall be incorporated into the spacecraft design and mission operations procedures |  |  |  |  | Mission Operations Requirement |  | NOT VERIFIED | RCL-MOP1
PD/I&T | The spacecraft mission shall be executed within 6 months of spacecraft launch |  |  |  |  | Mission Operations Requirement |  | NOT VERIFIED | RCL-MOP2
Top Level Sub-Requirements
PD | The spacecraft must be capable of determining relative distance between it and a resident space object |  |  |  |  |  |  | NOT VERIFIED | RCL-MOP1-1
PD | The spacecraft must be capable of recording relative distance between it and a resident space object |  |  |  |  |  |  | NOT VERIFIED | RCL-MOP1-2
PD | The spacecraft must be capable of relaying relative distance between it and a resident space object to the ground |  |  |  |  |  |  | NOT VERIFIED | RCL-MOP1-3
PD | The spacecraft will utilize a Structures Subsystem |  |  |  |  |  |  | NOT VERIFIED | RCL-STR
PD | The spacecraft will utilize a Propulsion Subsystem |  |  |  |  |  |  | NOT VERIFIED | RCL-RFP-PRP
PD | The spacecraft will utilize a Power Subsystem |  |  |  |  |  |  | NOT VERIFIED | RCL-MOP2-PWR
Mission Operations Sub-Requirements
PD | The spacecraft will utilize an Attitude Determination and Control Subsystem |  |  |  |  |  |  | NOT VERIFIED | RCL-MOP1-ADC
PD | The spacecraft will utilize a Command and Data Handling Subsystem |  |  |  |  |  |  | NOT VERIFIED | RCL-MOP1-CDH
PD | The spacecraft will utilize a Communications Subsystem |  |  |  |  |  |  | NOT VERIFIED | RCL-MOP1-COM
Structures Requirements
PD | The spacecraft will utilize the CubeSat standard architecture |  |  |  |  |  |  | NOT VERIFIED | RCL-STR-1
PD | The mission will consist of two identical spacecraft |  |  |  |  |  |  | NOT VERIFIED | RCL-STR-2
PD | The two spacecraft must be able to integrate into the same dispenser |  |  |  |  |  |  | NOT VERIFIED | RCL-STR-3
PD | The two spacecraft will be conjoined for integration into dispenser |  |  |  |  |  |  | NOT VERIFIED | RCL-STR-4
PD | The two spacecraft will be capable of separating in orbit |  |  |  |  |  |  | NOT VERIFIED | RCL-STR-5
Power Requirements
PD | The power subsystem will utilize an Electrical Power System to manager power distribution to each subsystem of the spacecraft |  |  |  |  |  |  | NOT VERIFIED | RCL-MOP2-PWR1
PD | The power subsystem will utilize a rechargeable battery to store power for each subsystem of the spacecraft |  |  |  |  |  |  | NOT VERIFIED | RCL-MOP2-PWR2
PD | The power subsystem will utilize solar panels to generate a sufficient amount of power to compensate for the energy consumption of each subsystem of the spacecraft |  |  |  |  |  |  | NOT VERIFIED | RCL-MOP2-PWR3
PD | A power budget will be created to ensure a net positive power margin per orbit |  |  |  |  |  |  | NOT VERIFIED | RCL-MOP2-PWR4
Attitude Determination and Control Requirements
PD | The ADC subsystem will be capable of autonomously commanding the propulsion system to perform the orbital maneuvers associated with the RFP requirements |  |  |  |  |  |  | NOT VERIFIED | RCL-MOP1-ADC1
Propulsion Requirements
PD | The propulsion subsystem will be capable of executing orbital maneuvers issued to it from the ADC subsystem |  |  |  |  |  |  | NOT VERIFIED | RCL-RFP-PRP1
Communications Requirements
PD | The communication subsystem will utilize a radio for transmitting data to the ground |  |  |  |  |  |  | NOT VERIFIED | RCL-MOP1-COM1
PD | A link budget will be created that ensures that the power level, frequency, and altitudes over which the spacecraft transmits data are sufficient to produce a signal to noise ratio great enough to maintain a continuous link while over a ground station |  |  |  |  |  |  | NOT VERIFIED | RCL-MOP1-COM2
Command and Data Handling Requirements
PD | The Command and Data Handling subsystem will be capable of managing the operation of each subsystem of the spacecraft, as well as the communication of data between said subsystems |  |  |  |  |  |  | NOT VERIFIED | RCL-MOP1-CDH

Sheet: Figure 1-Coordinate System
Figure 1- CubeSat Coordinate System

Sheet: Figure 2- NASA Gevs
Figure 2- NASA GEVS Random Vibration Profile
