RascalSeniorDesign/Preliminary-Design/CMQA/Requirements Verification Matrix/RCL-RVM-CMQA1 Rascal Requirements Verification Matrix (Internal Use Only).xls

Sheet: Read Me
Document Title | RCL-RVM-CMQA1 Rascal Requirements Verification Matrix
Document Author | Tom Moline
Approved By | Nate Richard
Revision | -
Last Edit Date | 2013-11-04
Nomenclature
Shorthand | Long-form
I&T | Integration and Testing
PD | Preliminary Design
On-Orbit | On Orbit Requirements
GS | Ground Station
LSP | Launch Service Provider
SS | Separation & Stabilization
PLE | Post-Launch Ejection
SK | Stationkeeping
ESC | “Escape” Maneuver
RDZ | Rendezvous
PLD | Payload
ADC | Attitude Determination and Control
SSRL | Space Systems Research Laboratory
MOP | Mission Operations
STR | Structures
PRP | Propulsion
TST | Testing
RFP | Request for Proposal

Sheet: Both Active
Mission Phase | Subsystem | Requirement | Relevant Document | Verification Method |  |  |  | Verification Artifact | Task Number
 |  |  |  | Test | Analysis | Demo | Examine
Stage 1: Pre-Mission Preliminary Design/Integration and Testing
I&T | Structures | The total CubeSat volume shall not exceed 6U | Team Bravo RFP |  |  |  | x |  | RCL-STR-RVM1
I&T | Structures | The total CubeSat mass shall not exceed 8.0 kg | CubeSat Design Specification Rev 12 |  |  |  | x |  | RCL-STR-RVM2
PD | Structures | All materials used in the CubeSat shall have a Total Mass Loss of less than 1.0% (List of Low Out-gassing Materials available at outgassing.nasa.gov) | CubeSat Design Specification Rev 12 |  | x |  |  |  | RCL-STR-RVM3
PD | Structures | All materials used in the CubeSat shall have a Collected Volatile Condensable material of less than 0.1% | CubeSat Design Specification Rev 12 |  | x |  |  |  | RCL-STR-RVM4
I&T | Structures | CubeSat system shall be conjoined before launch vehicle integration | Team Bravo RFP |  |  | x |  |  | RCL-STR-RVM5
I&T | Structures | The CubeSat shall incorporate a Remove Before Flight pin | CubeSat Design Specification Rev 12 |  |  |  | x |  | RCL-STR-RVM6
I&T | Structures | The CubeSat shall incorporate a deployment switch | CubeSat Design Specification Rev 12 |  |  |  | x |  | RCL-STR-RVM7
I&T | Structures | No Protrusion shall extend beyond 6.5 mm normal to any external surface | CubeSat Design Specification Rev 12 |  |  |  | x |  | RCL-STR-RVM8
I&T | Structures | No external components other than the CubeSat rails may make contact with the deployer | CubeSat Design Specification Rev 12 |  |  |  | x |  | RCL-STR-RVM9
I&T | Structures | The deployer shall not be used to secure any CubeSat deployables | CubeSat Design Specification Rev 12 |  |  | x |  |  | RCL-STR-RVM10
I&T | Structures | Center of gravity shall be located within a sphere of 2 cm of the geometric center | CubeSat Design Specification Rev 12 |  | x |  |  |  | RCL-STR-RVM11
PD | Structures | The CubeSat coordinate system shall be defined as specified in Figure 1 | CubeSat Design Specification Rev 12 |  | x |  |  |  | RCL-STR-RVM12
I&T | Structures | The ends of the rails on the +Z/-Z faces shall have a minimum surface area of 6.5 mm x 6.5 mm | CubeSat Design Specification Rev 12 |  |  |  | x |  | RCL-STR-RVM13
I&T | Structures | The +Y/-Y Faces of any CubeSat structure shall have a length of 100 mm | CubeSat Design Specification Rev 12 |  |  |  | x |  | RCL-STR-RVM14
I&T | Structures | Low friction, 2D testing of the CubeSat system release mechanism shall be conducted | Environmental Testing Requirements | x |  |  |  |  | RCL-STR-RVM15
PD | Propulsion | Pressure Vessels shall have a factor of safely no less than 4 | CubeSat Design Specification Rev 12 |  | x |  |  |  | RCL-PRP-RVM1
I&T | Propulsion | Static Thrust testing will be performed with the flight pressure vessel at a pressure no greater than 1x10^-4 Torr prior to CubeSat integration | Environmental Testing Requirements | x |  |  |  |  | RCL-PRP-RVM2
I&T | Propulsion | The pressure vessel must pass thermal cycle testing between temperatures of -30 ⁰C and 70 ⁰C for a total of two cycles or 10 hours | Environmental Testing Requirements | x |  |  |  |  | RCL-PRP-RVM3
I&T | Propulsion | Low friction, 2D dynamic thrust testing shall be conducted on the propulsion system | Environmental Testing Requirements | x |  |  |  |  | RCL-PRP-RVM4
PD | Mission Operations | CubeSat must be in orbit for at least 6 months | Team Bravo RFP |  | x |  |  |  | RCL-MOP-RVM1
PD | Mission Operations | CubeSat must deorbit within 25 years of being launched | Process for Limiting Orbital Debris (NASA-STD-8719.14A) |  | x |  |  |  | RCL-MOP-RVM2
I&T | Testing | CubeSat must survive Random Vibration Testing relative to the NASA GEVS Qualification Profile (Shown in Figure 2) | General Environmental Verification Standard for GSFC Flight Programs and Projects (GSFC-STD-7000A) | x |  |  |  |  | RCL-TST-RVM1
I&T | Testing | CubeSat shall be subjected to a temperature of 60 ⁰C at a pressure of 1x10^-4 Torr for at least 6 hours | Past ELaNa CubeSat-P-POD ICD's | x |  |  |  |  | RCL-TST-RVM2
I&T | Testing | Full CubeSat System shall be able to execute all commands associated with its operation over RF | Environmental Testing Requirements | x |  |  |  |  | RCL-TST-RVM3
I&T | Testing | Full CubeSat System shall be able to close a link with the SSRL Ground Station from a distance of at least 200 meters | Environmental Testing Requirements | x |  |  |  |  | RCL-TST-RVM4
I&T | Testing | Full CubeSat System shall be able to document the functionality of each subsystem through the running of a full-functional test | Environmental Testing Requirements | x |  |  |  |  | RCL-TST-RVM5
PD | PLD | The payload shall be capable of determining relative distance between two spacecraft | Team Bravo RFP |  |  | x |  |  | RCL-PLD-RVM1
PD | PLD | CubeSat system shall be capable of recording relative displacement data | Team Bravo RFP | x |  |  |  |  | RCL-PLD-RVM2
PD | Thermal | All CubeSat components shall be rated to withstand a temperature range of at least -20 ⁰C to 70 ⁰C | Team Bravo RFP |  | x |  |  |  | RCL-THM-RVM1
Stage 2: Post-launch Ejection
On-Orbit | PLE | CubeSat system shall not broadcast in RF until ejection +45 minutes | LSP Requirement |  |  | x |  |  | RCL-PLE-RVM1
On-Orbit | PLE | CubeSat system shall not release deployables until ejection +45 minutes | LSP Requirement |  |  | x |  |  | RCL-PLE-RVM2
On-Orbit | PLE | CubeSat shall establish communication link between itself and SSRL ground station | SSRL Requirement |  |  | x |  |  | RCL-PLE-RVM3
On-Orbit | PLE | CubeSat shall pass a health check initiated by SSRL | SSRL Requirement |  |  | x |  |  | RCL-PLE-RVM4
Stage 3: Separation & Stabilization
On-Orbit | SS | CubeSat system shall be capable of separating from one another with a relative velocity no greater than 5 cm/s | MATLAB Orbital Analysis |  | x |  |  |  | RCL-SS-RVM1
On-Orbit | SS | Individual CubeSat system shall be able to stabilize roll rate about each of the primary axes to less than 1 deg/s | Need Rationale |  | x |  |  |  | RCL-SS-RVM2
On-Orbit | SS | Individual CubeSat systems shall record relative displacement between each other | SSRL Requirement |  | x |  |  |  | RCL-SS-RVM3
Stage 4: StationKeeping
On-Orbit | SK | Individual CubeSat System shall be able to stationkeep within a 10-75 m sphere for at least 5 orbits relative to the other CubeSat system | Team Bravo RFP |  | x |  |  |  | RCL-SK-RVM1
Stage 5: “Escape”
On-Orbit | ESC | Individual CubeSat System shall be able to perform an “escape” maneuver that increases the final relative displacement from the other CubeSat system to at least 100 meters within 1 orbit | Team Bravo RFP |  | x |  |  |  | RCL-ESC-RVM1
Stage 6: Rendezvous
On-Orbit | RDZ | Individual CubeSat System shall be able to a rendezvous by decreasing the final relative distance from the other CubeSat system to within 50 m for 5 orbits | Team Bravo RFP |  | x |  |  |  | RCL-RDZ-RVM1

Sheet: Figure 1-Coordinate System
Figure 1- CubeSat Coordinate System

Sheet: Figure 2- NASA Gevs
Figure 2- NASA GEVS Random Vibration Profile
