RascalSeniorDesign/Preliminary-Design/CMQA/Requirements Verification Matrix/Nate Summaries/Nate Summaries.docx

Document Format

RCL.STR.RVM1 Title Here

Description Here

RCL.STR.RVM2 Title Here

Description Here

RCL.STR.RVM3 Title Here

Description Here

RCL.STR.RVM4 Title Here

Description Here

RCL.STR.RVM5 Title Here

Description Here

RCL.STR.RVM6 Title Here

Description Here

RCL.STR.RVM7 Title Here

Description Here

RCL.STR.RVM8 Title Here

Description Here
