RascalSeniorDesign/Preliminary-Design/CMQA/Requirements Verification Matrix/RCL-RVM-CMQA3 Rascal Requirements Verification Matrix.xlsx

Sheet: Read Me
Document Title | RCL-RVM-CMQA1 Rascal Requirements Verification Matrix
Document Author | Tom Moline
Approved By | Nate Richard
Revision | -
Last Edit Date | 2013-11-04
Nomenclature
Shorthand | Long-form
I&T | Integration and Testing
PD | Preliminary Design
On-Orbit | On Orbit Requirements
GS | Ground Station
LSP | Launch Service Provider
SS | Separation & Stabilization
PLE | Post-Launch Ejection
SK | Stationkeeping
ESC | “Escape” Maneuver
RDZ | Rendezvous
PLD | Payload
ADC | Attitude Determination and Control
SSRL | Space Systems Research Laboratory
MOP | Mission Operations
STR | Structures
PRP | Propulsion
TST | Testing
RFP | Request for Proposal

Sheet: Revision History
Revision | Release Date | Brief Revision Comment | Author | Approval
- | 2014-03-28 | Initial Release | TAM | NJR

Sheet: README
RCL-RVM-CMQA2 Secondary Spacecraft Requirements Verification Matrix Overview
This document provides the requirements that the design selected by the Rascal Secondary Spacecraft Design team must satisfy in order to successfully execute the Rascal mission, as defined in the Rascal Mission Overview document. Each requirement listed in the RVM2 tab of this document relates to requirements imposed by the Launch Service Provider (LSP), Space Systems Research Lab (SSRL), or the Boeing's Advanced Space & Intelligence Systems (AS&IS) lab.
Document Organization
This document is organized in such a manner that Top-Level requirements (such as mission sizing and lifetime constraints) are listed at the top of the matrix, with all other requirements (such as power and separation constraints) being derived from these top level requirements. The distinction between each level of requirements is indicated by the task number associated with each requirement. A top level requirement, for example, would have a task number of RCL2-RVM1, while a sub-requirement of said requirement would have a number of RCL2-RVM1-1, and so on. Each requirement also has one or more verification methods associated with verifying that it is met. These methods consist of Analysis (CAD Analysis, mathematical calculations, etc), Test (Vibration, Functional, Thermal Testing), Demo (Antenna Deployment, Propulsive Measurements, etc.), and Exmine (Measurements, visual inspecton, etc).

Sheet: RVM2
Requirement | Verification Method(s) |  |  |  | Requirement Driver | Requirement Number
 | Test | Analysis | Demo | Examine
Top Level Requirements
The SSRL shall provide a payload that will be used to demonstrate Rendezvous and Proximity Operations (RPO) and Space Situational Awareness (SSA) mission capabilities. | x | x | x | x | AS&IS | RCL-RVM1
RVM1 Sub-Requirements
The primary spacecraft payload shall resolve relative position and attitude data between the secondary and primary spacecraft over a range of 0-100 meters, with a maximum goal of 2000 meters. | x | x | x |  | AS&IS | RCL-RVM1-1
RVM1-1 Sub-Requirements
The primary spacecraft shall utilize a vision system for the resolution of relative spacecraft position and attitude data. |  |  |  | x | AS&IS | RCL-RVM1-1-1
The primary spacecraft payload shall provide navigation solutions for the position and attitude data produced by the payload vision system and Colony-II guidance, navigation, and control (GNC) system. | x | x | x |  | AS&IS | RCL-RVM1-1-2
RVM1 Sub-Requirements (Continued)
The primary spacecraft payload shall include a propulsion system for executing the RPO maneuvers outlined in the RCL-O-CMQA3 Concept of Operations document. |  |  |  | x | SSRL | RCL-RVM1-2
RVM1-2 Sub-Requirements
The primary spacecraft propulsion unit shall provide 3 Degrees of Freedom motion, as defined by the primary axes of its local coordinate frame. | x | x | x |  | SSRL | RCL-RVM1-2-1
The primary spacecraft propulsion unit shall utilize cold-gas for all thrusting. |  |  |  | x | AS&IS | RCL-RVM1-2-2
The primary spacecraft propulsion unit shall provide a total ΔV capability of 50 m/s, with a goal of 100 m/s | x | x | x |  | SSRL | RCL-RVM1-2-3
The total volume of the primary spacecraft propulsion system shall not exceed 0.5U's (10x10x5cm) |  |  |  | x | SSRL | RCL-RVM1-2-4
The total mass of the primary spacecraft propulsion system shall be no more than 75% of the payload mass, with a goal of 50%. |  |  |  | x | SSRL | RCL-RVM1-2-5
Top Level Requirements (Continued)
The payload that is provided by the SSRL shall be integrated into Boeing's Colony-II bus. Together, these are designated as the Primary Spacecraft. |  |  | x | x | AS&IS | RCL-RVM2
RVM2 Sub-Requirements
The primary spacecraft payload shall conform to the CubeSat Design Specifications Rev 12 |  |  | x | x | AS&IS | RCL-RVM2-1
The total volume of the primary spacecraft payload shall be no greater than 1.5U's (10x10x15cm) |  |  |  | x | AS&IS | RCL-RVM2-2
The total mass of the primary spacecraft payload shall be no greater than 3 kg. |  |  |  | x | AS&IS | RCL-RVM2-3
The average power draw of the primary spacecraft payload shall be no greater than 10 Watts (W). | x | x |  |  | AS&IS | RCL-RVM2-4
The peak power draw of the primary spacecraft payload shall not exceed 30 W. | x | x |  |  | AS&IS | RCL-RVM2-5
The primary spacecraft payload will utilize the RS422 protocol for data communication between it and the Colony-II bus. |  |  | x |  | AS&IS | RCL-RVM2-6
Top Level Requirements (Continued)
The SSRL shall provide a target resident space object (RSO) that will be used as the target object for RPO and SSA mission capabilities. This RSO will be given the designation of the Secondary Spacecraft. | x | x | x | x | AS&IS | RCL-RVM3
RVM3 Sub-Requirements
The secondary spacecraft shall conform to the 3U CubeSat Design Specification | x | x |  | x | LSP | RCL-RVM3-1
The secondary spacecraft shall be physically conjoined to the primary spacecraft prior to launch vehicle integration. | x | x | x | x | SSRL | RCL-RVM3-2
RVM3-2 Sub-Requirements
Both the secondary and primary spacecraft shall integrate into the same 6U CubeSat Deployer. |  |  | x | x | SSRL | RCL-RVM3-1-1
RVM3 Sub-Requirements (Continud)
The secondary spacecraft shall be physically conjoined to the primary spacecraft during launch. | x | x | x | x | SSRL | RCL-RVM3-3
RVM3-3 Sub-Requirements
The method used to conjoin the secondary and primary spacecraft shall withstand the loads associated with the launch vehicle environment, as specified by the LSP or by the Proto-Qualification NASA GEVS Random Vibration Profile. | x |  |  |  | LSP | RCL-RVM3-2-1
RVM3 Sub-Requirements (Continud)
The secondary spacecraft shall be physically conjoined to the primary spacecraft during launch vehicle separation. | x | x | x | x | SSRL | RCL-RVM3-4
RVM3-4 Sub-Requirements
The secondary and primary spacecraft shall withstand an instantaneous impulsive load associated with at least a 2 m/s change in velocity, with a goal of 3 m/s. | x | x | x |  | SSRL | RCL-RVM3-3-1
RVM3 Sub-Requirements (Continud)
The secondary spacecraft shall be physically conjoined to the primary spacecraft during initial on-orbit operations for at least 1 month, with a goal of two months. | x | x | x | x | SSRL | RCL-RVM3-5
The secondary spacecraft shall physically separate from the primary spacecraft upon command from the ground. |  |  | x | x | SSRL | RCL-RVM3-6
RVM3-6 Sub-Requirements
The secondary and primary spacecraft shall separate with a relative speed no more than 1 m/s, with a goal of 5 cm/s. |  |  | x | x | SSRL | RCL-RVM5-1-1
The secondary shall separate from the primary spacecraft with a local slew rate no more than 10 ⁰/s, with a goal of 1 ⁰/s. |  |  | x | x | SSRL | RCL-RVM5-1-2
RVM3 Sub-Requirements (Continud)
The secondary spacecraft shall remain in a powered off state until separation. |  |  | x |  | SSRL | RCL-RVM3-7
The secondary spacecraft shall provide navigation aids to the primary spacecraft, as specified in the RCL-O-ADC1 ADC Overview document. |  |  | x | x | SSRL | RCL-RVM3-8
Top Level Requirements (Continued)
After separation, the secondary spacecraft shall have an operational life of at least two weeks, with a goal of one month. | x | x | x |  | SSRL | RCL-RVM4
The primary spacecraft shall have an operational life of at least 6 months, with a goal of 3 years. | x | x | x |  | AS&IS | RCL-RVM5
