RascalSeniorDesign/Preliminary-Design/(commit log)

2013-10-01 Excel sheet documenting cost benefit analysis of four cars. Car B won
    [Car_Selection.xlsx]
2013-10-09 Function for determining delta V to go from 100 m to 10 m relative distance, currently wrote summary of code purpose
2013-10-15 Updated code to work with correct relative velocity inputs
2013-10-21 Script used to calculate terminal velocity vectors for given transfer orbit between two points in a given time
2013-10-21 Script that plots orbits of each satellite given initial relatvie displacement and velocity vectors
2013-10-27 Can now plot relative velocity and displacement over any number of orbits one could desire
2013-11-05 Template for Rascal RVM
    [RCL-RVM-CMQA1 Rascal Requirements Verification Matrix.xlsx]
2013-11-05 Added readme section
    [RCL-RVM-CMQA1 Rascal Requirements Verification Matrix.xlsx]
2013-11-05 Deleted first RVM requirement
    [RCL-RVM-CMQA1 Rascal Requirements Verification Matrix.xlsx]
2013-11-05 Addeds structures requirments
    [RCL-RVM-CMQA1 Rascal Requirements Verification Matrix.xlsx]
2013-11-05 Preliminary version of pre-launch requirements
    [RCL-RVM-CMQA1 Rascal Requirements Verification Matrix.xlsx]
2013-11-05 Added propulsion requirements in Stage 1
    [RCL-RVM-CMQA1 Rascal Requirements Verification Matrix.xlsx]
2013-11-06 Added more propulsion requirements and separation requirement. Fixed some of Tom's spelling mistakes
    [RCL-RVM-CMQA1 Rascal Requirements Verification Matrix.xls]
2013-11-06 Added payload requirements
    [RCL-RVM-CMQA1 Rascal Requirements Verification Matrix.xls]
2013-11-07 Added Separation and Stabilization
    [RCL-RVM-CMQA1 Rascal Requirements Verification Matrix.xls]
2013-11-07 Added Stationkeeping, escape, and rendezvous
    Added Stationkeeping, escape, and rendezvous
    as well as conjoined
    [RCL-RVM-CMQA1 Rascal Requirements Verification Matrix.xls]
2013-11-07 Added Stage 3 and 4
    Post-launch ejection, Separation & Stabilization, Primary mission
    [RCL-RVM-CMQA1 Rascal Requirements Verification Matrix.xls]
2013-11-07 Clarification
    Clarified some of the stages
    [RCL-RVM-CMQA1 Rascal Requirements Verification Matrix.xls]
2013-11-07 Added more nomenclature and more primary mission
    Broke the primary mission into its components
    [RCL-RVM-CMQA1 Rascal Requirements Verification Matrix.xls]
2013-11-07 Added relevant documents for a few requirements
    [RCL-RVM-CMQA1 Rascal Requirements Verification Matrix.xls]
2013-11-07 Clarified some points in stage 1
    [RCL-RVM-CMQA1 Rascal Requirements Verification Matrix.xls]
2013-11-08 Added some priority
    [RCL-RVM-CMQA1 Rascal Requirements Verification Matrix.xls]
2013-11-09 Re-ordered volatile materials requirements
    [RCL-RVM-CMQA1 Rascal Requirements Verification Matrix.xls]
2013-11-09 Converted Nates Janky Excel Format
    [RCL-RVM-CMQA1 Rascal Requirements Verification Matrix.xlsx]
2013-11-09 Added Reference Material for Navigation
2013-11-09 Justified slew rate of 1 deg/sec, as noted in NAV folder reference material
    [RCL-RVM-CMQA1 Rascal Requirements Verification Matrix.xlsx]
2013-11-09 Final Version, Mark I
    [RCL-RVM-CMQA1 Rascal Requirements Verification Matrix.xlsx]
2013-11-09 Updated version with work assignment in place
    [RCL-RVM-CMQA1 Rascal Requirements Verification Matrix.xlsx]
2013-11-09 Template for RV Document, almost complete with Stage 1
2013-11-09 Stage One Requirement Headings are now included
2013-11-09 Finished Stage 2 Headings
2013-11-09 Finished Stage 3 Headings
2013-11-10 Added format for the summaries that will work me
    Cause Tom sucks
    [RCL-RVM-CMQA1 Rascal Requirements Verification Matrix.xlsx]
2013-11-10 Inserted Tylers summaries, which are now under review
2013-11-10 Added requirement RCL.ESC.MOP1
2013-11-10 Added requirement stages intro paragraph
2013-11-10 Removed extra powerpoint
2013-11-10 5 cm/s relative displacement plot
2013-11-10 Relative displacement in all three axes for 5 cm/s separation
2013-11-10 Added figure for 10 cm-s initial separation
2013-11-10 Relative position for 10 cm-s initial separation,all three axes
2013-11-10 Plots for 15 cm/s initial separation
2013-11-10 Initial separation of 20 cm/s
2013-11-10 Graphs for initial 25 cm/s separation
2013-11-10 Graphs for 30 cm/s initial velocity
2013-11-10 Graphs for 40 cm/s initial separation
2013-11-11 Added powerpoint in .pptx format
2013-11-11 Deleted right powerpoint this time
2013-11-12 Bryants power point slides
2013-11-12 Slide template for toms power point
2013-11-12 Requirements now have correct notation
    [RCL-RVM-CMQA1 Rascal Requirements Verification Matrix.xlsx]
2013-11-30 Began creating top level RVM requirements and new task number syntax
    [RCL-RVM-CMQA1 Rascal Requirements Verification Matrix.xlsx]
2013-12-01 Added requirements for RFP and launch vehicle
    [RCL-RVM-CMQA1 Rascal Requirements Verification Matrix.xlsx]
2013-12-01 Added two mission operation requirements
    [RCL-RVM-CMQA1 Rascal Requirements Verification Matrix.xlsx]
2013-12-01 Added launch integration requirement
    [RCL-RVM-CMQA1 Rascal Requirements Verification Matrix.xlsx]
2013-12-01 Added spacecraft descriptions to data section
    [RCL-0-CMQA1 Rascal Mission Configuration Trade Study Martix.xlsx]
2013-12-01 Changed charts to plot relative to mission success and whether or not the spacecraft system started conjoined
    [RCL-0-CMQA1 Rascal Mission Configuration Trade Study Martix.xlsx]
2013-12-02 Added start of Link Budget
    HANDSIES!!!!
    [RCL-B-COM1.xls]
2013-12-02 Need to Calculate Signal to Noise Ratio Yet
    Tire HANDS!
    [RCL-B-COM1.xls]
2013-12-02 Altered Formula for Signal to Noise Ratio a bit
    Tired HANDS this time
    [RCL-B-COM1.xls]
2013-12-02 Preliminary Power Generation Budget
    [RCL-B-PWR1 Power Generation Budget.xlsx]
2013-12-02 Changed top level requirements to reflect RFP requirements
    [RCL-RVM-CMQA1 Rascal Requirements Verification Matrix.xlsx]
2013-12-03 Added mission requirement sub-requirements for calculating, recording, and sending relative distance data
    [RCL-RVM-CMQA1 Rascal Requirements Verification Matrix.xlsx]
2013-12-03 Added ADC reuqirmement as well as Propulsion and Power subsystems
    [RCL-RVM-CMQA1 Rascal Requirements Verification Matrix.xlsx]
2013-12-03 Added Power Requirements and reorganized structures requirements
    [RCL-RVM-CMQA1 Rascal Requirements Verification Matrix.xlsx]
2013-12-03 Added requirements for each subsystem
    [RCL-RVM-CMQA1 Rascal Requirements Verification Matrix.xlsx]
2013-12-03 Began creating end of semester power point. Have mission definitions
2013-12-03 power slides
2013-12-03 Changing out powerpoints
    Changing Hands!
2013-12-03 Added updated powerpoint
    New Hands!
2013-12-03 Added a powerpoint Nate could use on his computer
    Nate's HANDS!
2013-12-03 Updated Nate's useable powerpoint
2013-12-07 Added all section headings and updated table of contents. Also inserted RVM and formatted it to fit the pages
2013-12-07 Documents describing the launch costs associated with CubeSat and microsat missions. Cubesats are 50000 dollars, MicroSats are 10 million.
2013-12-07 Mass Budget
    [RASCAL Mass Budget.xlsx, RCL-RVM-CMQA1 Rascal Requirements Verification Matrix.xls]
2013-12-07 Renamed the RVM Nate can use to Internal Use Only
    [RCL-RVM-CMQA1 Rascal Requirements Verification Matrix (Internal Use Only).xls, RCL-RVM-CMQA1 Rascal Requirements Verification Matrix.xls]
2013-12-07 Power Requirements and Subsystem Description Sections
2013-12-08 Excel sheet showing the difference in satellite types that have been launched since 2010. All indicators show that one is much more likely to get a launch with a CubeSat than with a microsat.
    [RCl-A-STR1 Satellite Architecture Comparison.xlsx]
2013-12-08 Added formatting to graphs, ready for integration into master document
    [RCl-A-STR1 Satellite Architecture Comparison.xlsx]
2013-12-08 Added pie chart comparisons
    [RCl-A-STR1 Satellite Architecture Comparison.xlsx]
2013-12-08 ADC Subsystem Description initial commit
2013-12-08 Added section describing currently available CubeSat deployers to sectoin 5.2.1.1
2013-12-09 Changed previous mission chart sto that it plots weight vs cost. Also added aerocube 4 and DRAGONsat to plot
    [RCL-0-CMQA1 Rascal Mission Configuration Trade Study Martix.xlsx]
2013-12-09 Added Power Subsystem description
2013-12-10 Moved a doc off my desktop
    [AMSAT-IARU_Link_Budget_Rev2.4.1.xls]
2013-12-10 Images for 50 cm-s initial separation. To be used in mission overview.
2013-12-10 Started com subsystem overview
    [RCL-RVM-CMQA1 Rascal Requirements Verification Matrix.xls]
2013-12-10 Added propellant study in Sectoin 5.2.2.1
2013-12-10 Added 25 m-s and 50 m-s cases
    [RCL-A-PRP1 DeltaV to Mass Ratio Comparisons.xlsx]
2013-12-10 Started ground ops section
2013-12-10 Finished ground ops
2013-12-10 Added ADC requirements
2014-01-28 Added reference material for rendezvous optimization
2014-01-28 Added description of different ADC systems
2014-01-28 Added Virginia Tech ADC description
2014-01-28 Paper on various ADC sensors
2014-01-31 Created function called lambertSolver that is capable of defining the velocity vectors at two given points that form the ellipse associated with teh time it takes to pass between said points. Slightl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
2014-01-31 Finished and completley working. Now need to make a function that plots the orbit with the position and velocity vectors defined by lambertSolver, as well as refine a linear orbit algorithm for produ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
2014-01-31 Updated revision history and comments relaying false information
2014-01-31 Actual Com budget
    Keeping the other one for posterity
    [RCL-B-COM1.xlsx]
2014-02-01 Created keplarSolver program that finds the final position and velocity in an orbit provided some inital position and velocity and an amount of time to pass. About to begin debugging
2014-02-01 Added a function called hitEarthChecker. It takes in positon and velocity vectors, as well as the semi-major axis of the transfer orbit, and determines the perigee radius of the orbit and determines 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
2014-02-03 Updated with known SENSE configuration
    This is my best guess at their power generation without more info on
    how they wire their panels
    [RCL-B-PWR1 Power Generation Budget.xlsx]
2014-02-05 Added example budget
    [RCL-B-COM1.xlsx, Table 16-13. FSS Link Budget, Forward Direction.xlsx]
2014-02-05 A non-imaginary link budget
    Will have to talk to swart to see if my assumptions are good or not.
    [RCL-B-COM1.xlsx]
2014-02-05 Just some prettying up of the com budget
    [RCL-B-COM1.xlsx]
2014-02-05 More precise speed of light
    [RCL-B-COM1.xlsx]
2014-02-05 More precise boltzmann constant
    [RCL-B-COM1.xlsx]
2014-02-06 Moved COM budget to COM folder
    [RCL-B-COM1.xlsx]
2014-02-06 Moved power generation budget to power folder
    [RCL-B-PWR1 Power Generation Budget.xlsx]
2014-02-06 Moved IARU reference material to COM folder
    [AMSAT-IARU_Link_Budget_Rev2.4.1.xls]
2014-02-06 Moved mass budget to structures folder
    [RASCAL Mass Budget.xlsx]
2014-02-06 Moved COM reference material to COM folder
    [Table 16-13. FSS Link Budget, Forward Direction.xlsx]
2014-02-06 Moved senior design assignment to CMQA
    [Car_Selection.xlsx]
2014-02-07 Different noise figure, maybe more based in reality
    [RCL-B-COM1.xlsx]
2014-02-07 Just some tweaks to get our budget more like IARU
    [AMSAT-IARU_Link_Budget_Rev2.4.1.xls, RCL-B-COM1.xlsx]
2014-02-07 Making it more user friendly
    [RCL-B-COM1.xlsx]
2014-02-07 Made borders better
    [RCL-B-COM1.xlsx]
2014-02-08 Created function for converting betwee earth centric inetial fram and cw frame centered on a target spacecraft. All commented up and ready for testing
2014-02-08 Improvements made to UHF Uplink
    [AMSAT-IARU_Link_Budget_Rev2.4.1.xls, RCL-B-COM1.xlsx]
2014-02-11 UHF Link Budget done except for BER
    BER= bit error rate
    [RCL-B-COM1.xlsx]
2014-02-11 Finished S-Band Link Budget I think
    Have to check if there are any loss differences between UHF and S-Band
    [AMSAT-IARU_Link_Budget_Rev2.4.1.xls, RCL-B-COM1.xlsx]
2014-02-11 Added initial formula for BER, need to find out Q
    [RCL-B-COM1.xlsx]
2014-02-11 Made some tweaks to it to reflect our spacecraft
    [AMSAT-IARU_Link_Budget_Rev2.4.1.xls]
2014-02-12 Adjusted the bit error rate formula
    Might be more right
    [RCL-B-COM1.xlsx]
2014-02-12 The right BER formula finally
    Thanks Swartwout!
    [RCL-B-COM1.xlsx]
2014-02-14 Clarified Losses
    [RCL-B-COM1.xlsx]
2014-02-15 More clarifications
    [AMSAT-IARU_Link_Budget_Rev2.4.1.xls, RCL-B-COM1.xlsx]
2014-02-17 A few tweaks
    [RCL-B-COM1.xlsx]
2014-02-18 Found the minimum angle needed for s-band
    this is the angle needed to close the link
    [AMSAT-IARU_Link_Budget_Rev2.4.1.xls, RCL-B-COM1.xlsx]
2014-02-20 Power point for fixed design presentation. Currently at constraints.
2014-02-20 Looked at altitude of 300 km and 5 deg elevation
    [AMSAT-IARU_Link_Budget_Rev2.4.1.xls, RCL-B-COM1.xlsx]
2014-02-20 Rascal Power Diagrams
2014-02-20 power diagrams take 2
2014-02-20 I don't know what i changed
    [RCL-B-COM1.xlsx]
2014-02-20 Began process of writing extended abstract. Currently defining mission terms in intro
2014-02-20 power section
2014-03-03 Many files relating to the use of prussings CW analysis for calculating delta V required for orbital maneuvers. All code is currently functional, but needs to be commented. Good night.
2014-03-04 Dummy Spacecraft Power Budget First Pass
2014-03-04 changed name in defense of endermen
    [RCL-B-PWR1 Power Generation Budget.xlsx]
2014-03-04 Created Inter-Satellite Link Budget
    [AMSAT-IARU_Link_Budget_Rev2.4.1.xls, RCL-B-COM1.xlsx, RCL-B-COM2.xlsx]
2014-03-04 Maximum Planned Distance
    [RCL-B-COM2.xlsx]
2014-03-04 Added beginning of doc describing ISL budget
    [AMSAT-IARU_Link_Budget_Rev2.4.1.xls, RCL-B-COM2.xlsx]
2014-03-04 Just adding a few more tidbits of info
    [RCL-B-COM1.xlsx, RCL-B-COM2.xlsx]
2014-03-04 Overview Done, needs prettying up
    [RCL-B-COM1.xlsx, RCL-B-COM2.xlsx]
2014-03-04 Fixed a conversion fuck up
    [RCL-B-COM2.xlsx]
2014-03-04 Fixed a brain fart
    [RCL-B-COM2.xlsx]
2014-03-04 Distance numbers & antenna improvements
    [RCL-B-COM1.xlsx, RCL-B-COM2.xlsx]
2014-03-05 First pass at CONOPS case 2
2014-03-05 No Docking Case
2014-03-05 Completed at least a preliminary discussion of calculatoins for each maneuver case
2014-03-10 Corrected GS transmit pwoer
    [RCL-B-COM1.xlsx]
2014-03-11 Start of cost analysis
    [Cost Analysis.xlsx]
2014-03-11 Some number for cost analysis
    [Cost Analysis.xlsx]
2014-03-12 More numbers, waiting on quotes for 2 things
    [Cost Analysis.xlsx]
2014-03-12 small updates
    [Thursdays 830 to 1030 Grades.xlsx]
2014-03-12 Added possible antenna price
    [Cost Analysis.xlsx]
2014-03-13 Everything seems to be working, script now prints out baseleline values for ideal mission. Now going to introduce errors
2014-03-14 Velocity pertubation plots for ISK
2014-03-14 Completed code for plotting and stating changes in deltaV associated with varying initial realtive positions and velocities for ISK
2014-03-18 Slightly updated cost, waiting on 2 quotes
    [Cost Analysis.xlsx]
2014-03-18 Target Spacecraft Schematic
2014-03-20 New master gannt chart that is to be used for defining Boeing milestones. Currently have defined overarching categories and a few ADC and PRP requirements.
2014-03-21 Added three case studies for deltaV comparison. One more to go. Then going to add in cost, relevence, and risk comparisons.
2014-03-22 ADC done
2014-03-24 Updated Cost Analysis
    [Cost Analysis.xlsx]
2014-03-26 Added ability of producing a txt file that can be used for STK simulation. Also updated personnel budget for the semester.
    [RCL-B-CMQA1 Spring 2014 Rascal Personnel Budget.xlsx]
2014-03-27 Added Trevor, Alec, and Adam to the mix
    [RCL-B-CMQA1 Spring 2014 Rascal Personnel Budget.xlsx]
2014-03-27 Updated for most recent additions
    [RCL-B-CMQA1 Spring 2014 Rascal Personnel Budget.xlsx]
2014-03-28 RVM for secondary spacecraft
    [RCL-RVM-CMQA2 Secondary Spacecraft Requirements Verification Matrix.xlsx]
2014-03-28 Added another high level requirement
    [RCL-RVM-CMQA2 Secondary Spacecraft Requirements Verification Matrix.xlsx]
2014-03-29 Added a top-level requirement, revision history, and readme.
    [RCL-RVM-CMQA2 Secondary Spacecraft Requirements Verification Matrix.xlsx]
2014-03-29 Formatting and spelling corrections
    [RCL-RVM-CMQA2 Secondary Spacecraft Requirements Verification Matrix.xlsx]
2014-03-30 Removed stupid senior design thing
    [Car_Selection.xlsx]
2014-03-30 Personnel Updates
    [RCL-B-CMQA1 Spring 2014 Rascal Personnel Budget.xlsx]
2014-03-30 Added Javier to list
    [RCL-B-CMQA1 Spring 2014 Rascal Personnel Budget.xlsx]
2014-03-31 updates to power budgets
    [RCL-B-PWR2 Dummy Spacecraft Power Budget.xlsx]
2014-04-01 Made a bunch of changes that swartwout recommended
    [RCL-RVM-CMQA2 Secondary Spacecraft Requirements Verification Matrix.xlsx]
2014-04-02 Changed all mentions of RSO to secondary
    [RCL-RVM-CMQA2 Secondary Spacecraft Requirements Verification Matrix.xlsx]
2014-04-02 Reordered some toplevel requirements and added propulsion requirements
    [RCL-RVM-CMQA2 Secondary Spacecraft Requirements Verification Matrix.xlsx]
2014-04-02 Finished top level sub requirements at the moment
    [RCL-RVM-CMQA2 Secondary Spacecraft Requirements Verification Matrix.xlsx]
2014-04-22 com slides
    [AMSAT-IARU_Link_Budget_Rev2.4.1.xls]
2014-04-22 Data Budget Shenanigans
    [RCL-B-CDH1 Data Budget.xlsx]
2014-04-22 fixed some mistakes
    [RCL-B-CDH1 Data Budget.xlsx]
2014-04-23 Chose numbers that made more sense
    [RCL-B-CDH1 Data Budget.xlsx]
2014-04-23 fixed a mistake and made a chart to move 2 ppt
    [RCL-B-CDH1 Data Budget.xlsx]
2014-04-23 What did i do?
    [RCL-B-CDH1 Data Budget.xlsx]
2014-04-24 Added brief description of separation mechanism. Now working on contact switch
2014-04-24 Added power inhibit scheme.
2014-04-24 Power inhbit scheme
2014-04-26 Tweaked the data budget
    [RCL-B-CDH1 Data Budget.xlsx]
2014-04-27 Whole bunch of CAD files for secondary spacecraft
    [0.5U Battery Pack Component.SLDPRT, 0.5U Battery pack Assembly.SLDASM, 2-Pin 90 Degree Surface Mount Header.SLDPRT, Antenna Connector.SLDPRT, Base Plate V 2.1.SLDPRT, Battery Pack Assembly.SLDASM, Battery Pack Hole Optimization.SLDPRT, Battery Pack Interface Component.SLDPRT]
2014-04-27 Finished the central processing board. Now moving on to external panels
    [3.3V Regulator.SLDPRT]
2014-04-27 Fixed hole layout on bottom of skeleton
2014-04-27 Finiished assembly up until processing board/patch antenna
    [Secondary Spacecraft Assembly.SLDASM, Standard Populated External Panel.SLDASM]
2014-04-27 Added ADC Subystem block
    [ADC Subsystem.SLDPRT]
2014-04-27 Added exploded view and pretty pictures
    [Base Plate V 2.1.SLDPRT, Central Processing Board Assembly.SLDASM, Central Processing Board PCB.SLDPRT, Secondary Spacecraft Assembly.SLDASM, Spacecraft V 2.2.SLDASM]
2014-04-27 data budget done
    [RCL-B-CDH1 Data Budget.xlsx]
2014-04-28 Updated power block diagram
2014-04-29 Added secondary ADC stuff
2014-04-29 Secondary ADC done
2014-04-29 Added Rascal Enviro Torques doc
    [Rascal environmental torques.xlsx]
2014-05-03 Added ground station support
2014-05-07 blah blah blah
    [RCL-RVM-CMQA3 Rascal Requirements Verification Matrix.xlsx]
2014-05-07 Added a bunch of ADC stuff
2014-05-07 Added RVM, about to finish up the rest of the ADC overview
2014-05-08 Hopefully (fingers crossed) all formatting is better
2014-05-08 Finished COM, CDH, MOP, & 2nd ADC
2014-05-08 Power and Propulsion Subsystem Overviews
    Updated and cleaned both documents to be included in senior design
    final paper
2014-05-08 Budget updates
    [AMSAT-IARU_Link_Budget_Rev2.4.1.xls, RCL-B-COM3.xlsx]
2014-05-08 Added & updated link budget & removed unneeded =
    [RCL-B-COM3.xlsx]
2014-05-16 New CAD files for Primary spacecraft separation mechanism
    [Microswitch Side Panel Primary Spacecraft with feet V 2.1.SLDPRT, Solenoid Casing.SLDPRT, Solenoid Pin.SLDPRT, Solenoid Spring.SLDPRT, Unpopulated +Y Panel.SLDPRT]
